Shuaiwen-Cui/ArduinoNode/README.md

# ArduinoNode
DIY an IoT wireless sensor node using Arduino Uno R4 wifi
