Shuaiwen-Cui/ArduinoNode/DOC/docs/HARDWARE/hardware.en.md

# HARDWARE

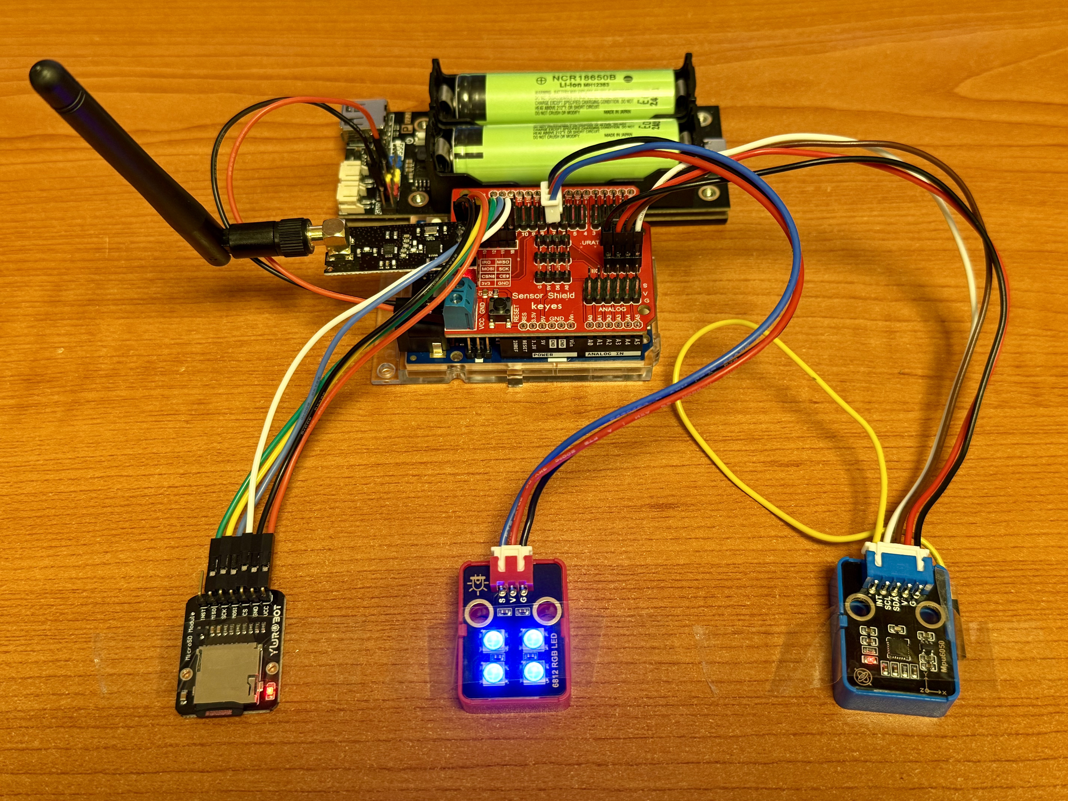
[picture p1: DOC/docs/HARDWARE/node.jpg]


!!! tip "Note"
    To fully implement the wireless sensor network functionality, you may need to purchase multiple sets of the following components to build a network of multiple nodes.

Item List:

| Component | Description | Purchase Link |
| --- | --- | --- |
| Arduino UNO R4 WiFi | Main controller for the node, providing processing power and connectivity. | [Link](https://detail.tmall.com/item.htm?id=738941670744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) |
| Sensor Shield | A shield that connects to the Arduino for easy sensor integration. | [Link](https://detail.tmall.com/item.htm?id=663358716903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) |
| MPU6050 | An acceleration sensor that measures motion and orientation. | [Link](https://detail.tmall.com/item.htm?id=668984438017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) |
| SD Module & Card | Used for data storage, allowing the node to log sensor data. | [Link](https://e.tb.cn/h.hLS57vJVErA9VzJ?tk=TVbk4TGT5v9) |
| RGB LED | Provides visual feedback, indicating the status of the node. | [Link](https://e.tb.cn/h.hLS1rt3BEDluwEL?tk=jOa94TGcqsR) |
| NRF24L01 Module & Antenna | Enables local wireless communication between nodes. |[Link](https://detail.tmall.com/item.htm?id=745189429142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) |
| BMS & Battery | Provides power to the entire node, making it portable. | [Link](https://e.tb.cn/h.7qz72UaRefNhfTZ?tk=zKuiU7YtwBU) / 18650 batteries and charger need to be purchased separately |
| Enclosure | Protects internal electronic components and provides a pretty appearance. | Needs to be designed and 3D printed by yourself |
| Dupont Wires | Used to connect various electronic components. | Please purchase them accordingly through online or offline channels. |

!!! note

    These components together form a fully functional IoT wireless sensor node capable of collecting data, storing information, and communicating wirelessly. Each component plays a crucial role in ensuring the efficient operation and reliability of the node.
!!! tip
    For the main controller Arduino UNO R4 WiFi, if the budget allows, you can choose to buy a kit that includes many expansion accessories to enrich the node's functionality. [Kit Link](https://item.taobao.com/item.htm?id=800925975219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)
