Shuaiwen-Cui/ArduinoNode/DOC/docs/HARDWARE/ENCLOSURE/enclosure.en.md

# ENCLOSURE

This project involves an enclosure that is designed to house various components. The enclosure is constructed from durable materials to ensure longevity and protection for the internal components.

## Enclosure Design

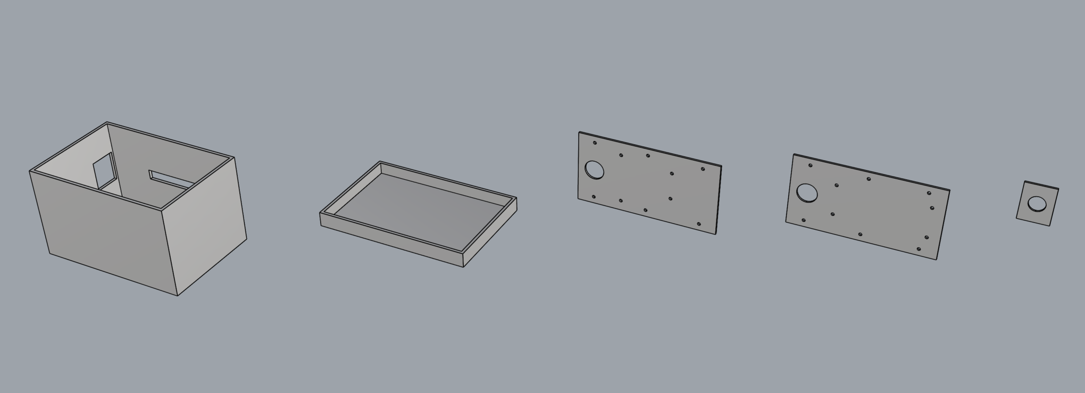
[picture p4: DOC/docs/HARDWARE/ENCLOSURE/enclosure.png]


## Enclosure Images

Top View

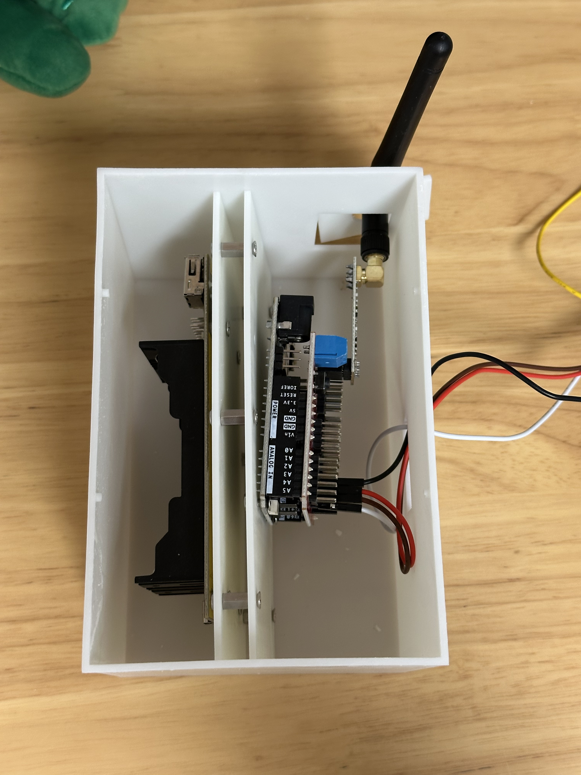
[picture p5: DOC/docs/HARDWARE/ENCLOSURE/topview.jpg]

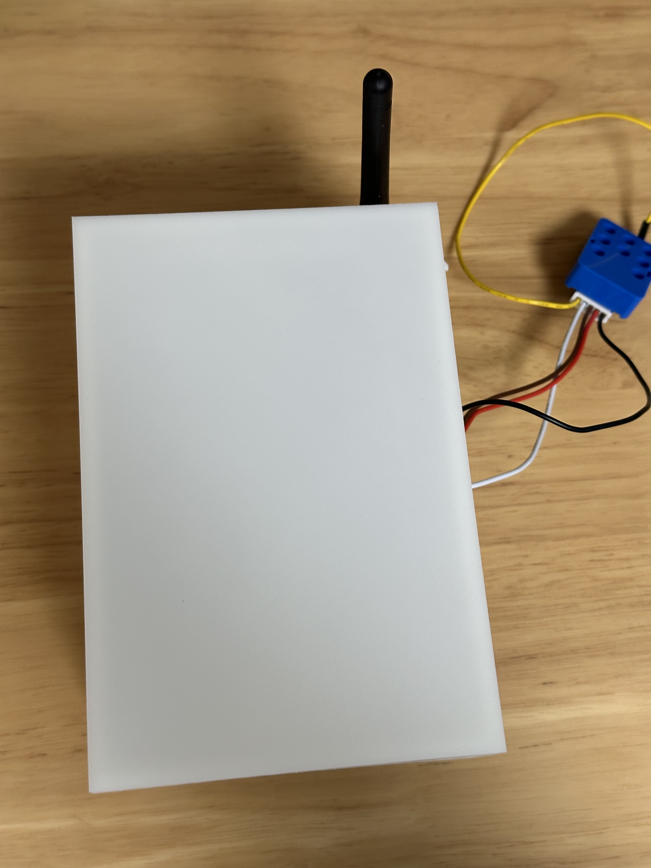
[picture p6: DOC/docs/HARDWARE/ENCLOSURE/ladview.jpg]


Front View
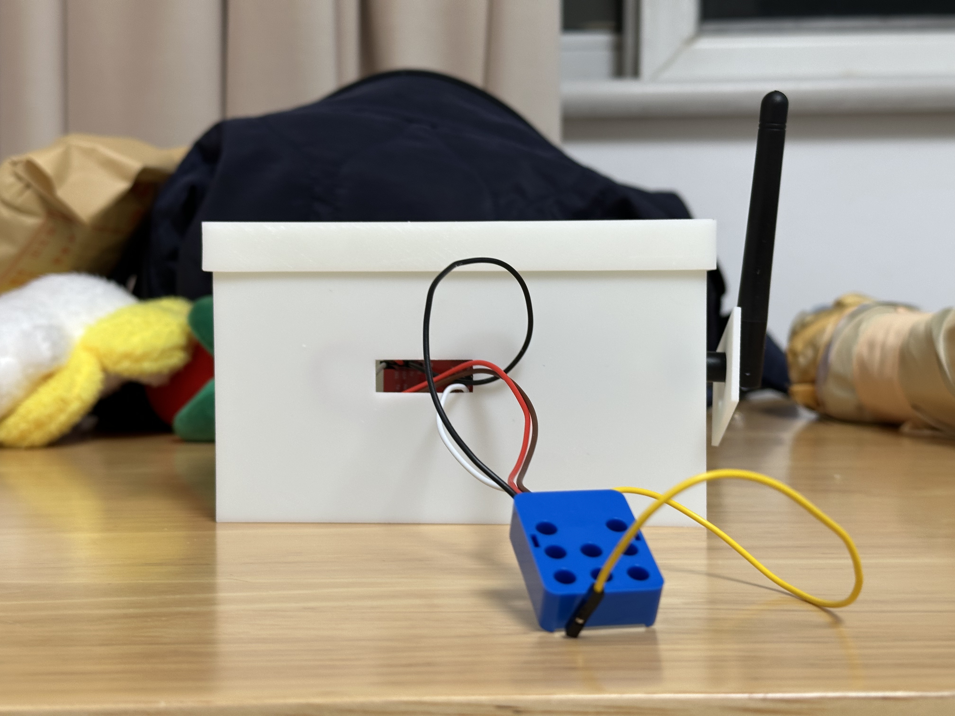
[picture p7: DOC/docs/HARDWARE/ENCLOSURE/frontviewnew.jpg]


Side View
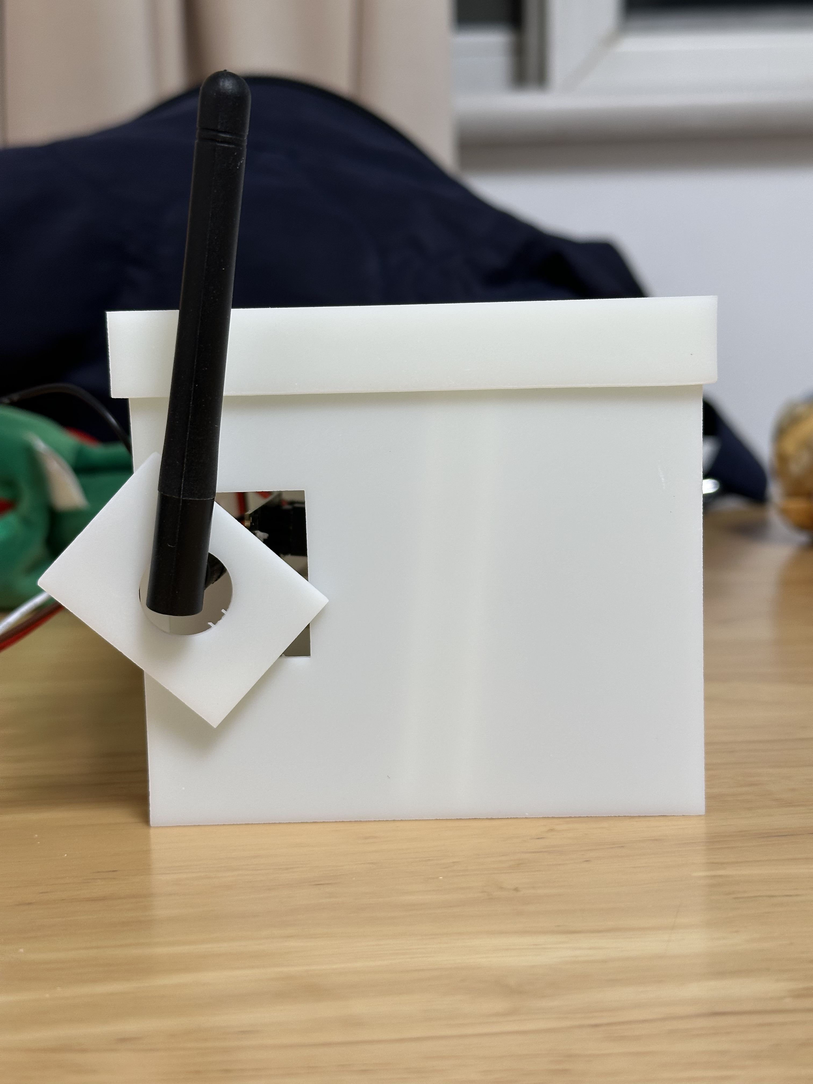
[picture p8: DOC/docs/HARDWARE/ENCLOSURE/sideview-new.jpg]
