Shuaiwen-Cui/ArduinoNode/DOC/docs/HARDWARE/ENCLOSURE/enclosure.zh.md

# 外壳

本项目中设计了一个外壳，用来保护内部的电子元件，并提供一个美观的外观。外壳的设计考虑了散热、易于组装和维护等因素。

## 外壳设计



## 外壳实物图

顶部视图




前视图



侧视图
