Shuaiwen-Cui/ArduinoNode/DOC/docs/HARDWARE/RADIOFREQUENCY/radiofrequency.zh.md

# 射频

RF

射频模块nRF24L01是一个低功耗、低成本的2.4GHz无线收发器，适用于短距离无线通信。它支持多种数据速率和多通道操作，具有较强的抗干扰能力和较长的传输距离。与Wifi相比，射频具有低延迟、低功耗等特点，更适合需要实时数据传输的应用场景。

## 参数

nRF24L01 技术参数

| 参数 | 说明 |
|---|---|
| 工作频率 | 2.4 GHz ISM频段 |
| 通信速率 | 250 kbps / 1 Mbps / 2 Mbps |
| 工作电压 | 1.9V – 3.6V（推荐 3.3V） |
| 通信距离 | 约 10～100 米（取决于天线和环境） |
| 接口协议 | SPI |
| 接收电流 | 约 12.3 mA |
| 发送电流 | 约 11.3 mA（0 dBm输出） |
| 数据包长度 | 1～32 字节 |
| 地址宽度 | 3～5 字节 |
| 特性支持 | 自动应答、自动重发、多通道接收 |

## 接线



| 引脚 | 名称 | 说明 |
|---|---|---|
| 1 | GND  | 地线 |
| 2 | VCC  | 电源（推荐 3.3V，严禁接 5V） |
| 3 | CE | 模式控制引脚（发送/接收切换） |
| 4 | CSN  | SPI片选引脚（低电平有效） |
| 5 | SCK  | SPI时钟输入 |
| 6 | MOSI | SPI主设备输出，从设备输入 |
| 7 | MISO | SPI主设备输入，从设备输出 |
| 8 | IRQ  | 中断引脚（可选） |
