Shuaiwen-Cui/ArduinoNode/DOC/docs/HARDWARE/MCU/mcu.en.md

# MAIN CONTROLLER BOARD

!!! info "Main Controller Board"
    In this project， the main controller board serves two purposes: central control and Wi-Fi communication.

## Main Controller Board Appearance

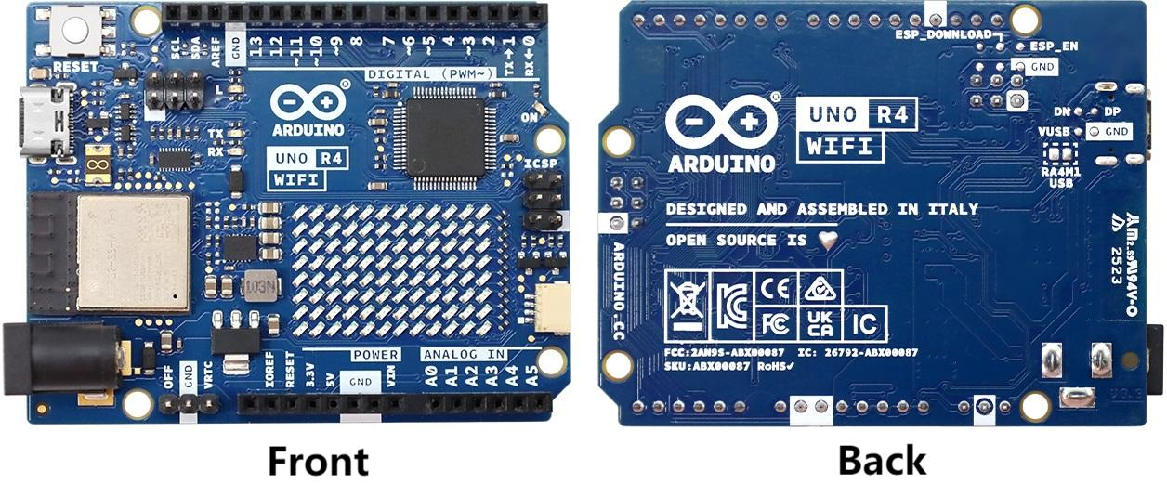
[picture p14: DOC/docs/HARDWARE/MCU/mcu.png]


## Main Controller Board Pin Layout

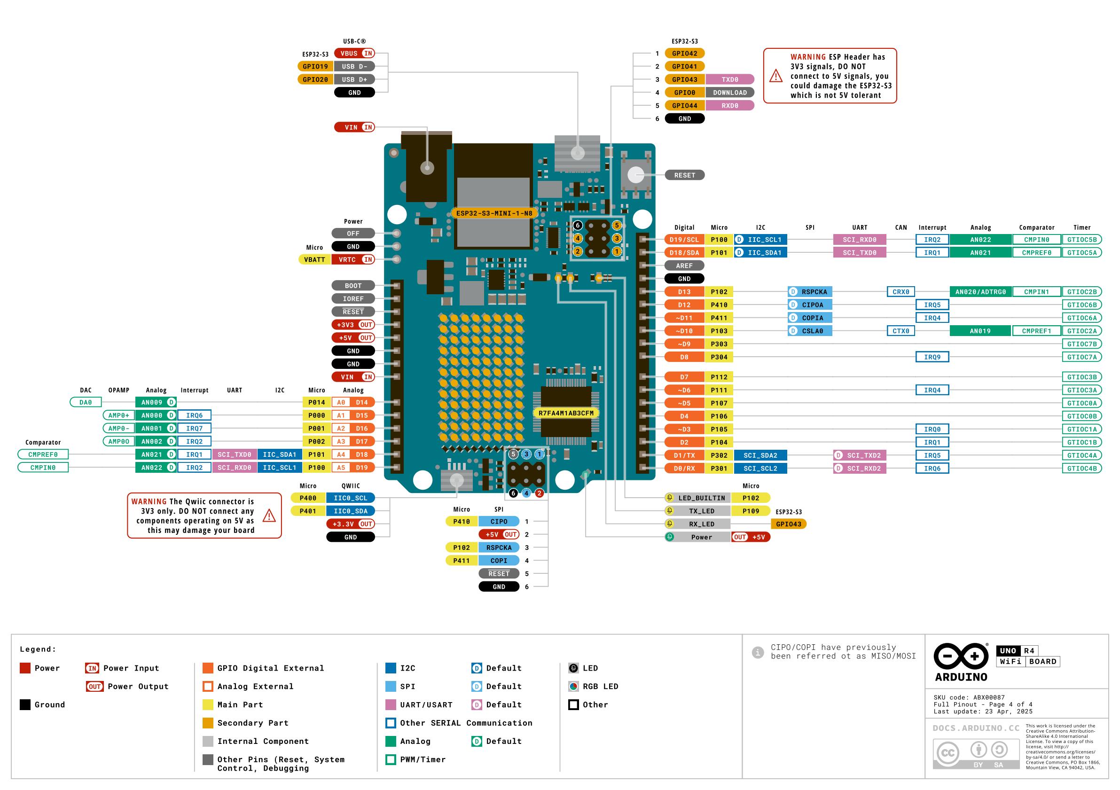
[picture p15: DOC/docs/HARDWARE/MCU/ABX00087-full-pinout.jpg]


## Reference Links

<div class="grid cards" markdown>

-   :simple-arduino:{ .lg .middle } __ARDUINO UNO R4 WIFI__

    ---

    [:octicons-arrow-right-24: <a href="https://docs.arduino.cc/hardware/uno-r4-wifi/#features" target="_blank"> LINK </a>](#)

</div>
