Shuaiwen-Cui/ArduinoNode/DOC/docs/HARDWARE/SHIELD/shield.en.md

# SENSOR SHIELD

!!! info "Sensor Shield"
    The Sensor Shield is an expansion board designed for connecting various sensors, providing a rich set of interfaces and functionalities to facilitate sensor data acquisition and processing.

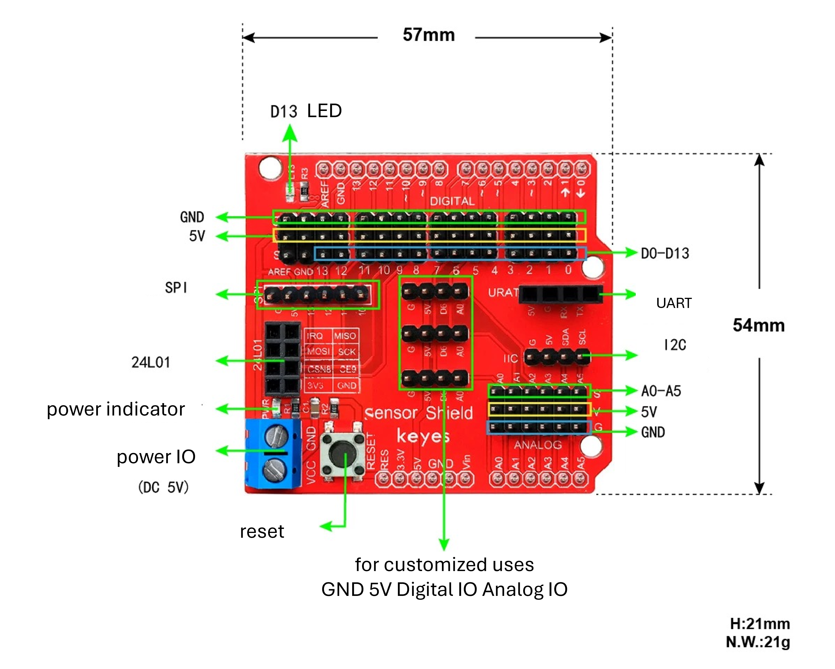
[picture p18: DOC/docs/MANUAL/ASSEMBLY/shield-en.png]
