Shuaiwen-Cui/ArduinoNode/DOC/docs/HARDWARE/TOUCH-SENSOR/touchsensor.en.md

# TOUCH SENSOR

!!! info "Touch Sensor"
    A touch sensor is a device that detects the presence of a touch or contact with an object. It is commonly used in various electronic devices to enable user interaction.

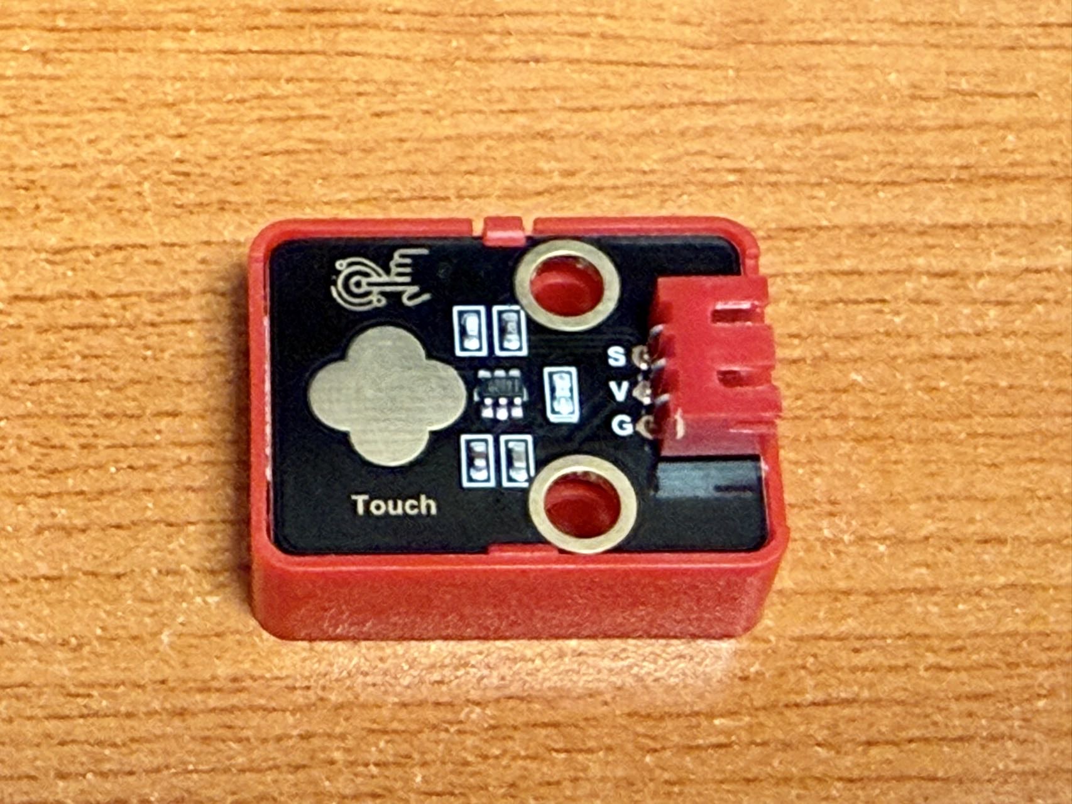
[picture p19: DOC/docs/HARDWARE/TOUCH-SENSOR/touchsensor.jpg]


## Wiring



| Arduino Pin | 6812 RGB LED Pin |
|---|---|
| V | V |
| G | G |
| S （D3） | S |
