Shuaiwen-Cui/ArduinoNode/DOC/docs/index.zh.md

# ArduinoNode

这个项目展示如何使用Arduino Uno R4 WiFi构建一个简单的物联网无线传感器节点/网络。

!!! tip "友情提示"
    本项目代码还远称不上完美，其重点是从原理上展示一些IoT无线传感器网络的关键概念和实现方式。代码中可能存在一些不够优雅的地方，欢迎大家提出改进意见。

封面
