Shuaiwen-Cui/ArduinoNode/DOC/docs/SOFTWARE/software.zh.md

# 软件

通过编程，我们可以基于硬件功能实现各种应用，在引入各硬件库的条件下，我们可以较为简单地将常用功能封装为函数，供主程序调用。这些功能可以被分为几个组：传感、通讯、存储、时间控制、交互等。

示例代码可以在[GitHub仓库](https://github.com/Shuaiwen-Cui/ArduinoNode.git)的`CODE`文件夹/压缩包中找到，可以下载该仓库或`git clone`到本地机器。

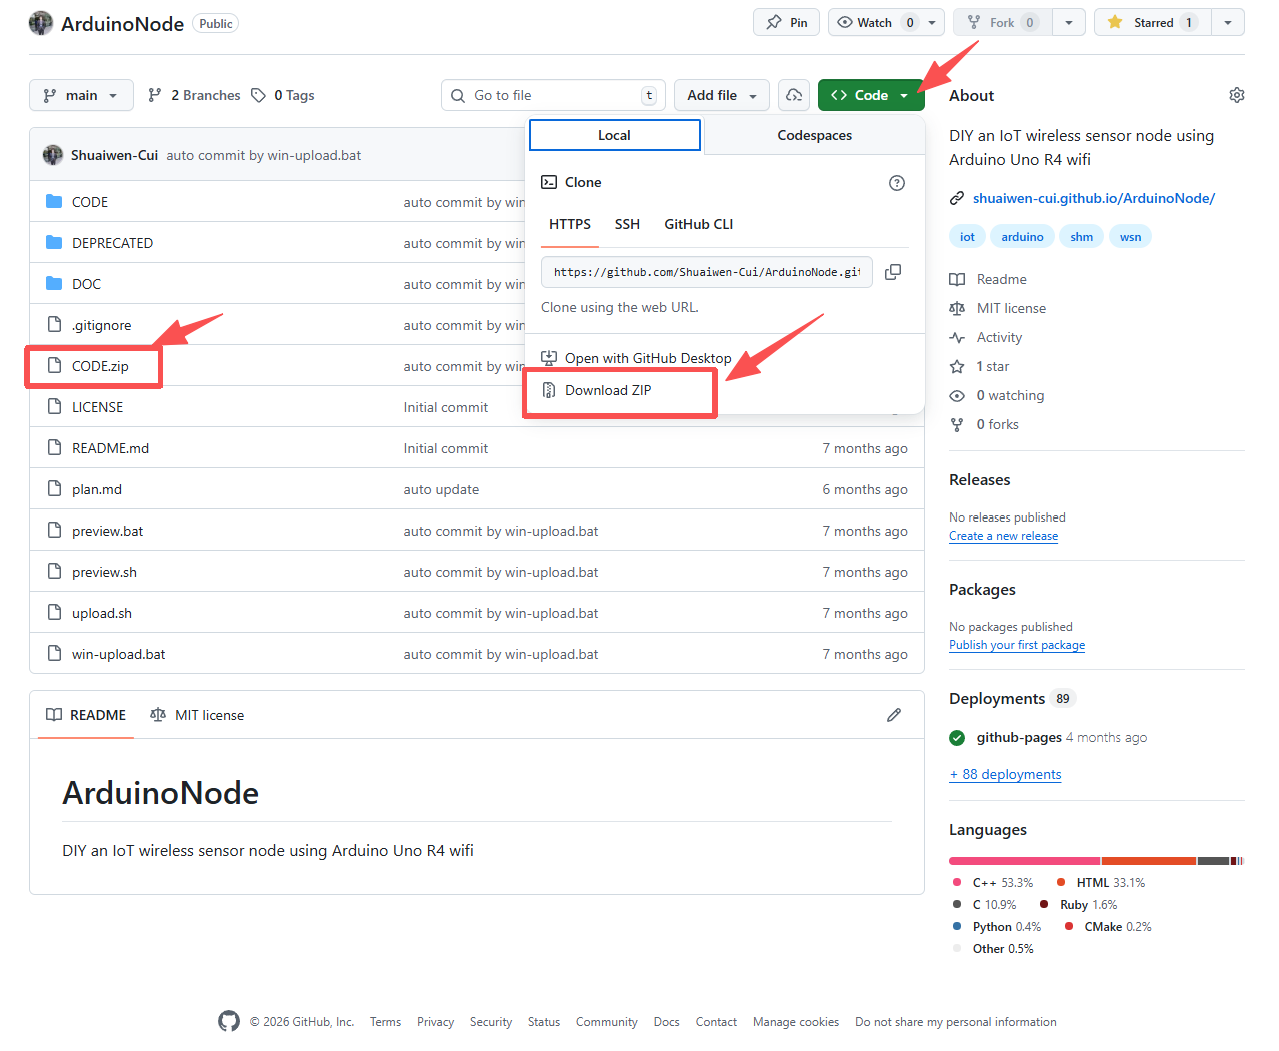
[picture p20: DOC/docs/SOFTWARE/code.png]
