Shuaiwen-Cui/ArduinoNode/DOC/docs/DEMO/demo.en.md

# DEMO

<iframe width="800" height="450" src="https://www.youtube-nocookie.com/embed/JNWx4KjE4FM" frameborder="0" allowfullscreen></iframe>
