Shuaiwen-Cui/ArduinoNode/DOC/docs/SOFTWARE/SENSING-STORAGE/sensing.en.md

# ACCELERATION SENSING

Sampling can be said to be one of the most important functions of this project. It allows us to collect and store data from sensors for subsequent analysis and processing. Since Arduino performance is very limited, this project uses a method of sampling and storing at the same time to achieve data collection. Since there is no real-time operating system, the storage process will have a certain impact on sampling, so a high sampling frequency cannot be achieved, but due to the demonstration and teaching nature of this project, the sampling frequency does not need to be very high. After testing, a sampling frequency of 200Hz can be fully achieved, and since it is sampling and storing at the same time, the data limit is basically equivalent to the capacity of the SD card.

**sensing.hpp**

```cpp
#pragma once

#include <stdint.h>

#define SENSING_PREPARING_DUR_MS 5000  // Duration for preparing sensing in milliseconds

typedef struct {
    uint16_t elapsed_ms;  // Elapsed time since sensing started (ms)
    int16_t ax;
    int16_t ay;
    int16_t az;
} SamplePoint;

bool sensing_prepare();                     // Called once at the beginning of PREPARING state
void sensing_sample_once();                 // Called repeatedly during SAMPLING state
void sensing_stop();                        // Called once at the end of SAMPLING state

void sensing_retrieve_file();               // Retrieve file from SD card

```

**sensing.cpp**

```cpp
#include <Arduino.h>
#include "config.hpp"
#include "nodestate.hpp"
#include "time.hpp"
#include "rgbled.hpp"
#include "mpu6050.hpp"
#include "sensing.hpp"
#include "mqtt.hpp"
#include "sdcard.hpp"
#include "logging.hpp"
#include "wifi.hpp"

static File data_file;
static uint32_t last_sample_time = 0;
static uint32_t t_start_ms = 0;
static uint32_t sample_count = 0;
static char filename[32];
static char printbuffer[64];

bool sensing_prepare()
{
    sample_count = 0;
    t_start_ms = sensing_scheduled_start_ms;
    last_sample_time = t_start_ms;

    load_log_number(); // Load current log number from persistent storage
    snprintf(filename, sizeof(filename), "N%03d_%03d.txt", NODE_ID, log_number + 1);

    Serial.print("[SD] Opening file for streaming: ");
    Serial.println(filename);

    data_file = SD.open(filename, FILE_WRITE);
    if (!data_file)
    {
        Serial.println("[SD] Failed to open file.");
        return false;
    }

    data_file.println("=============== Sampling Metadata ===============");
#ifdef NODE_ID
    data_file.print("Node ID: ");
    data_file.println(NODE_ID);
#endif

    // === Convert scheduled start time ===
    CalendarTime cal = calendar_from_unix_milliseconds(sensing_scheduled_start_ms);
    snprintf(printbuffer, sizeof(printbuffer), "%04d-%02d-%02d %02d:%02d:%02d.%03d",
             cal.year, cal.month, cal.day, cal.hour, cal.minute, cal.second, cal.ms);

    data_file.print("Start Time: ");
    data_file.println(printbuffer);

    data_file.print("Sampling Rate: ");
    data_file.print(sensing_rate_hz);
    data_file.println(" Hz");

    data_file.print("Duration: ");
    data_file.print(sensing_duration_s);
    data_file.println(" s");

    data_file.println("================= Sampling Data =================");
    data_file.println("time_ms  , ax      , ay      , az");

    Serial.println("[SENSING] Sensing started (streaming mode).");
    return true;
}

void sensing_sample_once()
{
    uint32_t now_ms = Time.get_time();
    if (now_ms - last_sample_time >= (1000 / sensing_rate_hz))
    {
        last_sample_time += (1000 / sensing_rate_hz);

        int16_t ax, ay, az;
        imu_get_acceleration(ax, ay, az);

        uint32_t elapsed = now_ms - t_start_ms;

        float ax_g = ax * cali_scale_x / 16384.0f;
        float ay_g = ay * cali_scale_y / 16384.0f;
        float az_g = az * cali_scale_z / 16384.0f;

        char line[64];

        snprintf(line, sizeof(line), "%8lu,%8.6f,%8.6f,%8.6f", elapsed, ax_g, ay_g, az_g);
        data_file.println(line);

        sample_count++;
    }
}

void sensing_stop()
{
    Serial.print("[SENSING] Sampling completed. ");
    Serial.print(sample_count);
    Serial.println(" samples collected.");

    if (data_file)
    {
        data_file.close();
        Serial.print("[SD] File saved: ");
        Serial.println(filename);

        log_number++;
        save_log_number();
    }

#ifdef DATA_PRINTOUT
    // Reopen and print file content
    File f = SD.open(filename, FILE_READ);
    if (f)
    {
        Serial.println("[SD] Dumping file content:");
        while (f.available())
        {
            Serial.write(f.read());
        }
        f.close();
    }
    else
    {
        Serial.println("[SD] Failed to reopen file for reading.");
    }
#endif

#ifdef GATEWAY // this part will make the led switch on the gateway node slightly slower than the leafnodes, don't worry about it
    // Check WiFi connection, reconnect if disconnected
    if (WiFi.status() != WL_CONNECTED)
    {
        Serial.println("[MQTT] WiFi disconnected. Reconnecting...");
        connect_to_wifi(); // Reconnect to WiFi
    }

    mqtt_loop(); // Keep MQTT connection alive
    // Publish the file name to MQTT broker
    String msg = "Sensing completed!";
    mqtt_client.publish(MQTT_TOPIC_PUB, msg.c_str());
#endif

    sample_count = 0;
}

void sensing_retrieve_file()
{
    File file = SD.open(retrieval_filename, FILE_READ);
    if (!file)
    {
        Serial.print("[Error] File not found: ");
        Serial.println(retrieval_filename);
        return;
    }

    Serial.print("[Retrieval] Reading file: ");
    Serial.println(retrieval_filename);

    size_t total_size = file.size();
    size_t bytes_sent = 0;
    size_t chunk_size = 850;
    size_t chunk_index = 1;
    size_t chunk_total = (total_size + chunk_size - 1) / chunk_size;

    char prefix[32];
    snprintf(prefix, sizeof(prefix), "%s", retrieval_filename + 1); // Remove leading '/'
    char topic[64];

    while (file.available())
    {
        char buffer[851]; // chunk_size + 1 for null terminator
        size_t len = file.readBytes(buffer, chunk_size);
        buffer[len] = '\0';

        snprintf(topic, sizeof(topic), "%s[%d/%d]:", prefix, chunk_index, chunk_total);
        String payload = String(topic) + String(buffer);

        bool ok = mqtt_client.publish(MQTT_TOPIC_PUB, payload.c_str());
        if (ok)
        {
            bytes_sent += len;
            Serial.print("[MQTT] Sent chunk ");
            Serial.print(chunk_index);
            Serial.print(" / ");
            Serial.print(chunk_total);
            Serial.print(" (");
            Serial.print(bytes_sent);
            Serial.print(" / ");
            Serial.print(total_size);
            Serial.println(" bytes)");
        }
        else
        {
            Serial.print("[Error] Failed to send chunk ");
            Serial.println(chunk_index);
        }

        chunk_index++;

        mqtt_loop(); // keep MQTT alive
        delay(50);   // throttle
    }

    file.close();

    String done_msg = String(prefix) + "[done]";
    mqtt_client.publish(MQTT_TOPIC_PUB, done_msg.c_str());
    Serial.println("[MQTT] File upload completed.");

    node_status.node_flags.data_retrieval_requested = false;
    node_status.node_flags.data_retrieval_sent = true;
}

```

As shown in the code above, the sampling process is divided into several stages:

1. Sampling start time and end time: This part is completed when the MQTT command callback is called.

2. calling `sensing_prepare()`: called at the preparation state, opens the SD card file and writes the sampling metadata. In this function, a `load_log_number()` function is called to load the current log number and use it in the file name. The file name format is `N001_001.txt`, where `N001` is the node ID and `001` is the log number. There is a file in the SD card that records the current log number, which will automatically increase after the sampling is completed.

3. calling `sensing_sample_once()`: called repeatedly in the sampling state, reads the sensor data and writes it to the SD card file. Each sampling will check whether the set sampling rate (`sensing_rate_hz`) is reached. If it is reached, the sensor data is read and written to the file. In the main program loop, when the current time minus the last sampling time is greater than or equal to `1000 / sensing_rate_hz`, a sampling is performed. The sampling data includes the timestamp and the three axial data of the accelerometer (ax, ay, az), and is written to the SD card file.

4. calling `sensing_stop()`: Called at the end of the sampling state, closes the SD card file and prints the sampling results. This function prints the total number of samples and reopens the file content for printing to the serial port.

!!! info
    In this project, since the serial port output speed is very slow, it will drag down the sampling and storage, so during the sampling process, we only do storage without serial port output. After the sampling is completed, the file can be reopened and the content can be printed to the serial port.
