Shuaiwen-Cui/ArduinoNode/DOC/docs/SOFTWARE/TIME-MANAGEMENT/timesync.en.md

# TIME SYNCHRONIZATION

Time synchronization is critical for wireless network devices. It ensures time consistency between devices so that timestamps, logging, and other time-related functions of data packets can work correctly. In this project, time synchronization is divided into two parts: the first part is time synchronization with the Internet, and the second part is time synchronization between devices.

The related codes are shown below:

**time.hpp**

```cpp
#pragma once
#include <Arduino.h>
#include "config.hpp"
#include "nodestate.hpp"

#define SYNC_ROUNDS 7
#define SYNC_INTERVAL_1 20000
#define SYNC_INTERVAL_N 2000
#define TIME_SYNC_RESERVED_TIME 60000 // means reserve at least 60 seconds for time sync when issuing a sensing command

/*
 * Time synchronization header
 * 
 * Provides:
 * - NTP synchronization function
 * - RF time synchronization function by drift ratio and offset
 */

bool sync_time_ntp();
bool rf_time_sync();
```

**time.cpp**

```cpp
#include <WiFiUdp.h>
#include <NTPClient.h>
#include "time.hpp"
#include "timesync.hpp"
#include "rf.hpp"

WiFiUDP ntpUDP;
NTPClient timeClient(ntpUDP, "asia.pool.ntp.org", 28800, 60000);

bool sync_time_ntp()
{
    timeClient.begin();
    const uint64_t MIN_VALID_EPOCH = 1735689600; // 2025-01-01 00:00:00 UTC
    bool success = false;

    for (int attempt = 1; attempt <= 5; ++attempt)
    {
        if (!timeClient.update())
        {
            Serial.print("[COMMUNICATION] <NTP> Attempt ");
            Serial.print(attempt);
            Serial.println(": Failed to get NTP time.");
            delay(1000);
            continue;
        }

        uint64_t epoch = timeClient.getEpochTime();
        if (epoch < MIN_VALID_EPOCH)
        {
            Serial.print("[COMMUNICATION] <NTP> Attempt ");
            Serial.print(attempt);
            Serial.print(": Invalid epoch = ");
            Serial.println(epoch);
            delay(1000);
            continue;
        }

        // === Valid time received ===
        uint64_t now_millis = millis();
        uint64_t epoch_ms = epoch * 1000ULL + now_millis % 1000ULL;

        Time.last_sync_running_time = now_millis;
        Time.time_offset = epoch_ms - now_millis;

        Serial.print("[COMMUNICATION] <NTP> Synchronized UNIX epoch: ");
        Serial.println(epoch);

        Serial.println("[COMMUNICATION] <NTP> Local time (Calendar): ");
        Time.show_time(); // Print calendar and unified time

        success = true;
        break;
    }

    if (!success)
    {
        Serial.println("[COMMUNICATION] <NTP> Final NTP sync failed after 5 attempts.");
    }

    return success;
}

bool rf_time_sync()
{
#ifdef GATEWAY
    Serial.println("[SYNC] Start time synchronization as GATEWAY");

    for (uint8_t round = 0; round < SYNC_ROUNDS; ++round)
    {   
        for (uint8_t node_id = 1; node_id <= NUM_NODES; ++node_id)
        {
            if (node_id == NODE_ID)
                continue;

            RFMessage msg;
            msg.from_id = NODE_ID;
            msg.to_id = node_id;

            uint64_t current_time = Time.get_time();

            uint32_t high = current_time >> 32;
            uint32_t low = current_time & 0xFFFFFFFF;
            snprintf(msg.payload, sizeof(msg.payload), "SYNC %lu %lu", high, low);
            msg.timestamp_ms = current_time;

            rf_stop_listening();
            rf_send(node_id, msg, false);
            rf_start_listening();

            Serial.print("[SYNC][GATEWAY] Round ");
            Serial.print(round + 1);
            Serial.print(" → Node ");
            Serial.print(node_id);
            Serial.print(" | Time = ");
            Serial.println(current_time);
        }

        if (round == 0)
            delay(SYNC_INTERVAL_1);
        else if (round < SYNC_ROUNDS - 1)
            delay(SYNC_INTERVAL_N);
    }

    Serial.println("[SYNC] GATEWAY time synchronization complete.");
    return true;
#endif

#ifdef LEAFNODE
    Serial.println("[SYNC] Start time synchronization as LEAFNODE");

    // === Step 1: Initialize arrays for each round ===
    uint64_t gateway_time[SYNC_ROUNDS] = {0};
    uint64_t local_time[SYNC_ROUNDS] = {0};
    int64_t time_diff[SYNC_ROUNDS] = {0};
    uint8_t received = 0;

    // === Step 2: Receive SYNC messages ===
    while (received < SYNC_ROUNDS)
    {
        RFMessage msg;
        if (rf_receive(msg, 100))
        {
            if (strncmp(msg.payload, "SYNC", 4) == 0 && msg.to_id == NODE_ID)
            {
                uint32_t high = 0, low = 0;
                sscanf(msg.payload, "SYNC %lu %lu", &high, &low);
                uint64_t gw_time = ((uint64_t)high << 32) | low;
                uint64_t local = millis();

                gateway_time[received] = gw_time;
                local_time[received] = local;
                time_diff[received] = static_cast<int64_t>(gw_time - local);

                // === Output the results for each round (except for the final round) ===
                if (received < SYNC_ROUNDS - 1)
                {
                    Serial.print("[SYNC][LEAF] Round ");
                    Serial.print(received + 1);
                    Serial.print(" → Gateway Time: ");
                    Serial.print(gw_time);
                    Serial.print(" ms, Local Time: ");
                    Serial.print(local);
                    Serial.print(" ms, Time Diff: ");
                    Serial.println(time_diff[received]);
                }

                received++;
            }
        }
    }

    // === Step 3: Calculate drift_ratio ===
    double drift_sum = 0.0;
    double drift_max = -1e9;
    double drift_min = 1e9;
    uint8_t drift_count = 0;

    for (uint8_t i = 1; i < SYNC_ROUNDS; ++i)
    {
        int64_t delta_t = static_cast<int64_t>(local_time[i] - local_time[0]);
        int64_t delta_T = static_cast<int64_t>(gateway_time[i] - gateway_time[0]);

        if (delta_t <= 0) continue;  // prevent division by zero or negative time

        // Calculate drift_ratio directly within the loop
        double drift_i = (static_cast<double>(delta_T - delta_t)) / delta_t;
        drift_sum += drift_i;
        drift_count++;

        if (drift_i > drift_max) drift_max = drift_i;
        if (drift_i < drift_min) drift_min = drift_i;

        // Debug prints for drift calculation
        Serial.print("[SYNC][LEAF] Drift ");
        Serial.print(i);
        Serial.print(" = ");
        Serial.println(drift_i, 8);  // Show drift value to 8 decimal places
    }

    double drift_cleaned_sum = drift_sum - drift_max - drift_min;
    double drift_avg = drift_cleaned_sum / (drift_count - 2);

    // === Step 4: Calculate offset using average of time_diff after removing max and min ===
    int64_t max_diff = time_diff[0];
    int64_t min_diff = time_diff[0];
    int64_t offset_sum = 0;

    for (uint8_t i = 0; i < SYNC_ROUNDS; ++i)
    {
        if (time_diff[i] > max_diff) max_diff = time_diff[i];
        if (time_diff[i] < min_diff) min_diff = time_diff[i];
        offset_sum += time_diff[i];
    }

    // Calculate offset average after removing max and min values
    int64_t offset_cleaned_sum = offset_sum - max_diff - min_diff;
    int64_t offset_avg = offset_cleaned_sum / (SYNC_ROUNDS - 2);

    // === Step 5: Update drift_ratio and time_offset ===
    Time.drift_ratio = 1.0 + drift_avg;
    Time.time_offset = offset_avg;  // Directly use offset_avg for time_offset

    // === Step 6: Record sync time and summary ===
    Time.record_sync_time();  // Record synchronization time after updating offset

    // === Output the final round result ===
    Serial.print("[SYNC][LEAF] Final Round ");
    Serial.print(SYNC_ROUNDS);
    Serial.print(" → Gateway Time: ");
    Serial.print(gateway_time[SYNC_ROUNDS - 1]);
    Serial.print(" ms, Local Time: ");
    Serial.print(local_time[SYNC_ROUNDS - 1]);
    Serial.print(" ms, Time Diff: ");
    Serial.println(time_diff[SYNC_ROUNDS - 1]);

    // Debug prints for final result
    Serial.println("=== Time Sync Result ===");
    Serial.print("Drift Ratio       : ");
    Serial.println(Time.drift_ratio, 8);  // Show drift ratio to 8 decimal places
    Serial.print("Time Offset       : ");
    Serial.println(Time.time_offset);

    Serial.print("Last Sync @       : ");
    Serial.println(Time.last_sync_running_time);
    Serial.println("========================");

    return true;
#endif

}

```
In this project, time synchronization is divided into two categories:  
1. Synchronization with the internet (via NTP)  
2. Synchronization between local devices (via RF communication and RTT)

## 1. Internet Time Synchronization – Network Time Protocol (NTP)

NTP (Network Time Protocol) is used to synchronize local device time with an accurate time source on the internet. The basic principle is:

- The local device sends a request and records the send time `t1`
- The NTP server receives the request and records the server time `t2`
- The server sends back the current time `t3`
- The local device receives the response and records receive time `t4`

Using these timestamps, the local device can estimate the network delay and adjust its own time based on the server's response.

The related function in this project is:

### `sync_time_ntp()`

This function uses the `NTPClient` library to retrieve the current Unix timestamp from the internet. Its core logic includes:

- Initialize and connect to the NTP server
- Retrieve the current UTC time (Unix timestamp)
- Update the global `Time` variable with the retrieved value
- Record the current runtime (e.g., from `millis()`) to enable millisecond-level tracking

This function is called at device startup or when re-synchronization is needed. While it is convenient, it depends on internet access and the precision is limited to seconds on platforms like Arduino.

---

## 2. Local Device Time Synchronization – FTSP (Flooding Time Synchronization Protocol)

This project implements a flooding-based time synchronization protocol (FTSP), where the gateway node periodically broadcasts its current time to all leaf nodes. Each leaf node receives the messages and calculates timing offset and clock drift to align its local time accordingly.

The core steps of FTSP are as follows:

1. **Gateway node broadcasts time information**:  
   In each synchronization round, the gateway sends a 64-bit timestamp representing its current time to all leaf nodes.

2. **Leaf node receives the time message**:  
   Upon reception, the leaf node continues the following steps.

3. **Record local receive time**:  
   The leaf node records the timestamp of message arrival using its local `millis()` clock.

4. **Compute time offset**:  
   The time difference between the gateway's timestamp and the local receive time is calculated as a candidate offset.

5. **Estimate clock drift**:  
   Across multiple synchronization rounds, the leaf node estimates the drift ratio between the gateway and its own clock. This drift ratio reflects the rate difference between the two clocks.

6. **Update local time model**:  
   Based on the calculated drift ratio and time offset, the node adjusts its internal time model to maintain synchronization.

7. **Record last sync time**:  
   The last synchronization timestamp is stored to support accurate continuous time estimation.

---

## Summary

To balance precision and practicality, the system is designed to first initialize the time using NTP and then maintain accurate synchronization between devices using RF-based FTSP.

!!! tip "Note"
    In practical deployments, NTP is typically used for initial time setup during device boot-up.  
    RF-based synchronization ensures continued time consistency between nodes even in offline or unstable network conditions, achieving higher accuracy and robustness.

## Serial Printout Example

Below is a typical startup process serial output example for the gateway node, showing key steps for time synchronization:

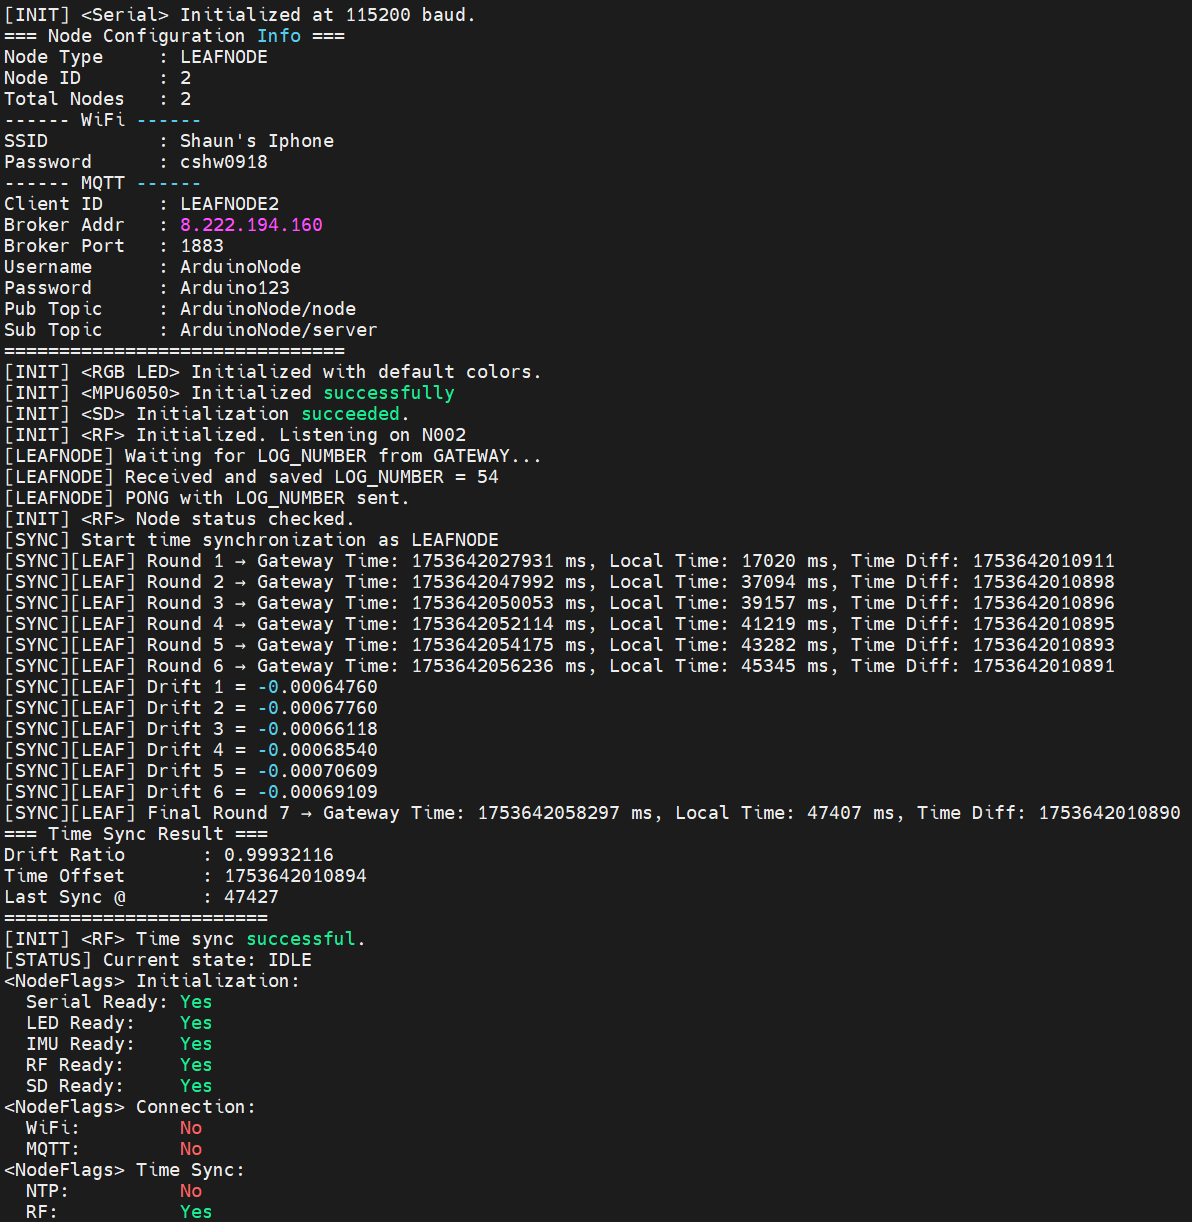
[picture p24: DOC/docs/SOFTWARE/TIME-MANAGEMENT/printout.png]
