Shuaiwen-Cui/ArduinoNode/DOC/docs/SOFTWARE/SENSING-STORAGE/storage.en.md

# STORAGE

This project uses an SD card for data storage, and due to the limitations of Arduino memory, sampling and storage are performed simultaneously. Details can be found in the explanation of the sensing section.
