Shuaiwen-Cui/ArduinoNode/DOC/docs/SOFTWARE/IDE/ide.en.md

# INTEGRATED DEVELOPMENT ENVIRONMENT (IDE)

!!! note "Arduino Development Environment"
    Arduino development can be done in various ways, with the most common being the Arduino IDE. The Arduino IDE is an open-source integrated development environment specifically designed for Arduino hardware. It provides a simple and user-friendly interface that allows users to write, compile, and upload code to Arduino boards. In recent years, PlatformIO has also become a popular choice; it is a cross-platform IDE that supports multiple development boards and frameworks. PlatformIO offers more powerful features such as library management, debugging support, and various compiler options. PlatformIO is actually a plugin for VSCode, which is a powerful code editor that supports multiple programming languages and extensions. The VSCode plugin ecosystem is very rich, allowing users to enhance its functionality by installing different plugins. Given this, this project uses VSCode + PlatformIO as the primary development environment.

## VSCode Installation

<div class="grid cards" markdown>

-   :material-microsoft-visual-studio-code:{ .lg .middle } __VSCode__

    ---

    [:octicons-arrow-right-24: <a href="https://code.visualstudio.com/download" target="_blank"> Download Link </a>](#)

</div>

## PlatformIO Installation

<div class="grid cards" markdown>

-   :simple-platformio:{ .lg .middle } __PlatformIO Installation__

    ---

    [:octicons-arrow-right-24: <a href="https://platformio.org/install/ide?install=vscode" target="_blank"> Installation Guidance </a>](#)

</div>

## Developing Arduino Projects with VSCode + PlatformIO

<div class="grid cards" markdown>

-   :material-book:{ .lg .middle } __Creating Arduino Projects with PlatformIO__

    ---

    [:octicons-arrow-right-24: <a href="https://www.digikey.tw/zh/maker/tutorials/2022/get-started-with-platformio-for-your-next-arduino-project" target="_blank"> Documentation Tutorial </a>](#)

    [:octicons-arrow-right-24: <a href="https://www.youtube.com/watch?v=nlE2203Q3XI" target="_blank"> Video Tutorial </a>](#)

</div>
