Shuaiwen-Cui/ArduinoNode/DOC/docs/SOFTWARE/IDE/ide.zh.md

# 集成开发环境

!!! note "Arduino 开发环境"
    Arduino的开发有多种方式，最常见的方式是使用Arduino IDE。Arduino IDE是一个开源的集成开发环境，专为Arduino硬件设计。它提供了一个简单易用的界面，允许用户编写、编译和上传代码到Arduino板上。近年来PlatformIO也成为了一个流行的选择，它是一个跨平台的IDE，支持多种开发板和框架。PlatformIO提供了更强大的功能，如库管理、调试支持和多种编译器选项。PlatfromIO实际上是VSCode中的一个插件，VSCode是一个功能强大的代码编辑器，支持多种编程语言和扩展。VSCode的插件生态系统非常丰富，可以通过安装不同的插件来增强其功能。鉴于此，本项目采用VSCode+PlatformIO作为主要的开发环境。

## VSCode安装

<div class="grid cards" markdown>

-   :material-microsoft-visual-studio-code:{ .lg .middle } __VSCode__

    ---

    [:octicons-arrow-right-24: <a href="https://code.visualstudio.com/download" target="_blank"> 下载链接 </a>](#)

</div>

## PlatformIO安装

<div class="grid cards" markdown>

-   :simple-platformio:{ .lg .middle } __PlatformIO 安装说明__

    ---

    [:octicons-arrow-right-24: <a href="https://platformio.org/install/ide?install=vscode" target="_blank"> 下载链接 </a>](#)

</div>

## 使用VSCode+PlatformIO开发Arduino项目

<div class="grid cards" markdown>

-   :material-book:{ .lg .middle } __PlatformIO 创建 Arduino 项目__

    ---

    [:octicons-arrow-right-24: <a href="https://www.digikey.tw/zh/maker/tutorials/2022/get-started-with-platformio-for-your-next-arduino-project" target="_blank"> 文档教程 </a>](#)

    [:octicons-arrow-right-24: <a href="https://www.youtube.com/watch?v=nlE2203Q3XI" target="_blank"> 视频教程 </a>](#)

</div>
