Shuaiwen-Cui/ArduinoNode/DEMO/PLOTS.pptx

WSN

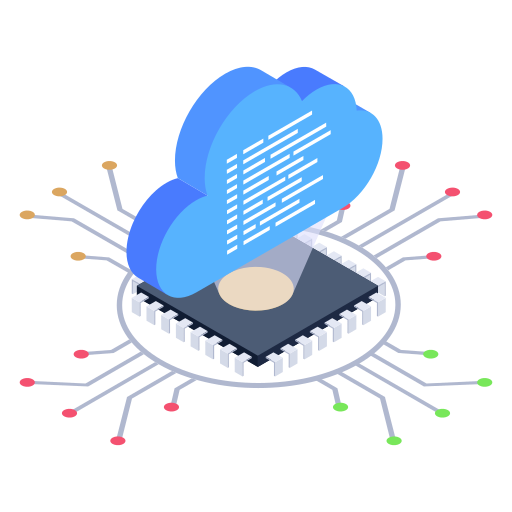
[picture p26: figure]

IoT Server

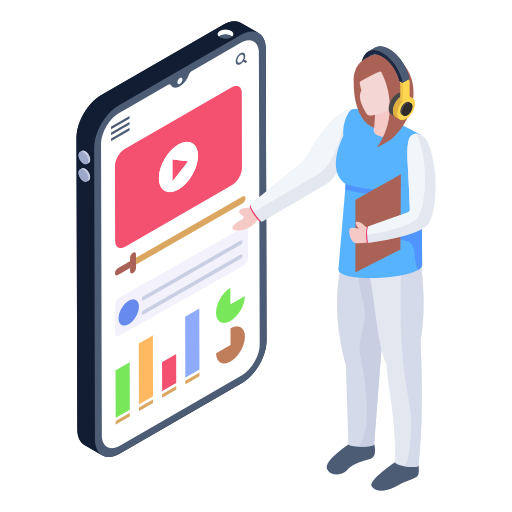
[picture p27: figure]

User Clients

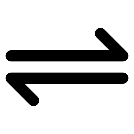
[picture p28: figure]
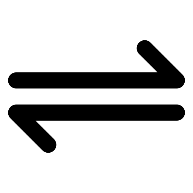
[picture p29: figure]

## Slide 2

Radio Frequency

Local

WIFI

3D Printed Case

Main Control

Arduino Uno
R4 Wifi

MQTT

RGBLED

Communication

Internet

Input

Output

Interfacing

Perception

Power System

Acceleration

MPU6050

Storage

TF Card

Battery Management System

Notes: HARDWARE ABSTRACTION [D]

## Slide 3

Arduino

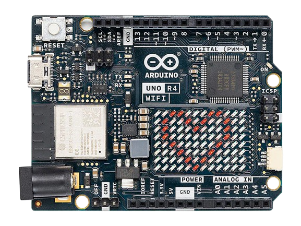
[picture p30: figure]

Single ArduinoNode

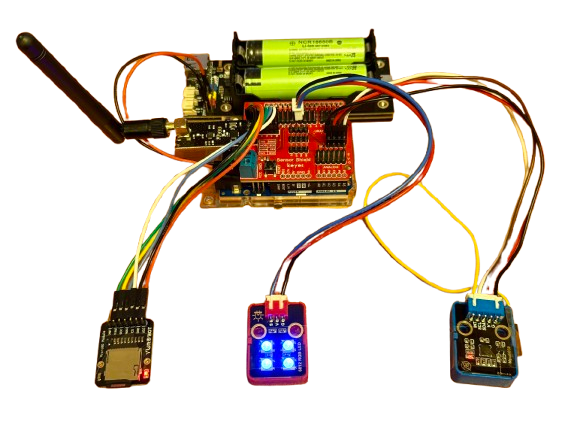
[picture p31: figure]

Sensor Board

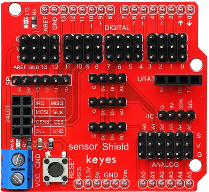
[picture p32: figure]
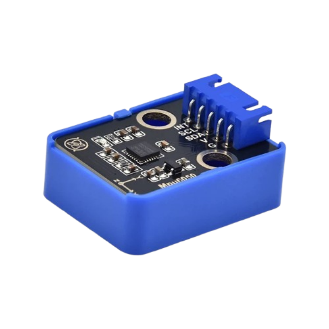
[picture p33: figure]

MPU6050

ArduinoNode WSN

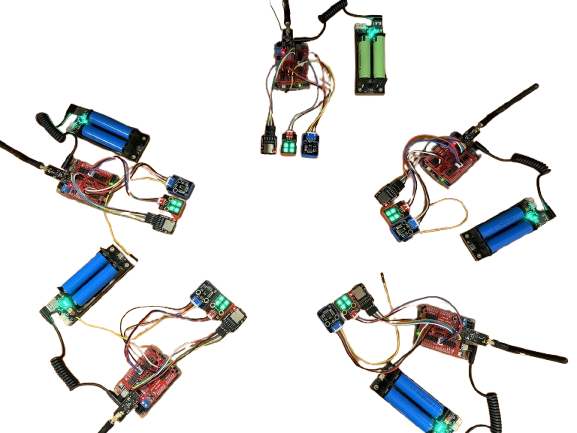
[picture p34: figure]

TF Card

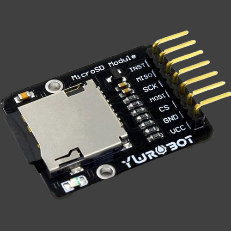
[picture p35: figure]

nRF24L01

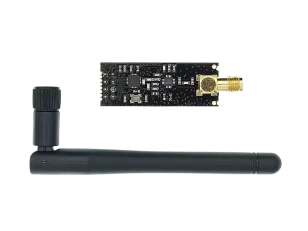
[picture p36: figure]

RGB-LED

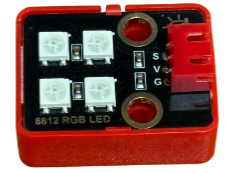
[picture p37: figure]

Battery & BMS

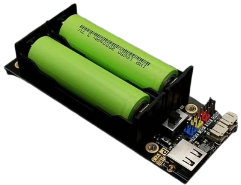
[picture p38: figure]

Enclosure

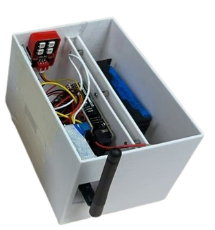
[picture p39: figure]

Notes: HARDWARE

## Slide 4

Initialization

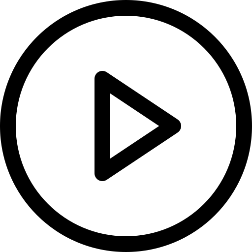
[picture p40: figure]

Infinite Loop

State
Machine

Foreground

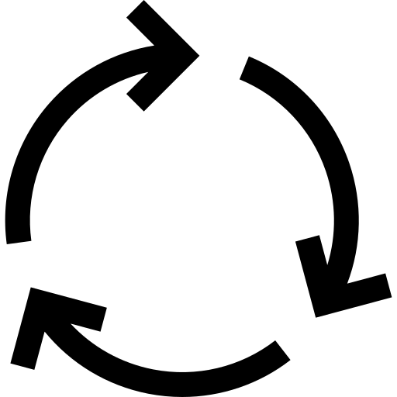
[picture p41: figure]

User Input

Background

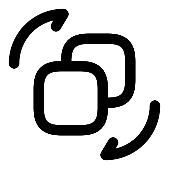
[picture p42: figure]

Indicators

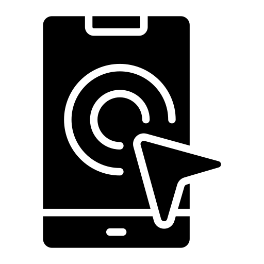
[picture p43: figure]

Notes: HARDWARE

## Slide 5

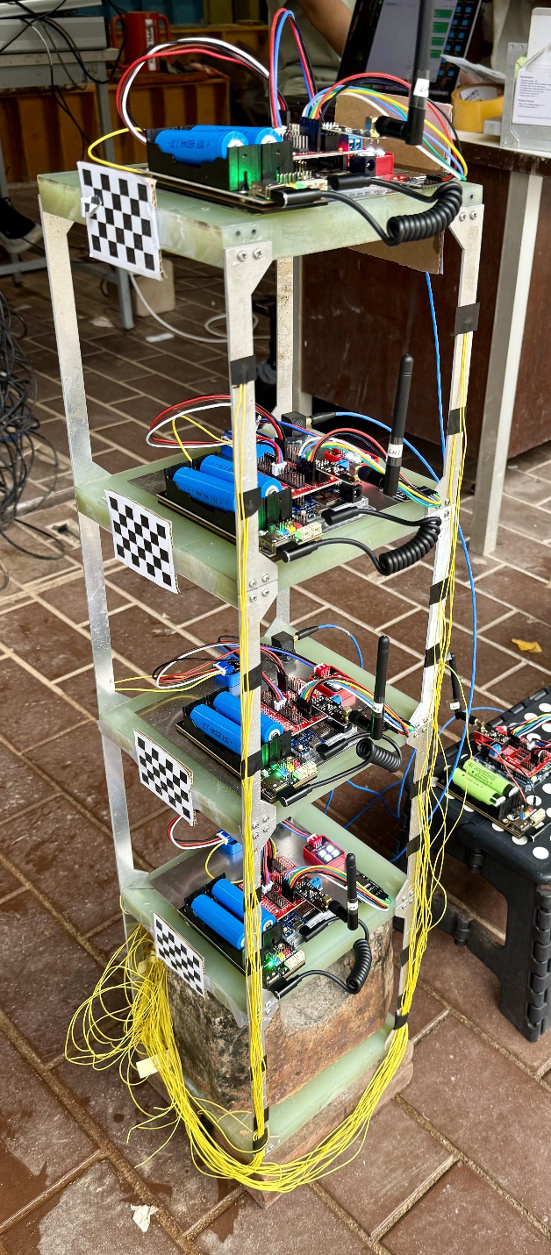
[picture p44: figure]
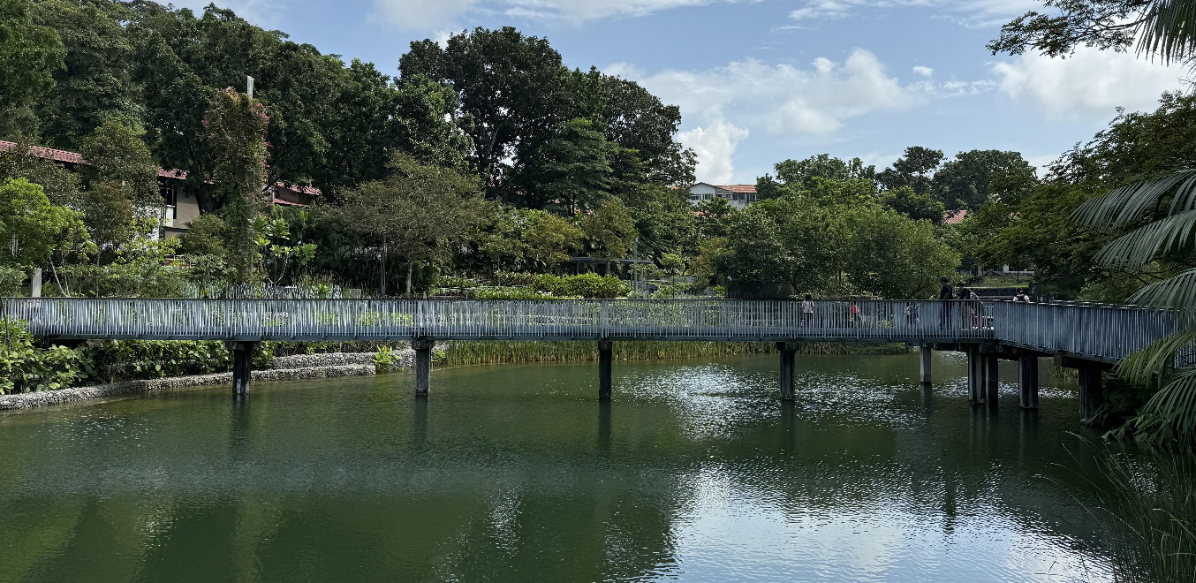
[picture p45: figure]

(b)

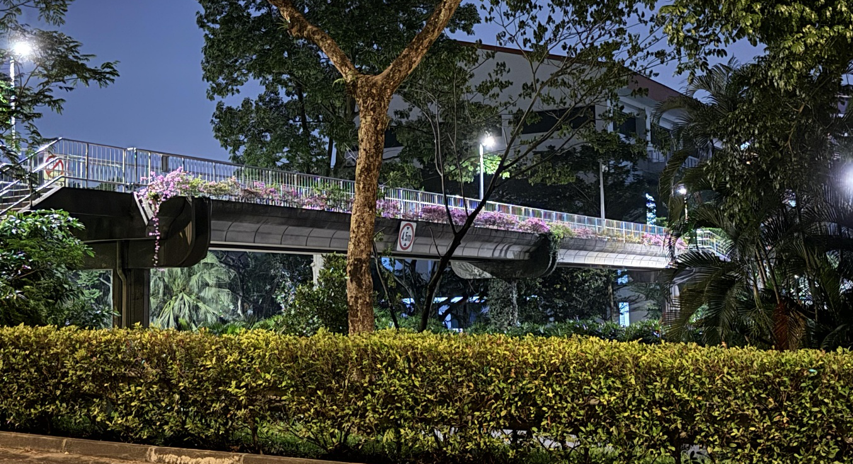
[picture p46: figure]

(a)

(c)

Notes: HARDWARE

## Slide 6

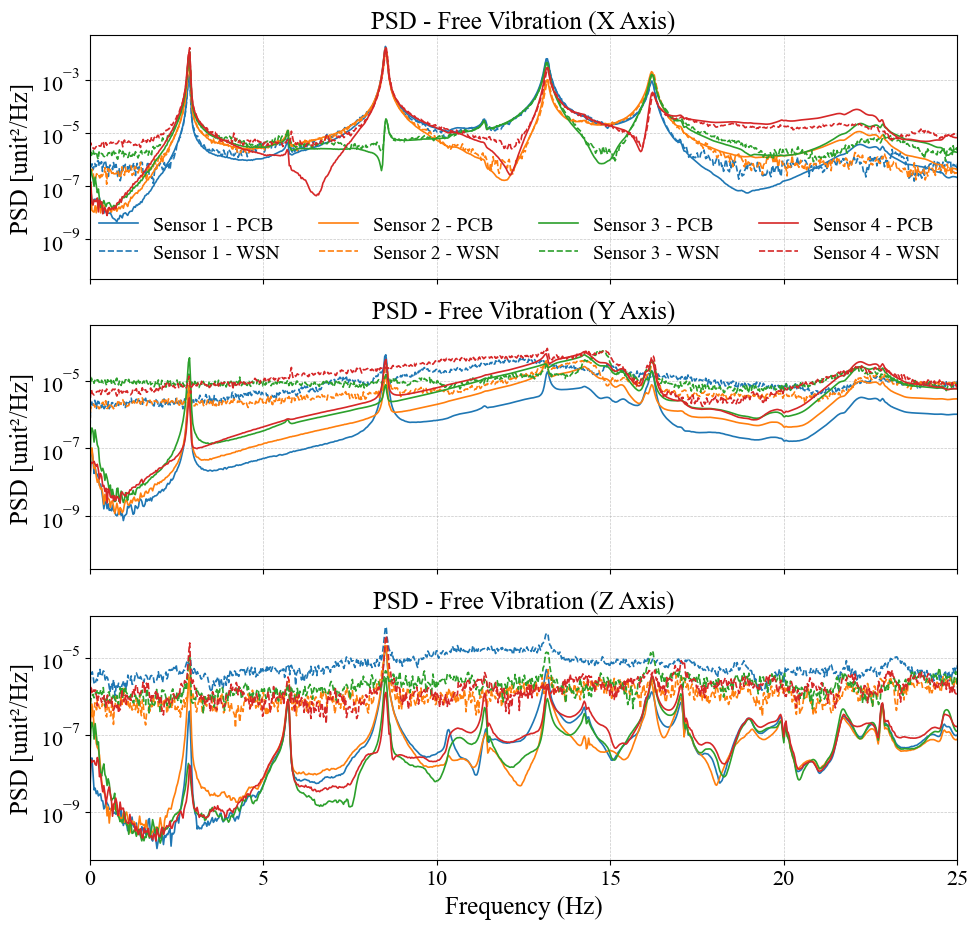
[picture p47: figure]

Notes: HARDWARE

## Slide 7

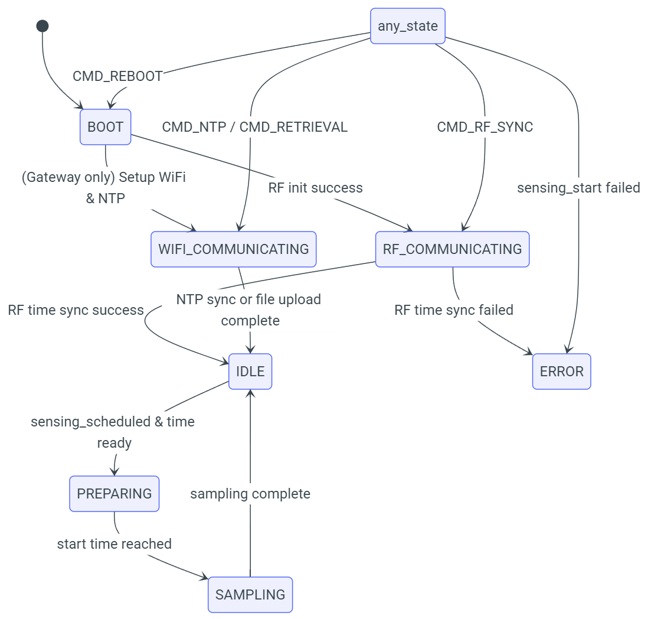
[picture p48: figure]

Notes: HARDWARE

## Slide 8

(a)

Stage I - Class

(b)

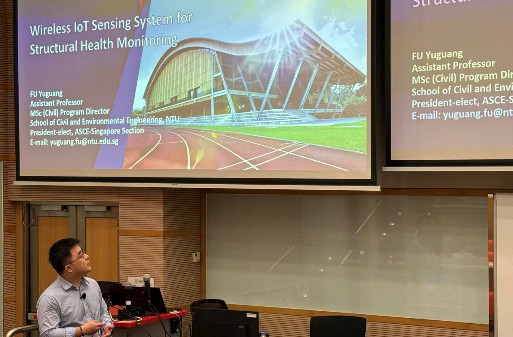
[picture p49: figure]
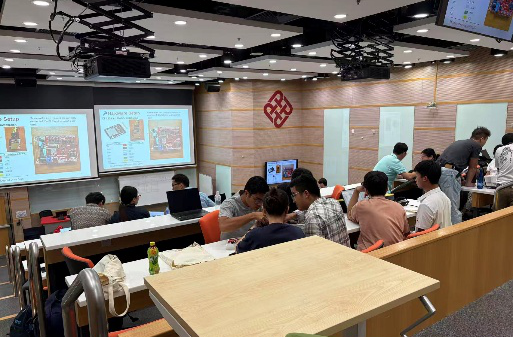
[picture p50: figure]

Stage II - Lab

(c)

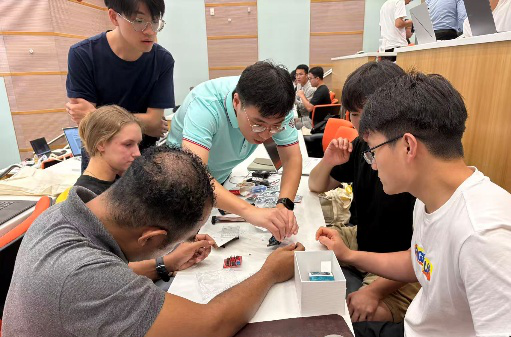
[picture p51: figure]

(d)

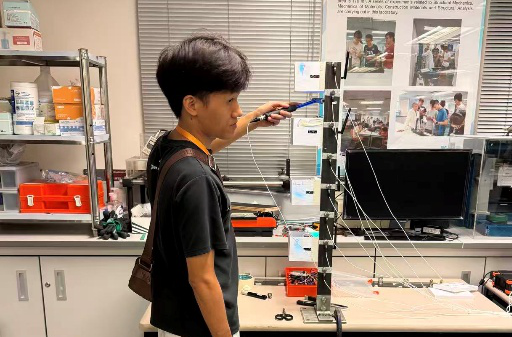
[picture p52: figure]

(e)

Stage III - Field

(f)

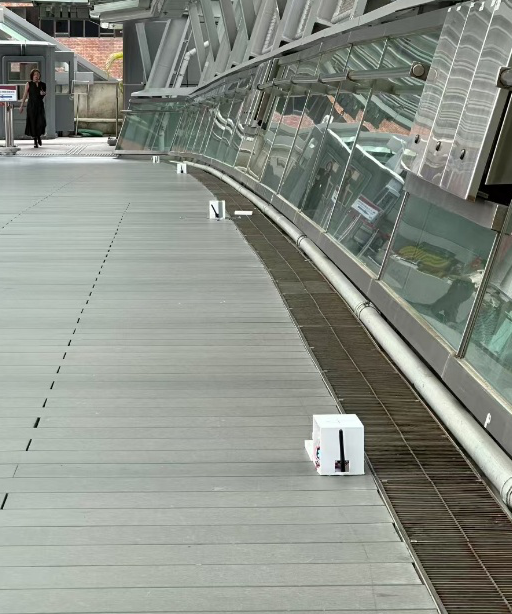
[picture p53: figure]
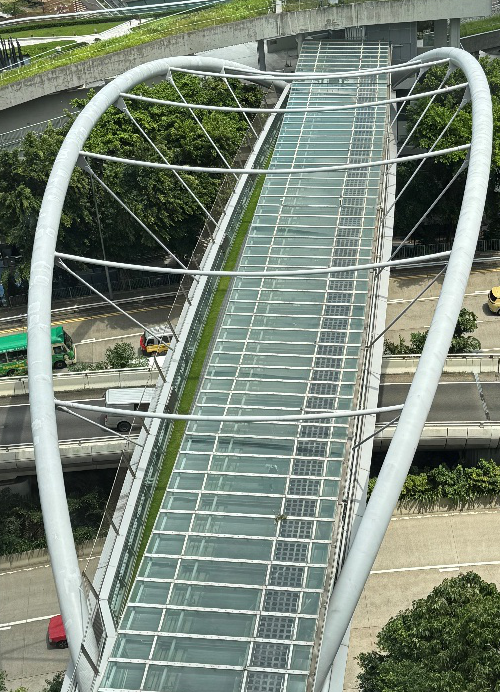
[picture p54: figure]

Notes: HARDWARE

## Slide 9

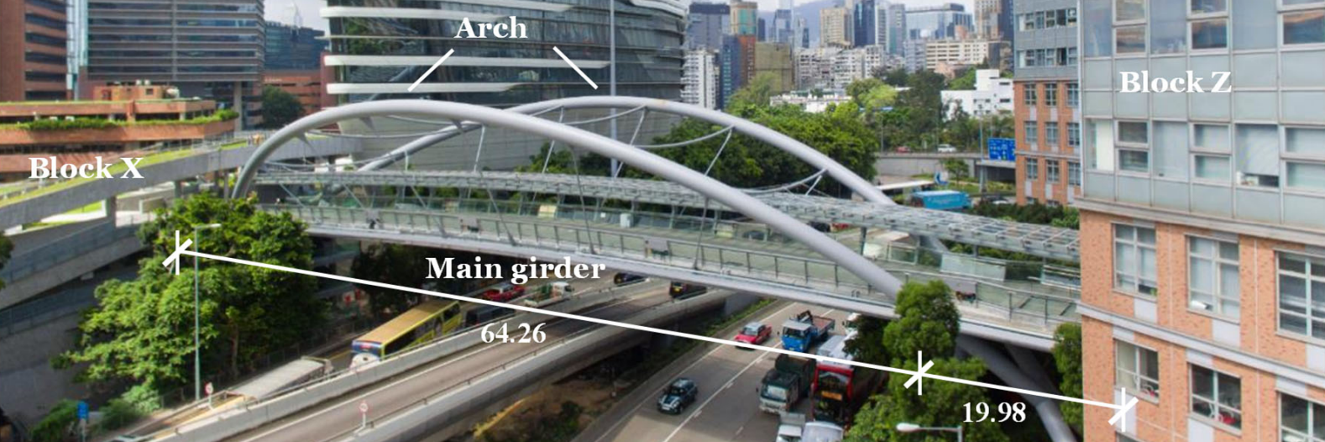
[picture p55: figure]
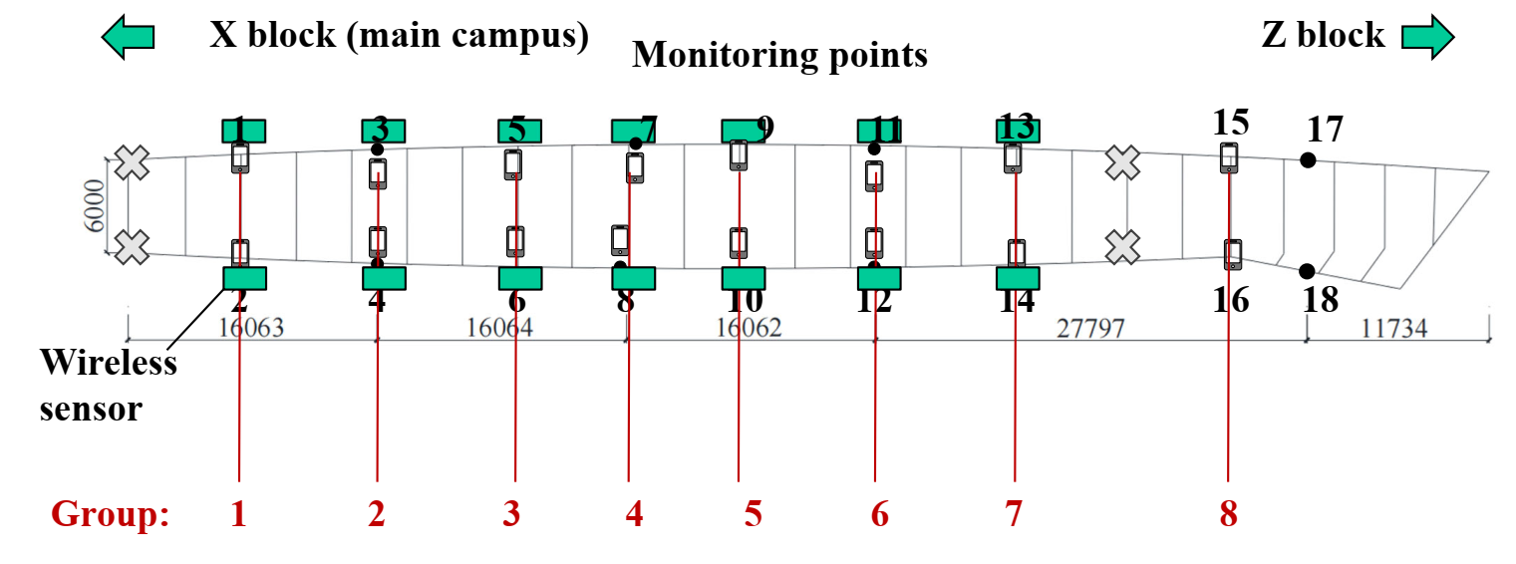
[picture p56: figure]

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
Notes: HARDWARE

## Slide 10

(a)

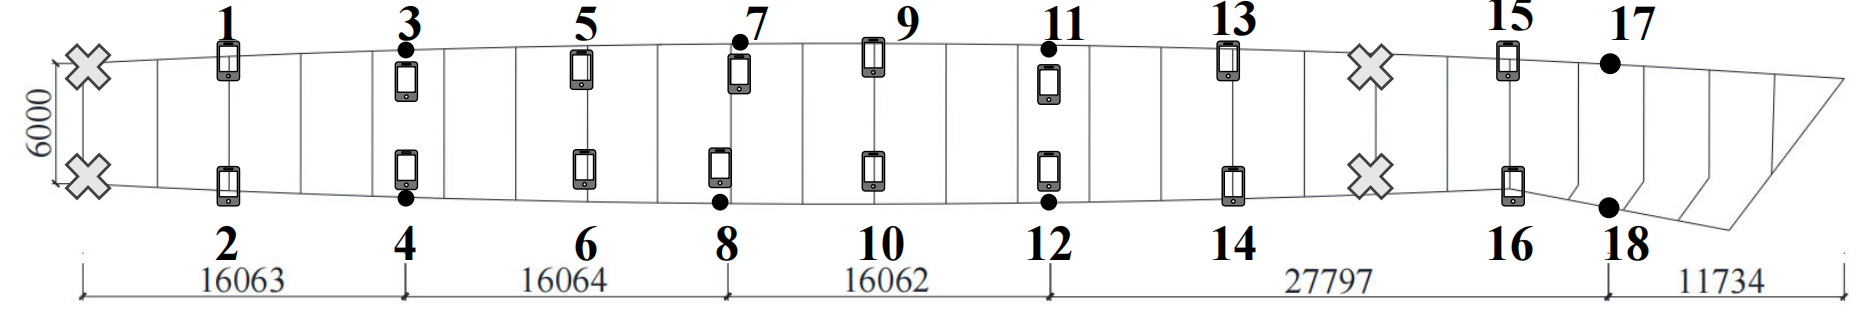
[picture p57: figure]

(b)

Builtin Sensor

Cell Phone

WSN

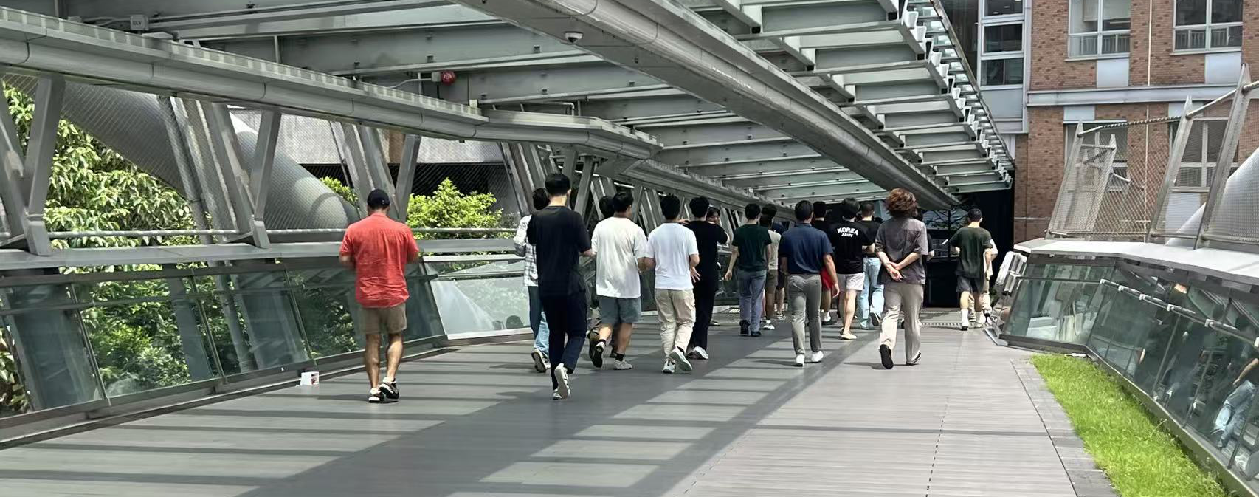
[picture p58: figure]

(c)

(d)

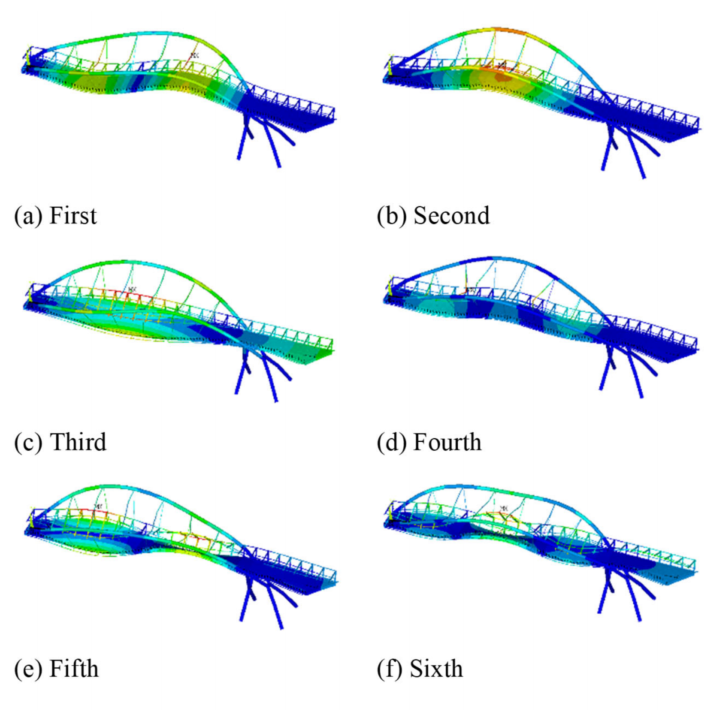
[picture p59: figure]

First 1.80 Hz

Second 2.55 Hz

Third 2.80 Hz

Forth 3.56 Hz

Fifth 3.67 Hz

Sixth 5.9 Hz

Notes: HARDWARE

## Slide 11

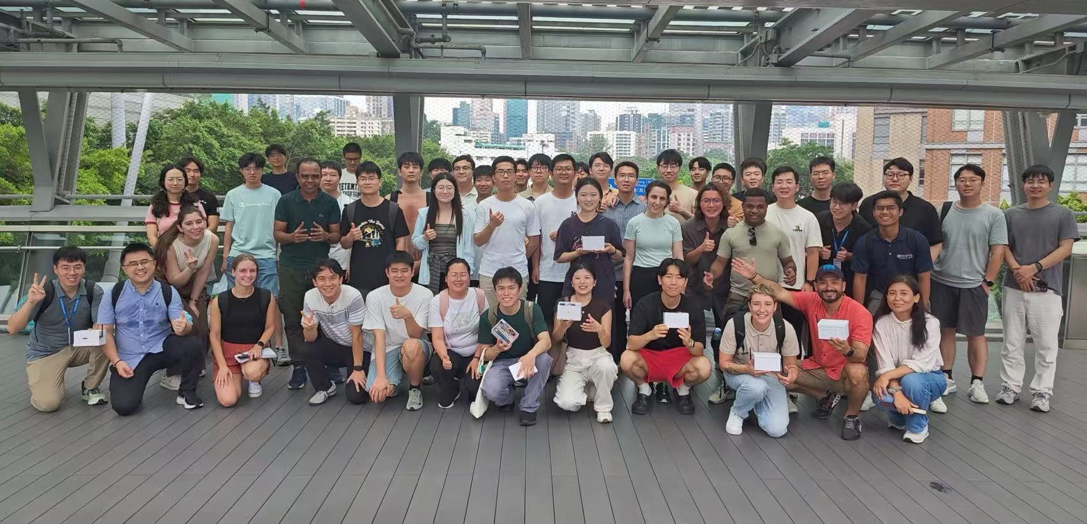
[picture p60: figure]

Notes: HARDWARE

## Slide 12

Notes: HARDWARE

## Slide 13

MAIN CONTROL

INTERACTION

POWER SYSTEM

COMMUNICATION

PERCEPTION

Notes: HARDWARE ABSTRACTION

## Slide 14

Communication

Local
Network

BT

Zigbee

Internet
Connection

WIFI

Cellular

Power System

Battery / Power Outlet

Power Management System

Main Control

Timer/ RTC

Interaction

Command Input

Micro Controller
Unit

RAM/ROM

SPI/I2C/UART/ADC/DAC/…

Large Volume Storage

Status Monitoring

Perception

Vibration

Strain

Temperature &Humidity

Camera

…

Notes: HARDWARE ABSTRACTION

## Slide 15

MAIN CONTROL

INTERACTION

POWER SYSTEM

COMMUNICATION

PERCEPTION

Notes: HARDWARE ABSTRACTION

## Slide 16

Communication

Power System

Battery / Power Outlet

Power Management System

Perception

Local
Network

BT

Zigbee

Internet
Connection

WIFI

Cellular

Main Control

Timer/ RTC

Interaction

Micro Controller
Unit

RAM/ROM

Command Input

SPI/I2C/UART/ADC/DAC/…

Large Volume Storage

Status Monitoring

Vibration

Strain

Temperature &Humidity

Camera

…

Notes: HARDWARE ABSTRACTION

## Slide 17

Application Specific Code

APPLICATION LAYER

File System

TCP/IP & MQTT

Digital Signal Processing

Edge AI Framework

Real-time Operating System

SYSTEM SERVICE LAYER

Edge Intelligence Library for SHM Applications - TinySHM

TS Damage Detection

TS Notification

…

TS Measurement

TS System Identification

TS Config

TS Math

TS Sense

TS DSP

TS File

TS AI

TS Network

Startup Code

Hardware Abstraction Drivers (Register-Level)

Board Support Packages
(Board-Level)

PLATFORM ABSTRACTION LAYER

Main
Control

Peripheral Components
Sensing / Communication / Interaction / Power Supply

HARDWARE LAYER

Notes: SOFTWARE ARCHITECTURE

## Slide 18

Notes: CODE ARCHITECTURE

## Slide 19

Control

Perception

Communication

Interfacing

Power

Notes: HARDWARE ABSTRACTION [DEPRECATED]

## Slide 20

Control

Perception

Communication

Interfacing

Notes: HARDWARE ABSTRACTION [DEPRECATED]

## Slide 21

Application Specific Code

Edge Intelligence Library for SHM Applications - TinySHM

TS Damage Detection

TS Notification

…

TS Measurement

TS System Identification

TS Config

TS Math

TS Sense

TS DSP

TS File

TS AI

TS Network

File System

TCP/IP & MQTT

Digital Signal Processing

Edge AI Framework

Real-time Operating System

Startup Code

Hardware Abstraction Drivers (Register-Level)

Board Support Packages
(Board-Level)

Main
Control

Peripheral Components
Sensing / Communication / Interaction / Power Supply

- APPLICATIONS

- SYSTEM
SERVICES

- PLATFORM
ABSTRACTION

- HARDWARE
