Shuaiwen-Cui/ArduinoNode/DOC/docs/HARDWARE/SHIELD/shield.zh.md

# 传感器扩展板

!!! info "传感器扩展板"
    传感器扩展板是一个用于连接各种传感器的扩展板，提供了丰富的接口和功能，方便用户进行传感器数据采集和处理。

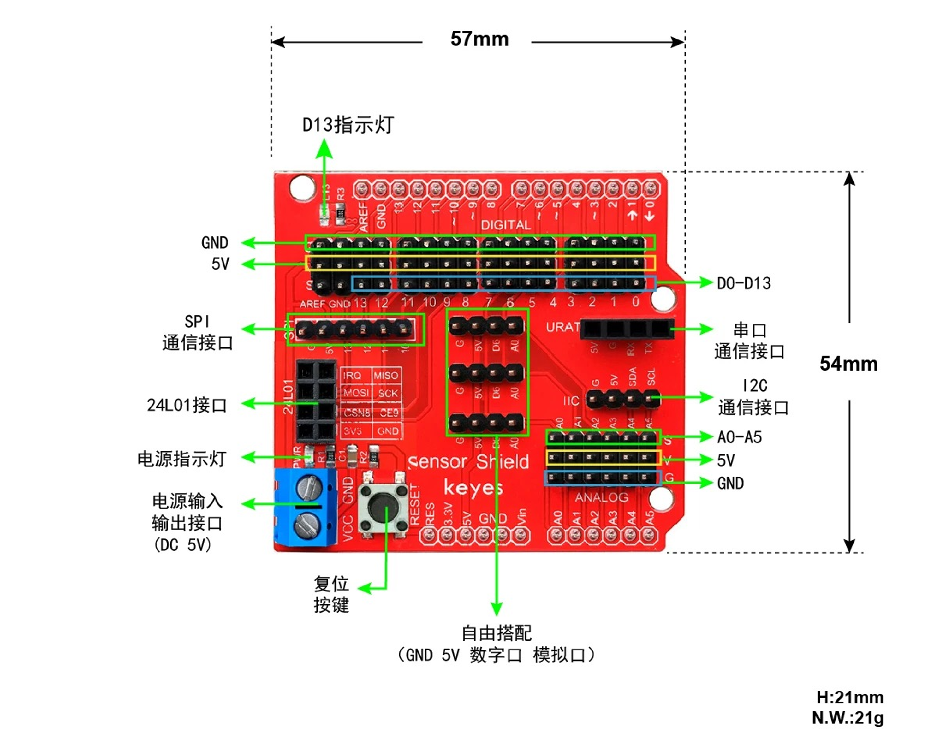
[picture p61: DOC/docs/MANUAL/ASSEMBLY/shield-zh.png]
