Shuaiwen-Cui/ArduinoNode/plan.md

目前主要剩余任务就是：
1. 时钟同步 （可以远程）
2. 加速度calibration （最好在新加坡）
3. 模态识别对比 （最好在新加坡）
4. 试验方案设计 （可以远程）
所以，辛苦了，比较好的计划，是你留3个在这里，然后让张棋和于潇帮你在实验室调试，然后你自己拿两个过去，等深圳的到了之后，自己再组装一个，然后自己在那里接着测。时钟同步你写好code，让于潇帮你测

进度更新：

1. 始终同步 - 接近完成，最终测试中
2. 加速度校准 - 争取今下午做完，与pcb对比 -- 时钟功能性能评估，加速度校准参数计算，实验室结构模态识别
3. field test 数据

主节点： t1==========================t4
直接点：           t2======t3 

delay + offset median

t1   t2

100 - 1
100 - 2
100 - 3
100 - 4
100 - 5
100 - 6
100 - 7
100 - 8

100 - 1
100 - 2
100 - 3
100 - 4
100 - 5
100 - 6
100 - 7
100 - 8

5 rounds

latency = [(t4-t1) - (t3-t2)]/2
drift = [(t4-t1) - 2*latency]/(t3-t1)

ftsp
