Shuaiwen-Cui/ArduinoNode/DOC/docs/DEMO/timesynctest.zh.md

# 时间同步性能分析



本次测试为测试无线传感器网络的同步性能，实验中，传感器被放置在同一桌面，围成一圈，距离中心点等距离放置。采用间隔敲击的方式对传感器中心空缺位置进行有规律敲击。通过分析峰值延迟来计算传感器之间的同步性能。具体采用的方式是互相关分析，计算不同传感器与主节点的互相关函数，计算峰值延迟。

## 时程曲线



## 延迟分析
