Shuaiwen-Cui/ArduinoNode/DOC/docs/SOFTWARE/SENSING-STORAGE/storage.zh.md

# 存储

本项目中的存储功能是通过SD卡来实现的，由于Arduino内存的限制，采样和存储是同步进行。具体可以参考传感部分的解释。
