Shuaiwen-Cui/ArduinoNode/DOC/site/HARDWARE/ENCLOSURE/backview.jpg

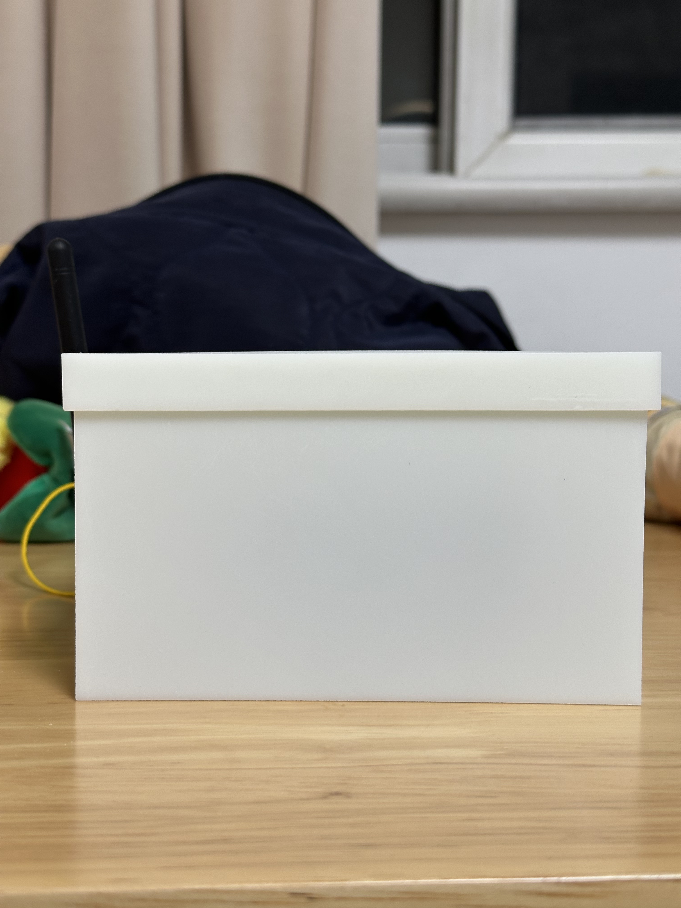
DOC/site/HARDWARE/ENCLOSURE/backview.jpg
