Shuaiwen-Cui/ArduinoNode/DOC/site/HARDWARE/ENCLOSURE/frontview.jpg

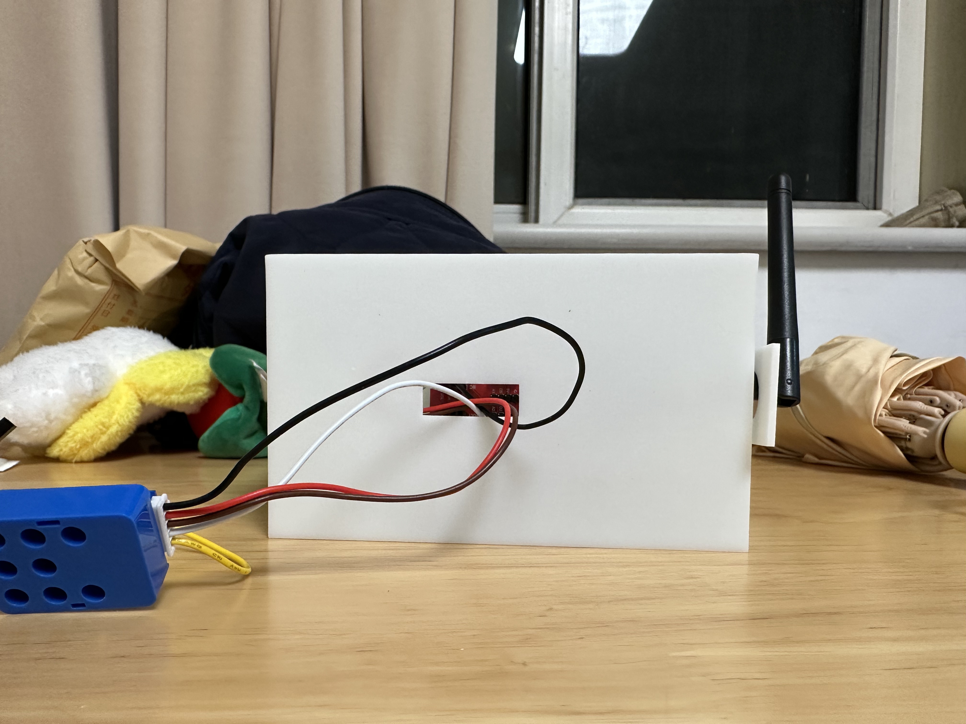
DOC/site/HARDWARE/ENCLOSURE/frontview.jpg
