Shuaiwen-Cui/ArduinoNode/DOC/site/HARDWARE/ENCLOSURE/side-view.jpg

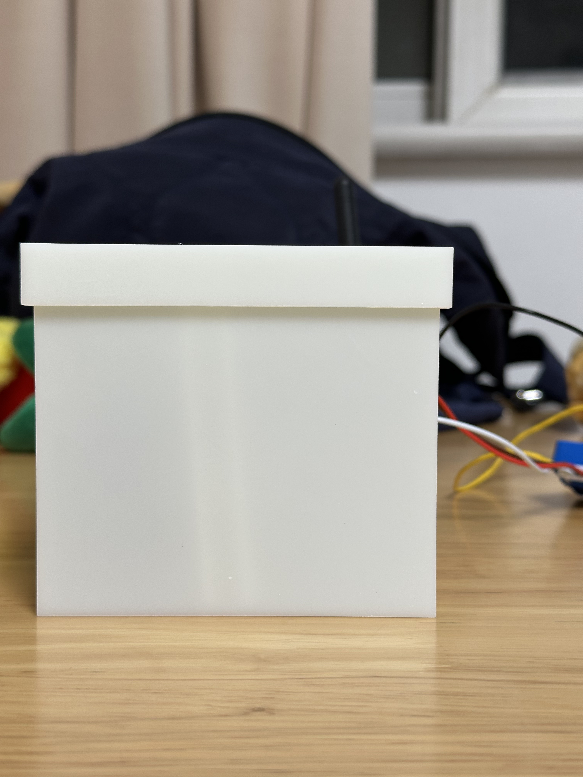
DOC/site/HARDWARE/ENCLOSURE/side-view.jpg
