Shuaiwen-Cui/ArduinoNode/DOC/site/HARDWARE/ENCLOSURE/sideview.jpg

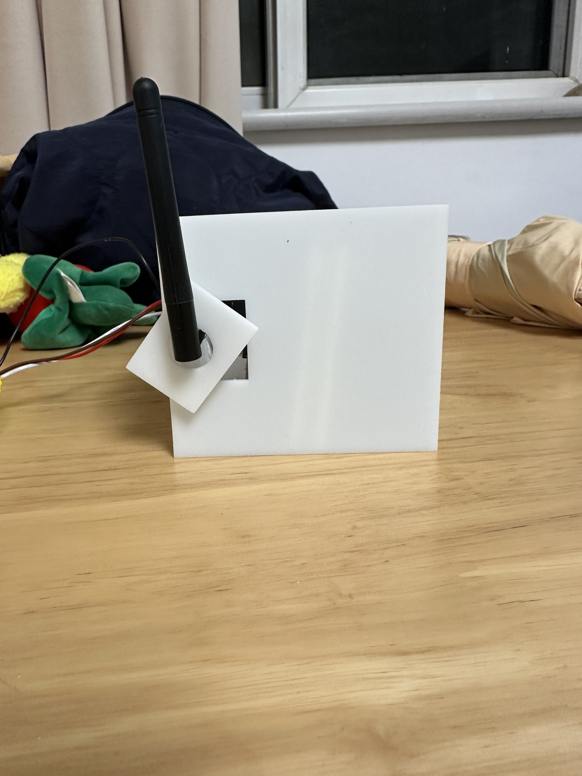
DOC/site/HARDWARE/ENCLOSURE/sideview.jpg
