Shuaiwen-Cui/ArduinoNode/DOC/site/HARDWARE/MCU/mcu.jpg

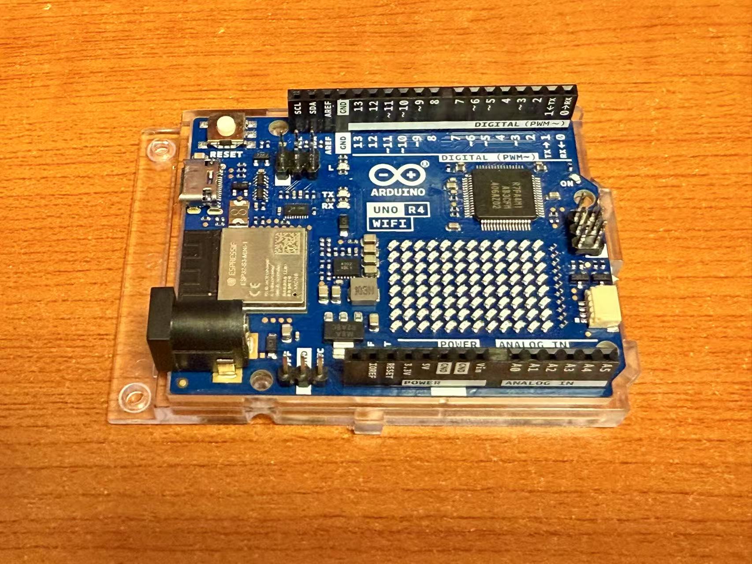
DOC/site/HARDWARE/MCU/mcu.jpg
