Shuaiwen-Cui/ArduinoNode/BMS/3.7V 2S锂电池V2.2-18650/3.7V 2S锂电池V2.2-18650.step

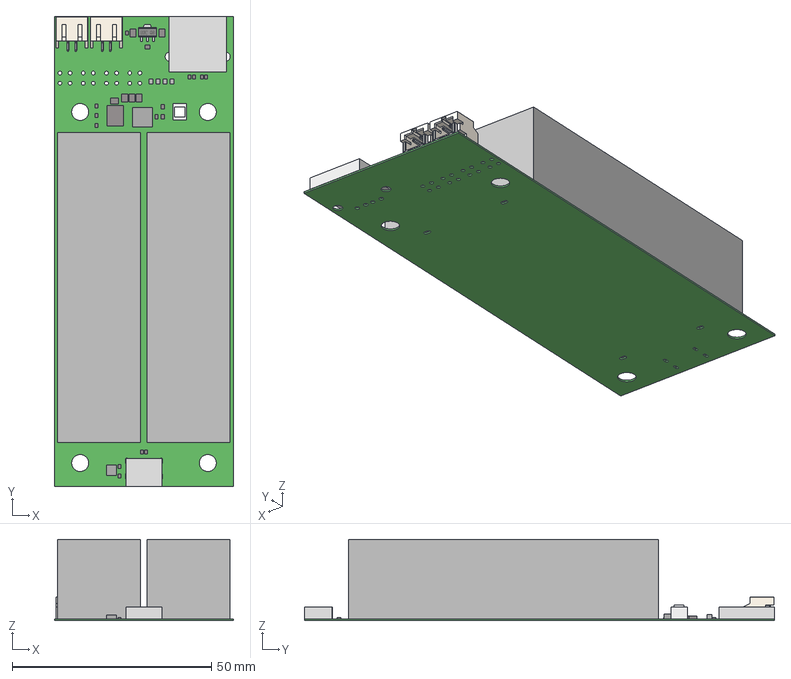
[picture p71: CAD file, 2025-06-25]
BMS/3.7V 2S锂电池V2.2-18650/3.7V 2S锂电池V2.2-18650.step
44.9 x 117.9 x 20.4 mm
Extruded x 35
PH2_0_SMD-W_00 x 4
1_A x 2
SOT-89-3
