Shuaiwen-Cui/ArduinoNode/Enclosure/export/ArduinoNode_shell_cover.stl

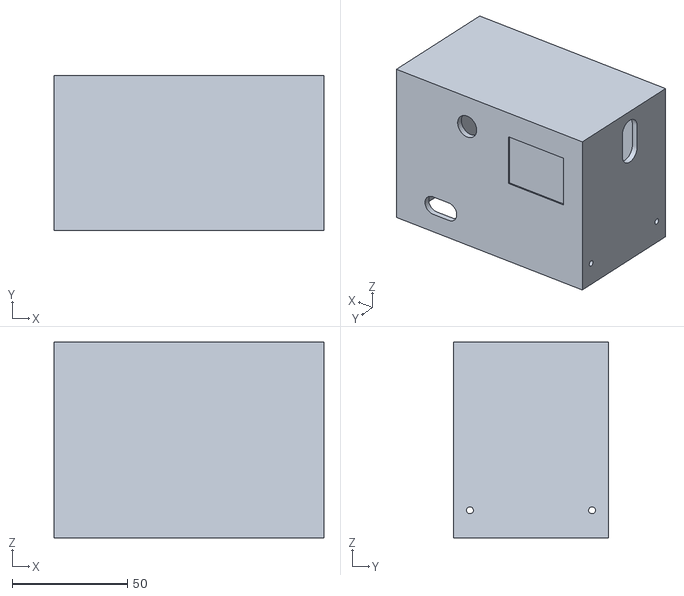
[picture p72: CAD file, 2026-09-29]
Enclosure/export/ArduinoNode_shell_cover.stl
117.2 x 67.2 x 85.0
