Shuaiwen-Cui/ArduinoNode/Enclosure/REF/ABX00087-cad-files/Additional files/PCB(ABX00087).step

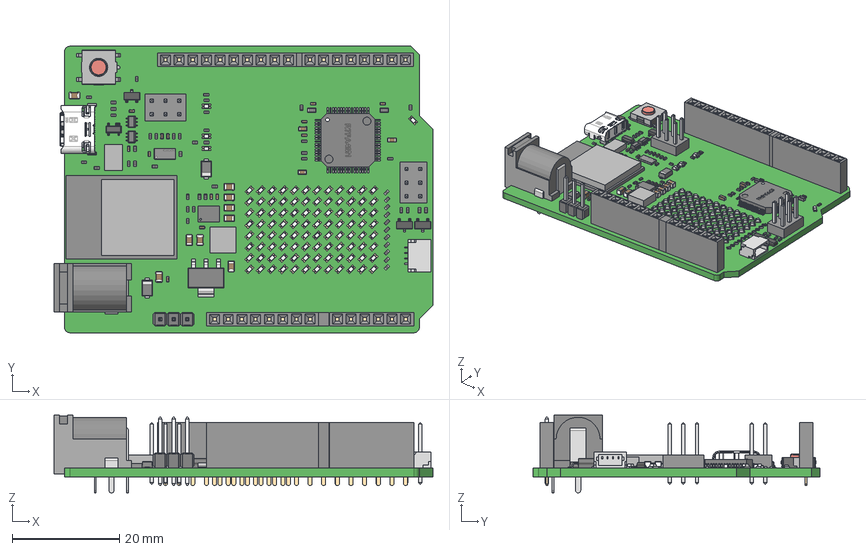
[picture p73: CAD file, 2026-09-16]
Enclosure/REF/ABX00087-cad-files/Additional files/PCB(ABX00087).step
70.5 x 53.3 x 14.5 mm
RES-0402 x 50
Lead x 3
Tab
CAP-0805 x 9
HSMx-190 x 100
Leader x 76
CAP-0402 x 13
Extruded x 8
SOT-23 x 3
SM04B-SRSS-TB_RGB12040119
lead x 4
pin4 x 3
CAP-0603 x 3
2x3 Header x 2
Part16_MIR x 2
Part16_MIR1 x 8
Part16 - Copy
Thermal_Shape
FER-0603 x 2
pj-102ah
PRTR5V0U2X
TETactileSwitch1571636
CX90B-16P_3D
Header_Fem_1X10_digikey
Header _Fem_1X8 x 2
Header_Fem_1X6_digikey
