Shuaiwen-Cui/ArduinoNode/Enclosure/export/ArduinoNode_base_plate.stl

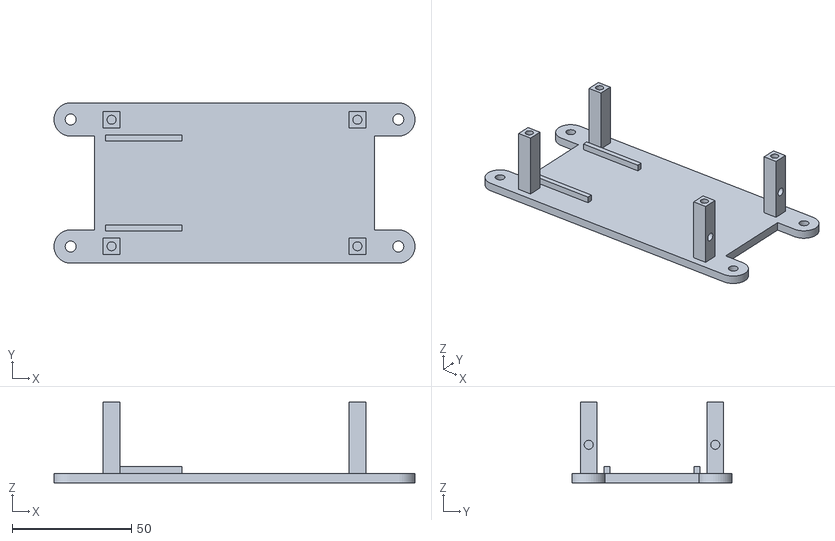
[picture p74: CAD file, 2026-09-16]
Enclosure/export/ArduinoNode_base_plate.stl
151.2 x 67.2 x 33.9
