Shuaiwen-Cui/ArduinoNode/Enclosure/export/ArduinoNode_mounting_plate.stl

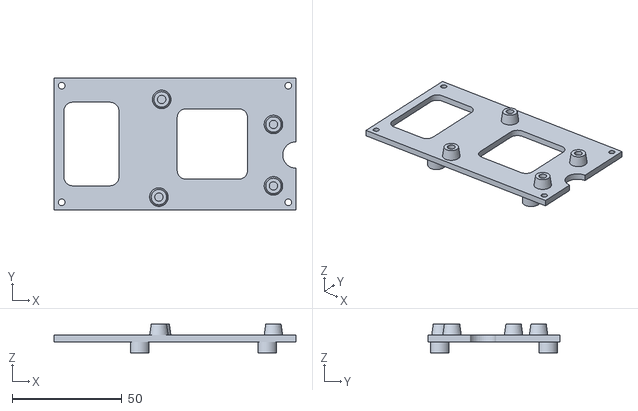
[picture p75: CAD file, 2026-09-16]
Enclosure/export/ArduinoNode_mounting_plate.stl
110.0 x 60.0 x 13.0
