Shuaiwen-Cui/ArduinoNode/DOC/docs/MANUAL/manual.en.md

# MANUAL

Please follow the order below to read:

(1) Hardware Assembly
(2) Programming
(3) Deployment and Testing
