Shuaiwen-Cui/ArduinoNode/DOC/docs/MANUAL/manual.zh.md

# 使用手册

请遵循以下顺序阅读：

（1）硬件组装
（2）编程
（3）部署与测试
