Shuaiwen-Cui/ArduinoNode/DEMO/.ppt-build/render-dark/slide-1.png

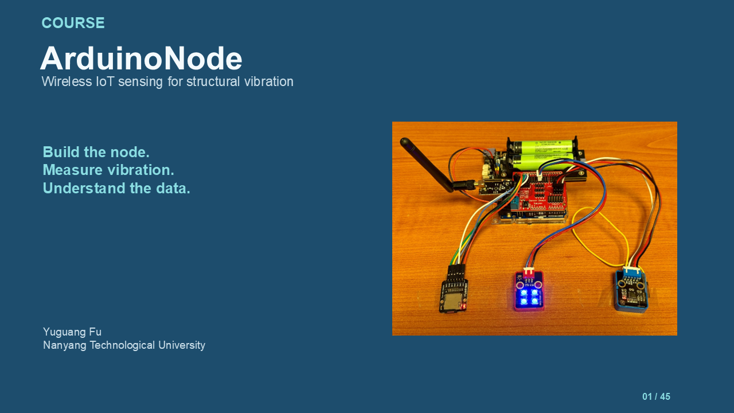
DEMO/.ppt-build/render-dark/slide-1.png
