Shuaiwen-Cui/ArduinoNode/DEMO/.ppt-build/render-dark/slide-2.png

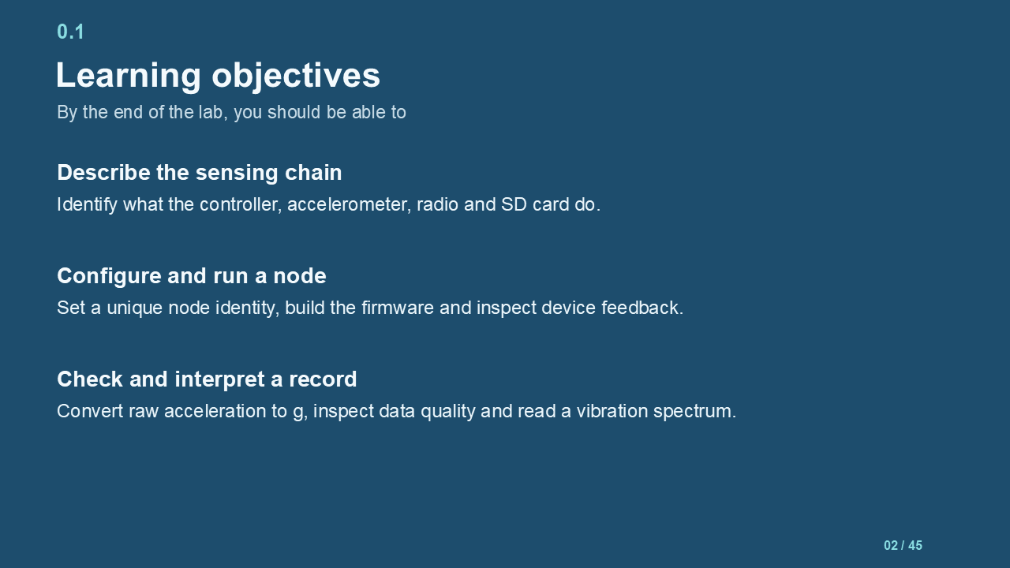
DEMO/.ppt-build/render-dark/slide-2.png
