Shuaiwen-Cui/ArduinoNode/DEMO/.ppt-build/render-dark/slide-3.png

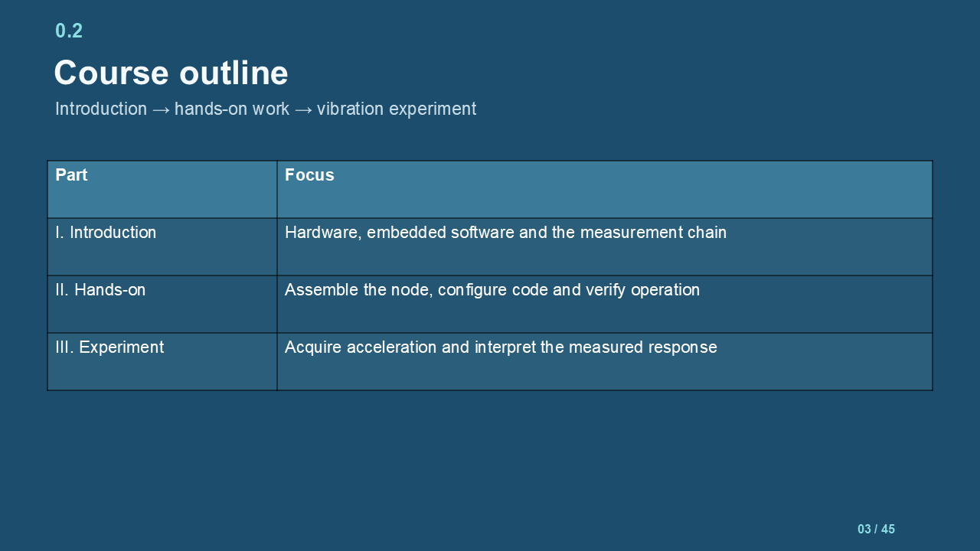
DEMO/.ppt-build/render-dark/slide-3.png
