Shuaiwen-Cui/ArduinoNode/DEMO/.ppt-build/render-dark/slide-5.png

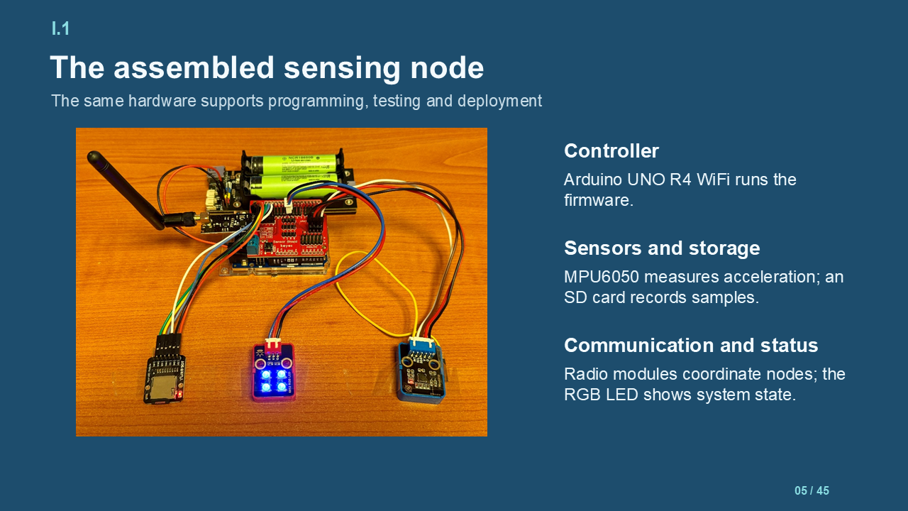
DEMO/.ppt-build/render-dark/slide-5.png
