Shuaiwen-Cui/ArduinoNode/DEMO/.ppt-build/render-dark/slide-11.png

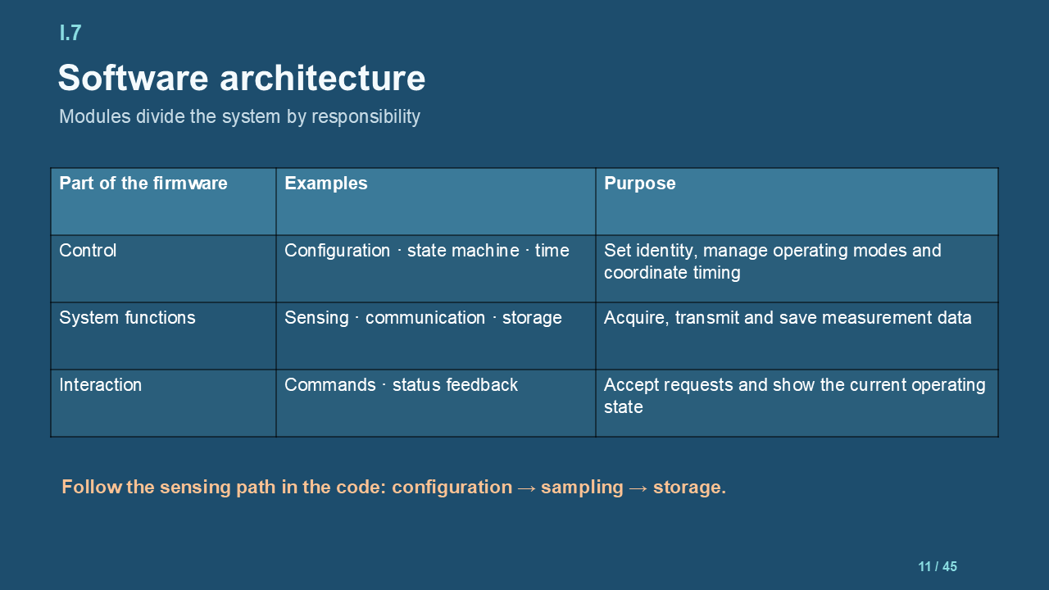
DEMO/.ppt-build/render-dark/slide-11.png
