Shuaiwen-Cui/ArduinoNode/DEMO/.ppt-build/render-dark/slide-13.png

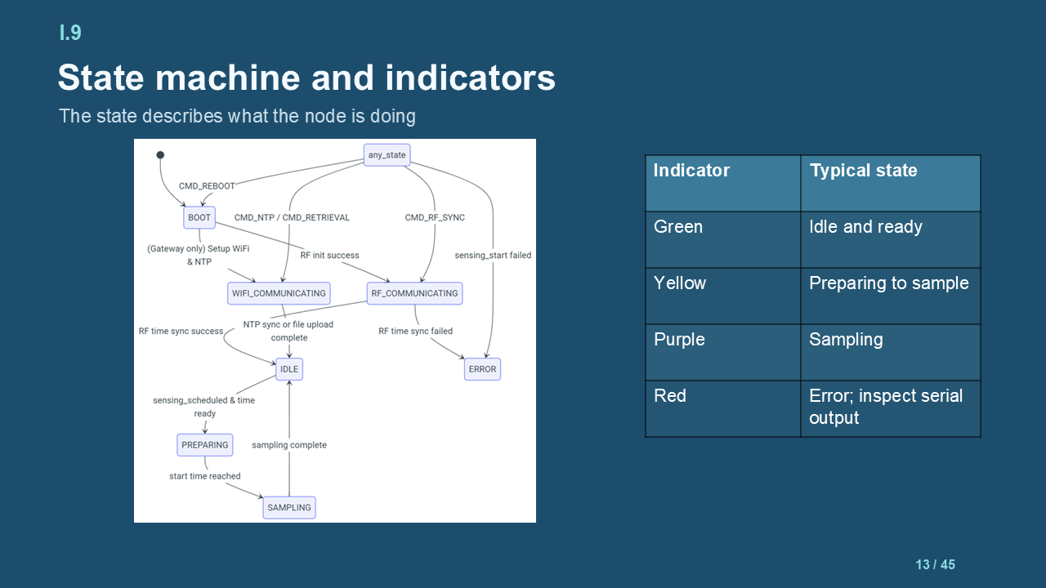
DEMO/.ppt-build/render-dark/slide-13.png
