Shuaiwen-Cui/ArduinoNode/DEMO/.ppt-build/render-dark/slide-18.png

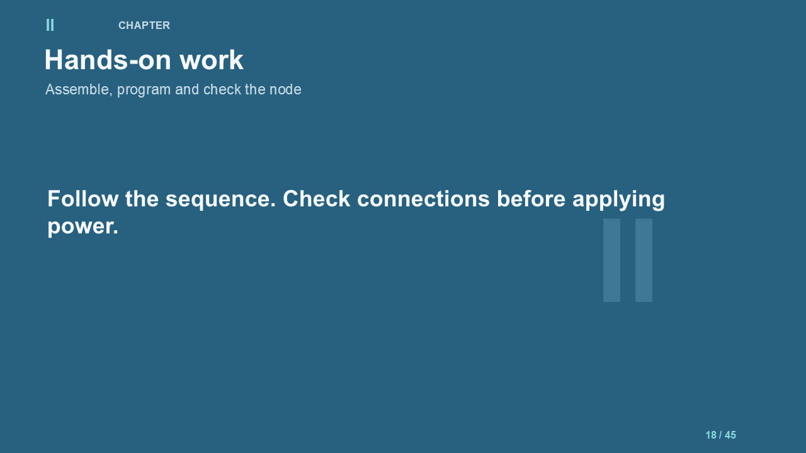
DEMO/.ppt-build/render-dark/slide-18.png
