Shuaiwen-Cui/ArduinoNode/DEMO/.ppt-build/render-dark/slide-19.png

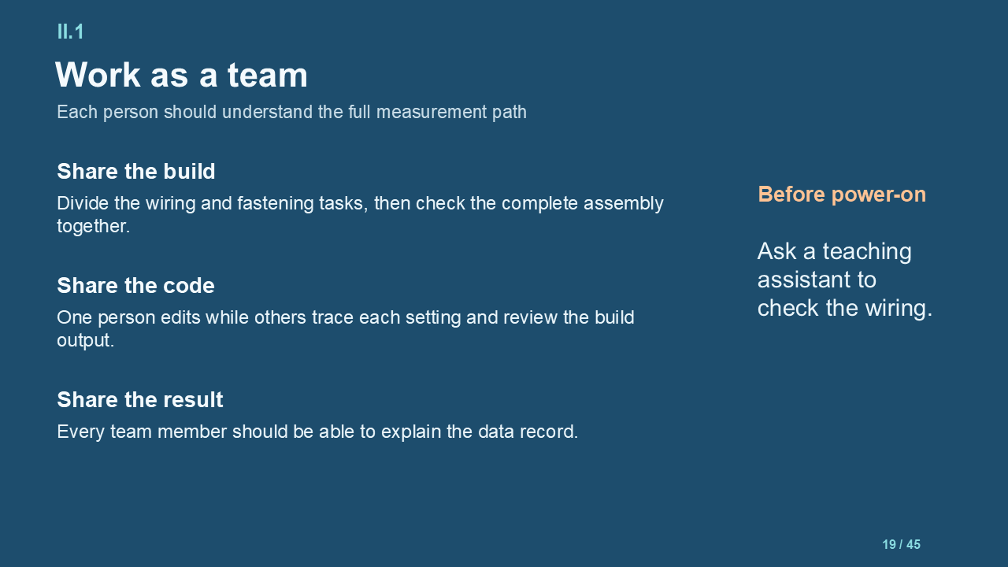
DEMO/.ppt-build/render-dark/slide-19.png
