Shuaiwen-Cui/ArduinoNode/DEMO/.ppt-build/render-dark/slide-23.png

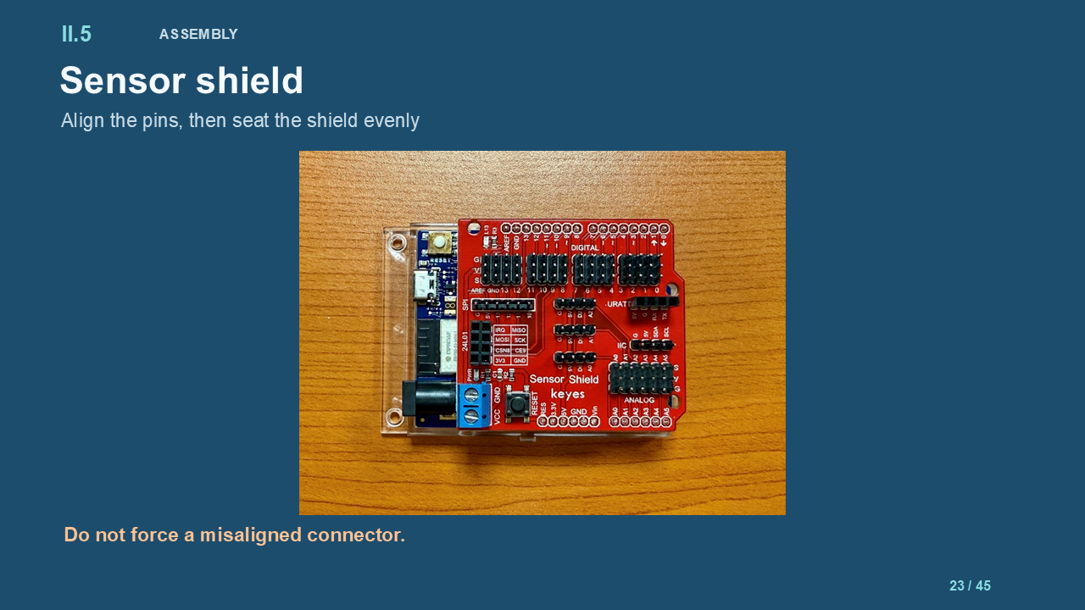
DEMO/.ppt-build/render-dark/slide-23.png
