Shuaiwen-Cui/ArduinoNode/DEMO/.ppt-build/render-dark/slide-25.png

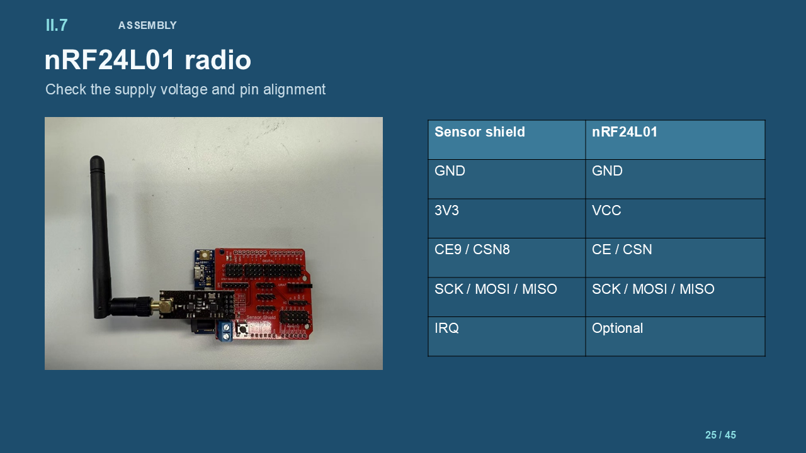
DEMO/.ppt-build/render-dark/slide-25.png
