Shuaiwen-Cui/ArduinoNode/DEMO/.ppt-build/render-dark/slide-27.png

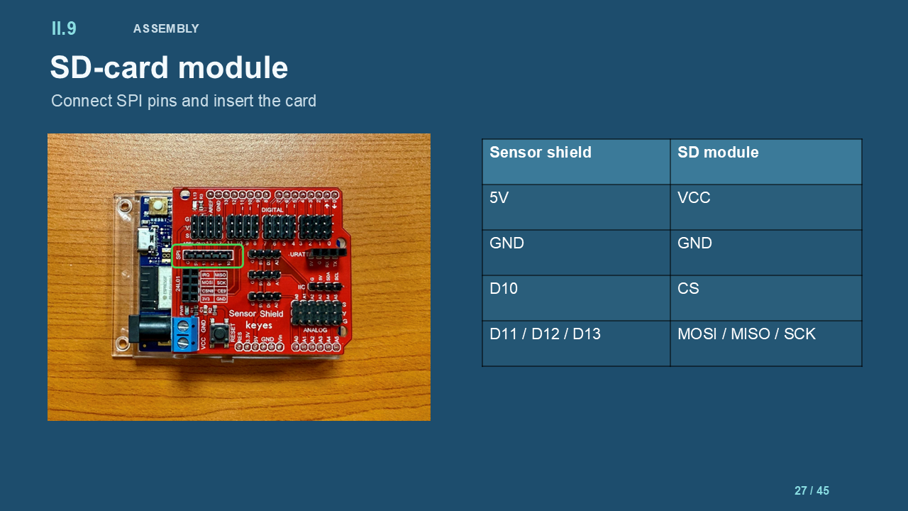
DEMO/.ppt-build/render-dark/slide-27.png
