Shuaiwen-Cui/ArduinoNode/DEMO/.ppt-build/render-dark/slide-29.png

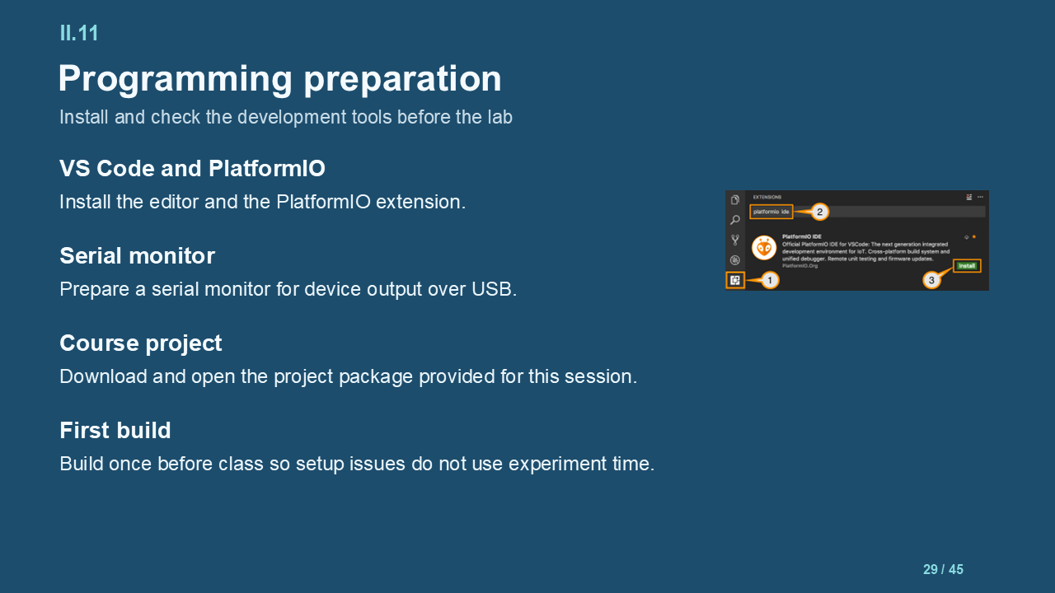
DEMO/.ppt-build/render-dark/slide-29.png
