Shuaiwen-Cui/ArduinoNode/DEMO/.ppt-build/render-dark/slide-30.png

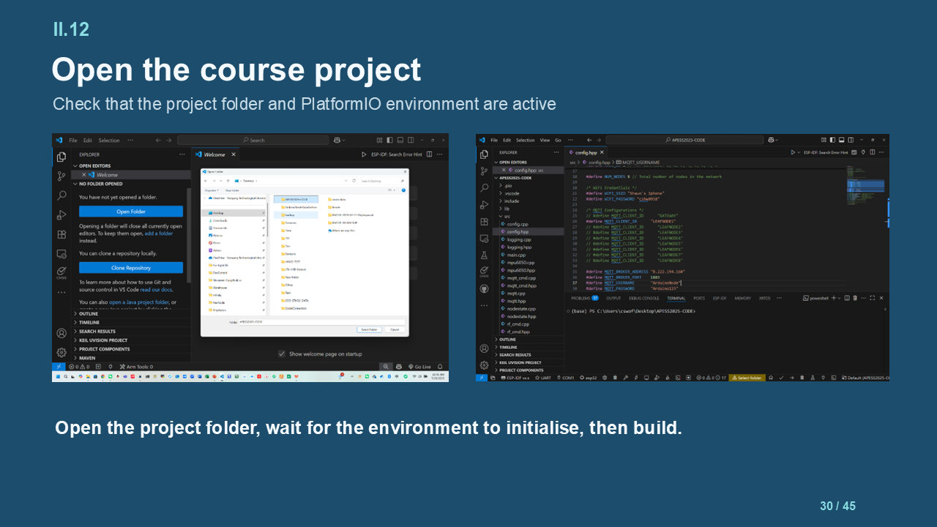
DEMO/.ppt-build/render-dark/slide-30.png
