Shuaiwen-Cui/ArduinoNode/DEMO/.ppt-build/render-dark/slide-32.png

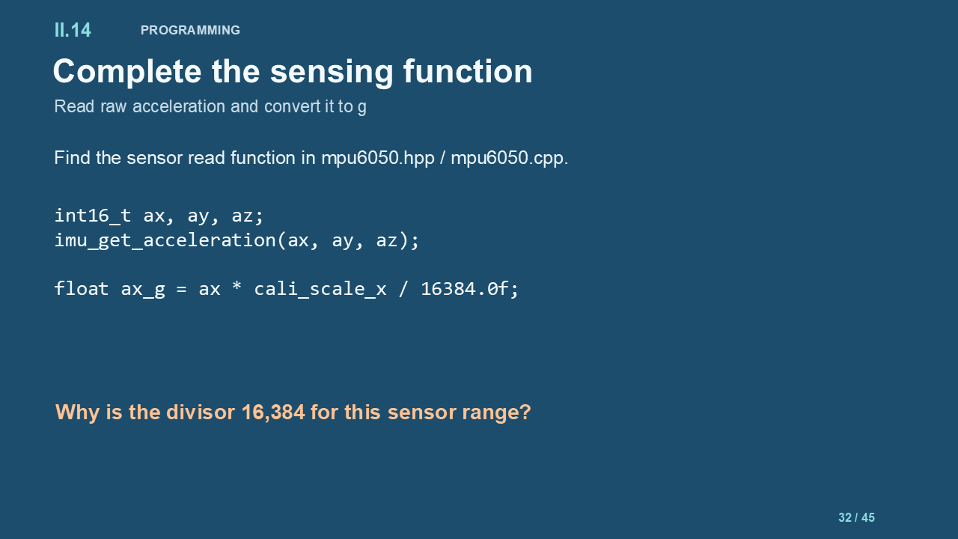
DEMO/.ppt-build/render-dark/slide-32.png
