Shuaiwen-Cui/ArduinoNode/DEMO/.ppt-build/render-dark/slide-33.png

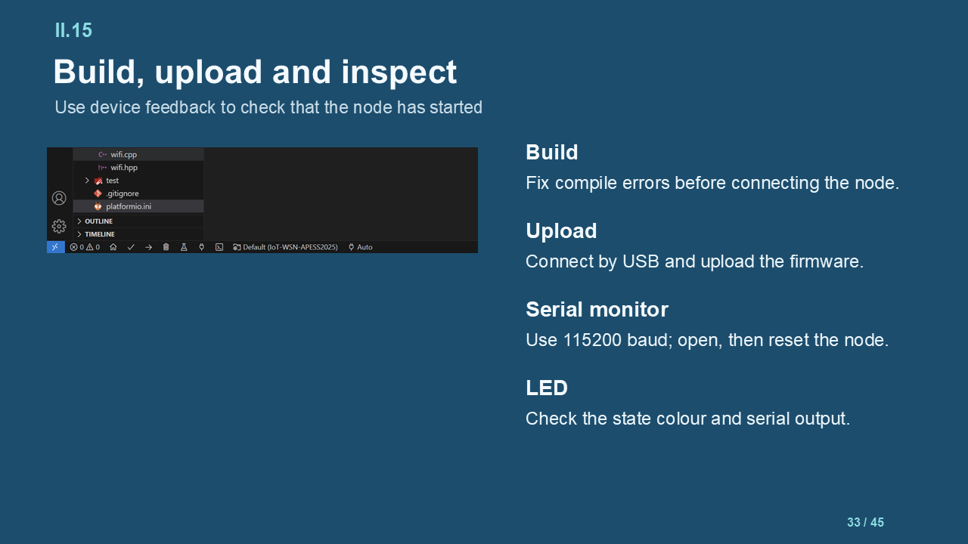
DEMO/.ppt-build/render-dark/slide-33.png
