Shuaiwen-Cui/ArduinoNode/DEMO/.ppt-build/render-dark/slide-34.png

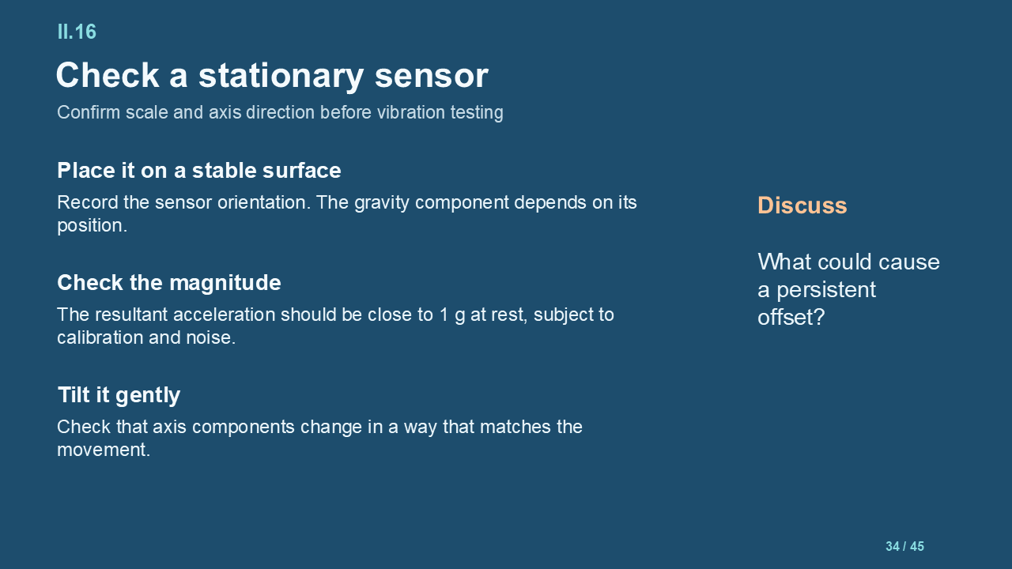
DEMO/.ppt-build/render-dark/slide-34.png
