Shuaiwen-Cui/ArduinoNode/DEMO/.ppt-build/render-dark/slide-41.png

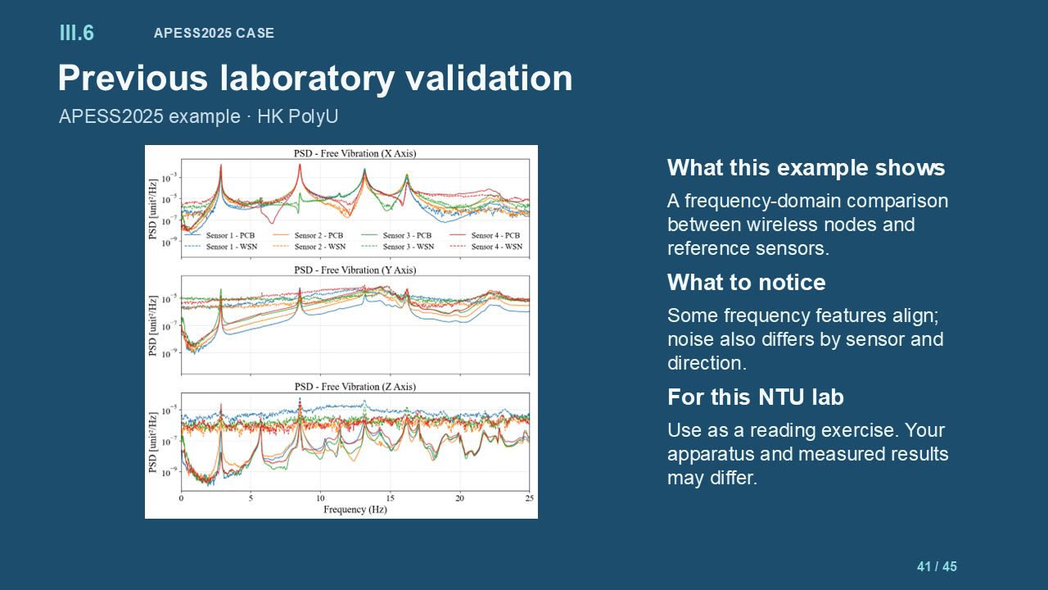
DEMO/.ppt-build/render-dark/slide-41.png
