Shuaiwen-Cui/ArduinoNode/DEMO/.ppt-build/render-dark/slide-42.png

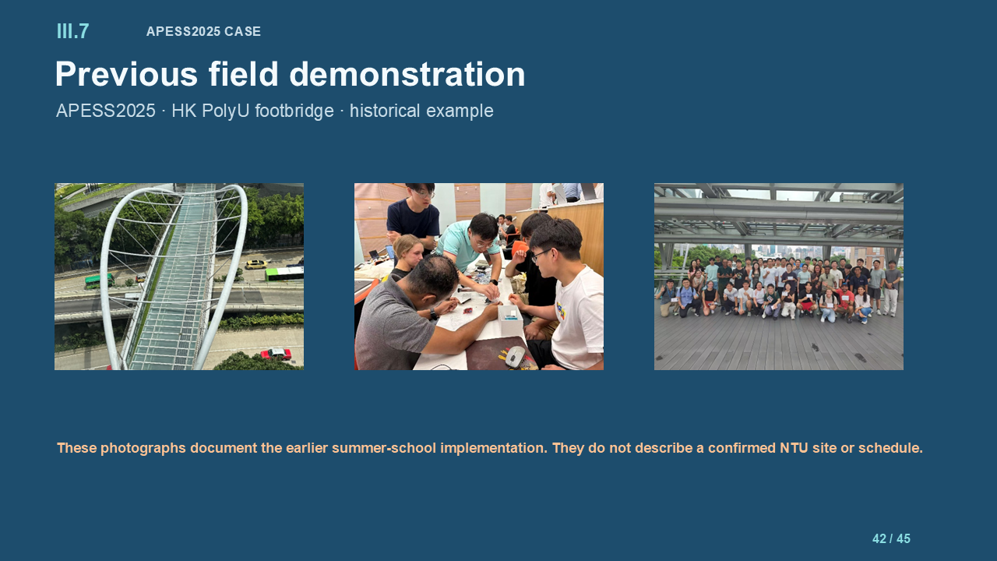
DEMO/.ppt-build/render-dark/slide-42.png
