Shuaiwen-Cui/ArduinoNode/DEMO/.ppt-build/render-dark/slide-43.png

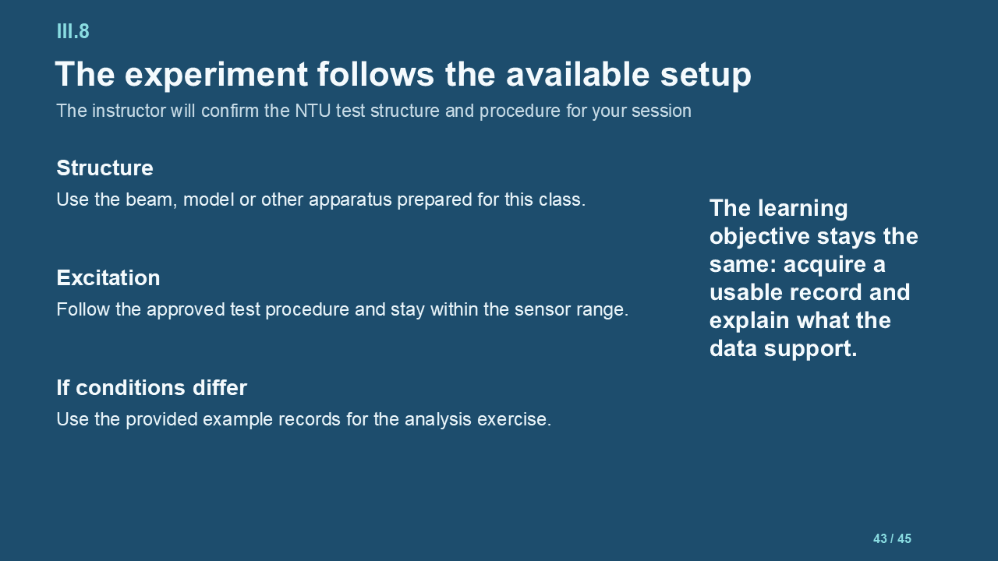
DEMO/.ppt-build/render-dark/slide-43.png
