Shuaiwen-Cui/ArduinoNode/DEMO/.ppt-build/render-faithful/contact-1-16.png

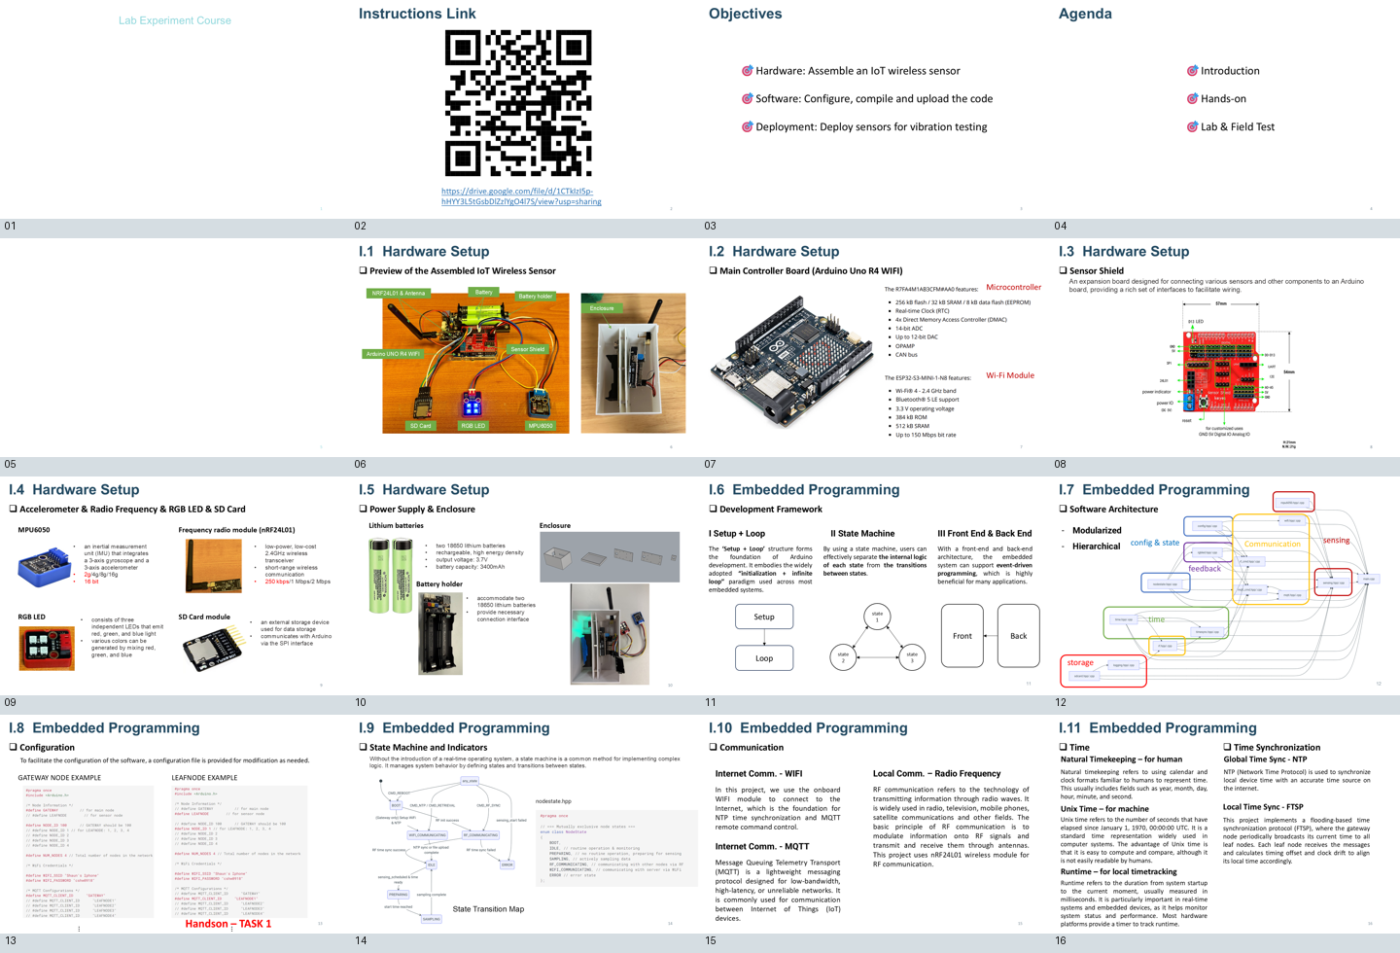
DEMO/.ppt-build/render-faithful/contact-1-16.png
