Shuaiwen-Cui/ArduinoNode/DEMO/.ppt-build/render-faithful/contact-17-32.png

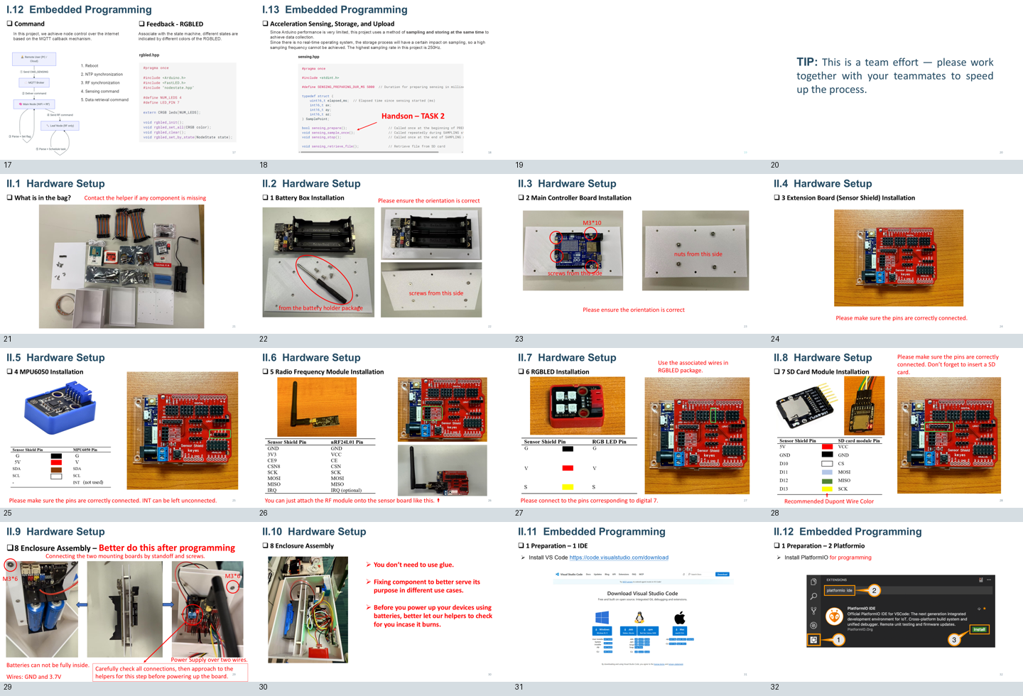
DEMO/.ppt-build/render-faithful/contact-17-32.png
