Shuaiwen-Cui/ArduinoNode/DEMO/.ppt-build/render-faithful/slide-2.png

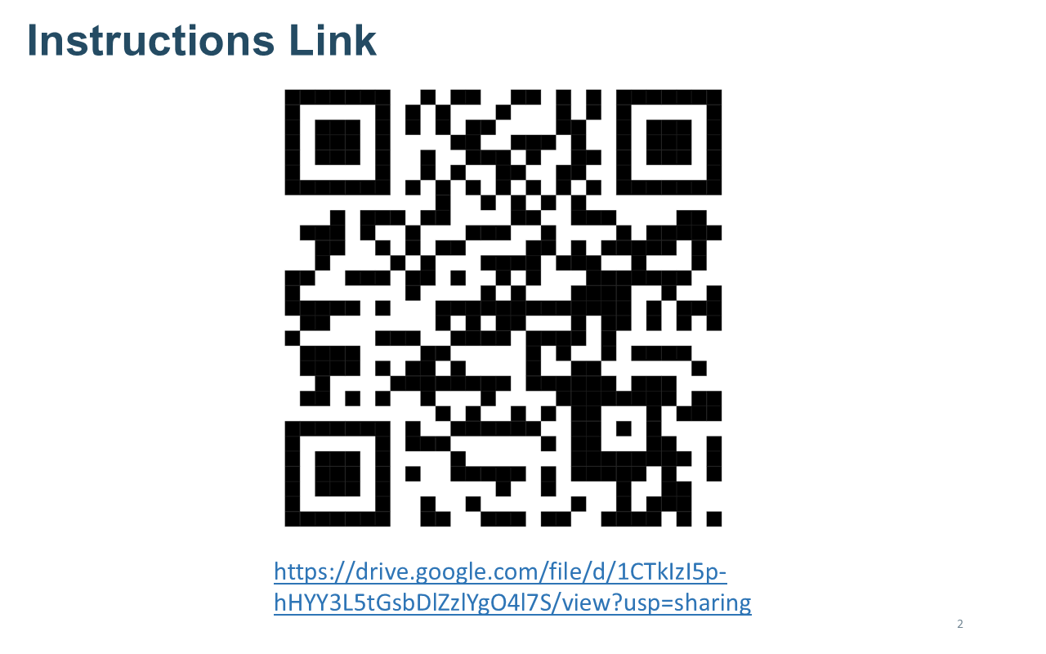
DEMO/.ppt-build/render-faithful/slide-2.png
