Shuaiwen-Cui/ArduinoNode/DEMO/.ppt-build/render-faithful/slide-3.png

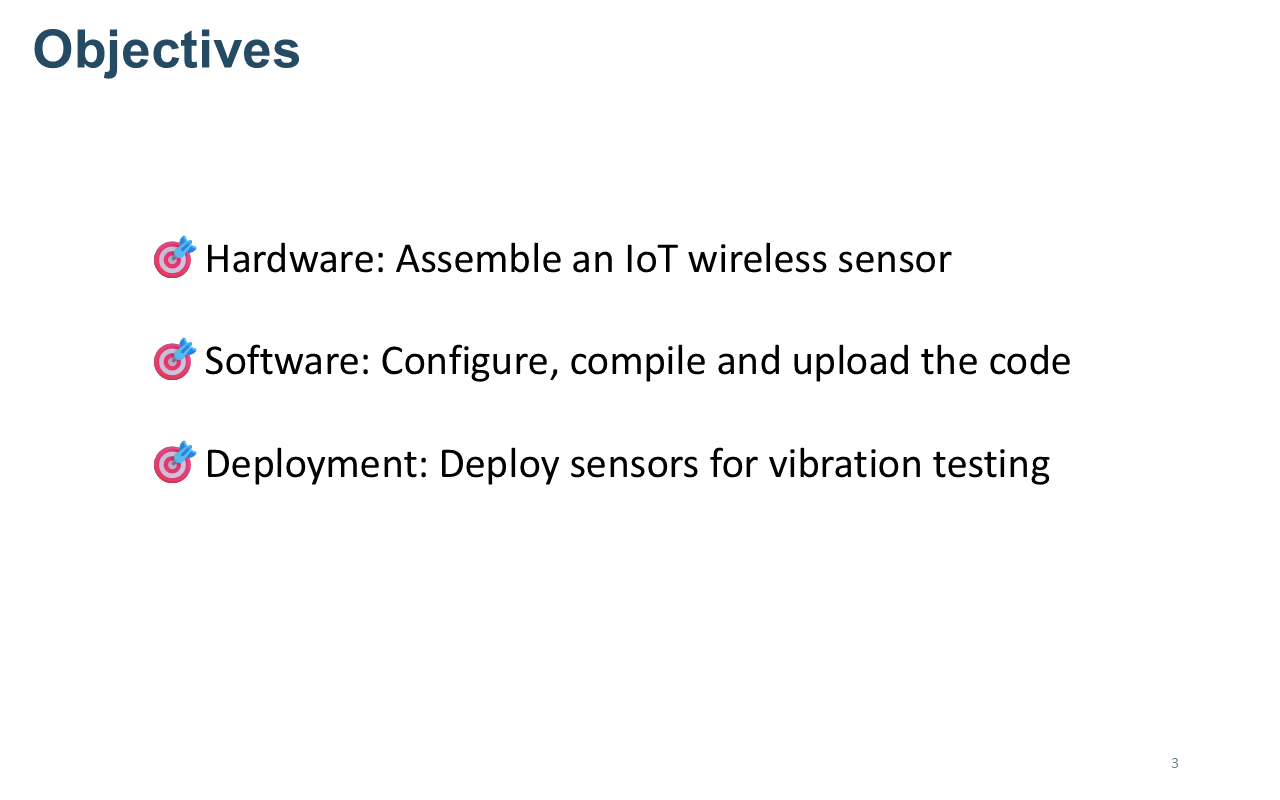
DEMO/.ppt-build/render-faithful/slide-3.png
