Shuaiwen-Cui/ArduinoNode/DEMO/.ppt-build/render-faithful/slide-5.png

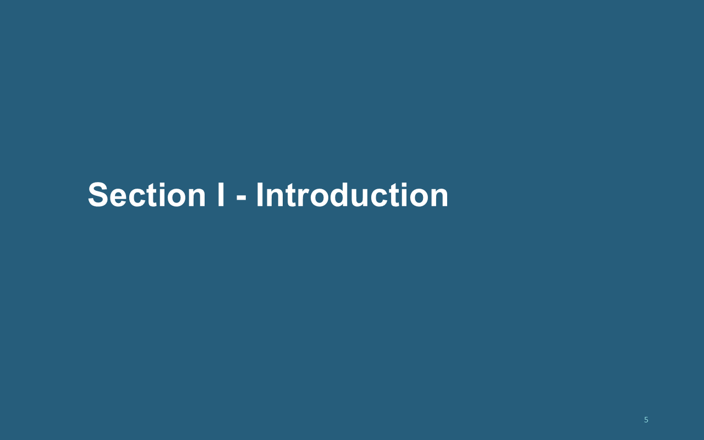
DEMO/.ppt-build/render-faithful/slide-5.png
