Shuaiwen-Cui/ArduinoNode/DEMO/.ppt-build/render-faithful/slide-6.png

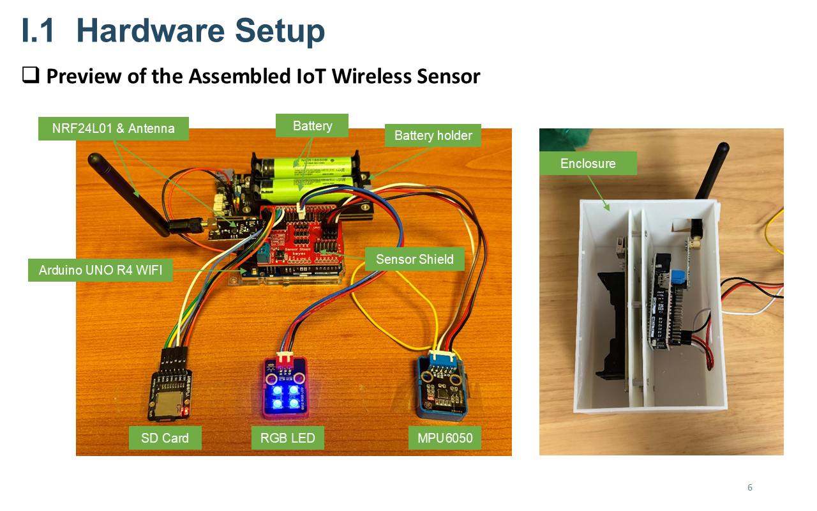
DEMO/.ppt-build/render-faithful/slide-6.png
