Shuaiwen-Cui/ArduinoNode/DEMO/.ppt-build/render-faithful/slide-8.png

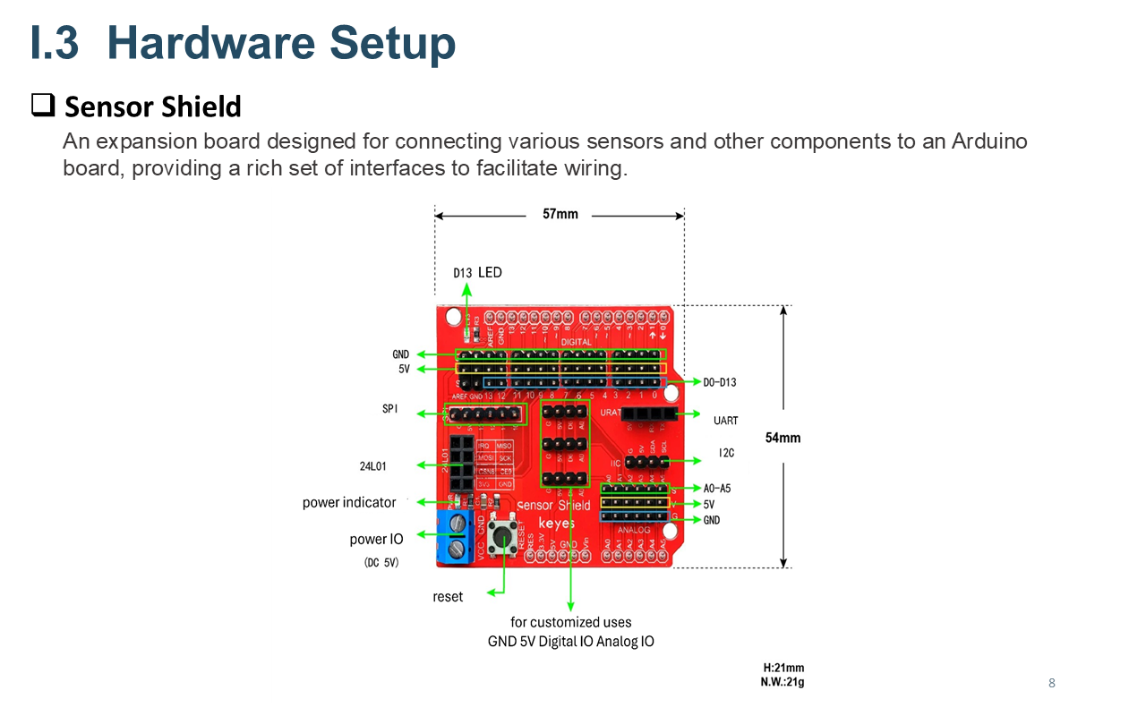
DEMO/.ppt-build/render-faithful/slide-8.png
