Shuaiwen-Cui/ArduinoNode/DEMO/.ppt-build/render-faithful/slide-10.png

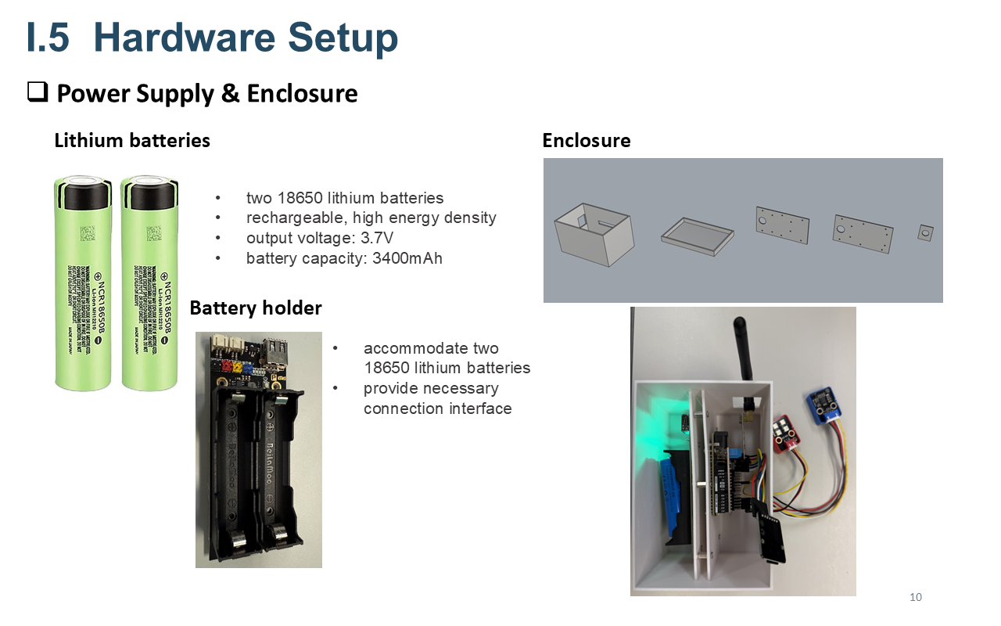
DEMO/.ppt-build/render-faithful/slide-10.png
