Shuaiwen-Cui/ArduinoNode/DEMO/.ppt-build/render-faithful/slide-12.png

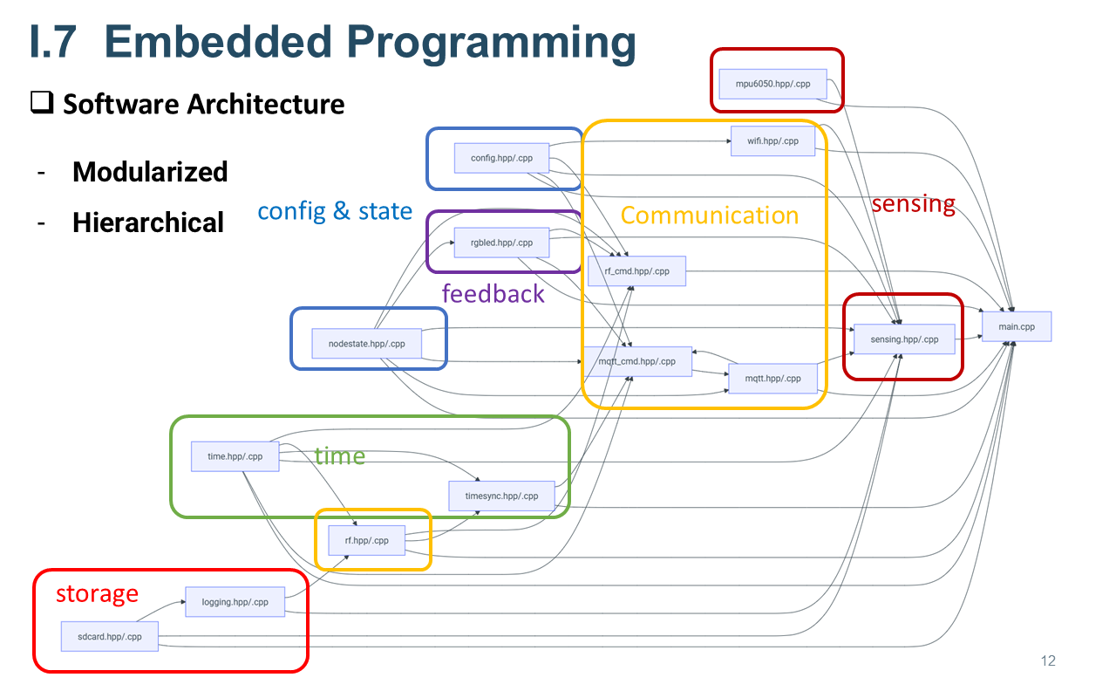
DEMO/.ppt-build/render-faithful/slide-12.png
