Shuaiwen-Cui/ArduinoNode/DEMO/.ppt-build/render-faithful/slide-14.png

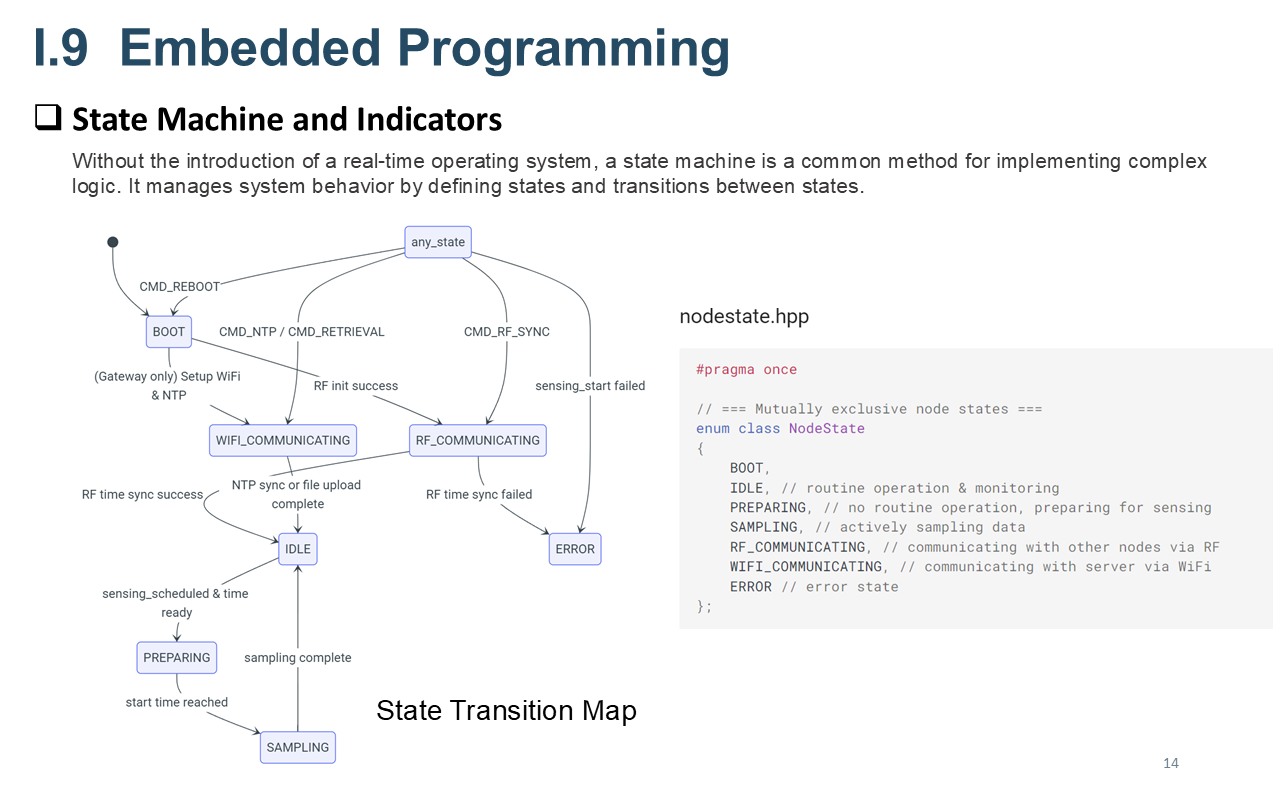
DEMO/.ppt-build/render-faithful/slide-14.png
