Shuaiwen-Cui/ArduinoNode/DEMO/.ppt-build/render-faithful/slide-15.png

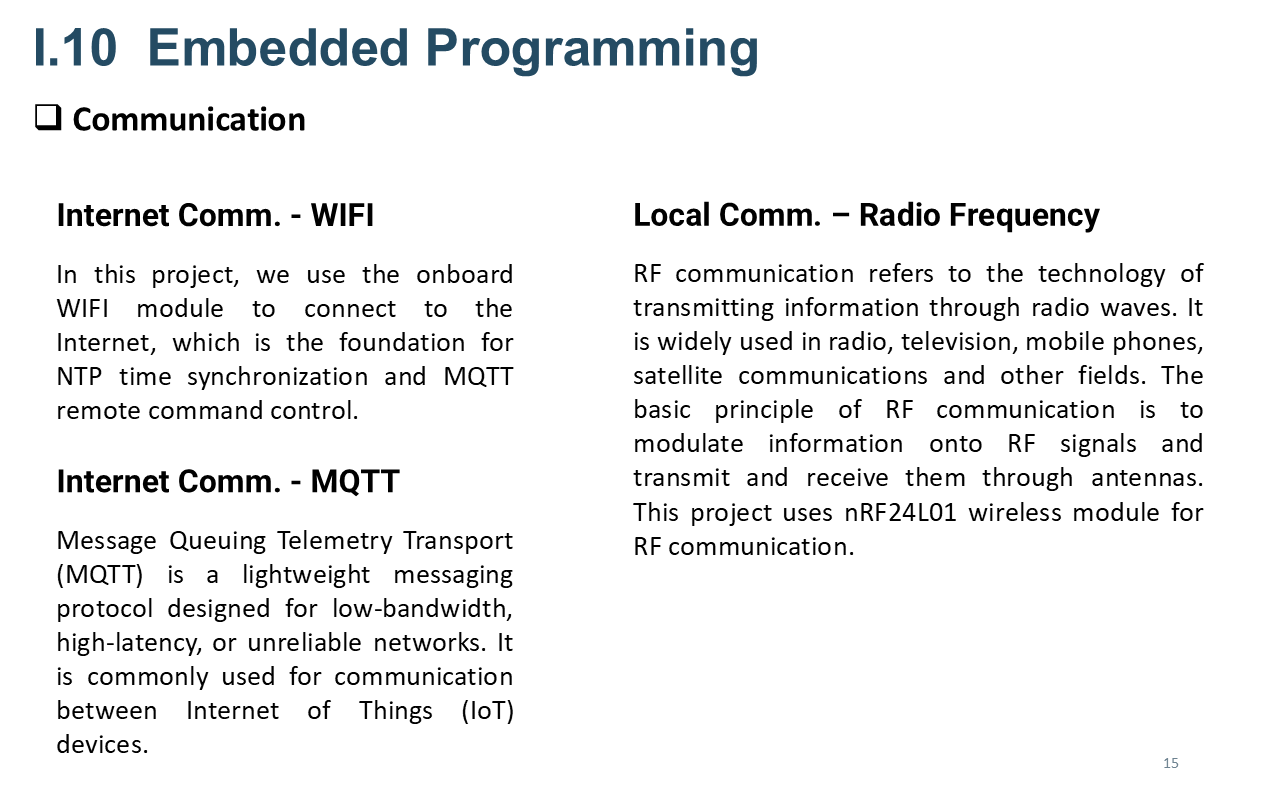
DEMO/.ppt-build/render-faithful/slide-15.png
