Shuaiwen-Cui/ArduinoNode/DEMO/.ppt-build/render-faithful/slide-16.png

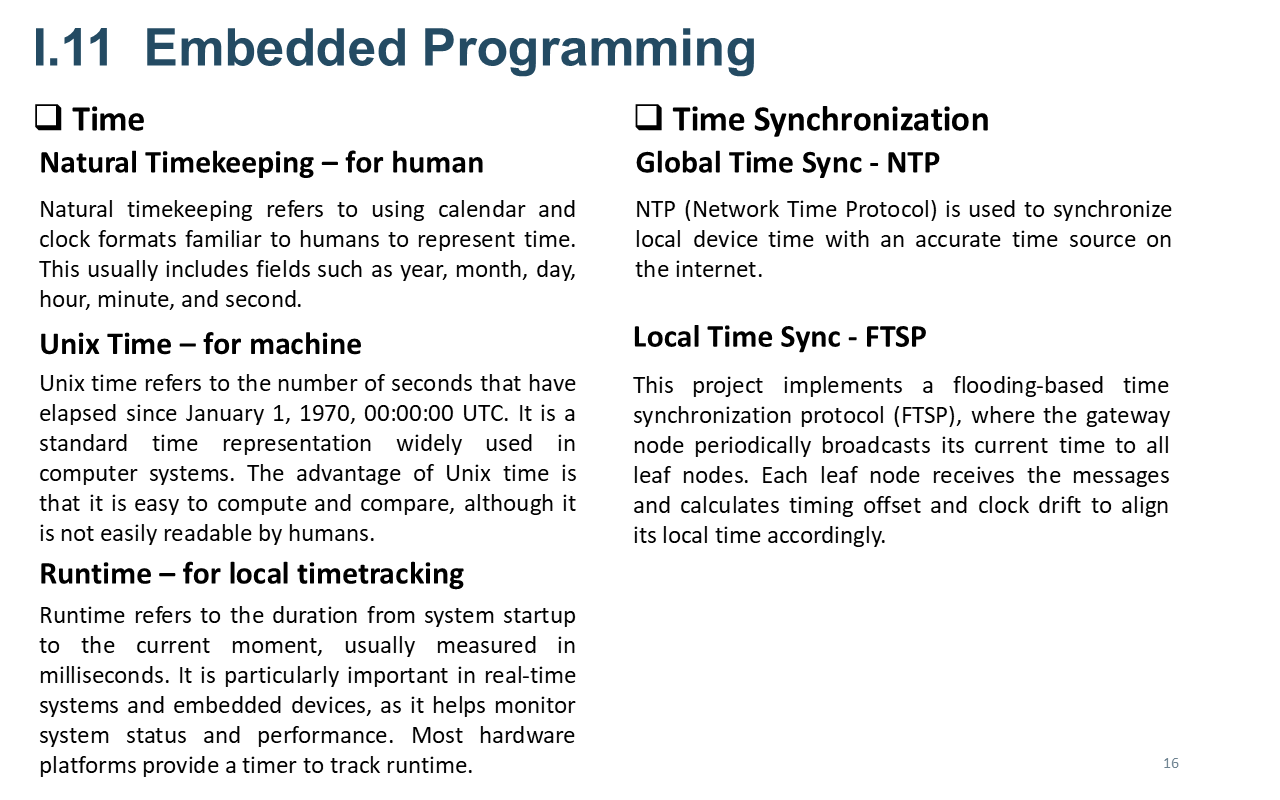
DEMO/.ppt-build/render-faithful/slide-16.png
