Shuaiwen-Cui/ArduinoNode/DEMO/.ppt-build/render-faithful/slide-18.png

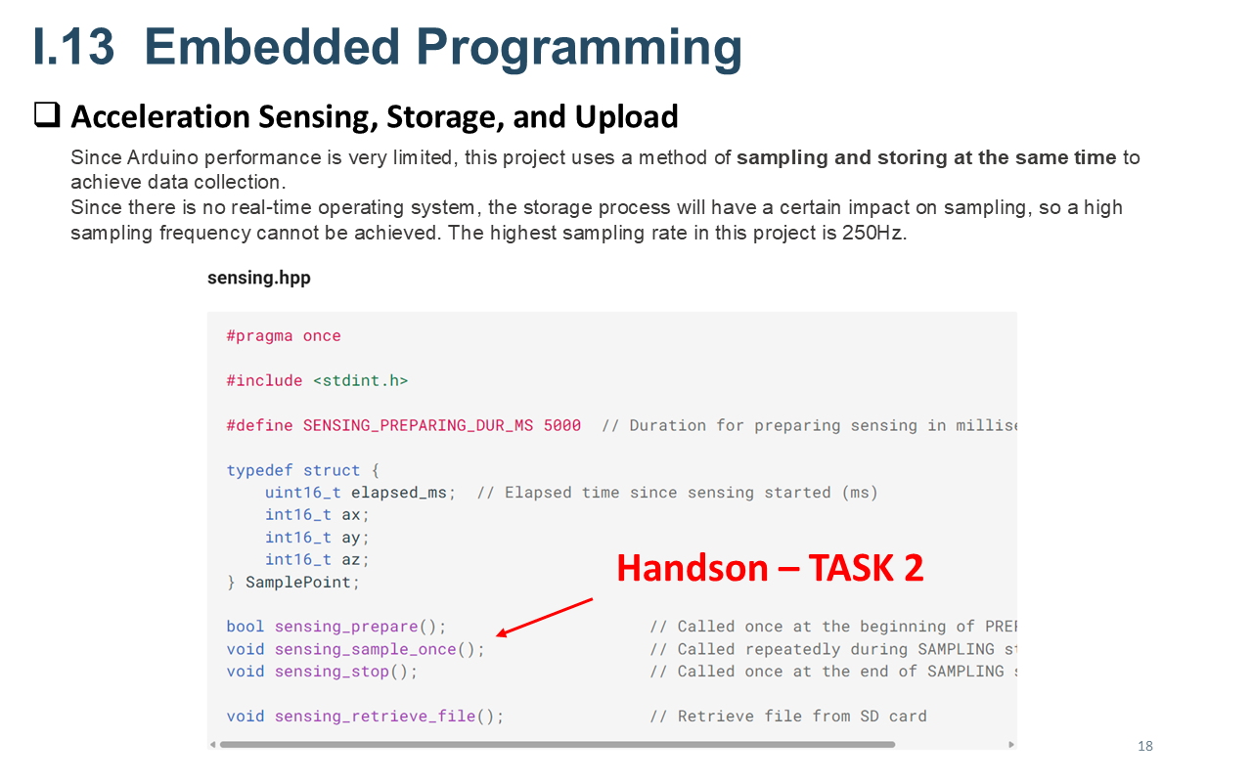
DEMO/.ppt-build/render-faithful/slide-18.png
