Shuaiwen-Cui/ArduinoNode/DEMO/.ppt-build/render-faithful/slide-21.png

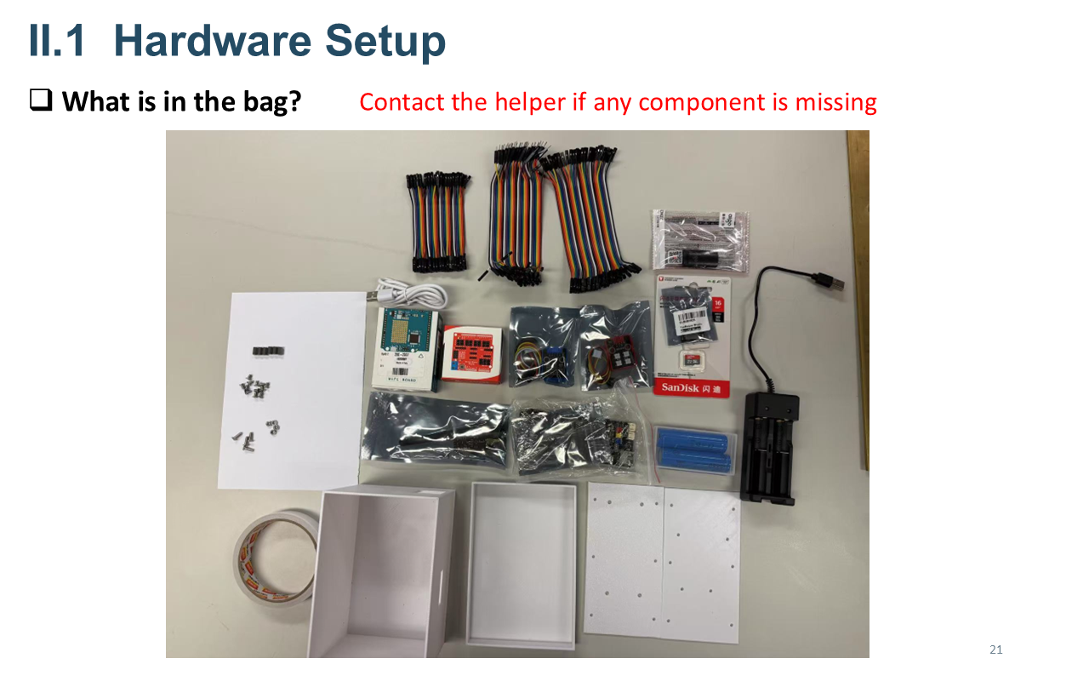
DEMO/.ppt-build/render-faithful/slide-21.png
