Shuaiwen-Cui/ArduinoNode/DEMO/.ppt-build/render-faithful/slide-23.png

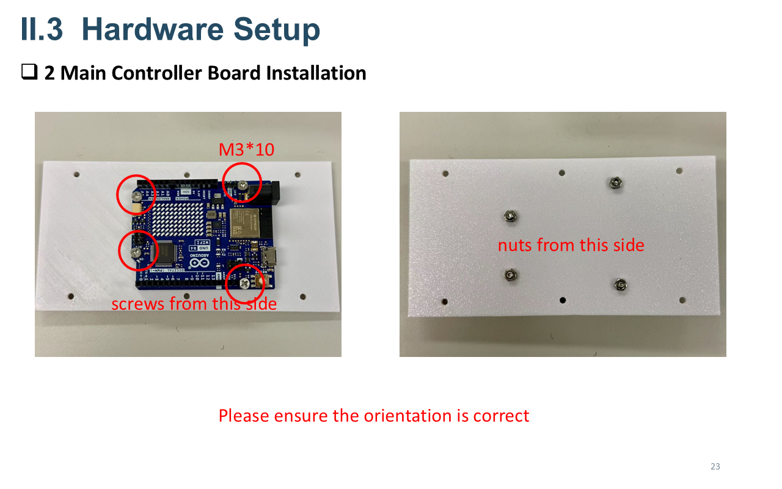
DEMO/.ppt-build/render-faithful/slide-23.png
