Shuaiwen-Cui/ArduinoNode/DEMO/.ppt-build/render-faithful/slide-24.png

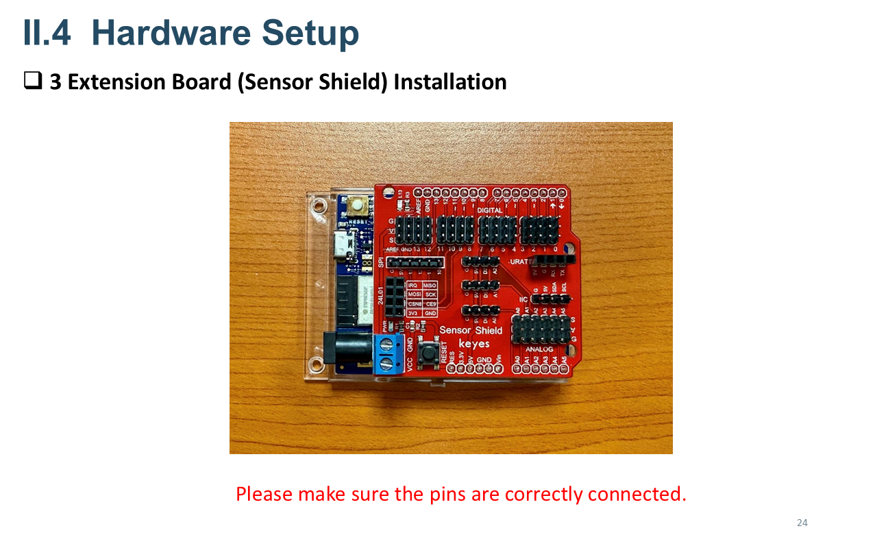
DEMO/.ppt-build/render-faithful/slide-24.png
