Shuaiwen-Cui/ArduinoNode/DEMO/.ppt-build/render-faithful/slide-25.png

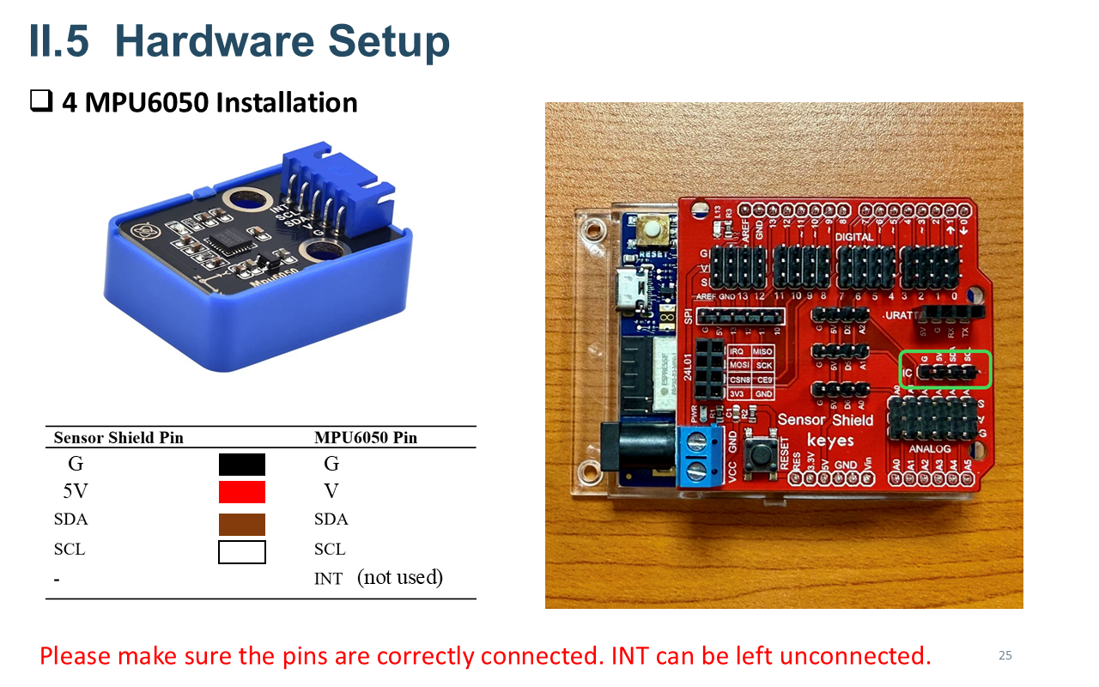
DEMO/.ppt-build/render-faithful/slide-25.png
