Shuaiwen-Cui/ArduinoNode/DEMO/.ppt-build/render-faithful/slide-26.png

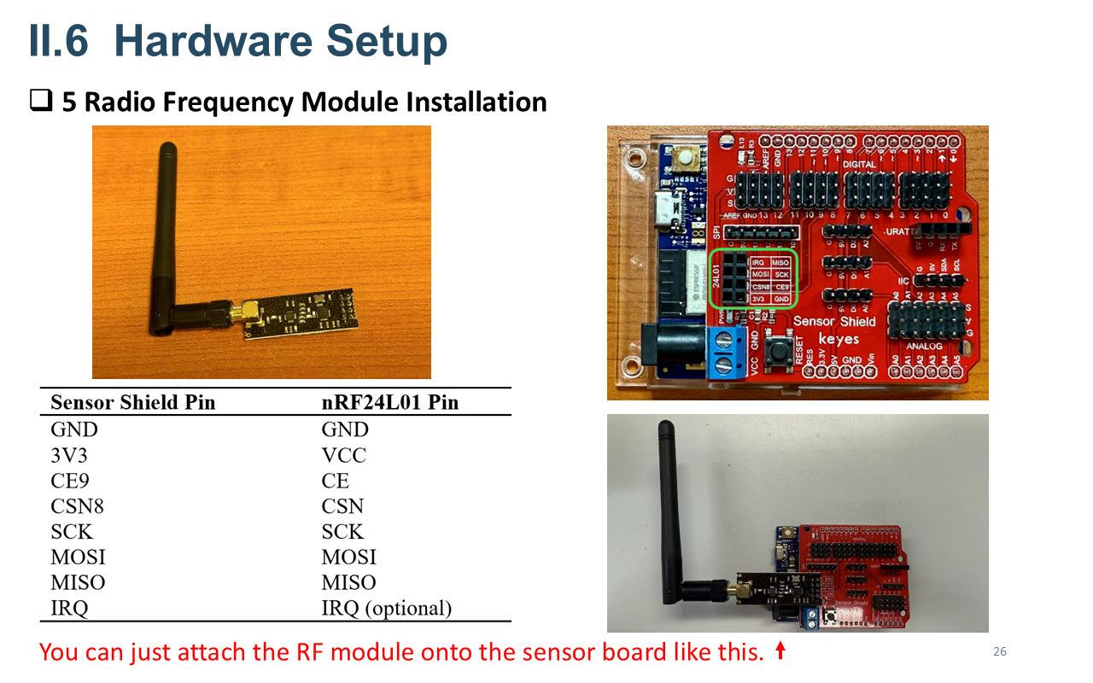
DEMO/.ppt-build/render-faithful/slide-26.png
