Shuaiwen-Cui/ArduinoNode/DEMO/.ppt-build/render-faithful/slide-29.png

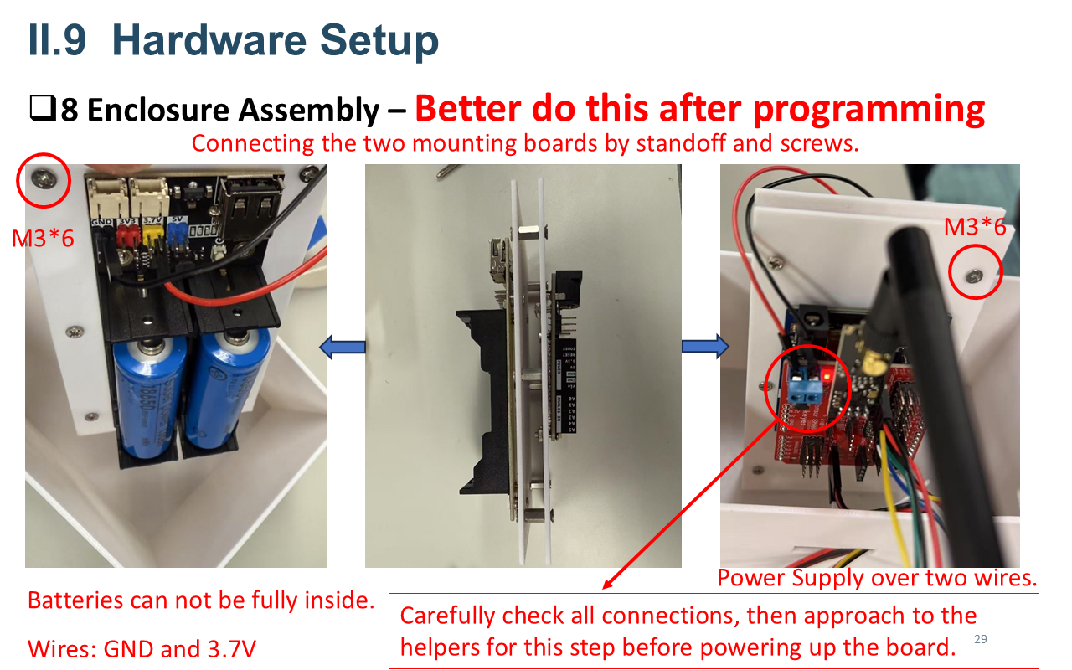
DEMO/.ppt-build/render-faithful/slide-29.png
