Shuaiwen-Cui/ArduinoNode/DEMO/.ppt-build/render-faithful/slide-31.png

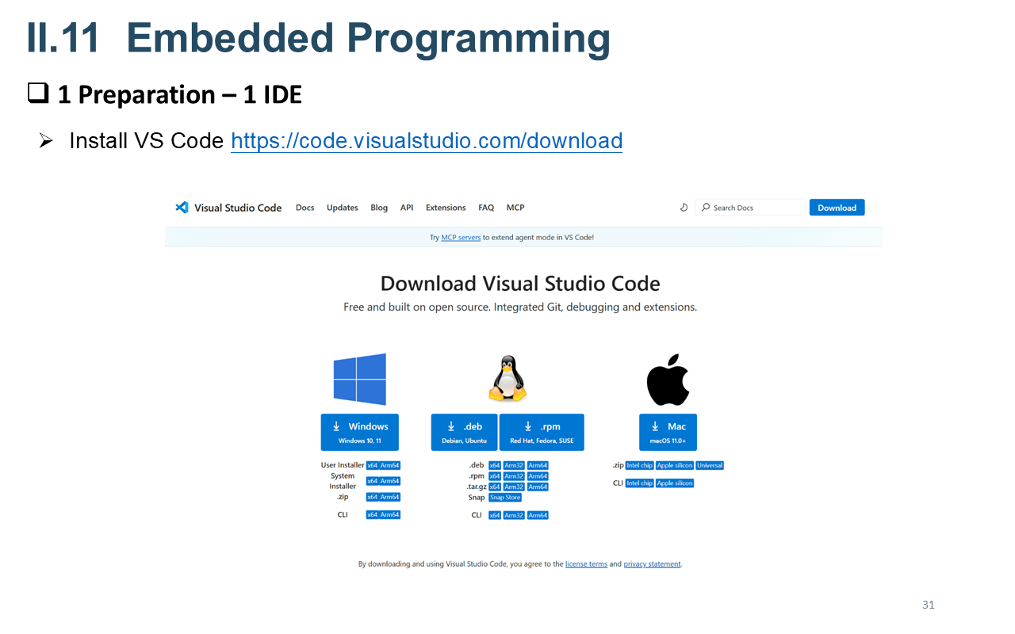
DEMO/.ppt-build/render-faithful/slide-31.png
