Shuaiwen-Cui/ArduinoNode/DEMO/.ppt-build/render-faithful/slide-32.png

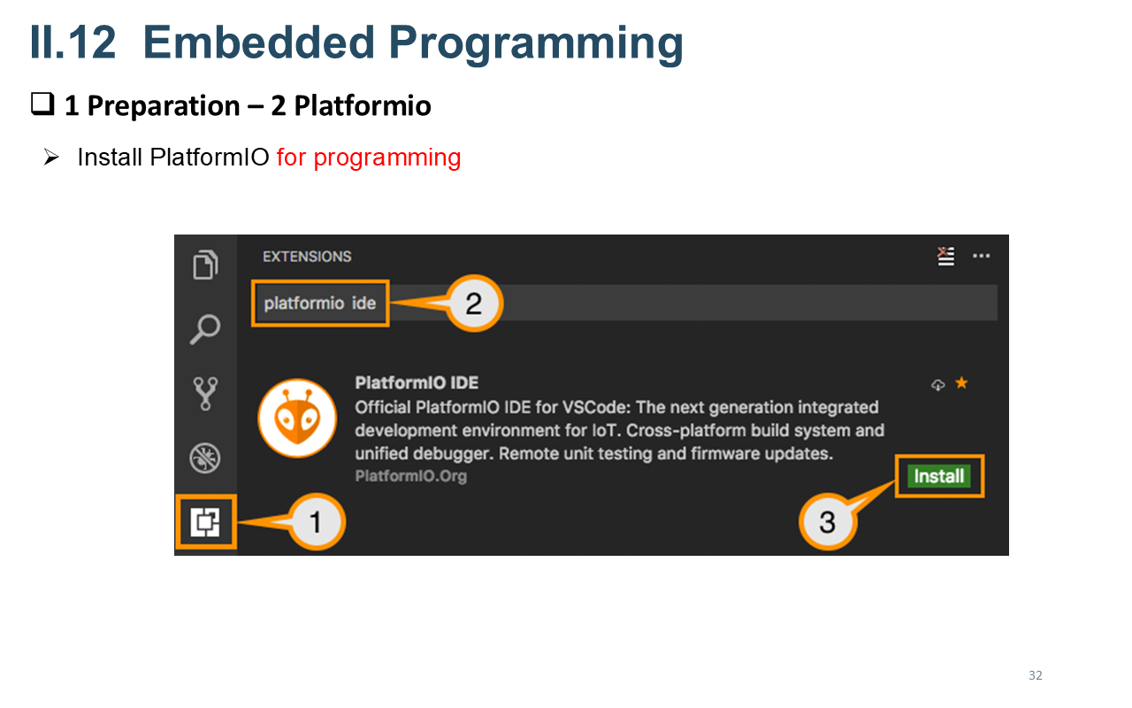
DEMO/.ppt-build/render-faithful/slide-32.png
