Shuaiwen-Cui/ArduinoNode/DEMO/.ppt-build/render-faithful/slide-36.png

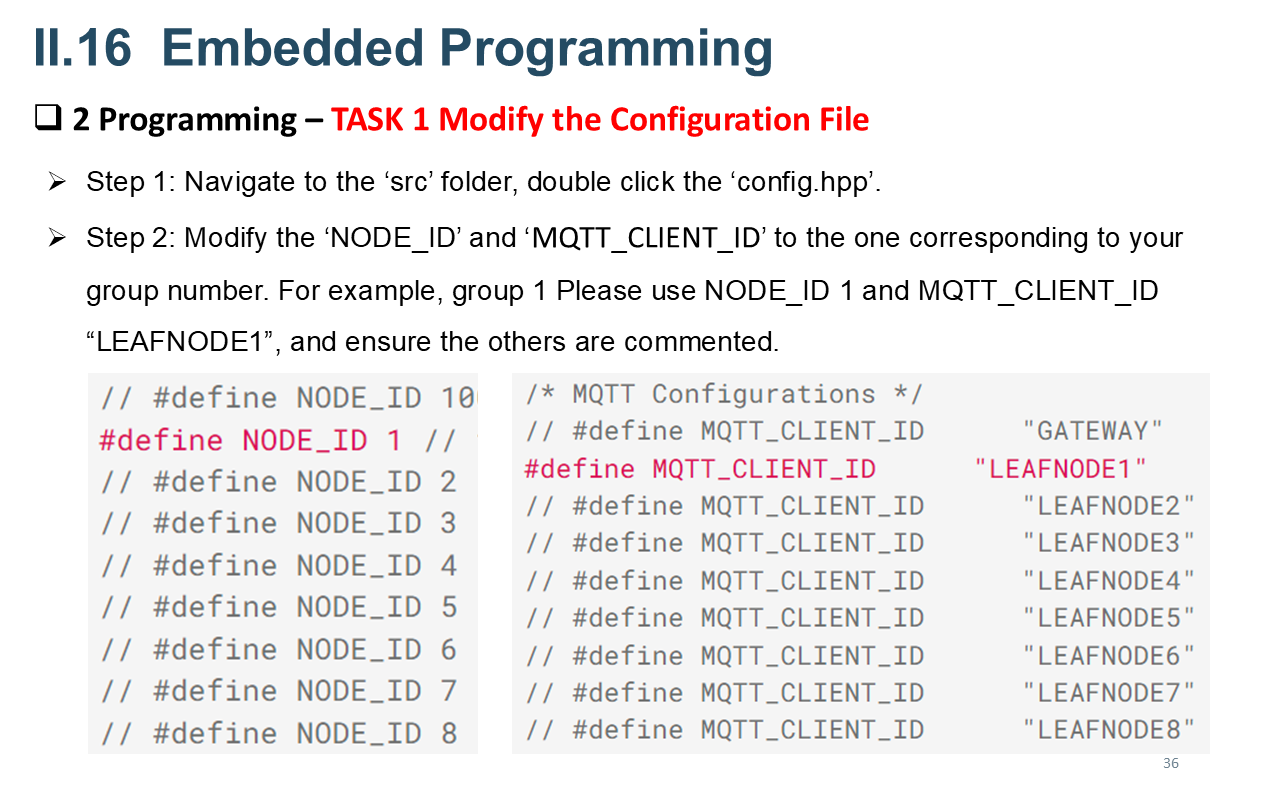
DEMO/.ppt-build/render-faithful/slide-36.png
