Shuaiwen-Cui/ArduinoNode/DEMO/.ppt-build/render-faithful/slide-37.png

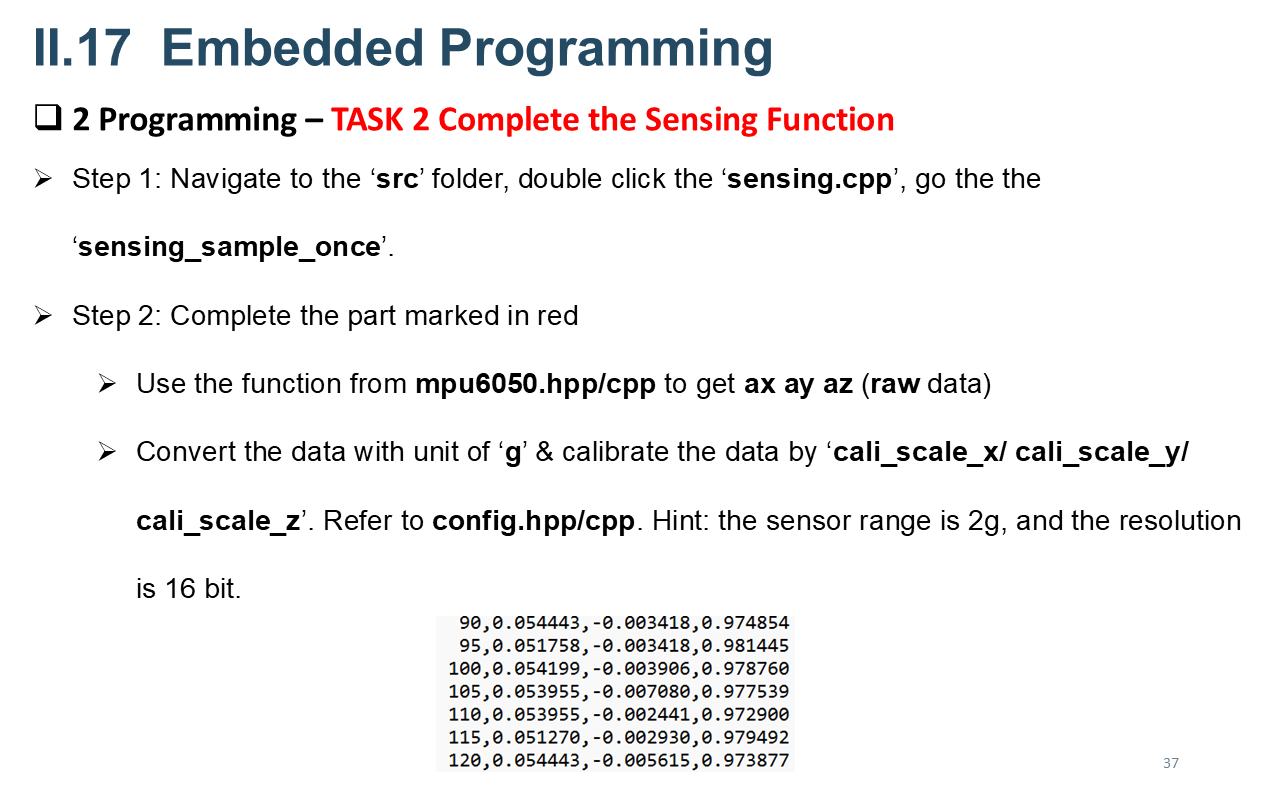
DEMO/.ppt-build/render-faithful/slide-37.png
