Shuaiwen-Cui/ArduinoNode/DEMO/.ppt-build/render-faithful/slide-39.png

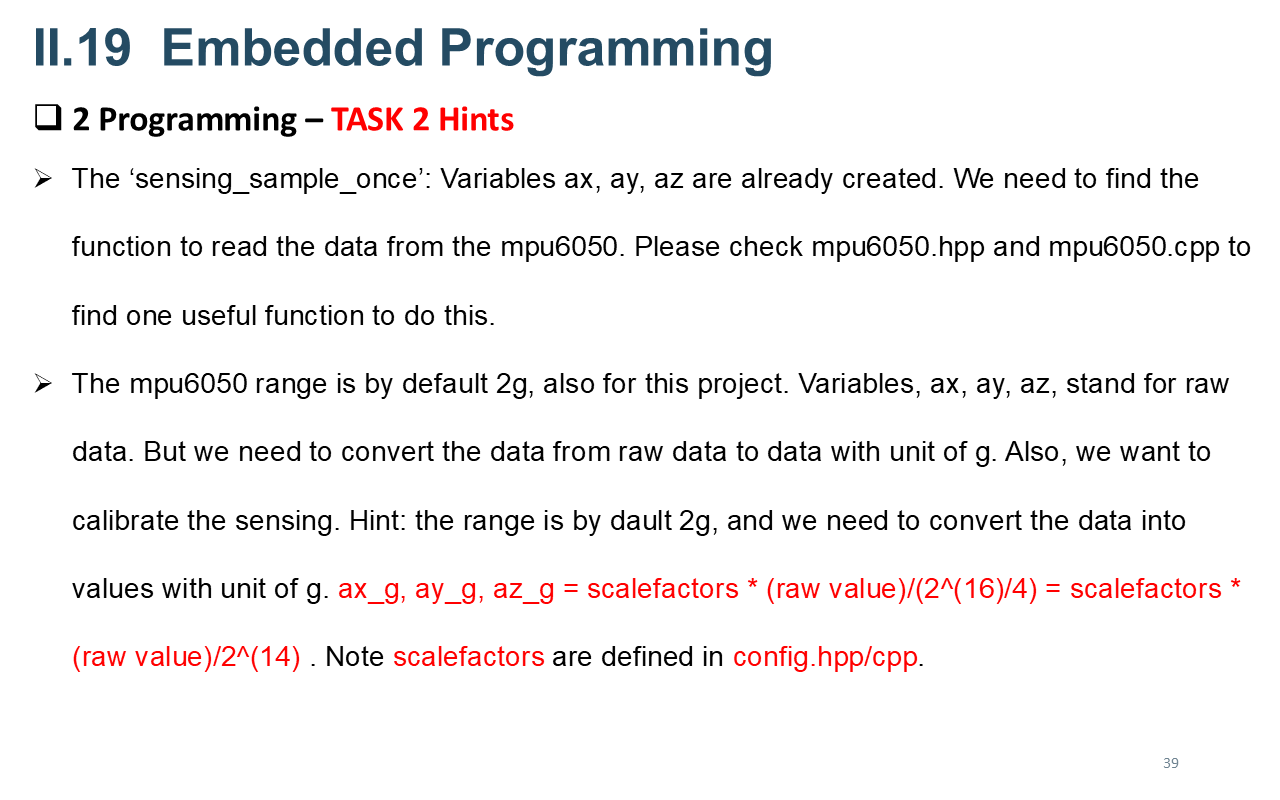
DEMO/.ppt-build/render-faithful/slide-39.png
