Shuaiwen-Cui/ArduinoNode/DEMO/.ppt-build/render-faithful/slide-40.png

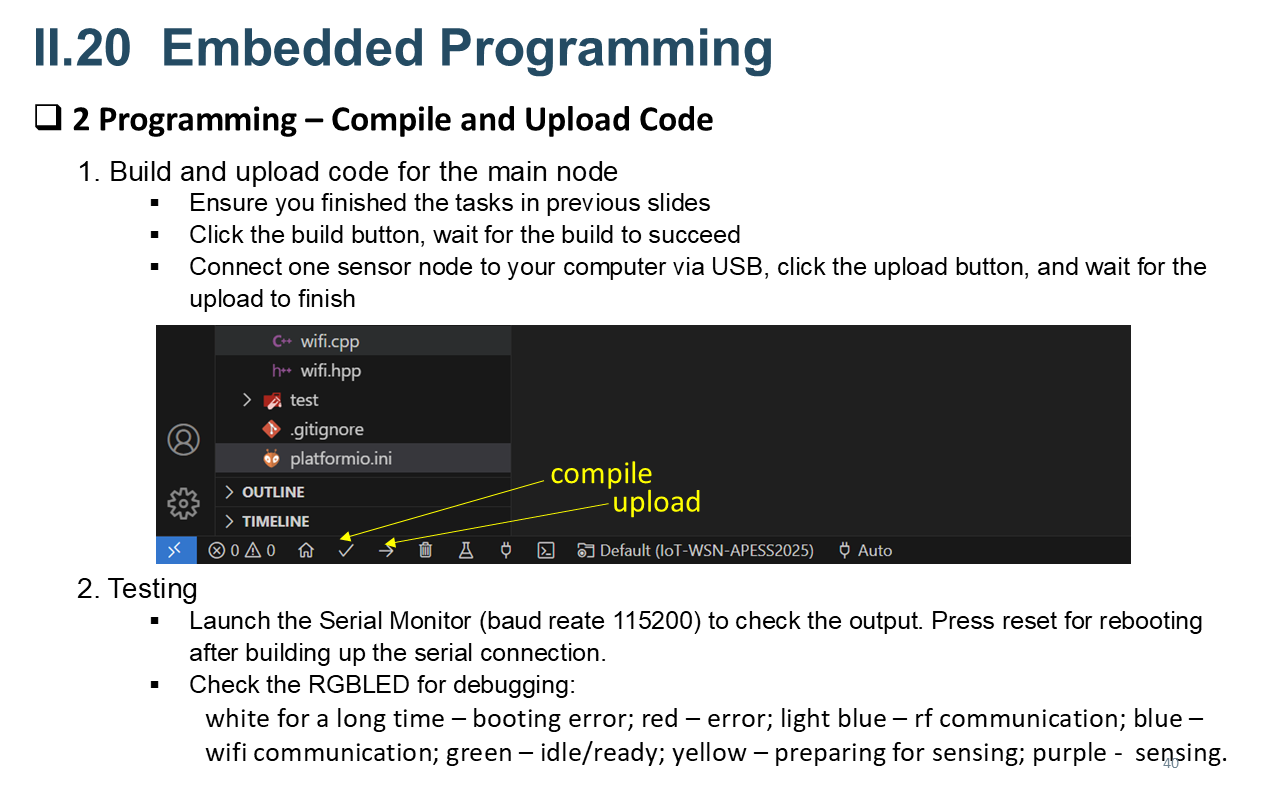
DEMO/.ppt-build/render-faithful/slide-40.png
