Shuaiwen-Cui/ArduinoNode/DEMO/.ppt-build/render-faithful/slide-42.png

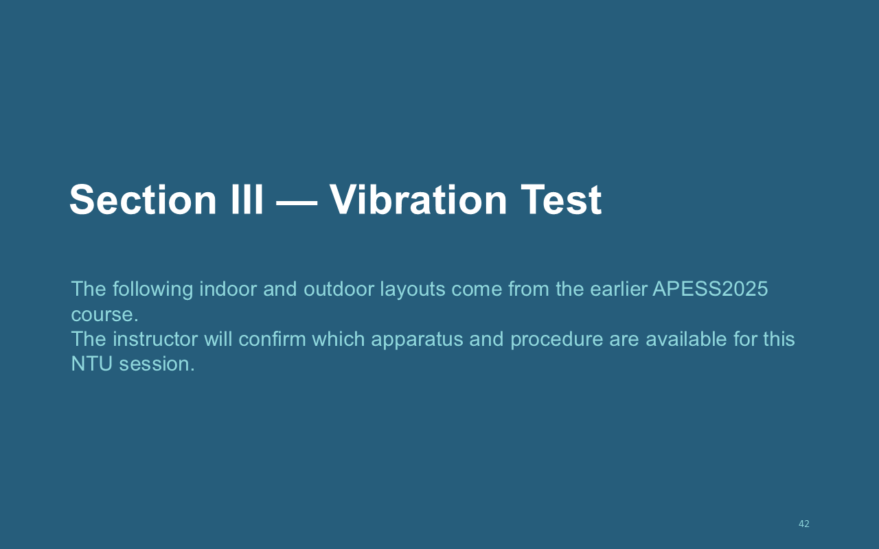
DEMO/.ppt-build/render-faithful/slide-42.png
