Shuaiwen-Cui/ArduinoNode/DEMO/.ppt-build/render-faithful/slide-43.png

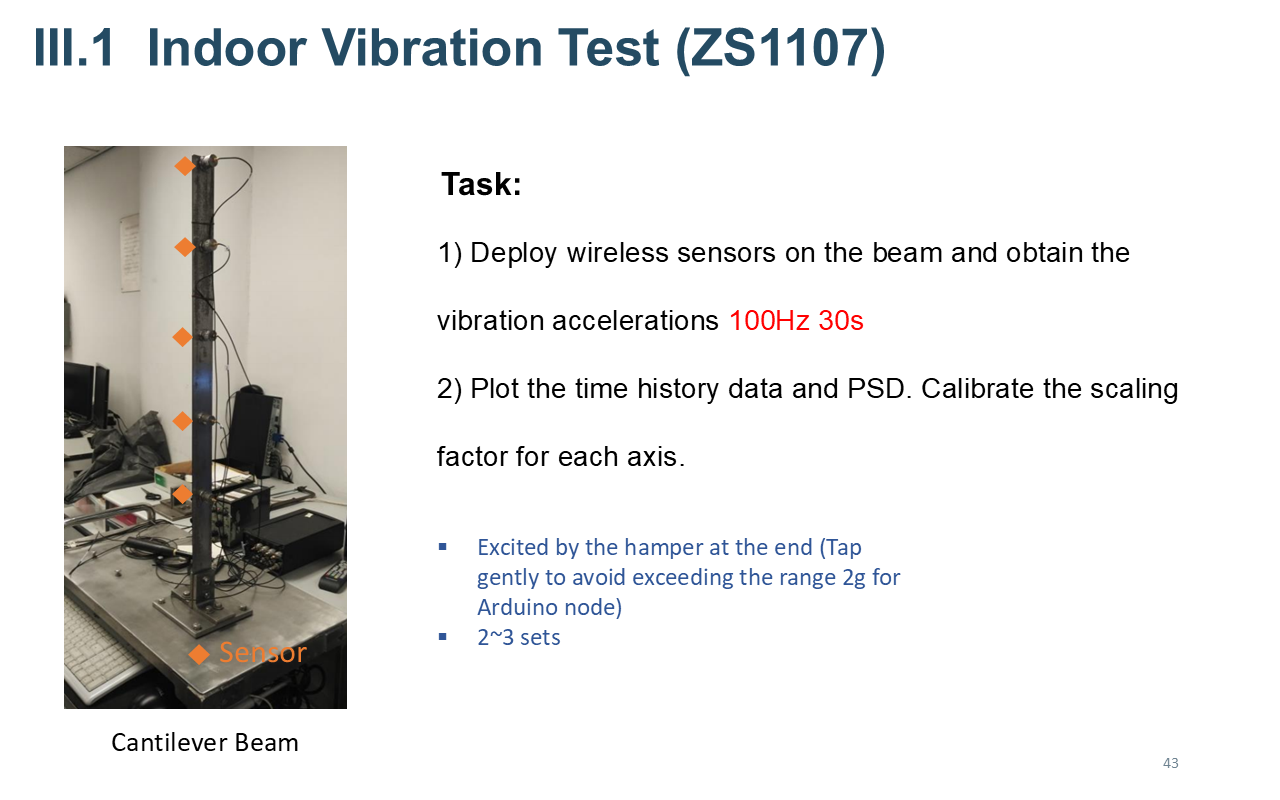
DEMO/.ppt-build/render-faithful/slide-43.png
