Shuaiwen-Cui/ArduinoNode/DEMO/.ppt-build/render-faithful/slide-44.png

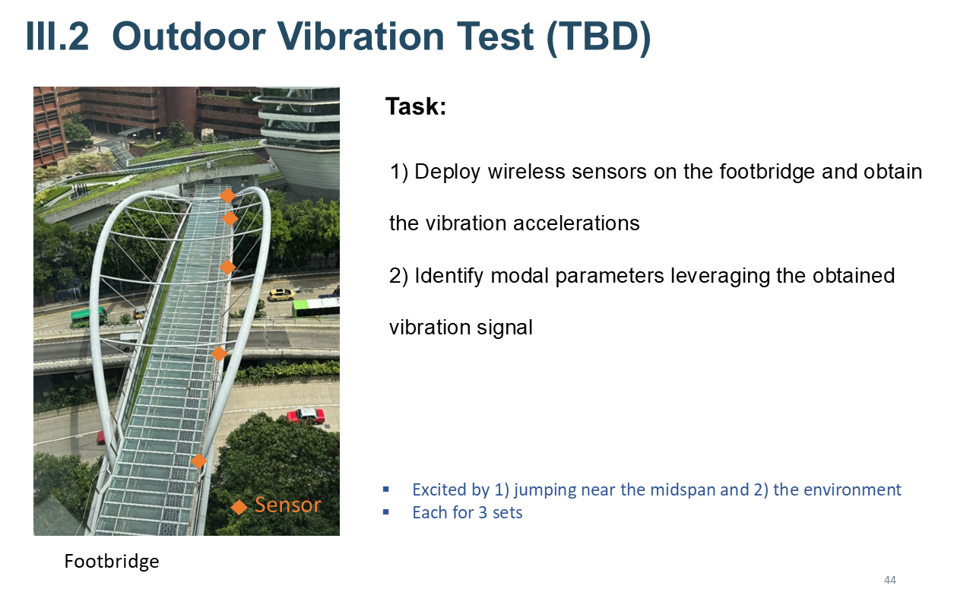
DEMO/.ppt-build/render-faithful/slide-44.png
