Shuaiwen-Cui/ArduinoNode/DEMO/.ppt-build/render-faithful/slide-45.png

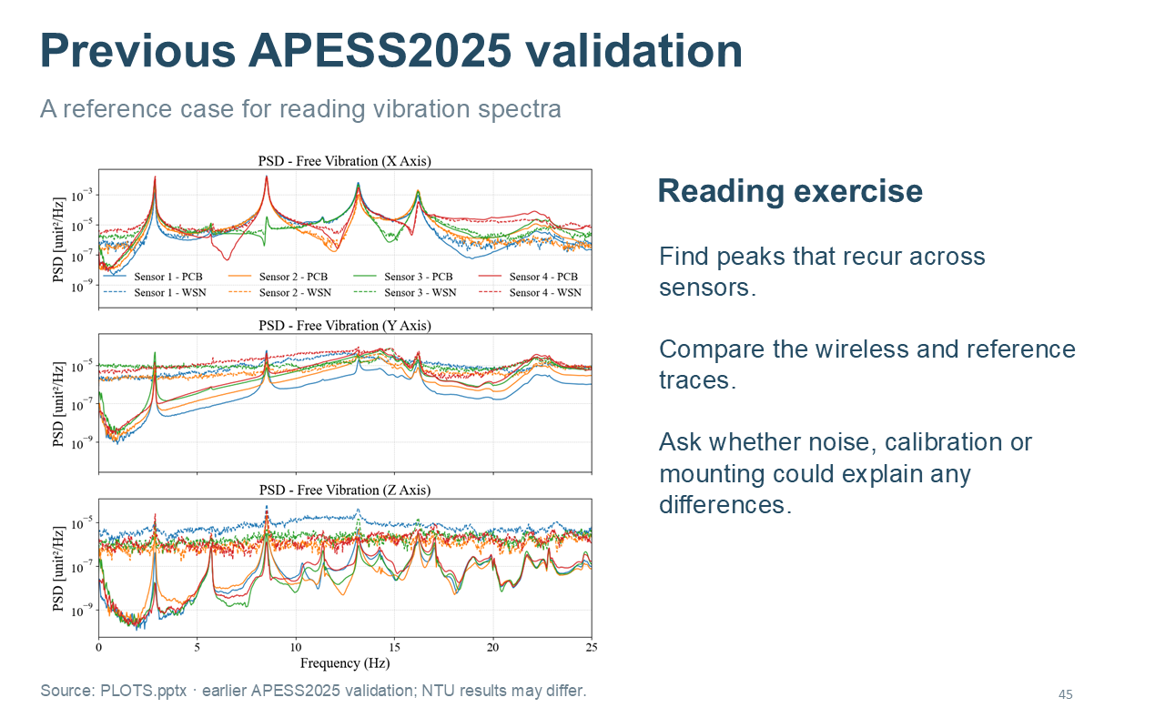
DEMO/.ppt-build/render-faithful/slide-45.png
