Shuaiwen-Cui/ArduinoNode/DEMO/.ppt-build/render-faithful/slide-46.png

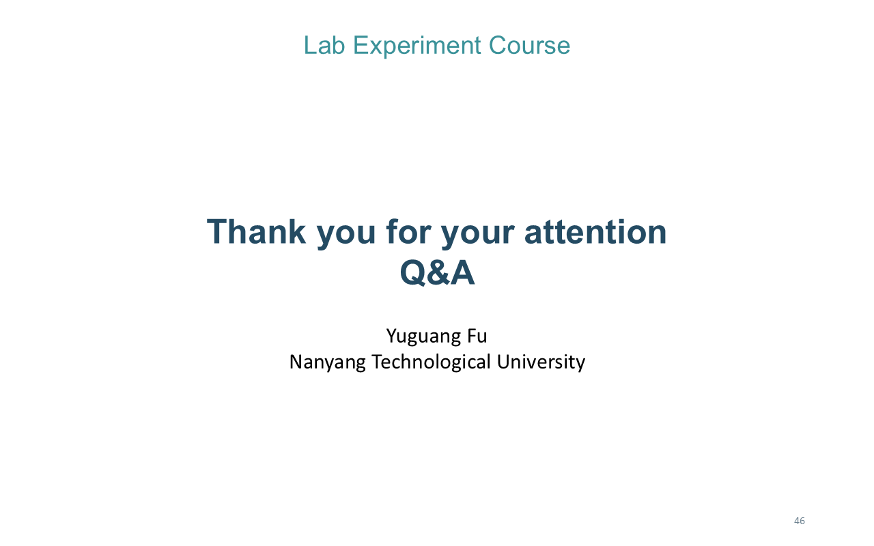
DEMO/.ppt-build/render-faithful/slide-46.png
