Shuaiwen-Cui/ArduinoNode/DEMO/.ppt-build/render-minimal/contact-16-30.png

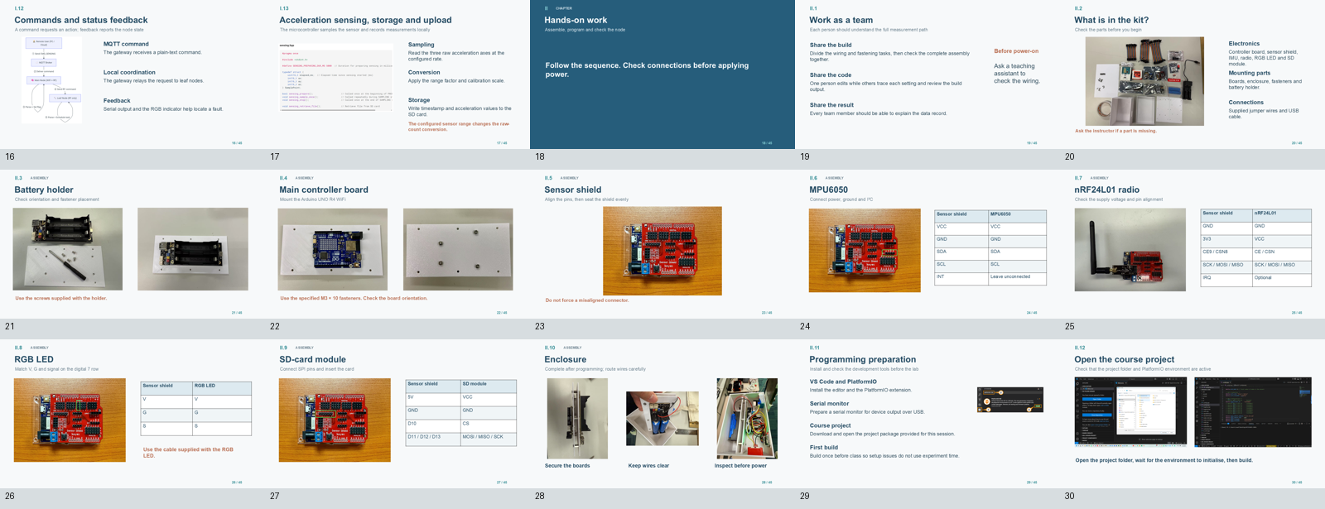
DEMO/.ppt-build/render-minimal/contact-16-30.png
