Shuaiwen-Cui/ArduinoNode/DEMO/.ppt-build/render-minimal/contact-31-45.png

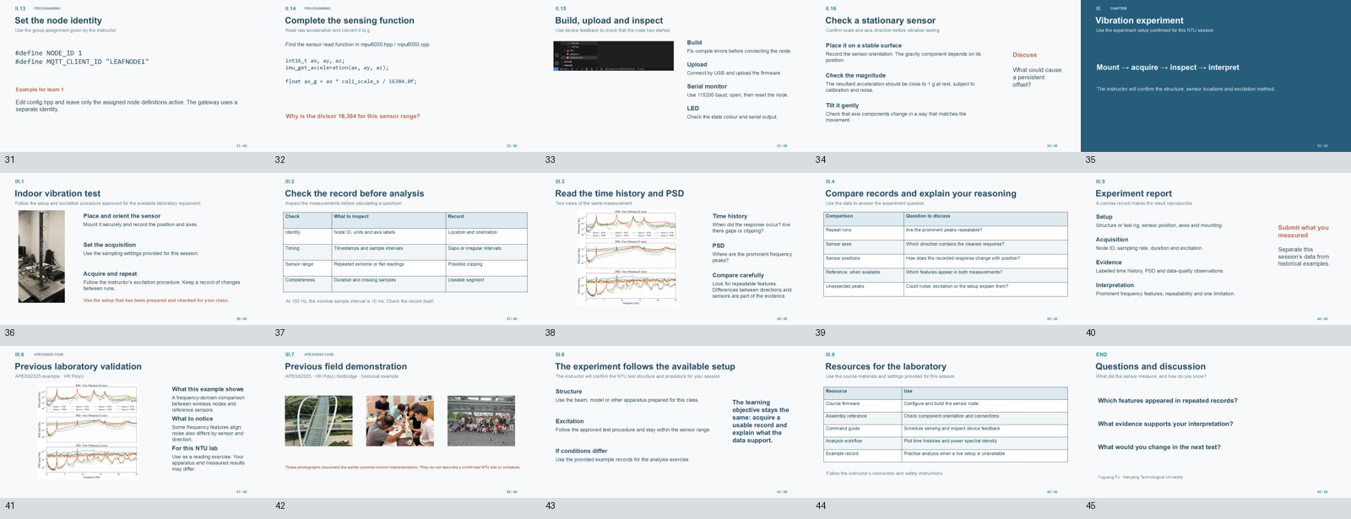
DEMO/.ppt-build/render-minimal/contact-31-45.png
