Shuaiwen-Cui/ArduinoNode/DEMO/.ppt-build/render-minimal/slide-2.png

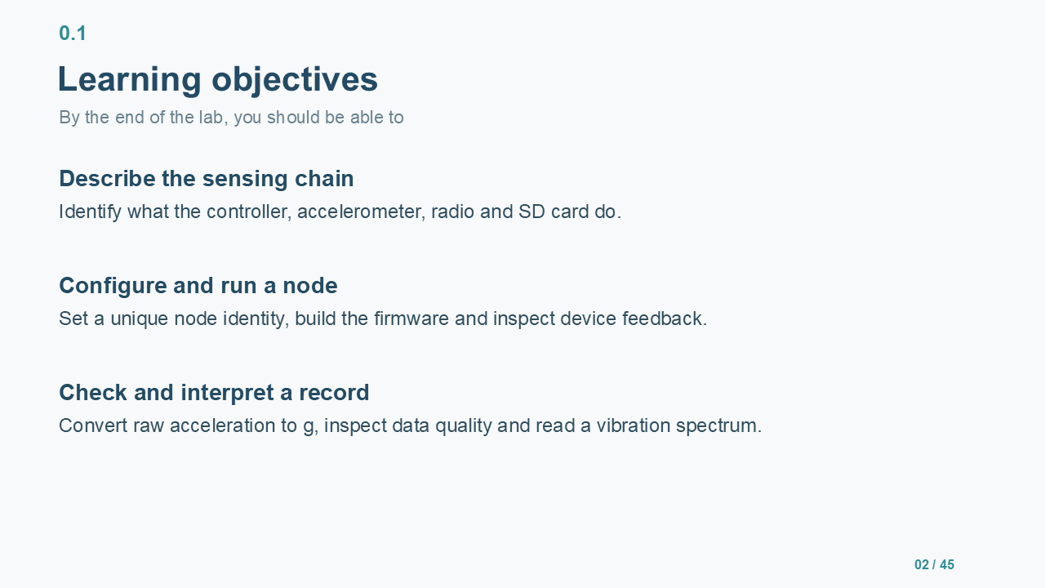
DEMO/.ppt-build/render-minimal/slide-2.png
