Shuaiwen-Cui/ArduinoNode/DEMO/.ppt-build/render-minimal/slide-4.png

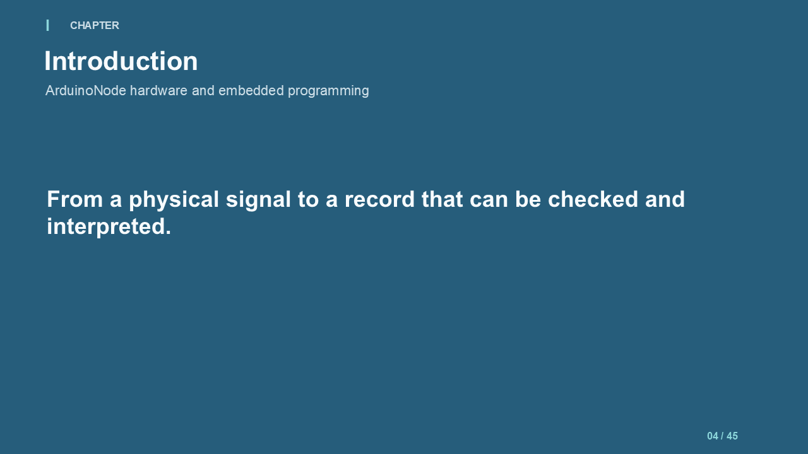
DEMO/.ppt-build/render-minimal/slide-4.png
