Shuaiwen-Cui/ArduinoNode/DEMO/.ppt-build/render-minimal/slide-5.png

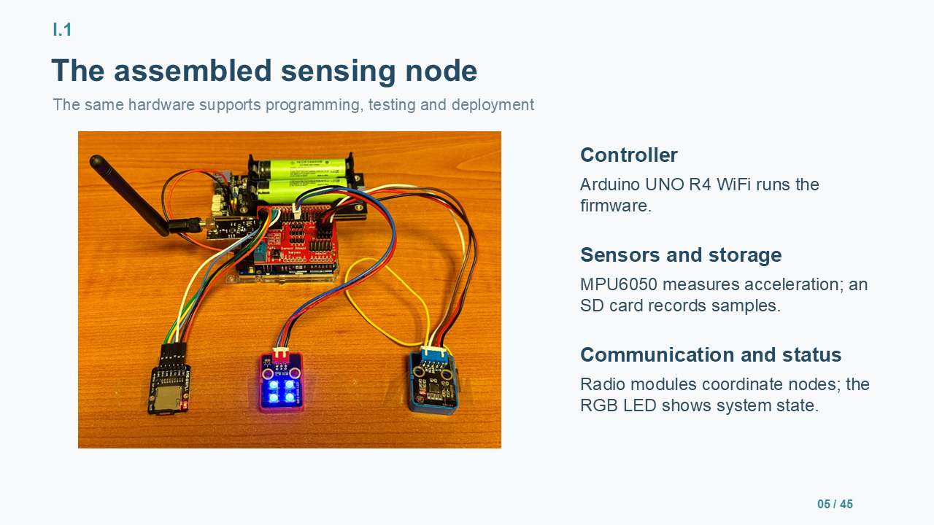
DEMO/.ppt-build/render-minimal/slide-5.png
