Shuaiwen-Cui/ArduinoNode/DEMO/.ppt-build/render-minimal/slide-7.png

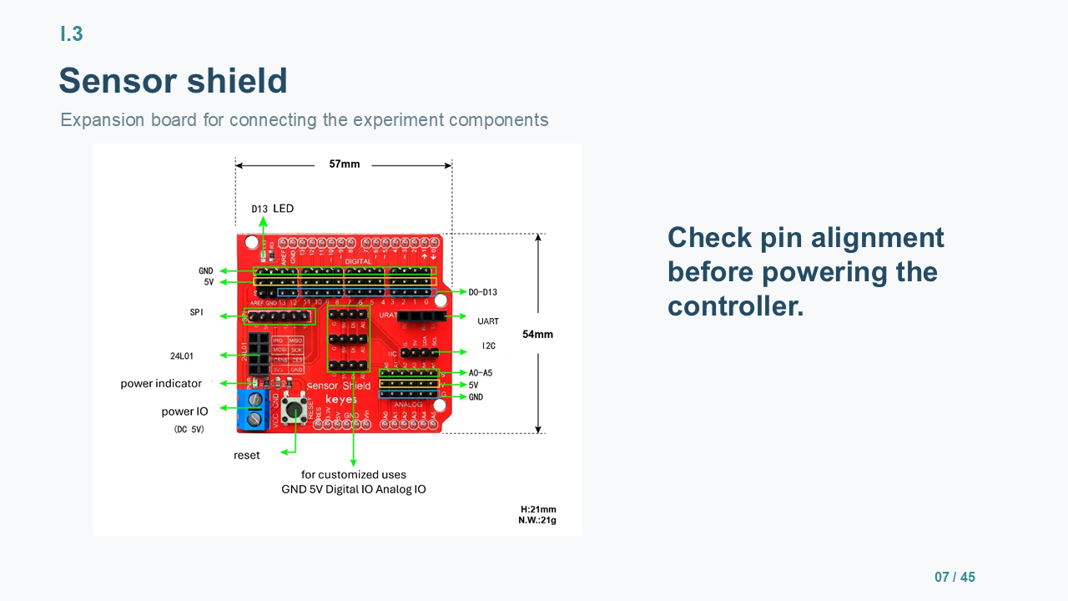
DEMO/.ppt-build/render-minimal/slide-7.png
