Shuaiwen-Cui/ArduinoNode/DEMO/.ppt-build/render-minimal/slide-8.png

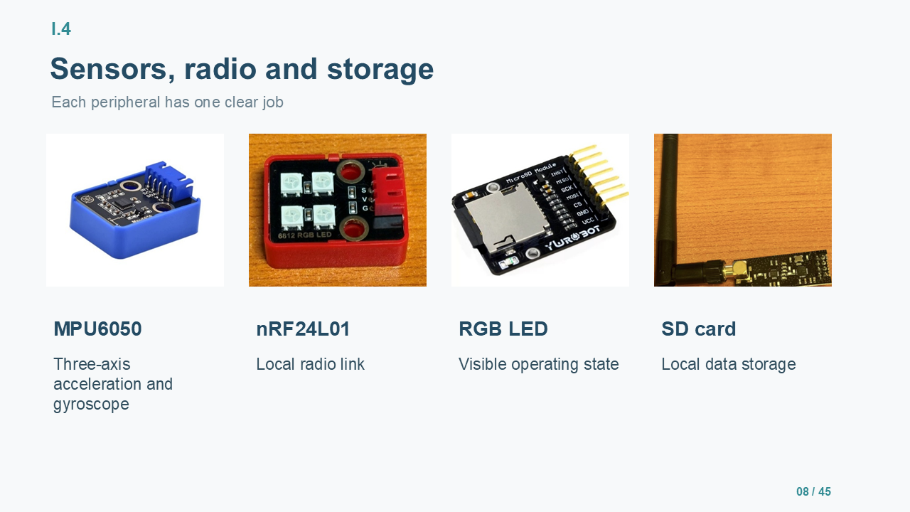
DEMO/.ppt-build/render-minimal/slide-8.png
