Shuaiwen-Cui/ArduinoNode/DEMO/.ppt-build/render-minimal/slide-9.png

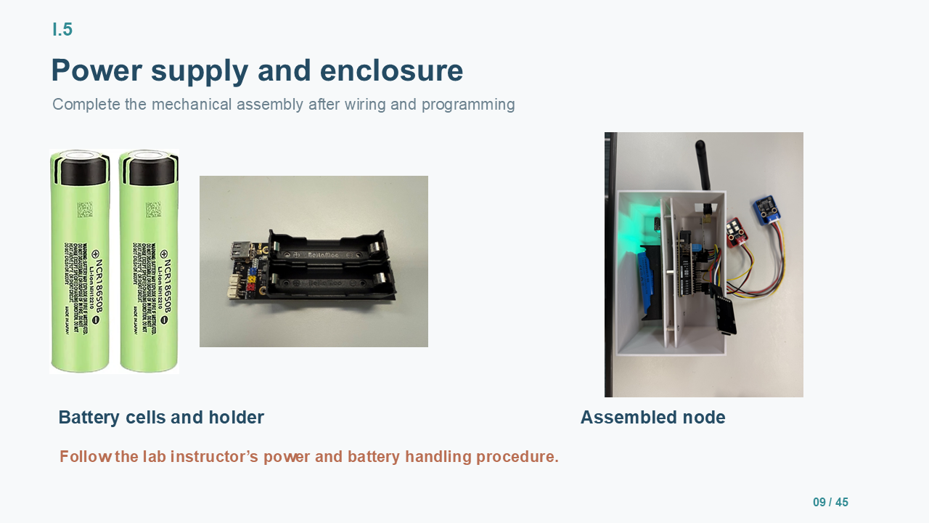
DEMO/.ppt-build/render-minimal/slide-9.png
