Shuaiwen-Cui/ArduinoNode/DEMO/.ppt-build/render-minimal/slide-10.png

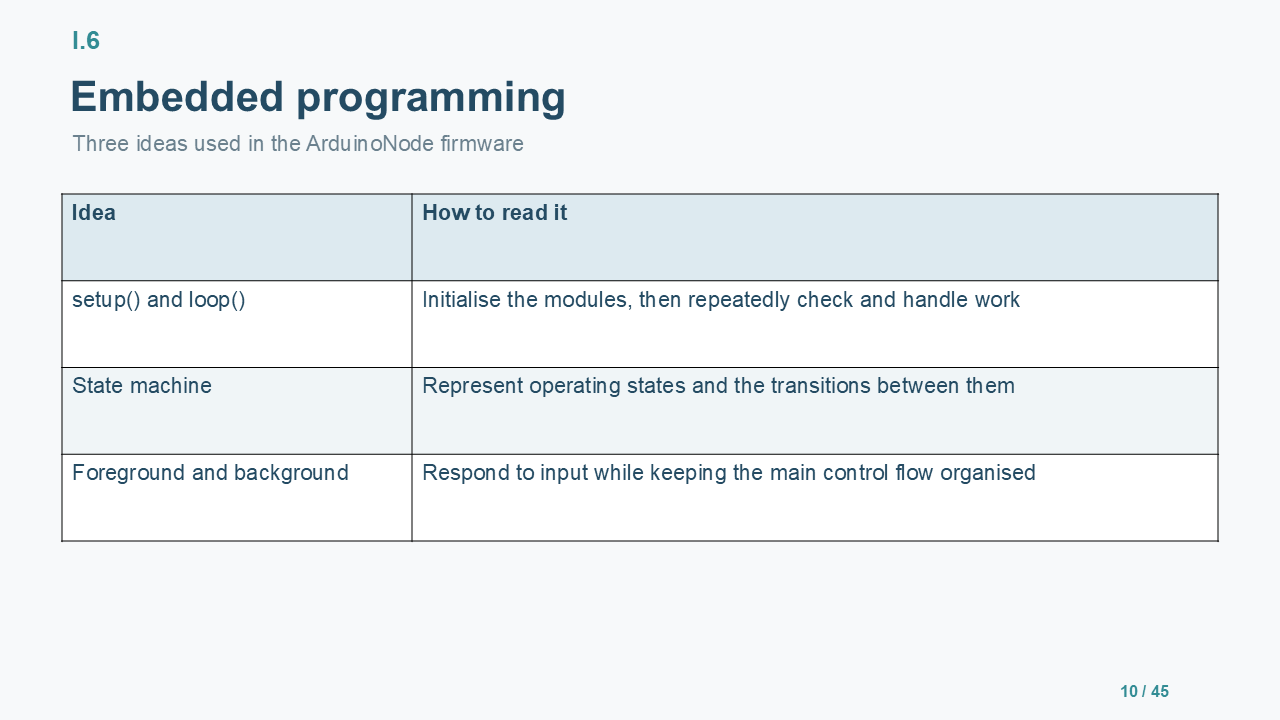
DEMO/.ppt-build/render-minimal/slide-10.png
