Shuaiwen-Cui/ArduinoNode/DEMO/.ppt-build/render-minimal/slide-12.png

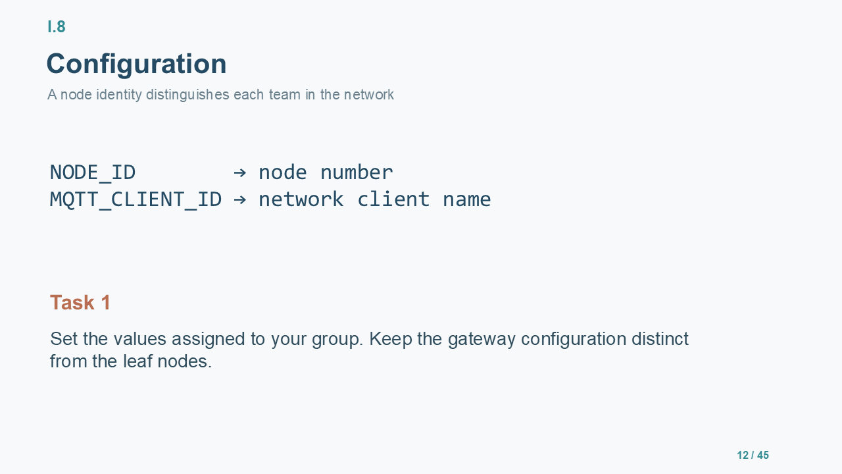
DEMO/.ppt-build/render-minimal/slide-12.png
