Shuaiwen-Cui/ArduinoNode/DEMO/.ppt-build/render-minimal/slide-15.png

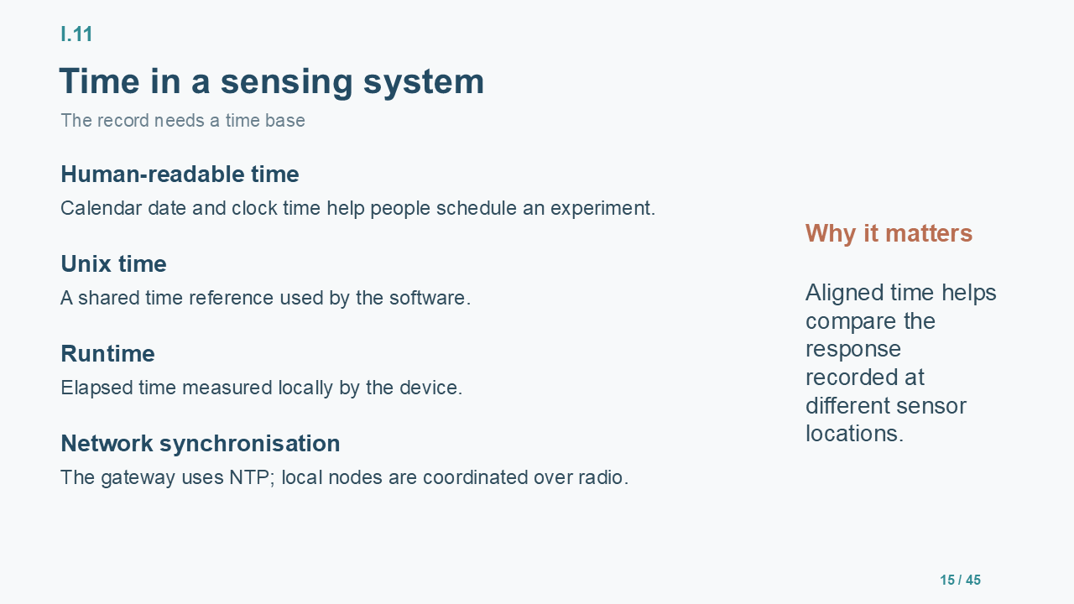
DEMO/.ppt-build/render-minimal/slide-15.png
