Shuaiwen-Cui/ArduinoNode/DEMO/.ppt-build/render-minimal/slide-16.png

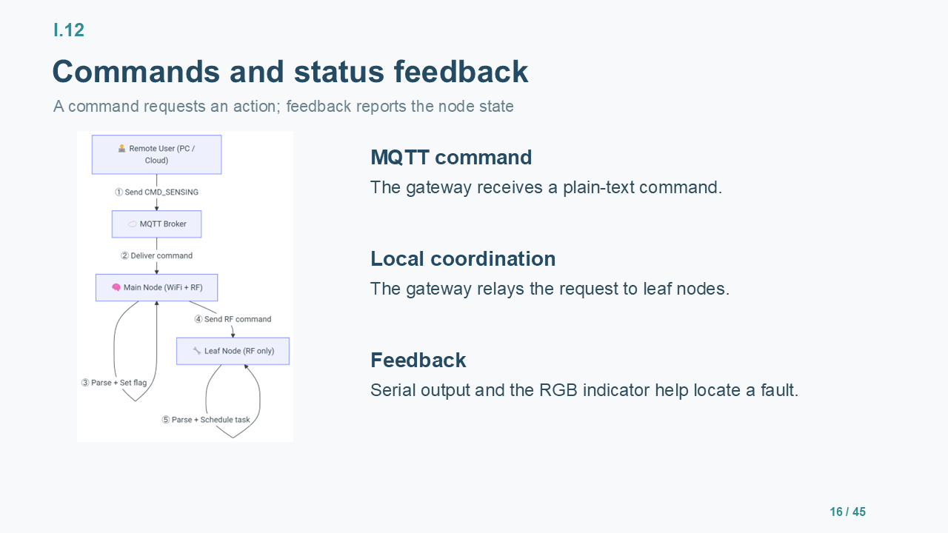
DEMO/.ppt-build/render-minimal/slide-16.png
