Shuaiwen-Cui/ArduinoNode/DEMO/.ppt-build/render-minimal/slide-17.png

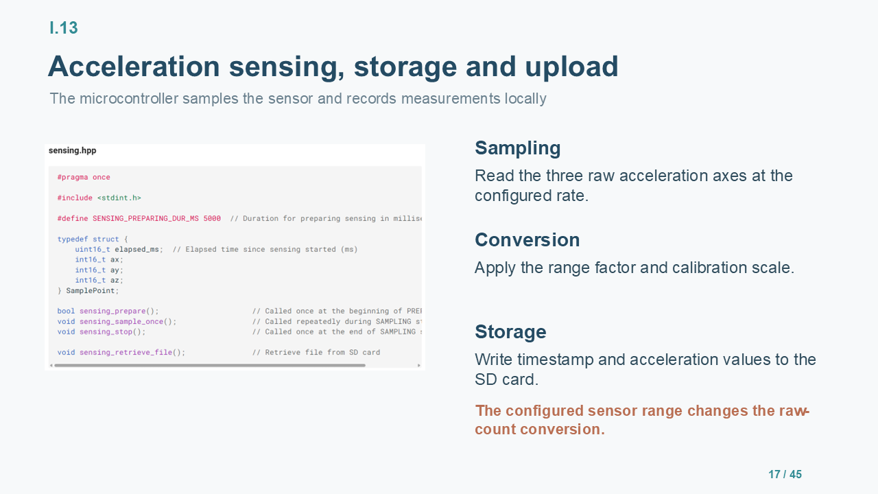
DEMO/.ppt-build/render-minimal/slide-17.png
