Shuaiwen-Cui/ArduinoNode/DEMO/.ppt-build/render-minimal/slide-20.png

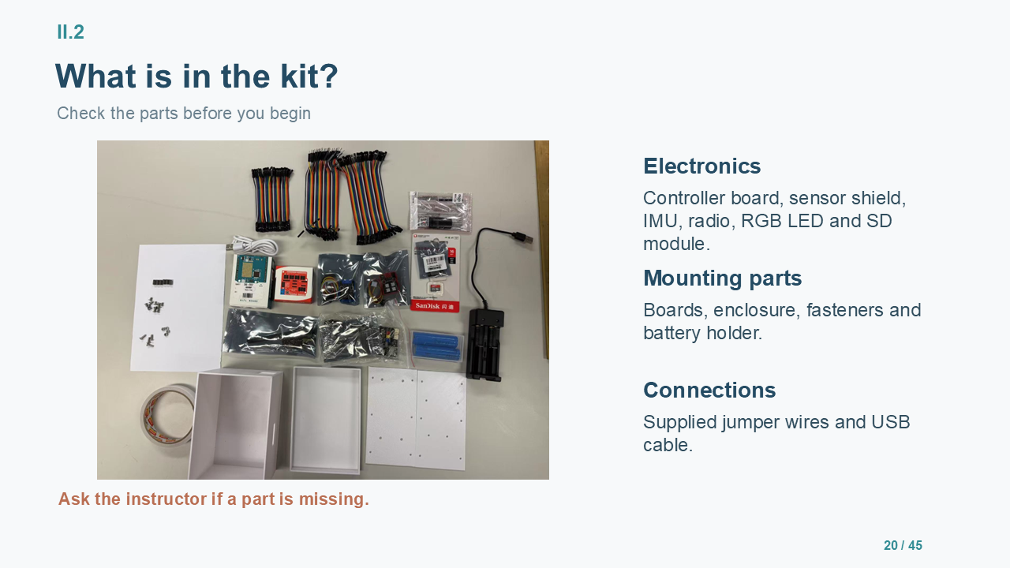
DEMO/.ppt-build/render-minimal/slide-20.png
