Shuaiwen-Cui/ArduinoNode/DEMO/.ppt-build/render-minimal/slide-21.png

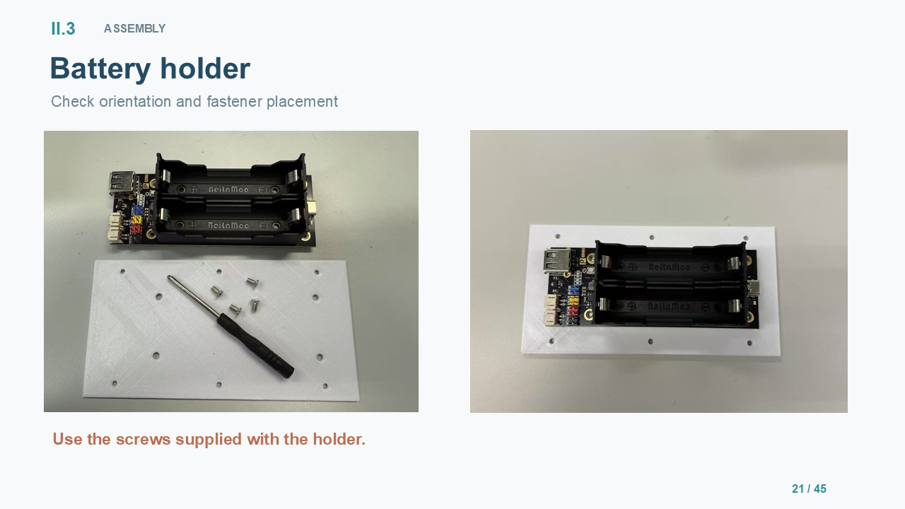
DEMO/.ppt-build/render-minimal/slide-21.png
