Shuaiwen-Cui/ArduinoNode/DEMO/.ppt-build/render-minimal/slide-28.png

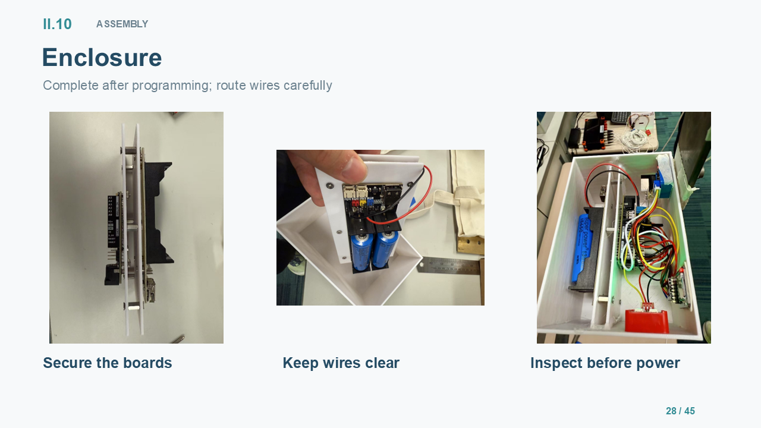
DEMO/.ppt-build/render-minimal/slide-28.png
