Shuaiwen-Cui/ArduinoNode/DEMO/.ppt-build/render-minimal/slide-29.png

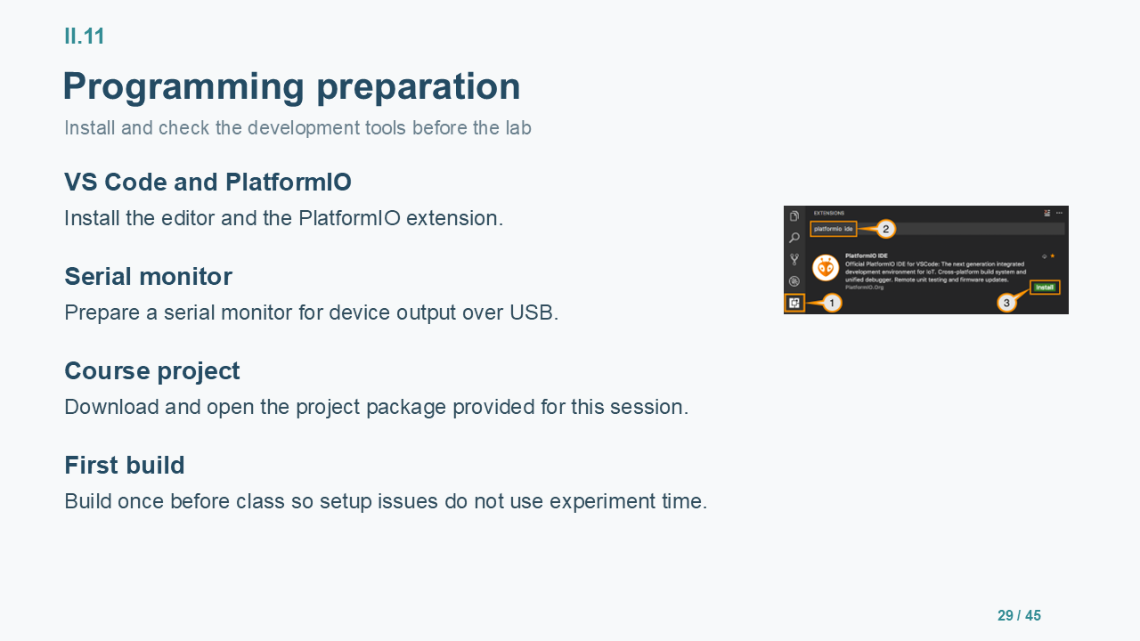
DEMO/.ppt-build/render-minimal/slide-29.png
