Shuaiwen-Cui/ArduinoNode/DEMO/.ppt-build/render-minimal/slide-31.png

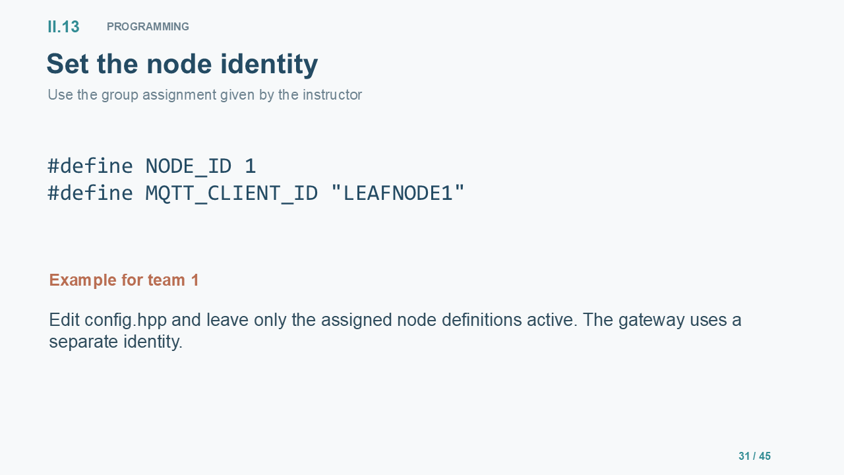
DEMO/.ppt-build/render-minimal/slide-31.png
