Shuaiwen-Cui/ArduinoNode/DEMO/.ppt-build/render-minimal/slide-32.png

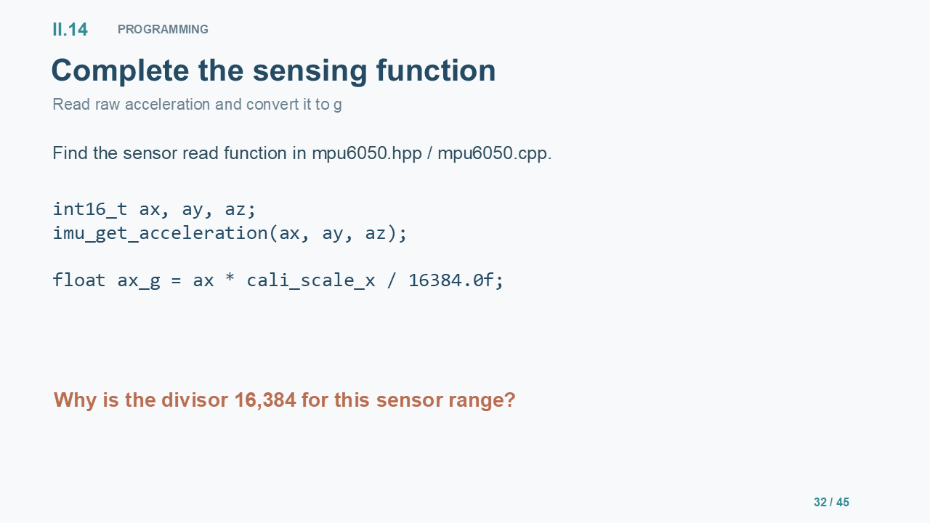
DEMO/.ppt-build/render-minimal/slide-32.png
