Shuaiwen-Cui/ArduinoNode/DEMO/.ppt-build/render-minimal/slide-35.png

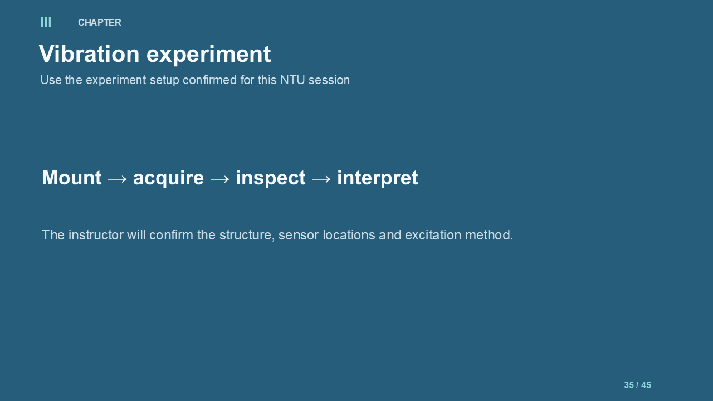
DEMO/.ppt-build/render-minimal/slide-35.png
