Shuaiwen-Cui/ArduinoNode/DEMO/.ppt-build/render-minimal/slide-37.png

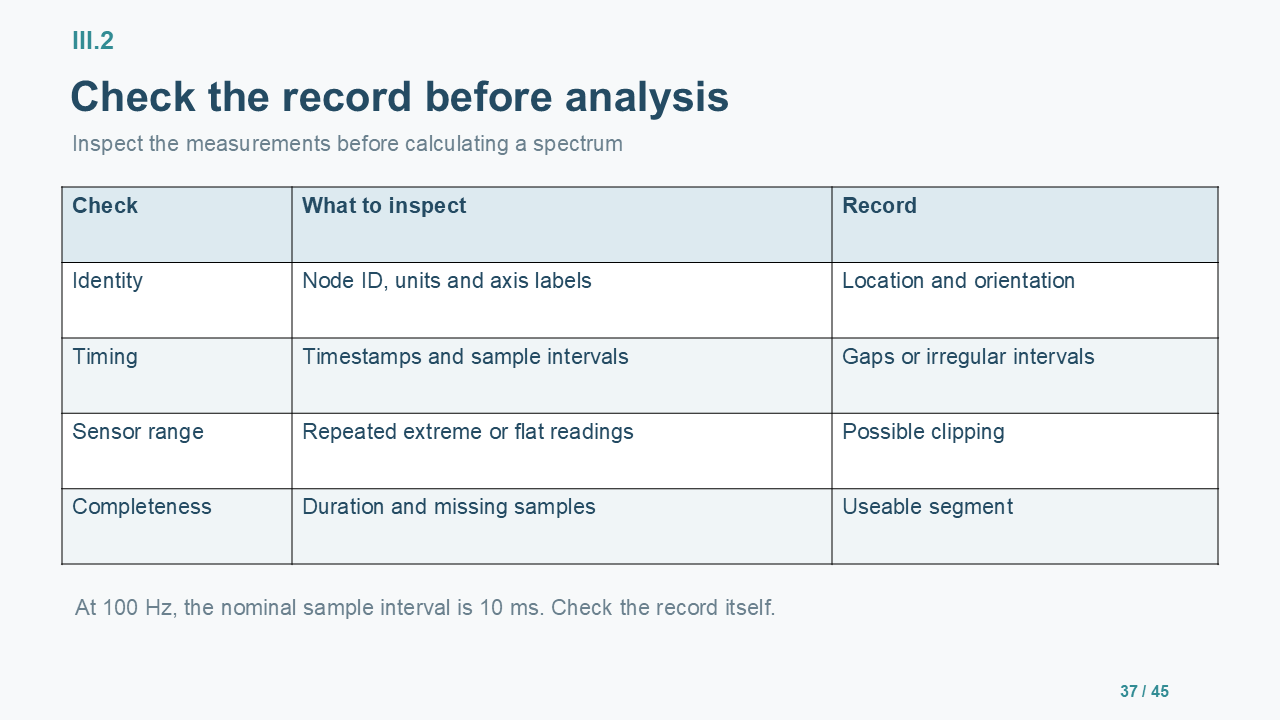
DEMO/.ppt-build/render-minimal/slide-37.png
