Shuaiwen-Cui/ArduinoNode/DEMO/.ppt-build/render-minimal/slide-40.png

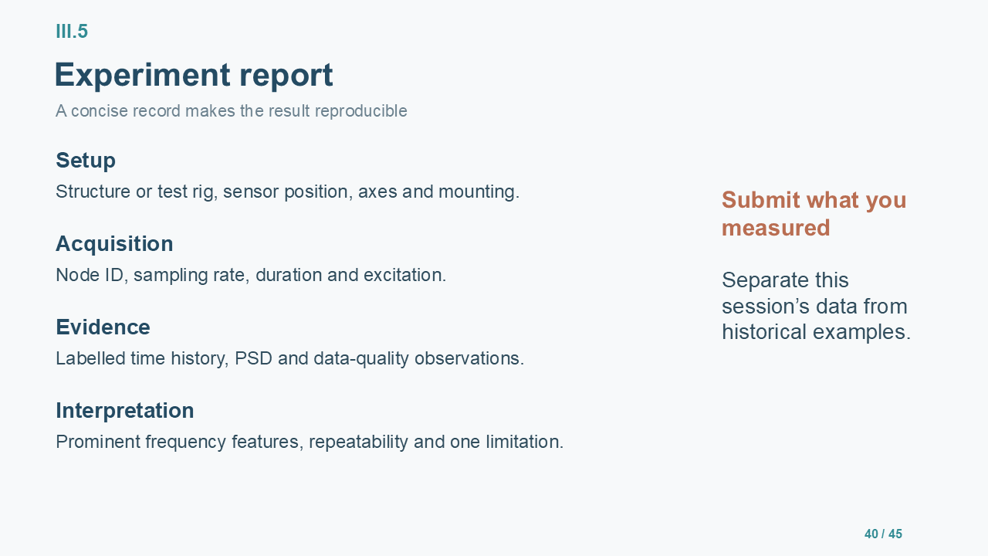
DEMO/.ppt-build/render-minimal/slide-40.png
