Shuaiwen-Cui/ArduinoNode/DEMO/.ppt-build/render-minimal/slide-41.png

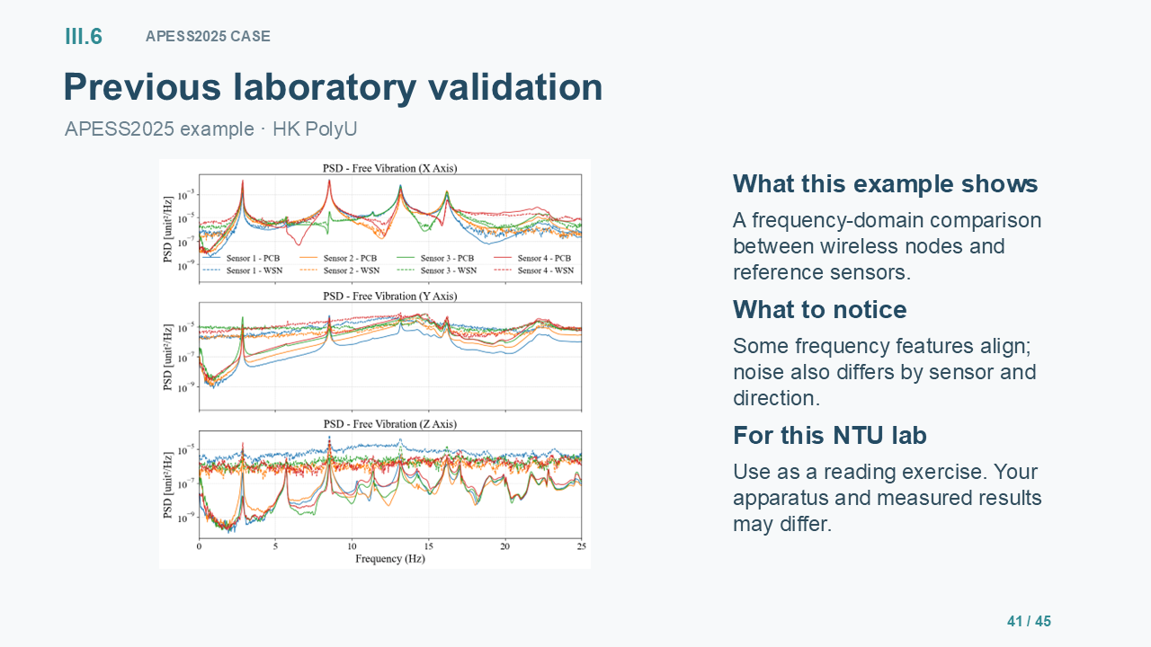
DEMO/.ppt-build/render-minimal/slide-41.png
