Shuaiwen-Cui/ArduinoNode/DEMO/.ppt-build/render-minimal/slide-43.png

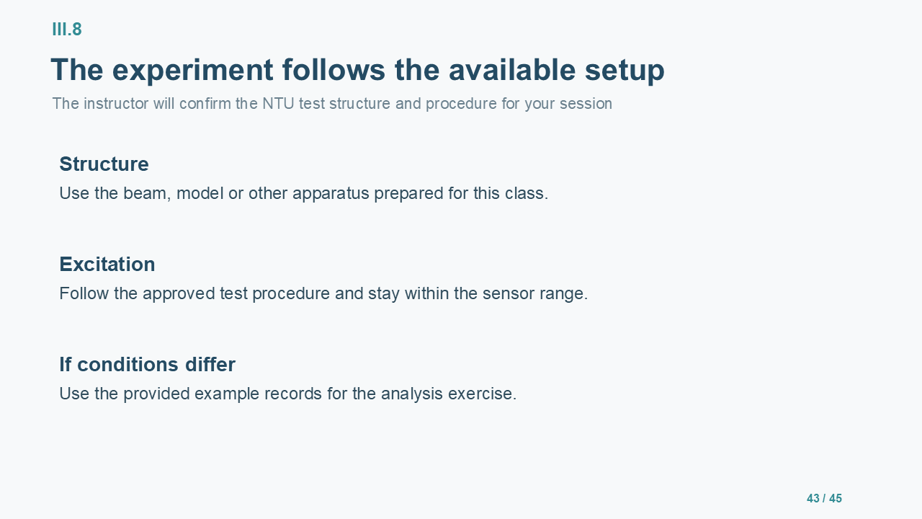
DEMO/.ppt-build/render-minimal/slide-43.png
