Shuaiwen-Cui/ArduinoNode/DEMO/.ppt-build/render-minimal/slide-44.png

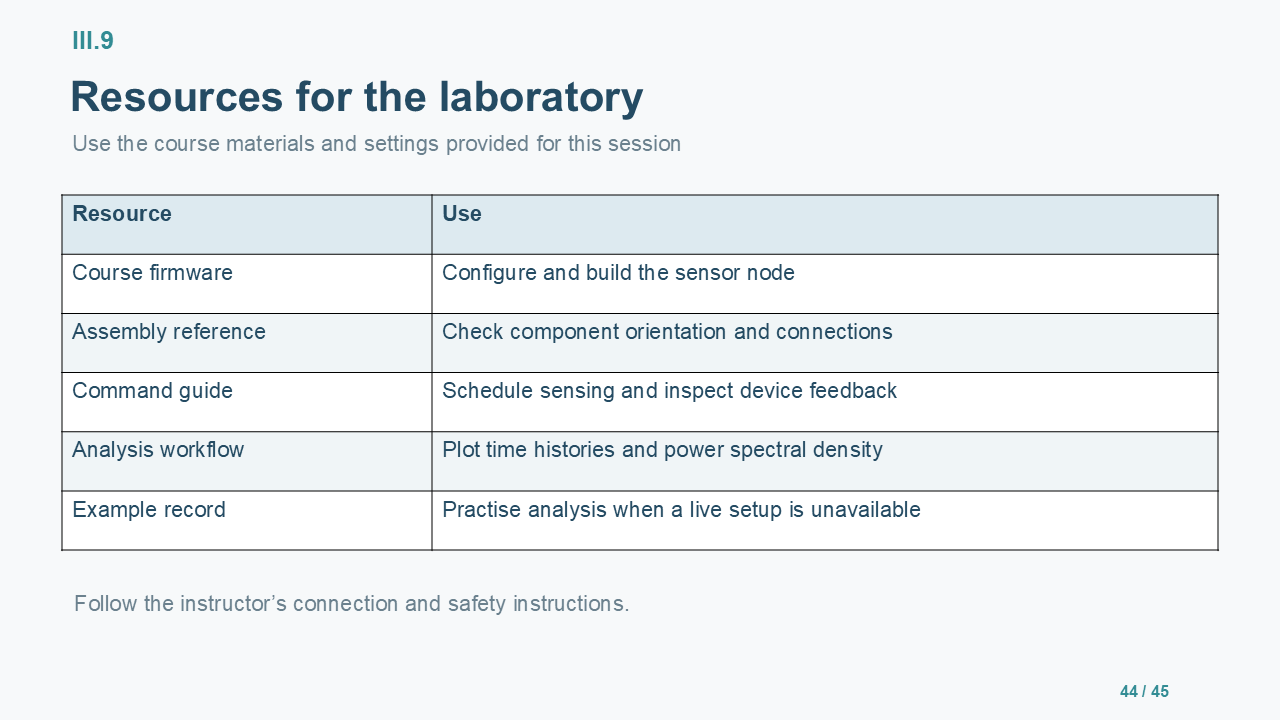
DEMO/.ppt-build/render-minimal/slide-44.png
