Shuaiwen-Cui/ArduinoNode/DEMO/.ppt-build/render-minimal/slide-45.png

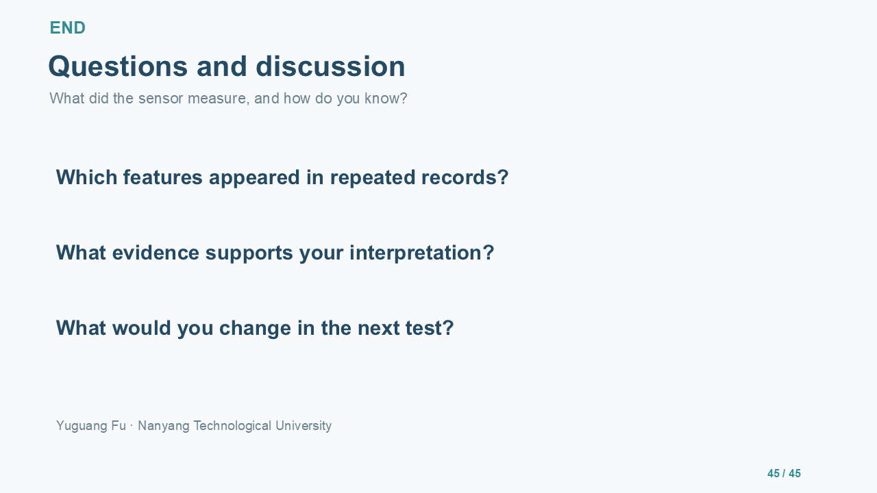
DEMO/.ppt-build/render-minimal/slide-45.png
