Shuaiwen-Cui/ArduinoNode/DEMO/.ppt-build/render-plots/contact-1-12.png

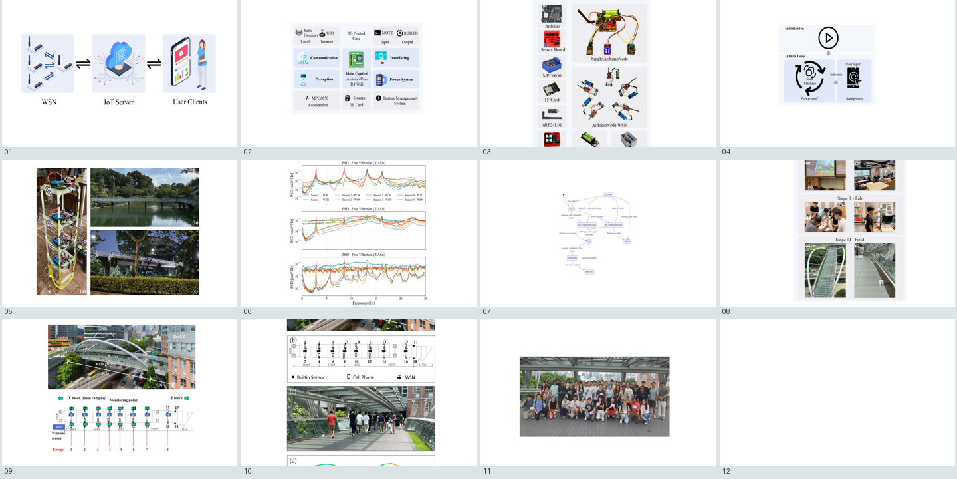
DEMO/.ppt-build/render-plots/contact-1-12.png
