Shuaiwen-Cui/ArduinoNode/DEMO/.ppt-build/render-plots/contact-13-21.png

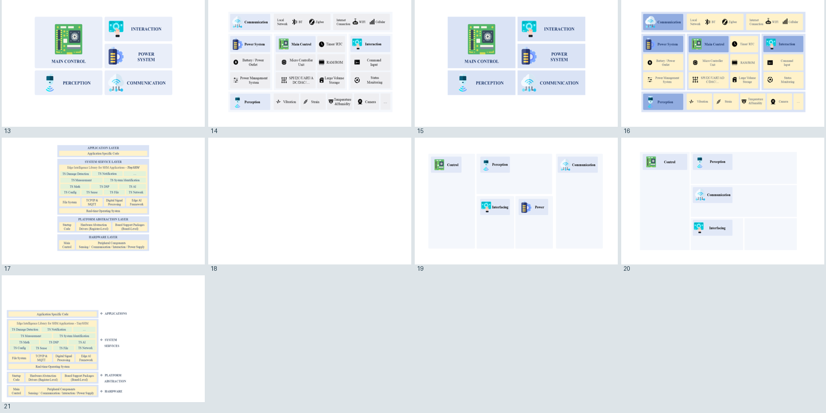
DEMO/.ppt-build/render-plots/contact-13-21.png
