Shuaiwen-Cui/ArduinoNode/DEMO/.ppt-build/render-plots/slide-2.png

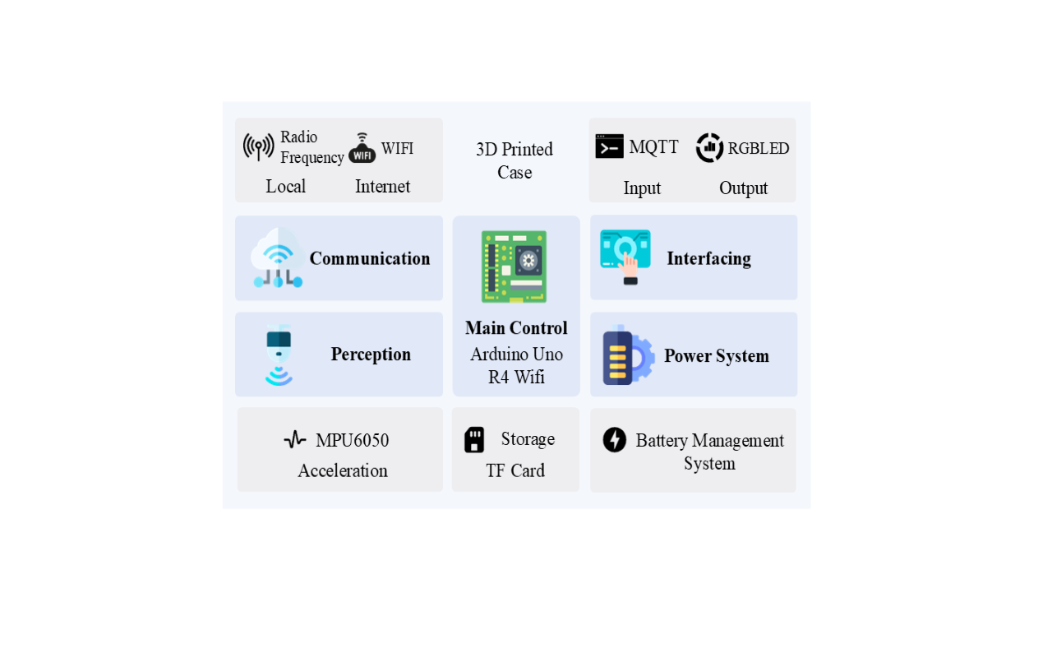
DEMO/.ppt-build/render-plots/slide-2.png
