Shuaiwen-Cui/ArduinoNode/DEMO/.ppt-build/render-plots/slide-3.png

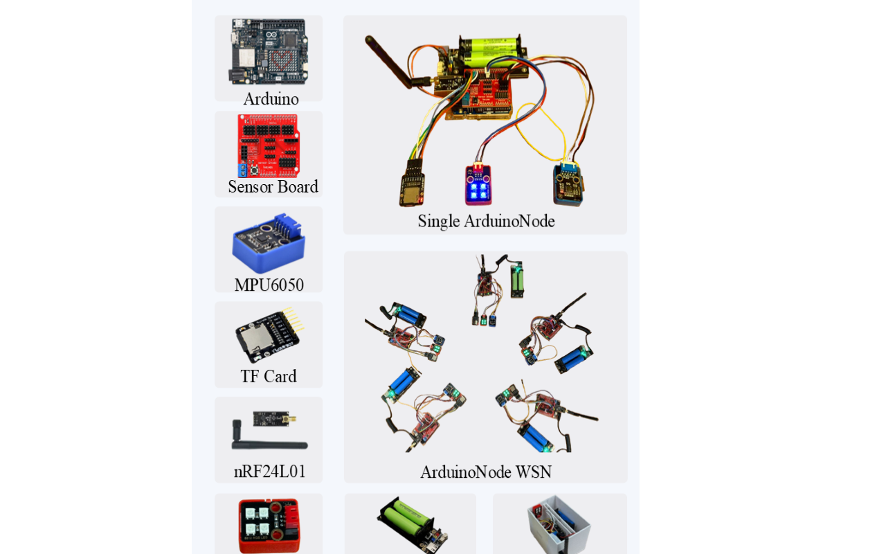
DEMO/.ppt-build/render-plots/slide-3.png
