Shuaiwen-Cui/ArduinoNode/DEMO/.ppt-build/render-plots/slide-4.png

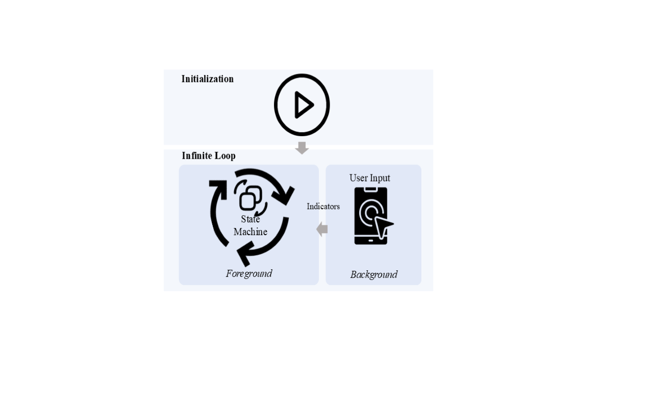
DEMO/.ppt-build/render-plots/slide-4.png
