Shuaiwen-Cui/ArduinoNode/DEMO/.ppt-build/render-plots/slide-8.png

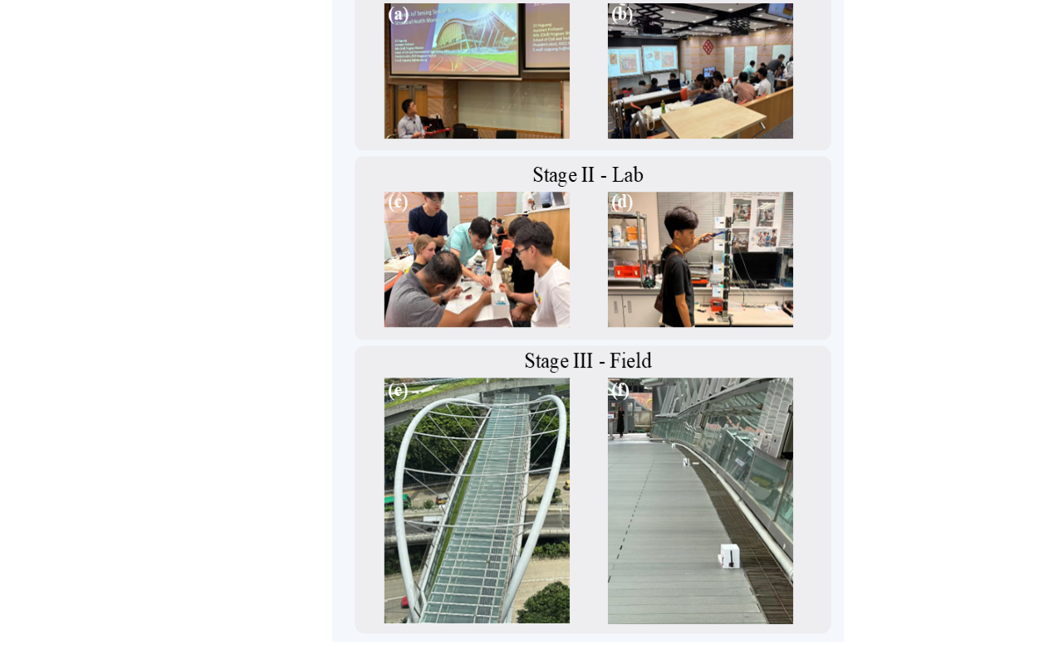
DEMO/.ppt-build/render-plots/slide-8.png
