Shuaiwen-Cui/ArduinoNode/DEMO/.ppt-build/render-plots/slide-11.png

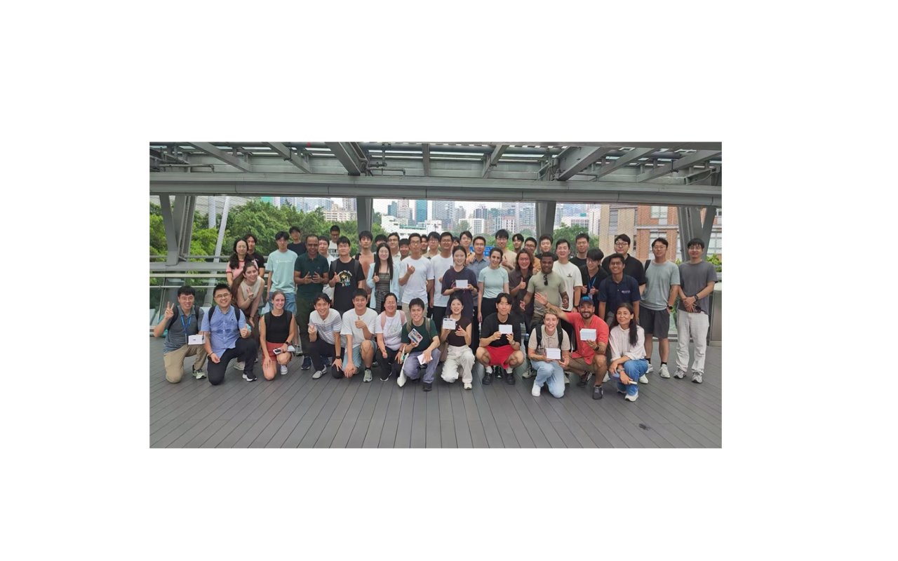
DEMO/.ppt-build/render-plots/slide-11.png
