Shuaiwen-Cui/ArduinoNode/DEMO/.ppt-build/render-plots/slide-15.png

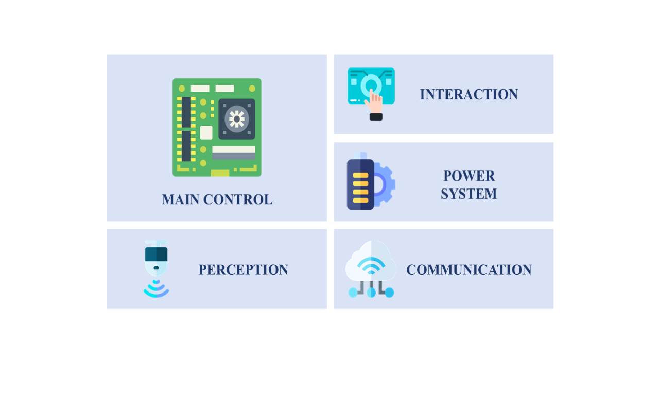
DEMO/.ppt-build/render-plots/slide-15.png
