Shuaiwen-Cui/ArduinoNode/DEMO/.ppt-build/render-plots/slide-17.png

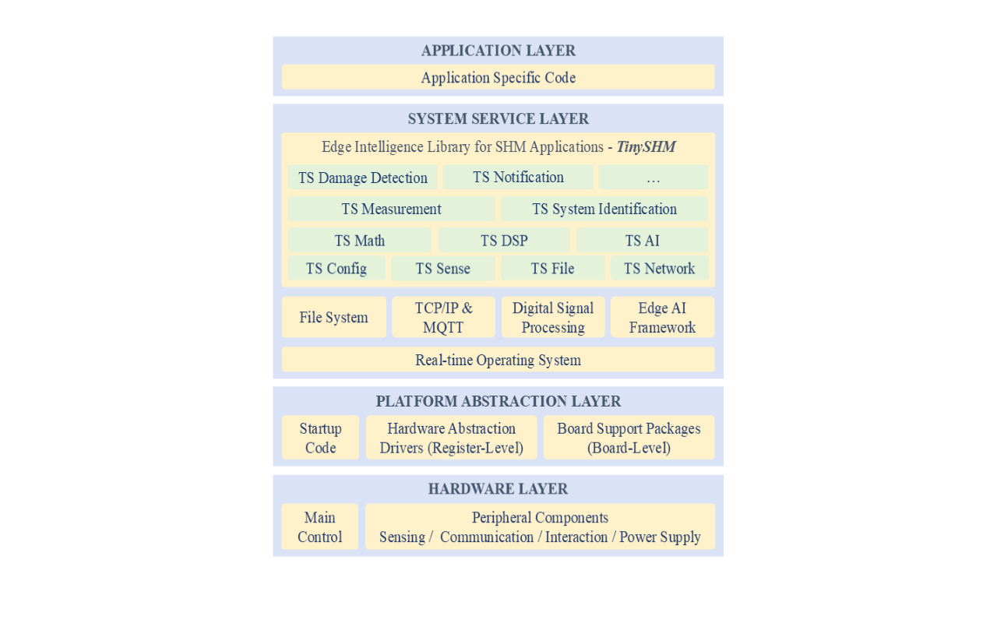
DEMO/.ppt-build/render-plots/slide-17.png
