Shuaiwen-Cui/ArduinoNode/DEMO/.ppt-build/render-plots/slide-19.png

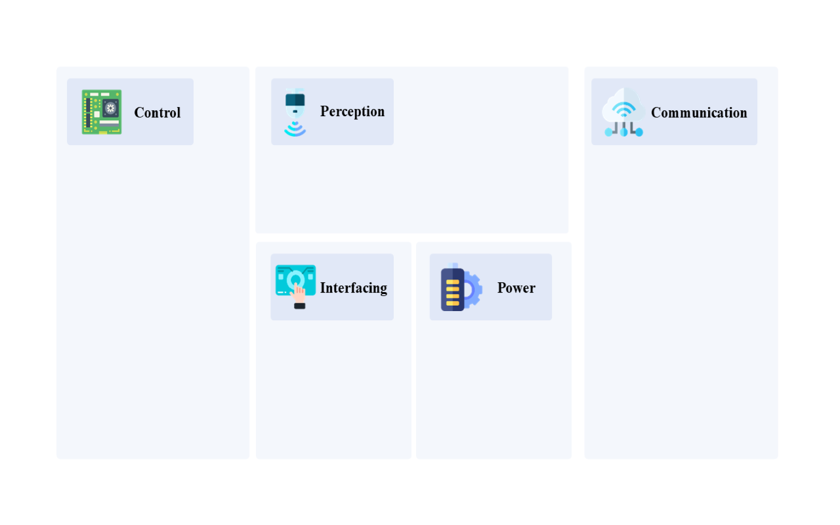
DEMO/.ppt-build/render-plots/slide-19.png
