Shuaiwen-Cui/ArduinoNode/DEMO/.ppt-build/render-plots/slide-21.png

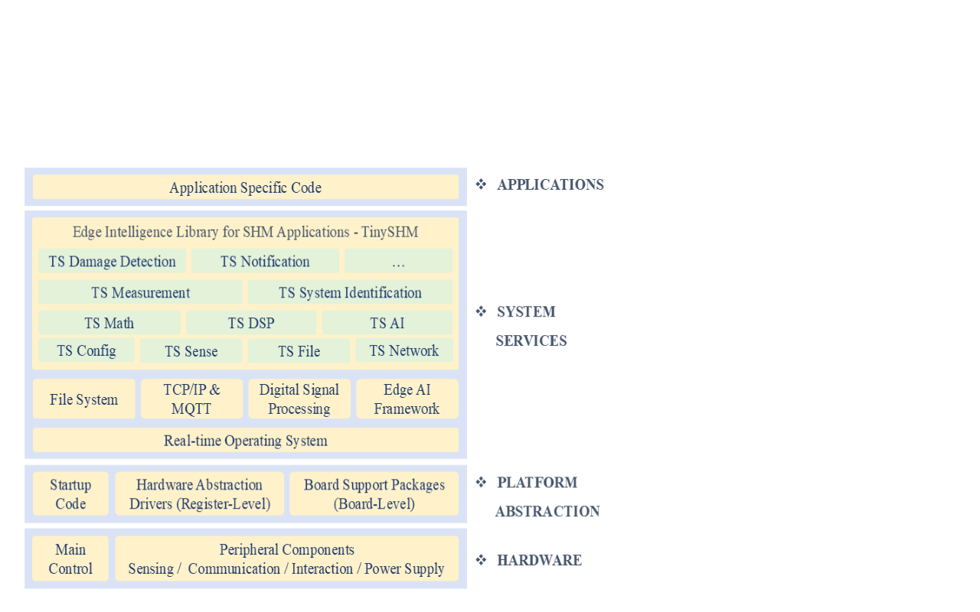
DEMO/.ppt-build/render-plots/slide-21.png
