Shuaiwen-Cui/ArduinoNode/DEMO/.ppt-build/render-polished/contact-1-16.png

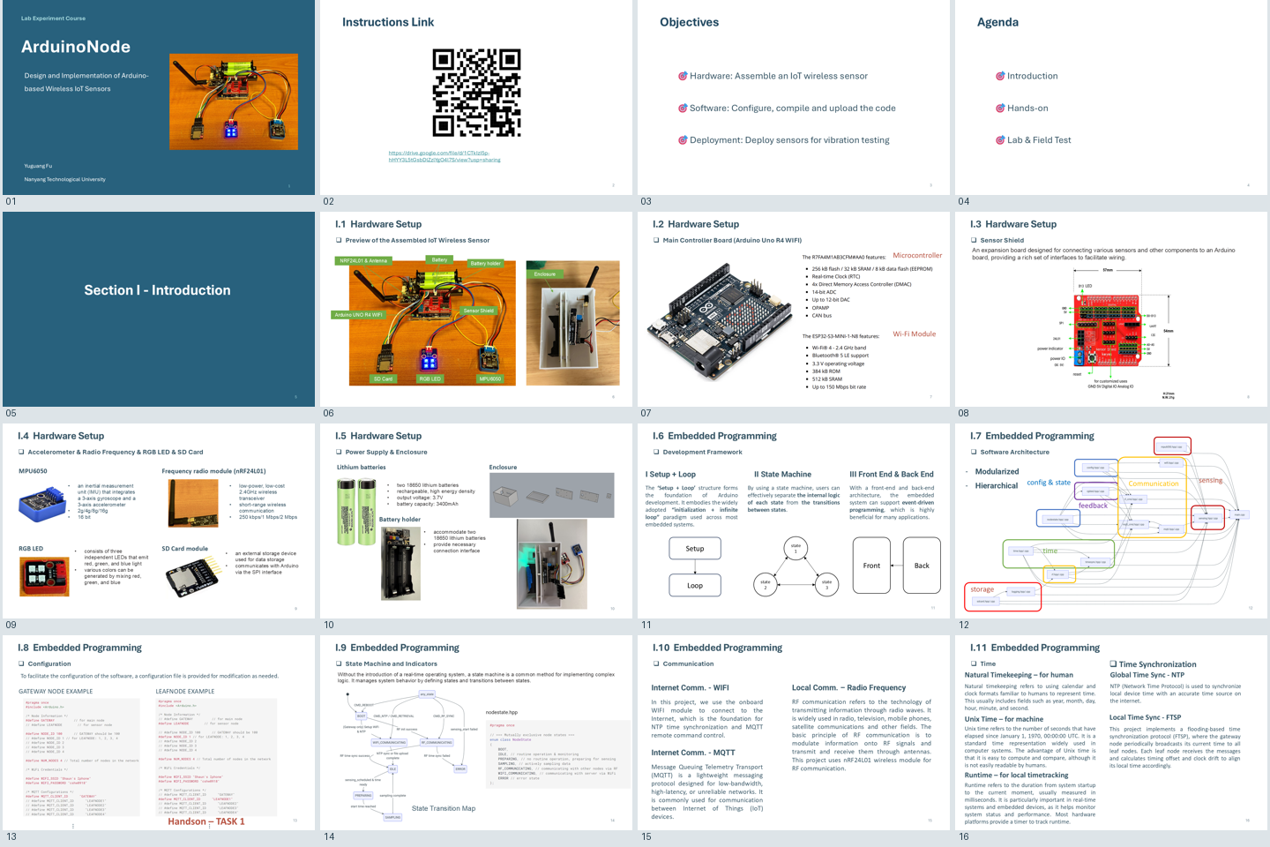
DEMO/.ppt-build/render-polished/contact-1-16.png
