Shuaiwen-Cui/ArduinoNode/DEMO/.ppt-build/render-polished/contact-33-46.png

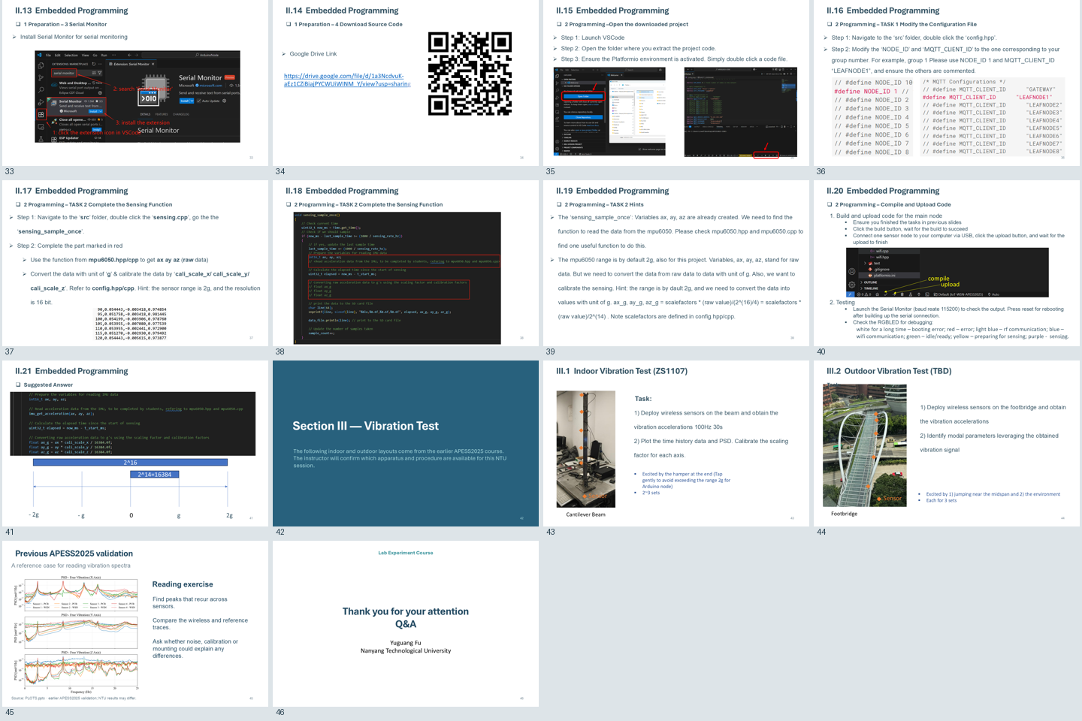
DEMO/.ppt-build/render-polished/contact-33-46.png
