Shuaiwen-Cui/ArduinoNode/DEMO/.ppt-build/render-polished/slide-2.png

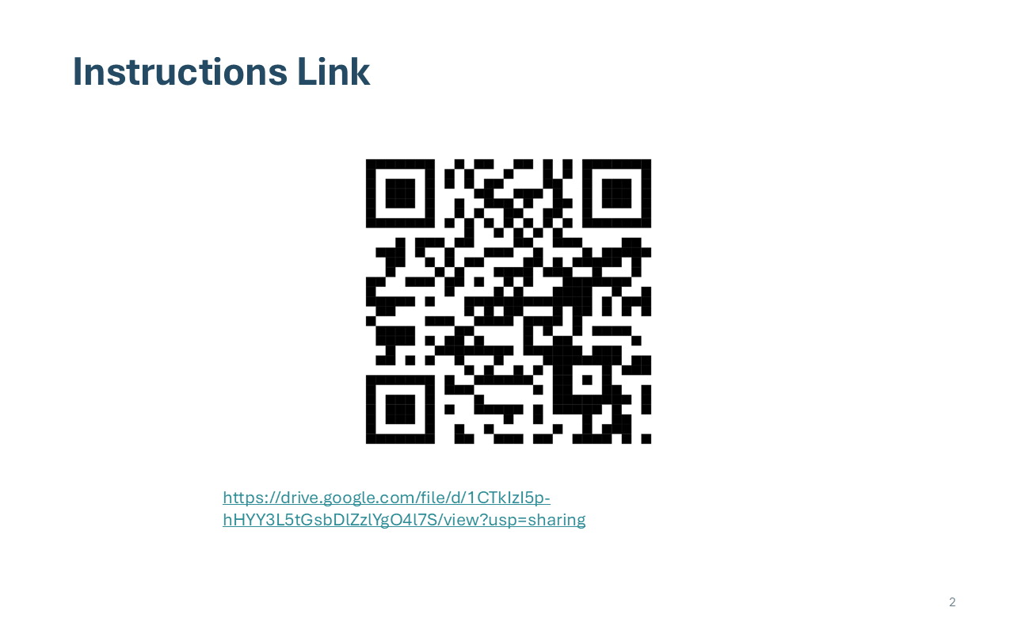
DEMO/.ppt-build/render-polished/slide-2.png
