Shuaiwen-Cui/ArduinoNode/DEMO/.ppt-build/render-polished/slide-4.png

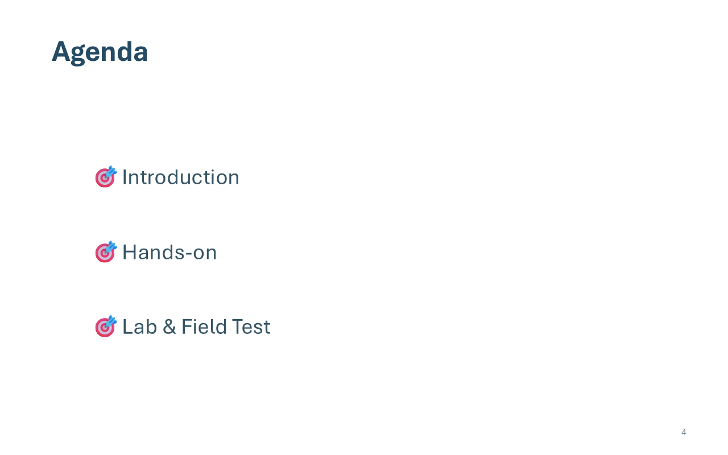
DEMO/.ppt-build/render-polished/slide-4.png
