Shuaiwen-Cui/ArduinoNode/DEMO/.ppt-build/render-polished/slide-5.png

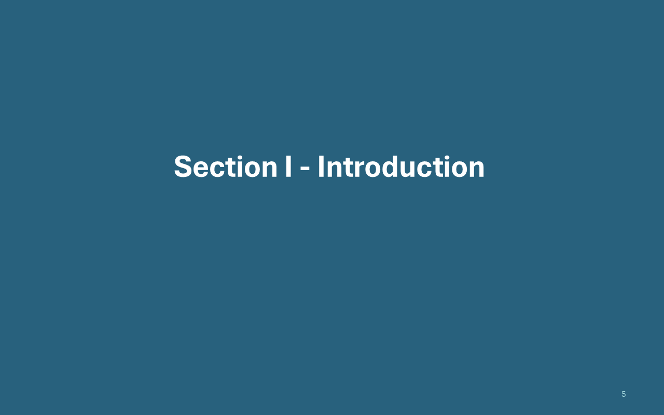
DEMO/.ppt-build/render-polished/slide-5.png
