Shuaiwen-Cui/ArduinoNode/DEMO/.ppt-build/render-polished/slide-9.png

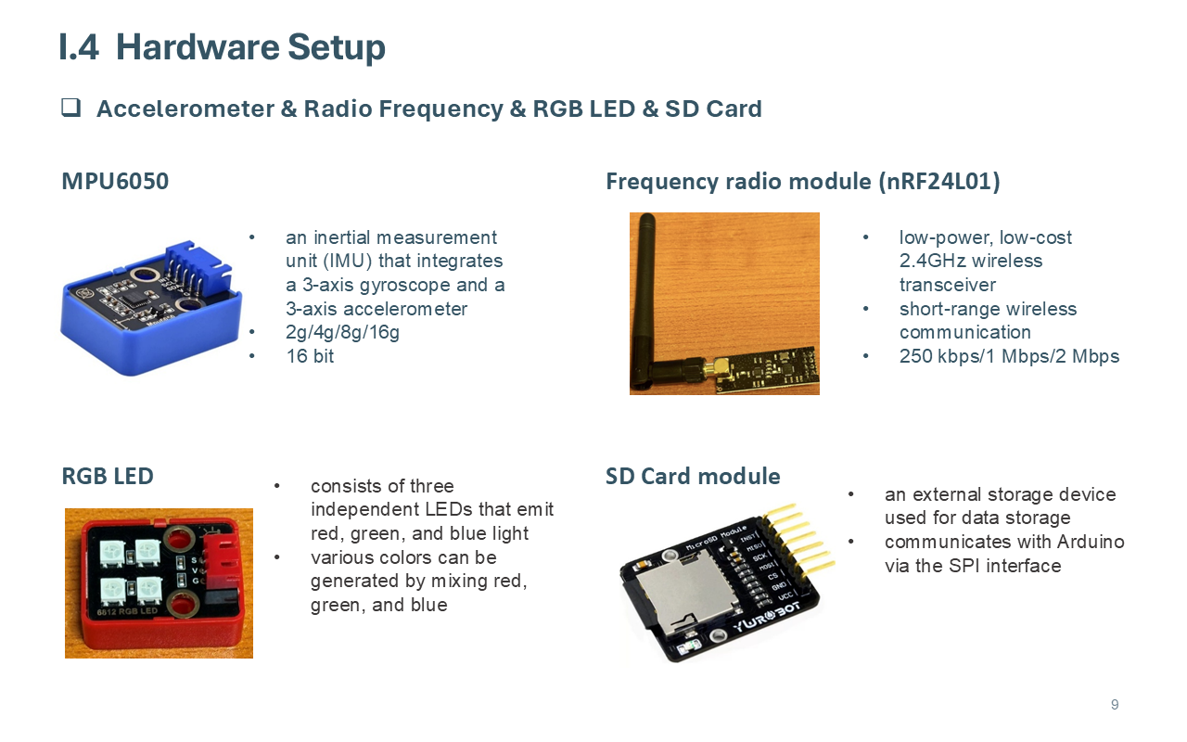
DEMO/.ppt-build/render-polished/slide-9.png
