Shuaiwen-Cui/ArduinoNode/DEMO/.ppt-build/render-polished/slide-14.png

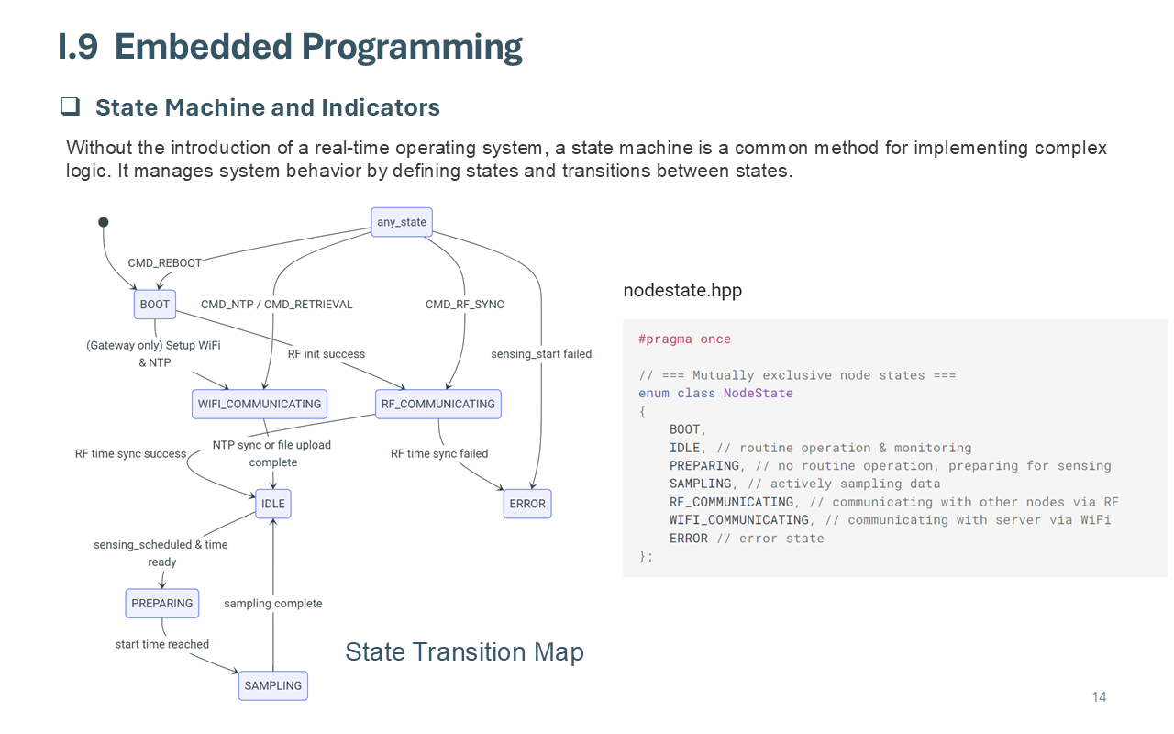
DEMO/.ppt-build/render-polished/slide-14.png
