Shuaiwen-Cui/ArduinoNode/DEMO/.ppt-build/render-polished/slide-15.png

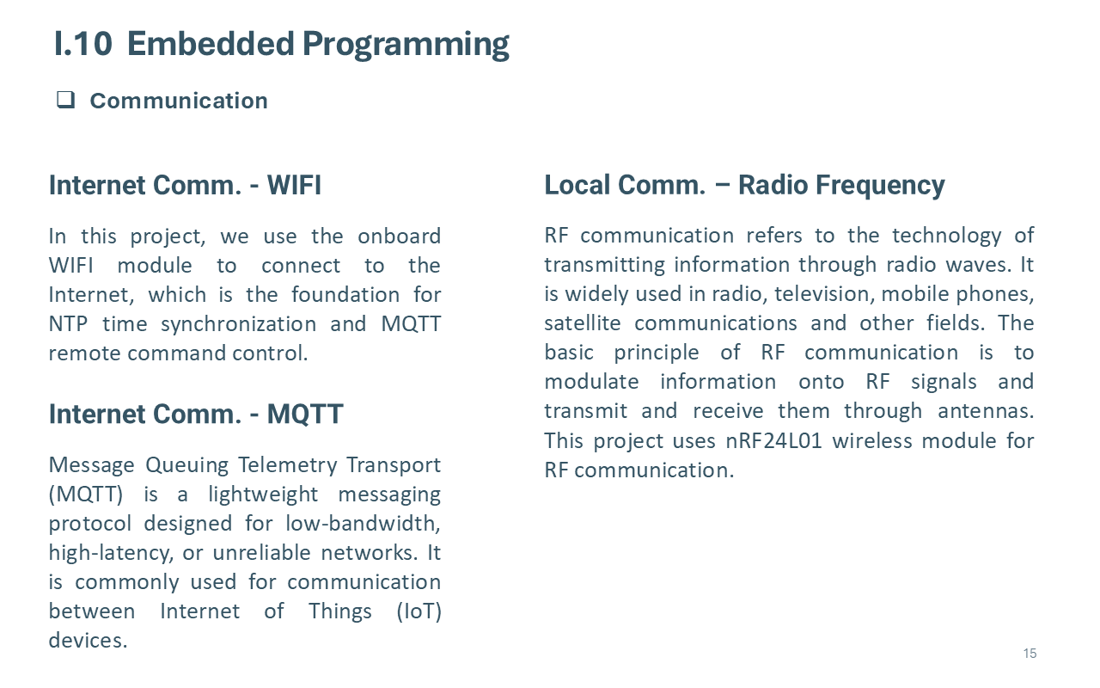
DEMO/.ppt-build/render-polished/slide-15.png
