Shuaiwen-Cui/ArduinoNode/DEMO/.ppt-build/render-polished/slide-16.png

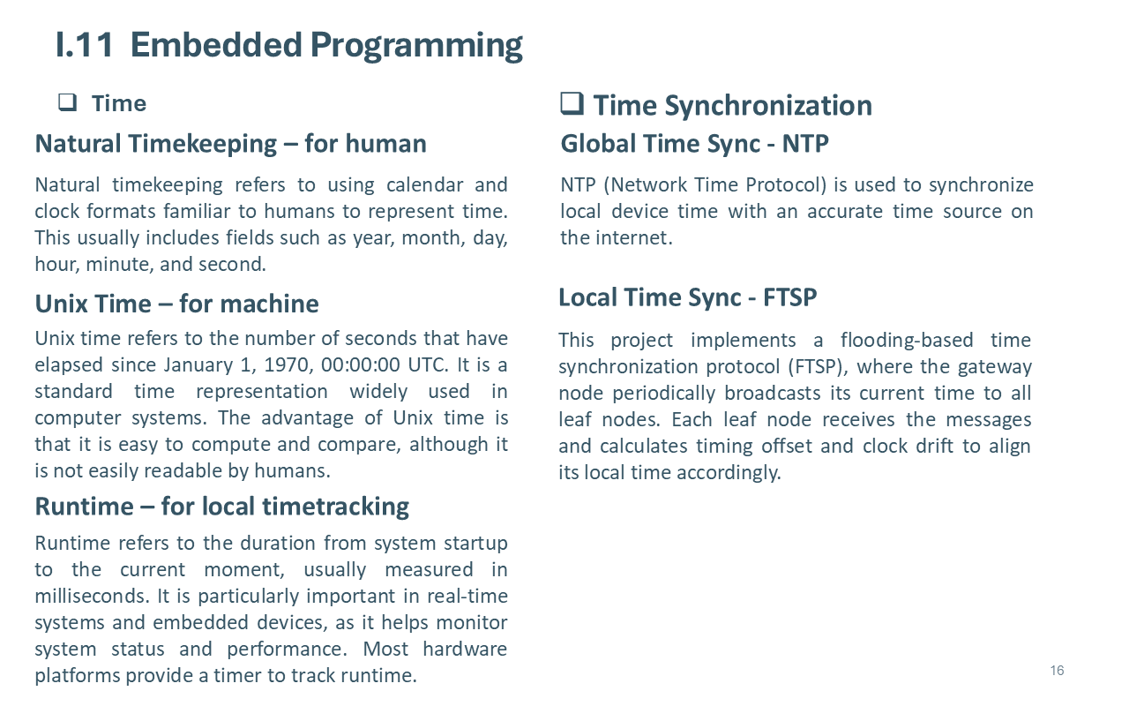
DEMO/.ppt-build/render-polished/slide-16.png
