Shuaiwen-Cui/ArduinoNode/DEMO/.ppt-build/render-polished/slide-17.png

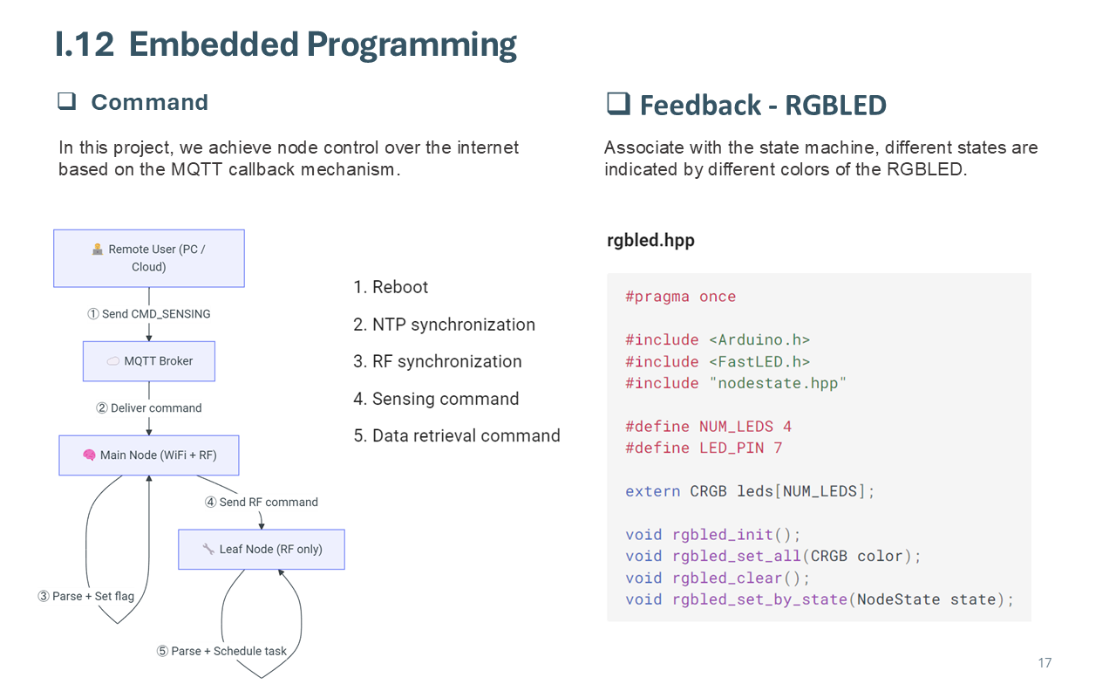
DEMO/.ppt-build/render-polished/slide-17.png
