Shuaiwen-Cui/ArduinoNode/DEMO/.ppt-build/render-polished/slide-20.png

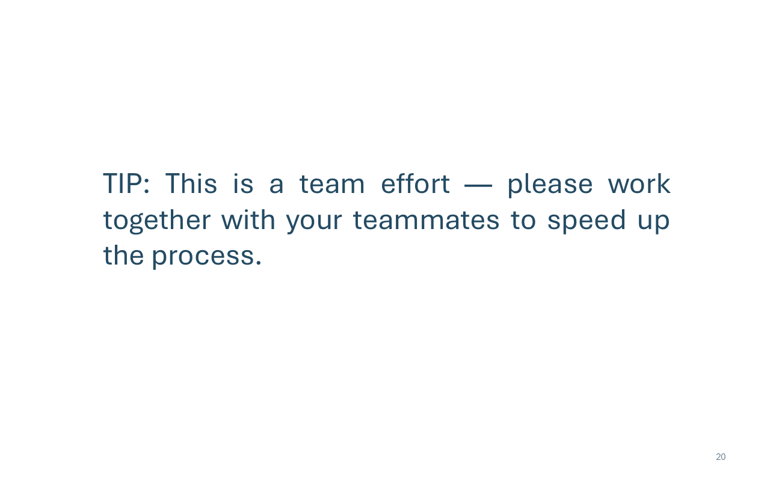
DEMO/.ppt-build/render-polished/slide-20.png
