Shuaiwen-Cui/ArduinoNode/DEMO/.ppt-build/render-polished/slide-22.png

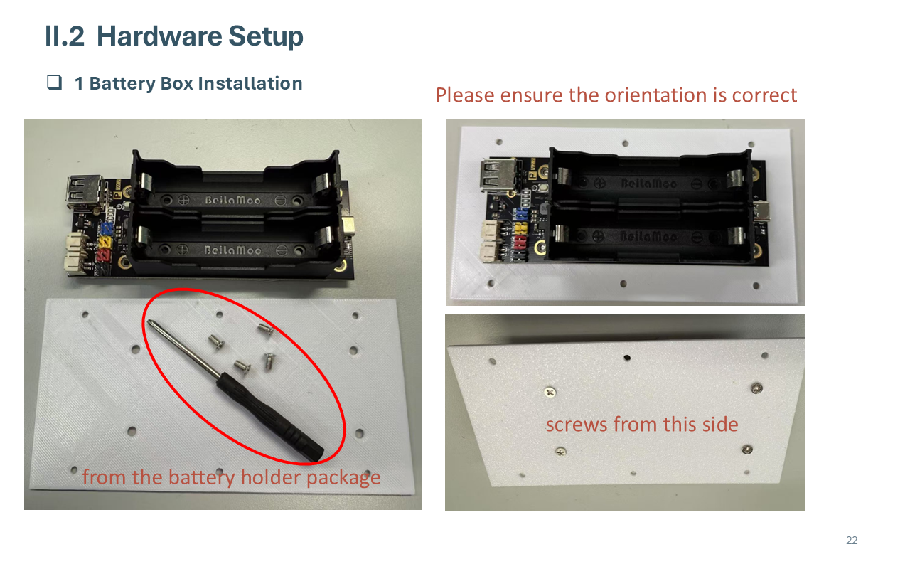
DEMO/.ppt-build/render-polished/slide-22.png
