Shuaiwen-Cui/ArduinoNode/DEMO/.ppt-build/render-polished/slide-28.png

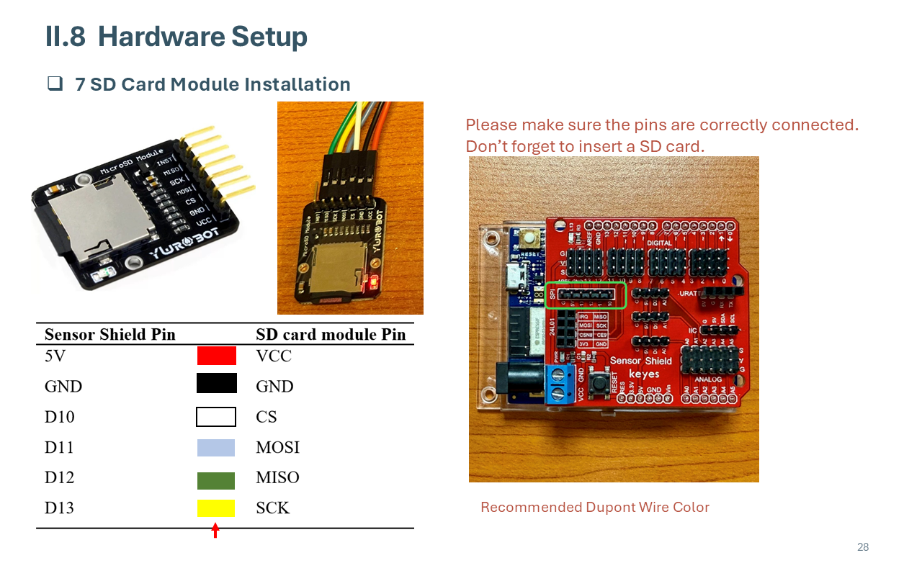
DEMO/.ppt-build/render-polished/slide-28.png
