Shuaiwen-Cui/ArduinoNode/DEMO/.ppt-build/render-polished/slide-33.png

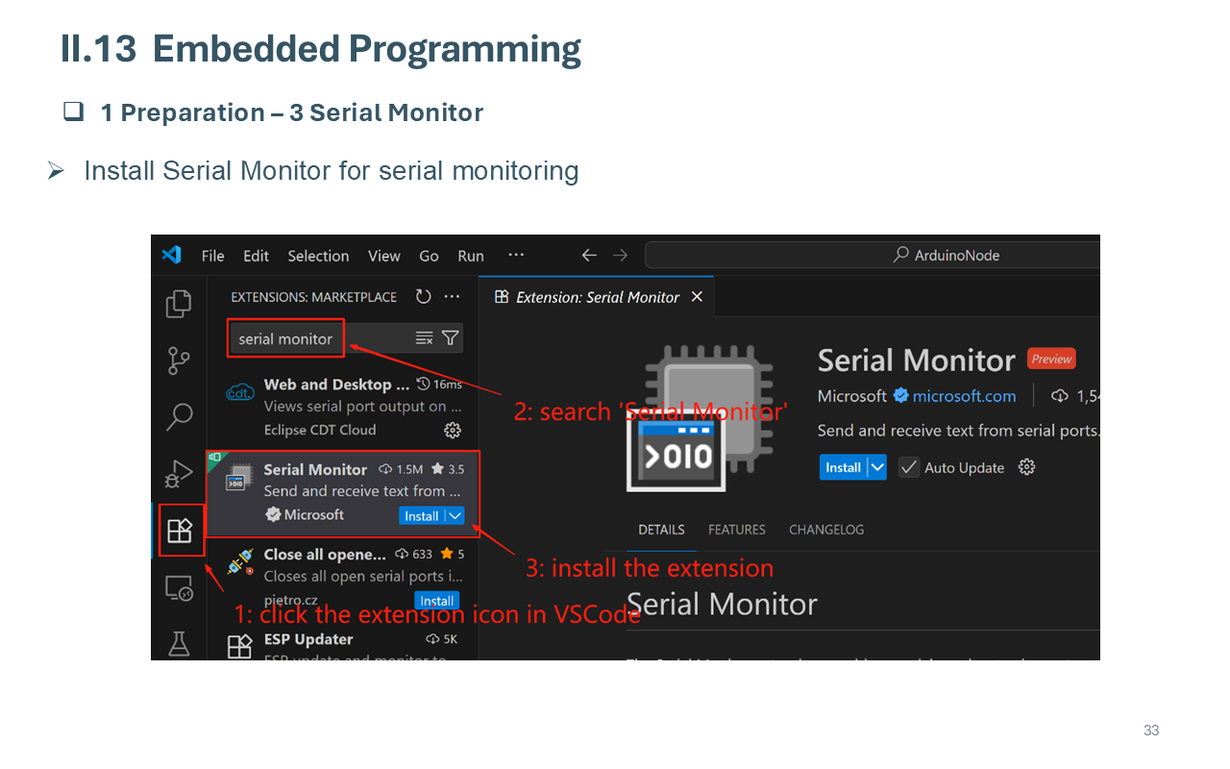
DEMO/.ppt-build/render-polished/slide-33.png
