Shuaiwen-Cui/ArduinoNode/DEMO/.ppt-build/render-polished/slide-35.png

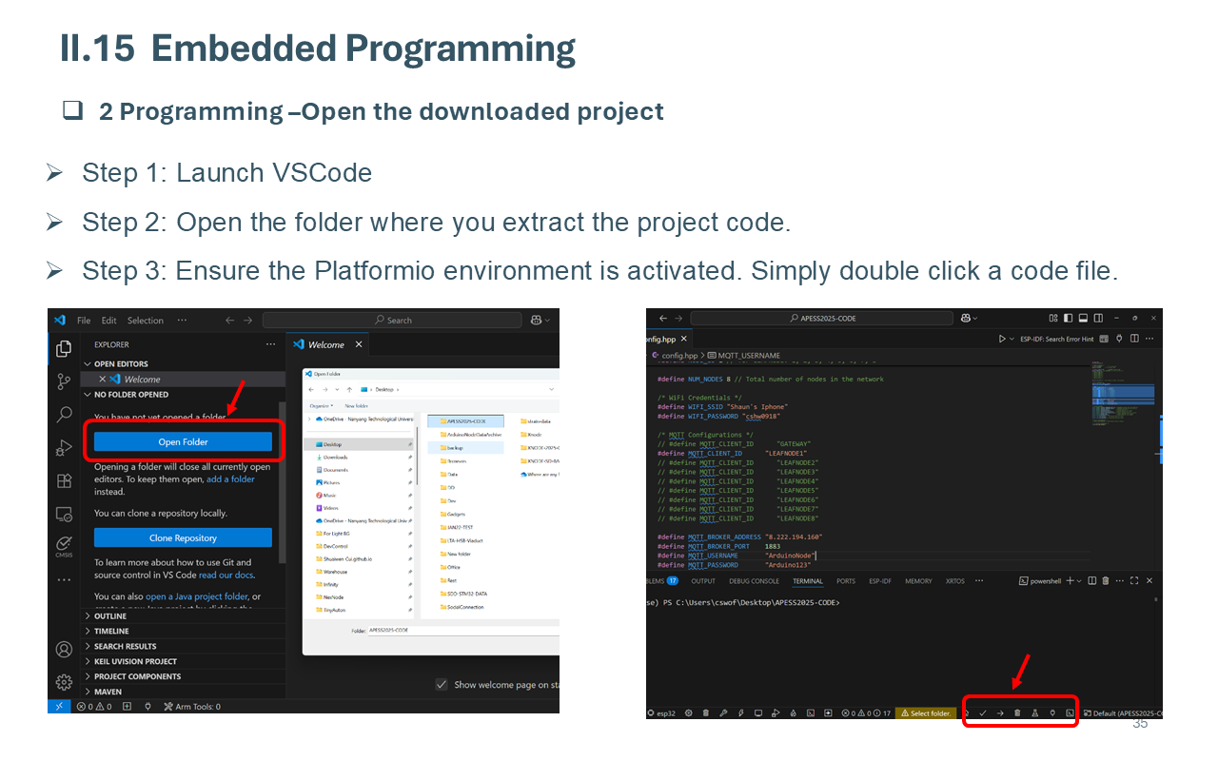
DEMO/.ppt-build/render-polished/slide-35.png
