Shuaiwen-Cui/ArduinoNode/DEMO/.ppt-build/render-polished/slide-37.png

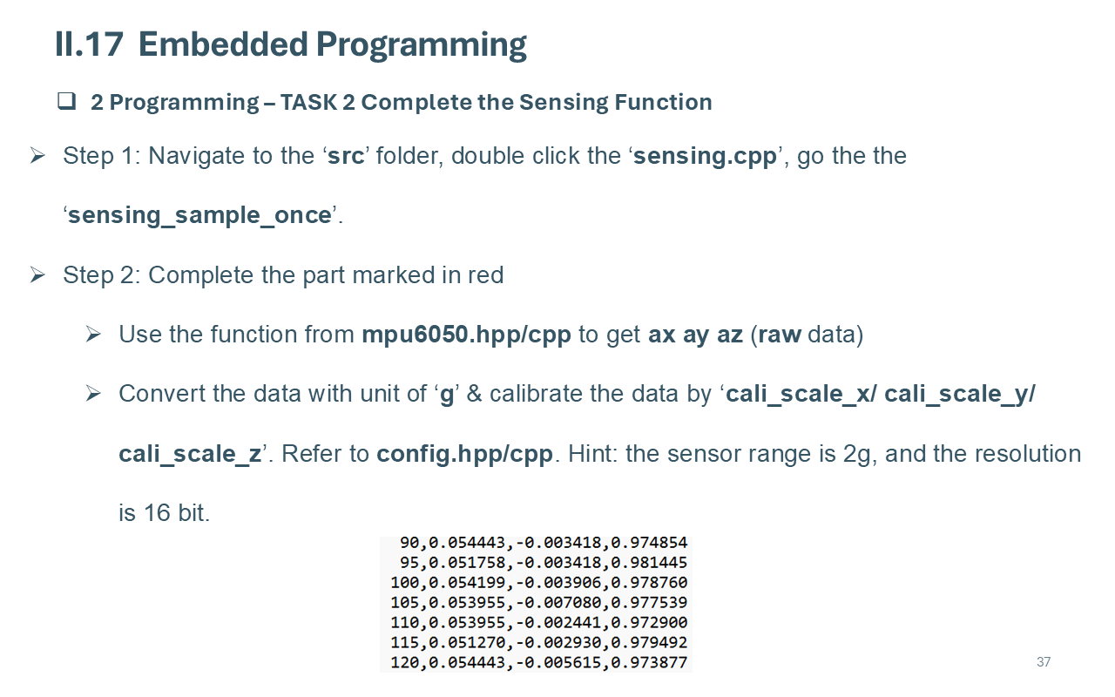
DEMO/.ppt-build/render-polished/slide-37.png
