Shuaiwen-Cui/ArduinoNode/DEMO/.ppt-build/render-polished/slide-38.png

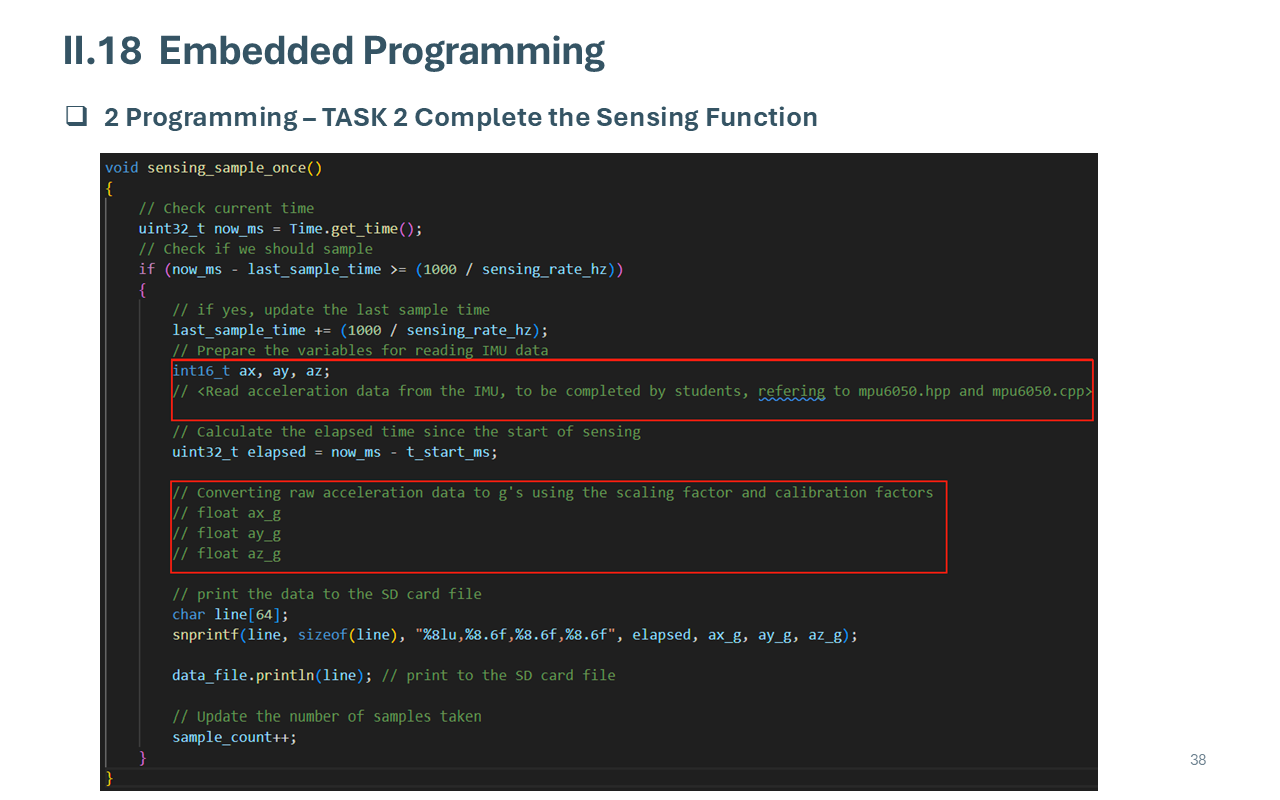
DEMO/.ppt-build/render-polished/slide-38.png
