Shuaiwen-Cui/ArduinoNode/DEMO/.ppt-build/render-polished/slide-39.png

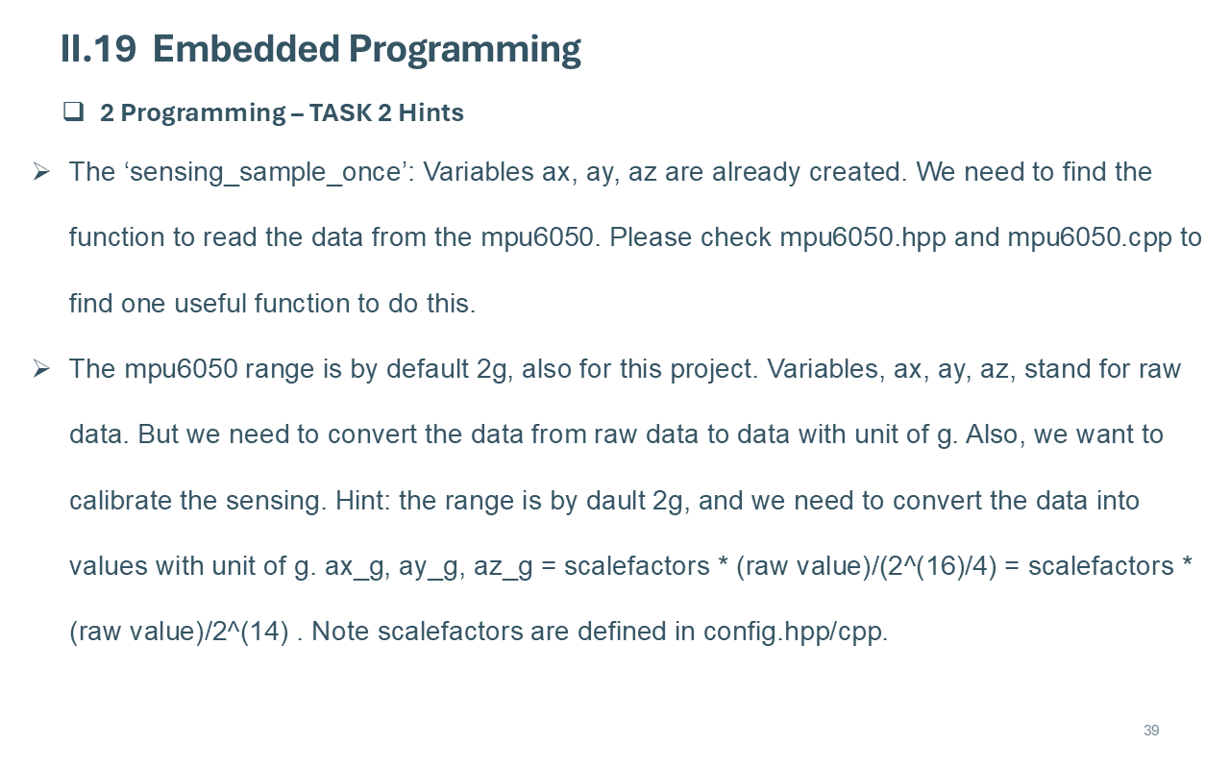
DEMO/.ppt-build/render-polished/slide-39.png
