Shuaiwen-Cui/ArduinoNode/DEMO/.ppt-build/render-polished/slide-43.png

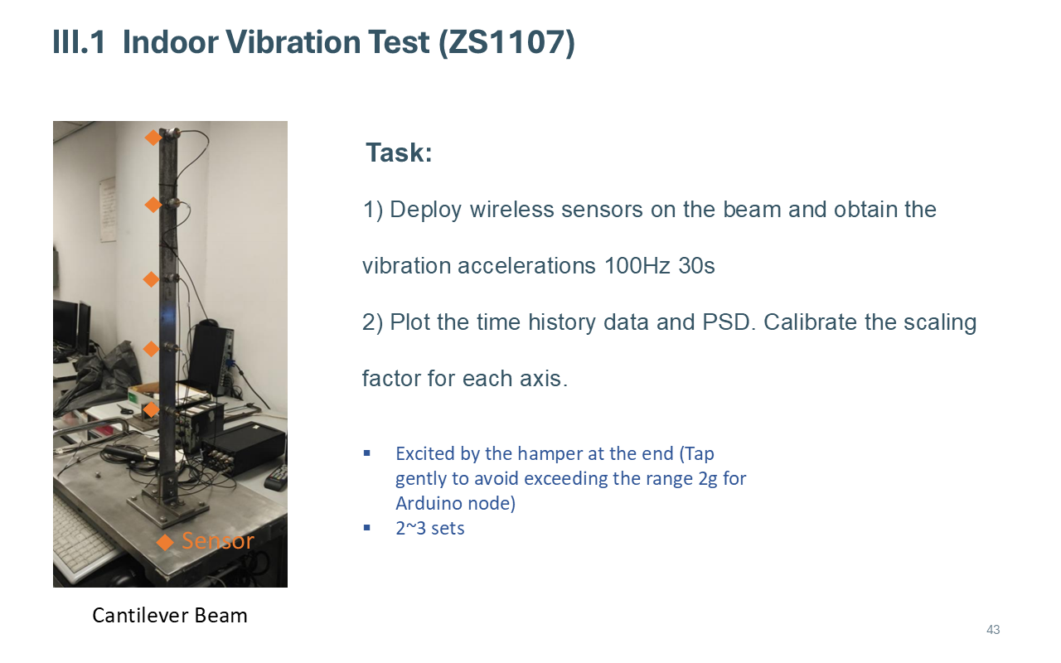
DEMO/.ppt-build/render-polished/slide-43.png
