Shuaiwen-Cui/ArduinoNode/DEMO/.ppt-build/render-polished/slide-44.png

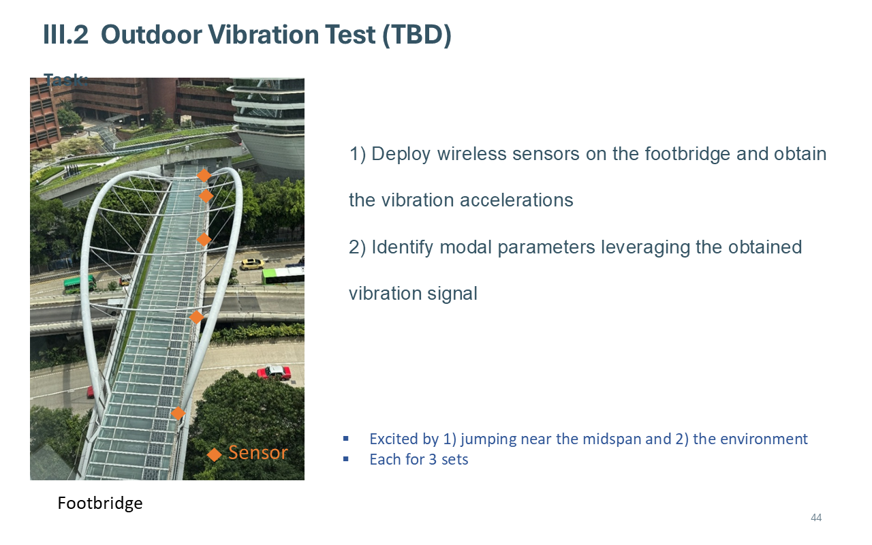
DEMO/.ppt-build/render-polished/slide-44.png
