Shuaiwen-Cui/ArduinoNode/DEMO/.ppt-build/render-source/slide-5.png

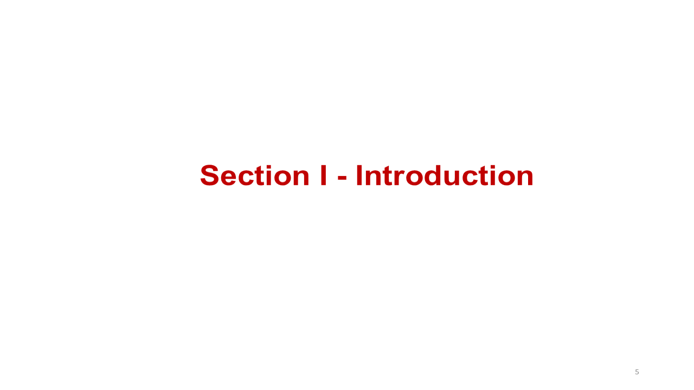
DEMO/.ppt-build/render-source/slide-5.png
