Shuaiwen-Cui/ArduinoNode/DEMO/.ppt-build/render-source/slide-7.png

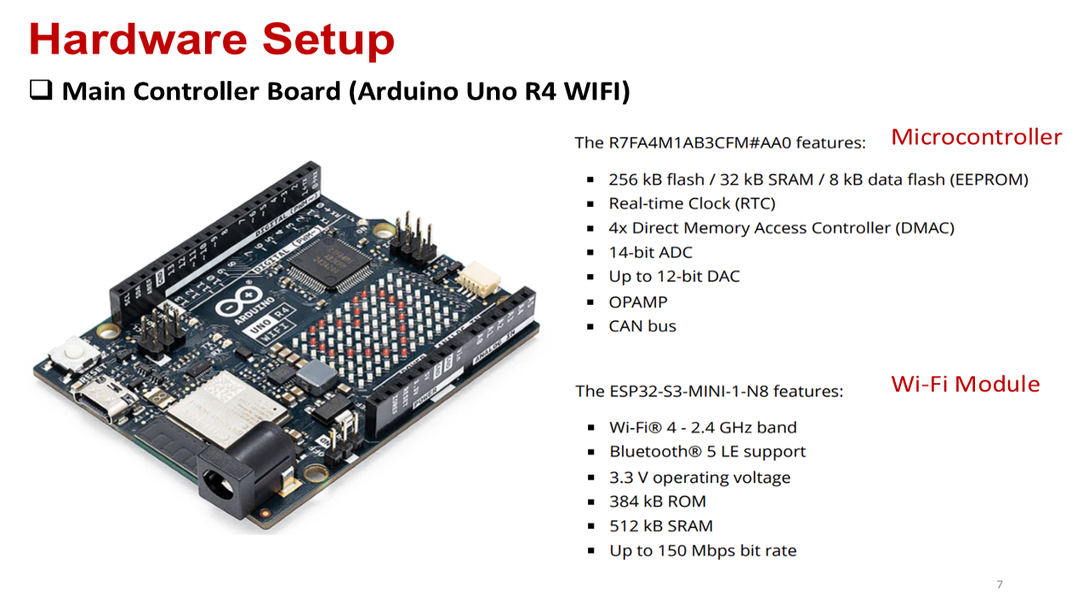
DEMO/.ppt-build/render-source/slide-7.png
