Shuaiwen-Cui/ArduinoNode/DEMO/.ppt-build/render-source/slide-12.png

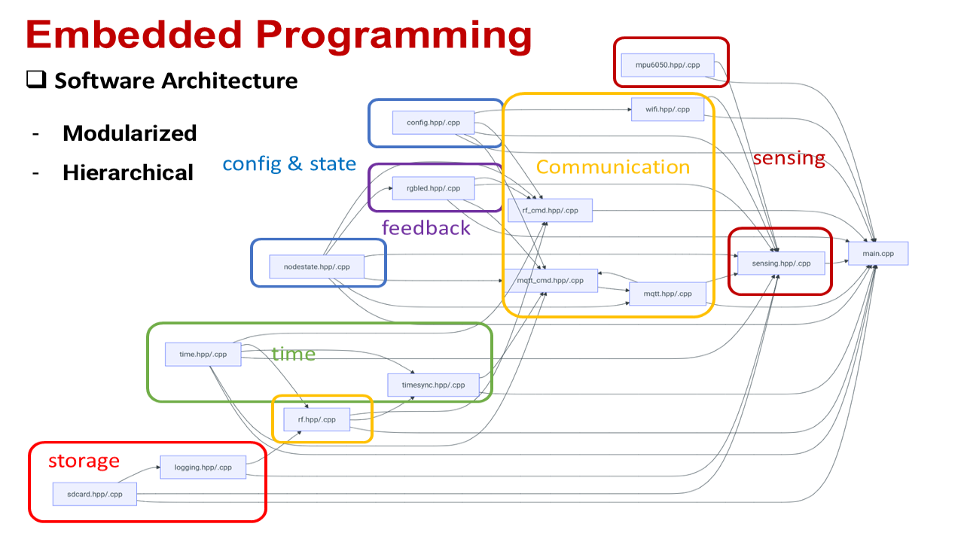
DEMO/.ppt-build/render-source/slide-12.png
