Shuaiwen-Cui/ArduinoNode/DEMO/.ppt-build/render-source/slide-20.png

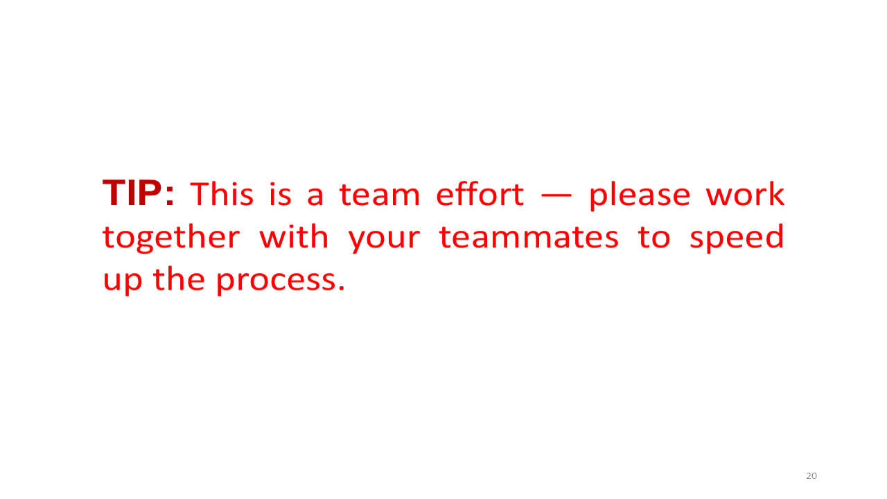
DEMO/.ppt-build/render-source/slide-20.png
