Shuaiwen-Cui/ArduinoNode/DEMO/.ppt-build/render-source/slide-22.png

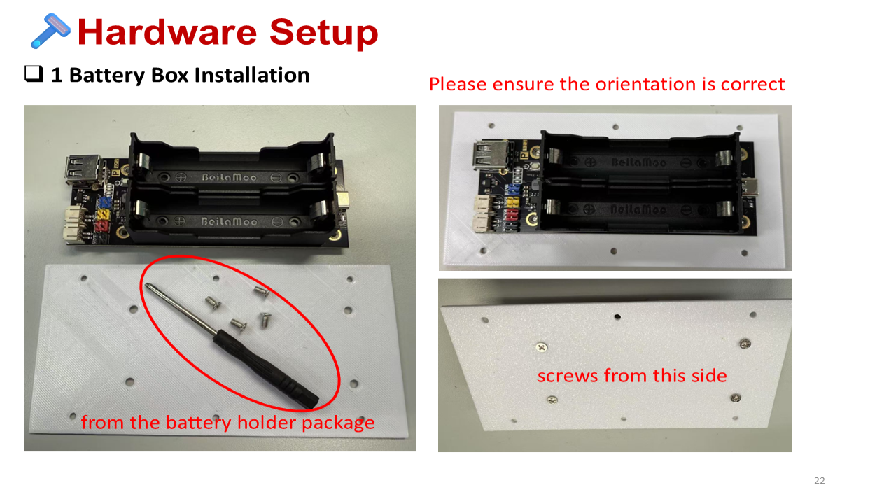
DEMO/.ppt-build/render-source/slide-22.png
