Shuaiwen-Cui/ArduinoNode/DEMO/.ppt-build/render-source/slide-27.png

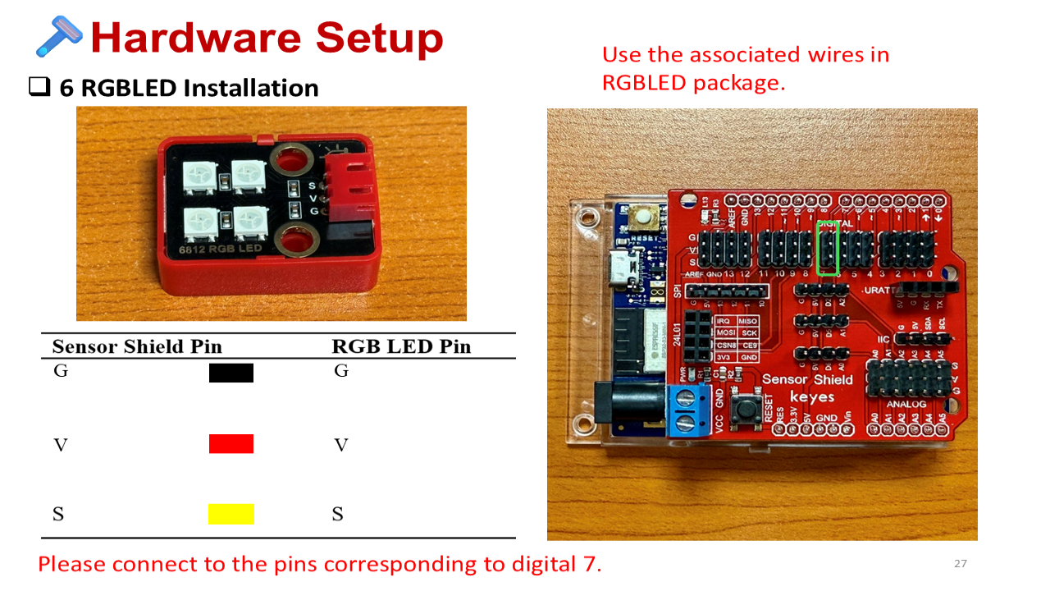
DEMO/.ppt-build/render-source/slide-27.png
