Shuaiwen-Cui/ArduinoNode/DEMO/.ppt-build/render-source/slide-30.png

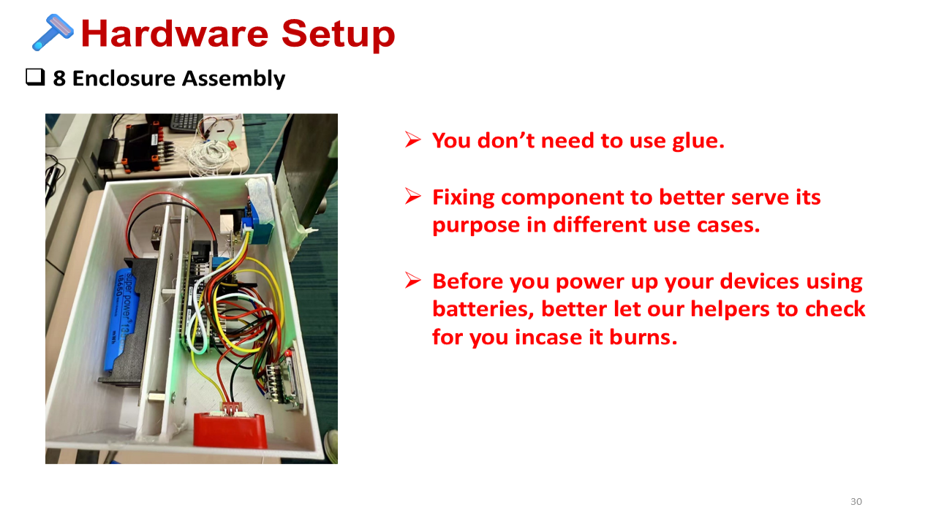
DEMO/.ppt-build/render-source/slide-30.png
