Shuaiwen-Cui/ArduinoNode/DEMO/.ppt-build/render-source/slide-33.png

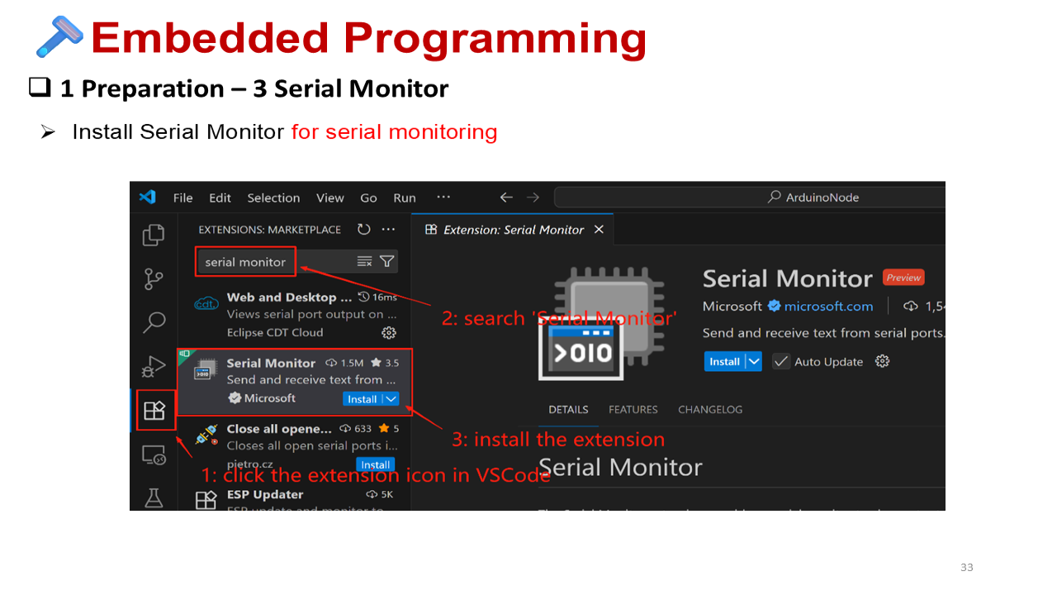
DEMO/.ppt-build/render-source/slide-33.png
