Shuaiwen-Cui/ArduinoNode/DEMO/.ppt-build/render-source/slide-38.png

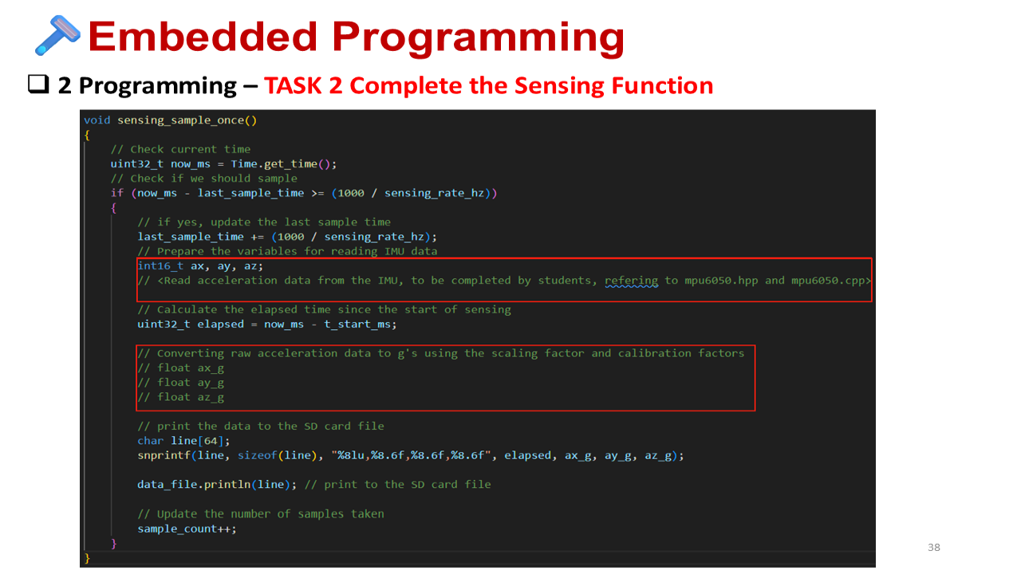
DEMO/.ppt-build/render-source/slide-38.png
