Shuaiwen-Cui/ArduinoNode/DEMO/.ppt-build/render-source/slide-39.png

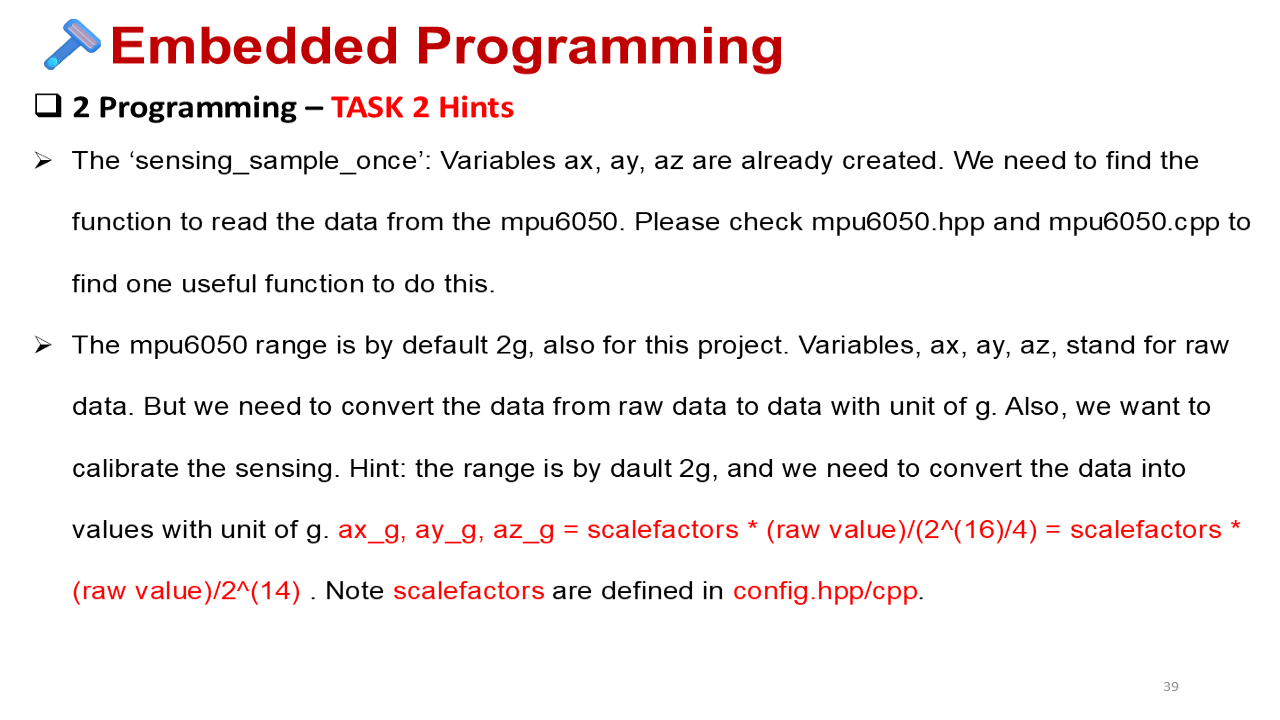
DEMO/.ppt-build/render-source/slide-39.png
