Shuaiwen-Cui/ArduinoNode/DEMO/.ppt-build/render-source/slide-41.png

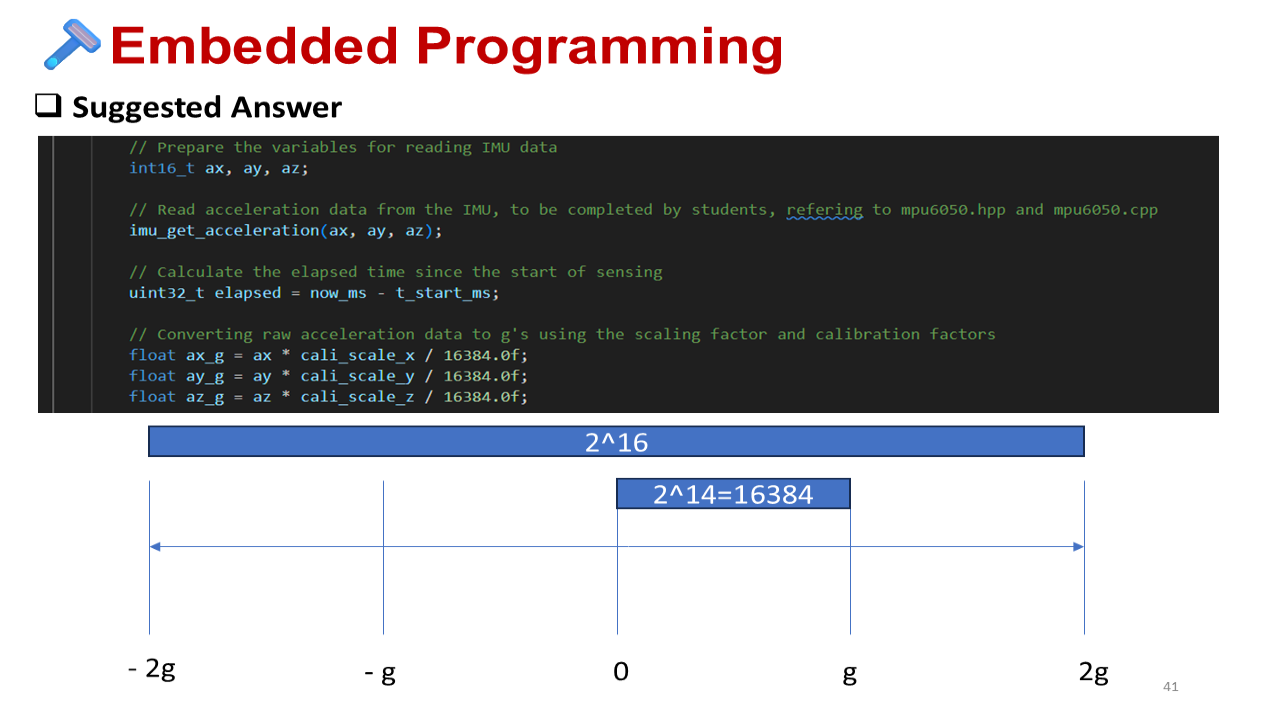
DEMO/.ppt-build/render-source/slide-41.png
