Shuaiwen-Cui/ArduinoNode/DEMO/.ppt-build/render-student/contact-1.jpg

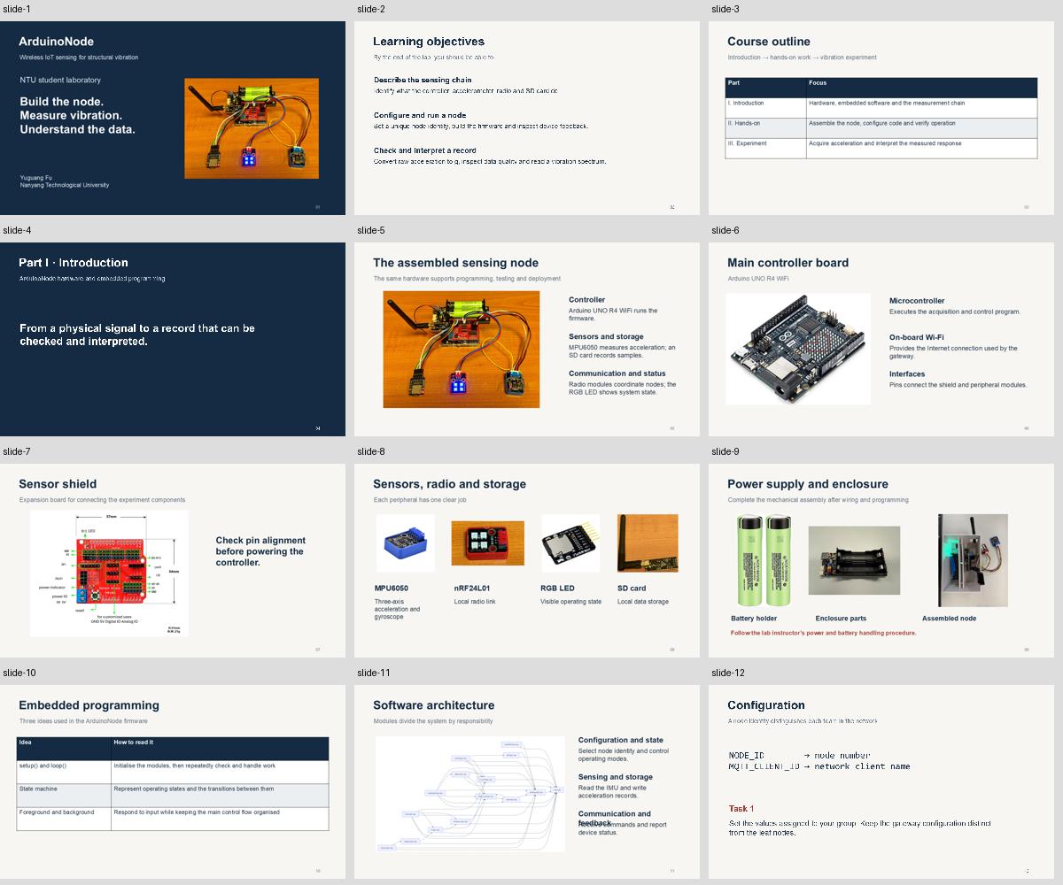
DEMO/.ppt-build/render-student/contact-1.jpg
