Shuaiwen-Cui/ArduinoNode/DEMO/.ppt-build/render-student/contact-2.jpg

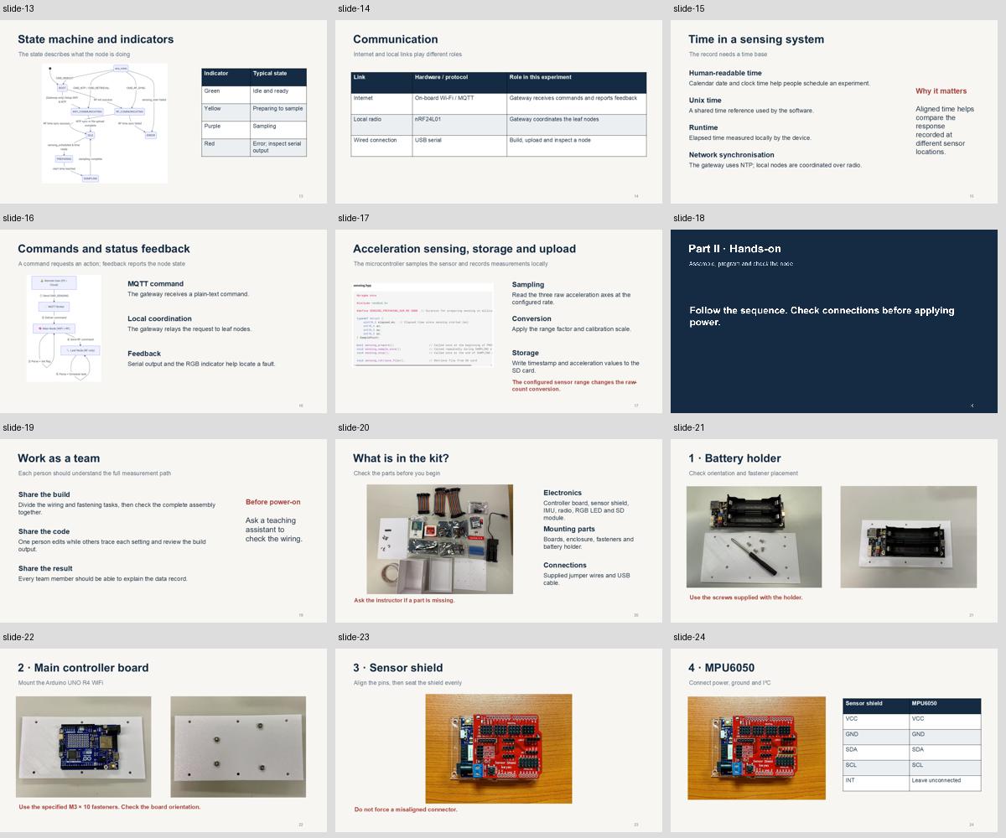
DEMO/.ppt-build/render-student/contact-2.jpg
