Shuaiwen-Cui/ArduinoNode/DEMO/.ppt-build/render-student/slide-2.png

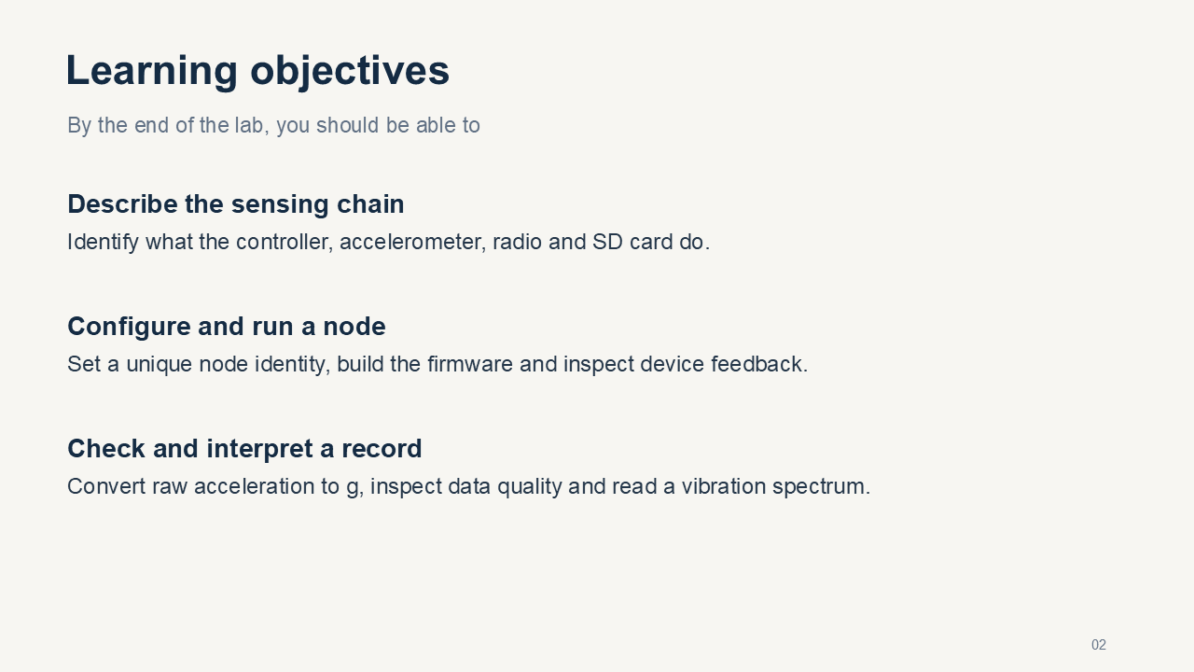
DEMO/.ppt-build/render-student/slide-2.png
