Shuaiwen-Cui/ArduinoNode/DEMO/.ppt-build/render-student/slide-3.png

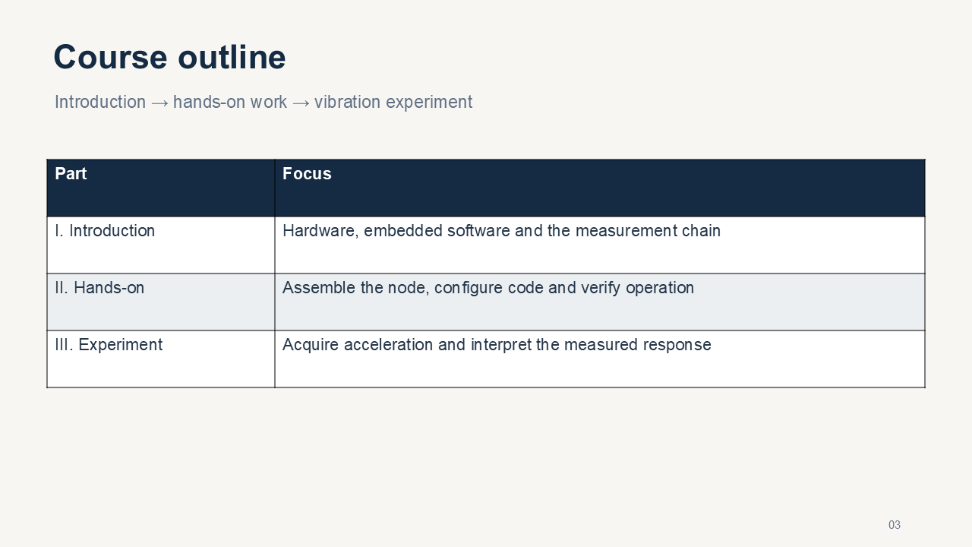
DEMO/.ppt-build/render-student/slide-3.png
