Shuaiwen-Cui/ArduinoNode/DEMO/.ppt-build/render-student/slide-5.png

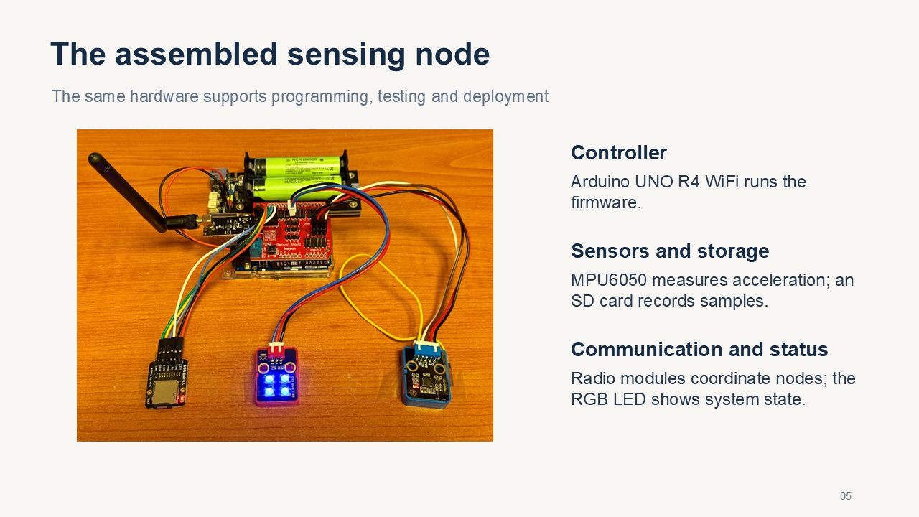
DEMO/.ppt-build/render-student/slide-5.png
