Shuaiwen-Cui/ArduinoNode/DEMO/.ppt-build/render-student/slide-6.png

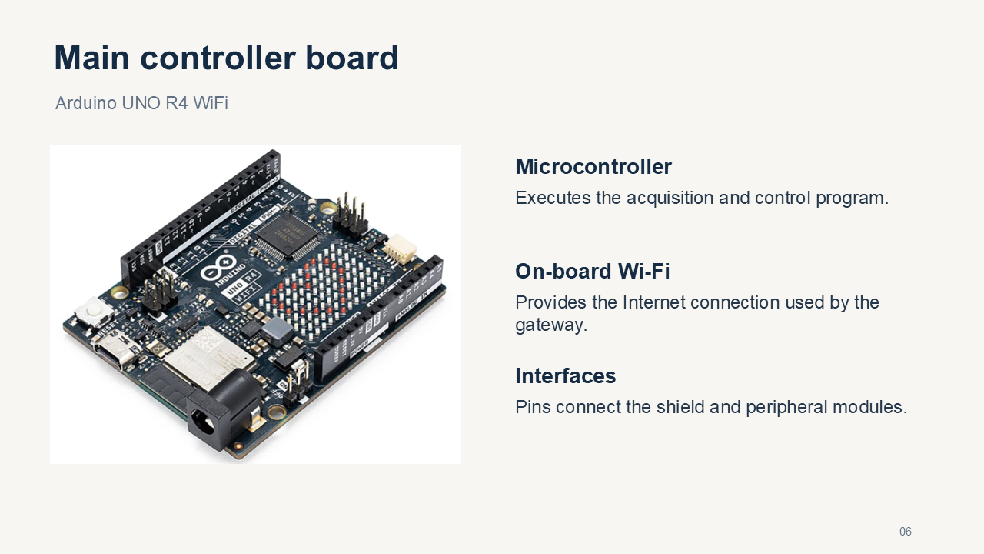
DEMO/.ppt-build/render-student/slide-6.png
