Shuaiwen-Cui/ArduinoNode/DEMO/.ppt-build/render-student/slide-8.png

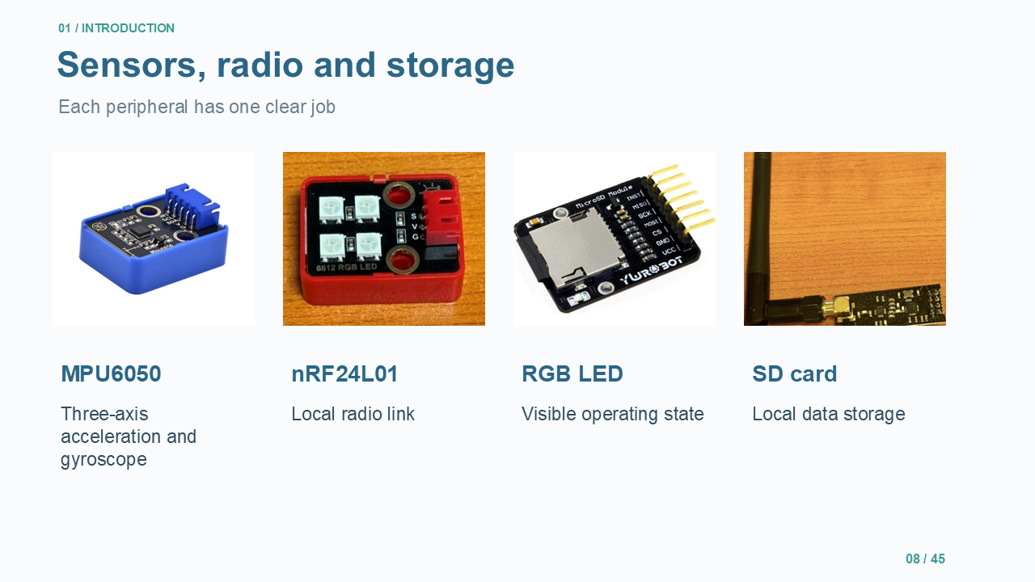
DEMO/.ppt-build/render-student/slide-8.png
