Shuaiwen-Cui/ArduinoNode/DEMO/.ppt-build/render-student/slide-11.png

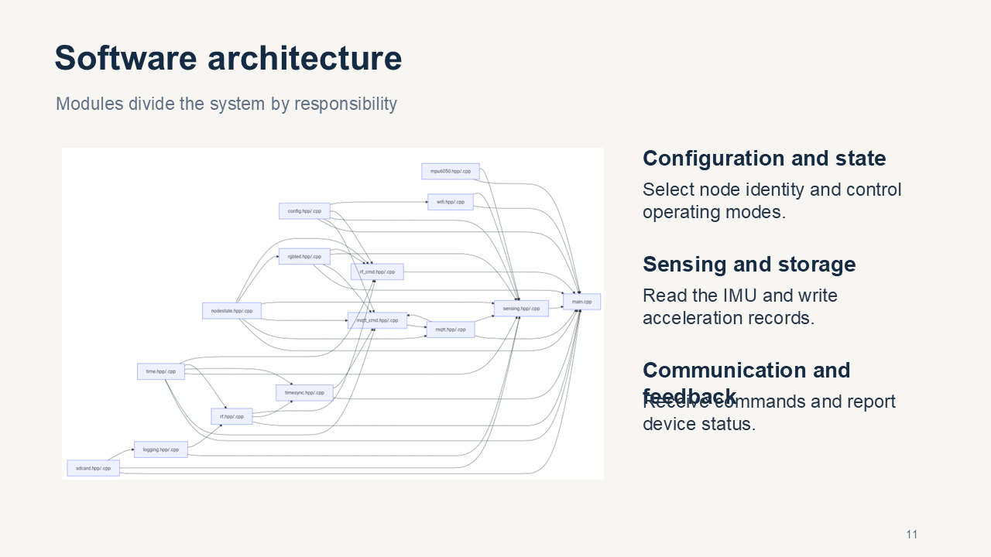
DEMO/.ppt-build/render-student/slide-11.png
