Shuaiwen-Cui/ArduinoNode/DEMO/.ppt-build/render-student/slide-13.png

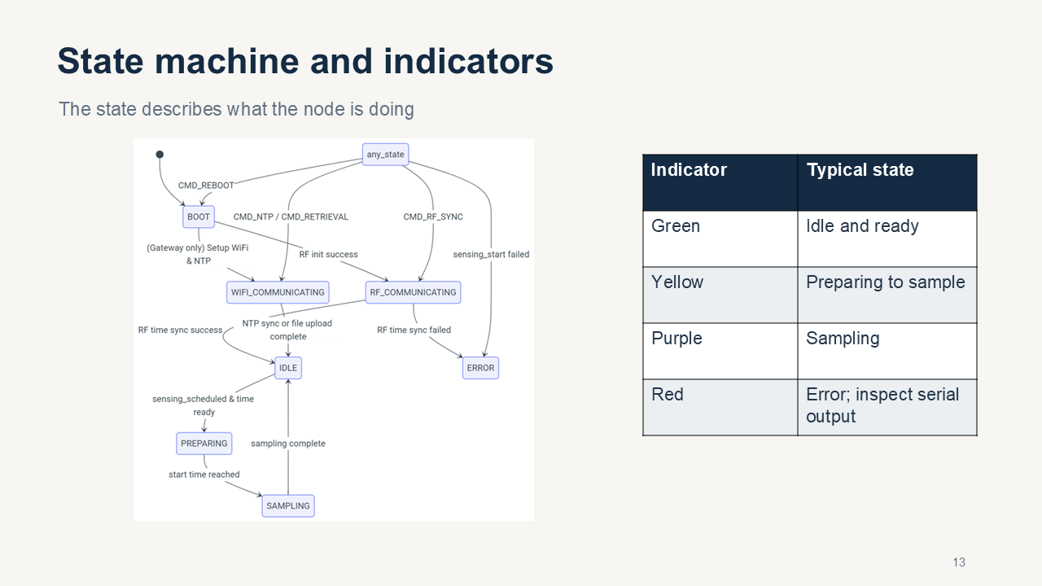
DEMO/.ppt-build/render-student/slide-13.png
