Shuaiwen-Cui/ArduinoNode/DEMO/.ppt-build/render-student/slide-14.png

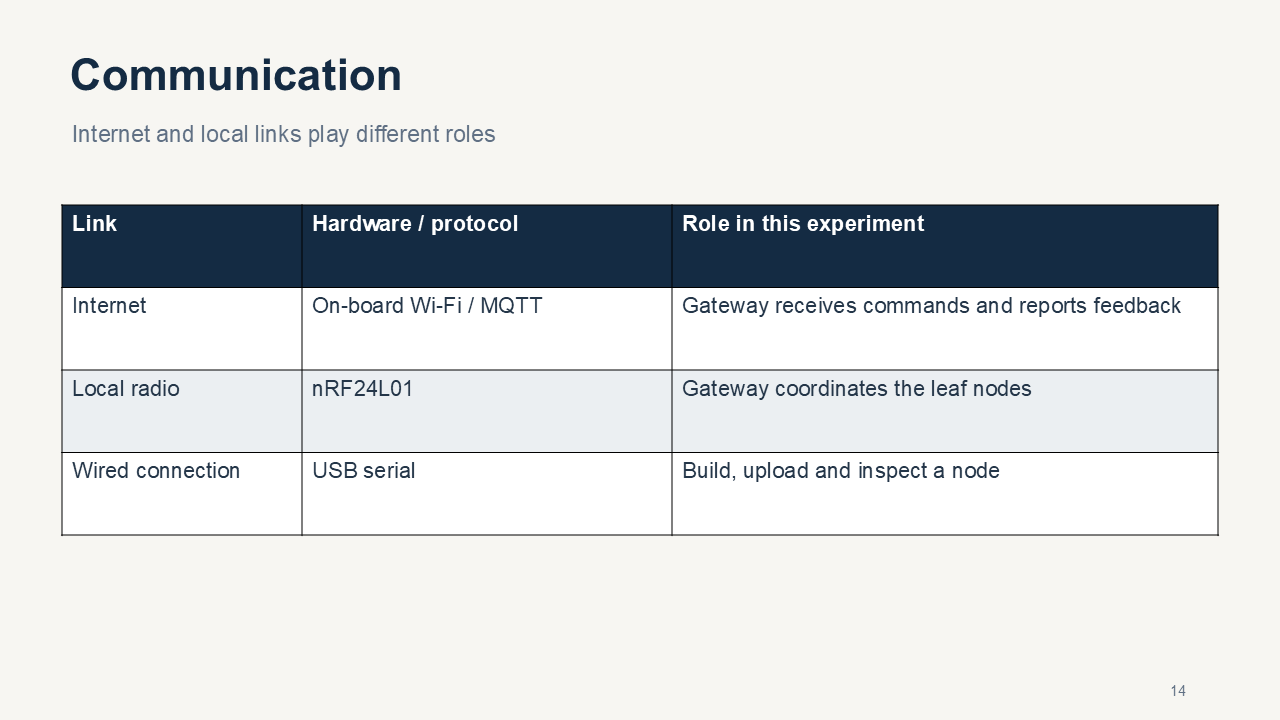
DEMO/.ppt-build/render-student/slide-14.png
