Shuaiwen-Cui/ArduinoNode/DEMO/.ppt-build/render-student/slide-15.png

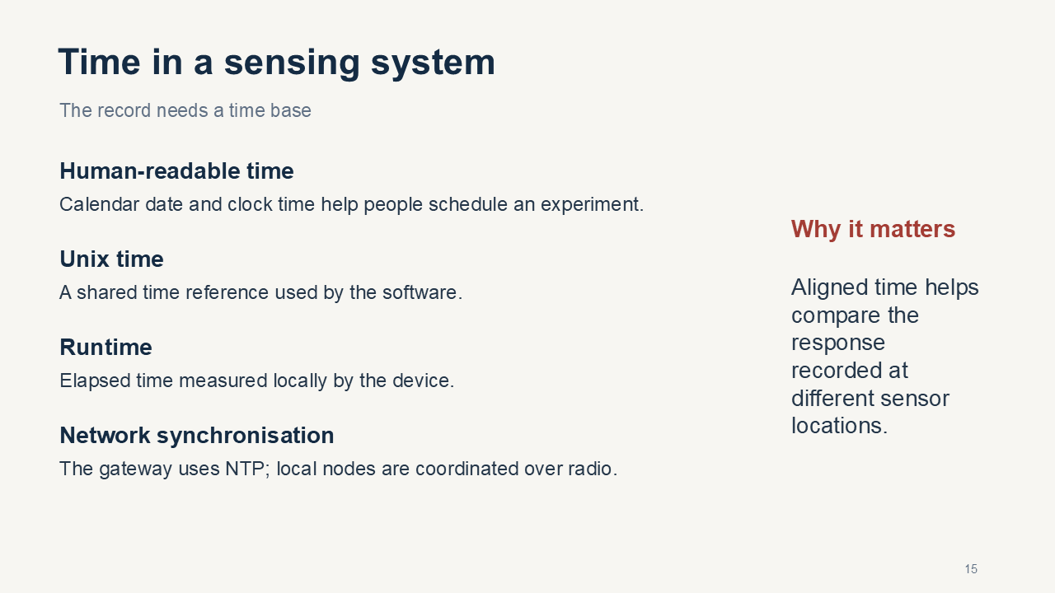
DEMO/.ppt-build/render-student/slide-15.png
