Shuaiwen-Cui/ArduinoNode/DEMO/.ppt-build/render-student/slide-17.png

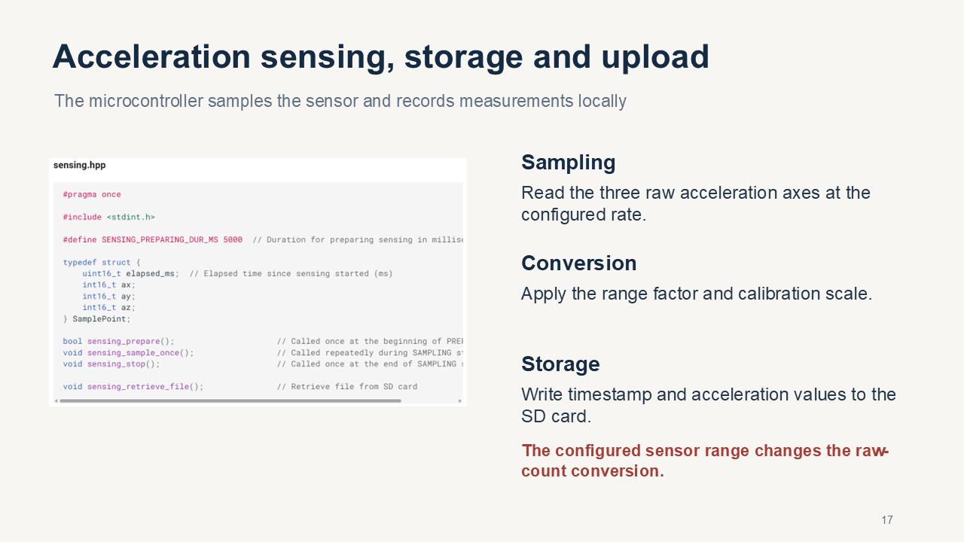
DEMO/.ppt-build/render-student/slide-17.png
