Shuaiwen-Cui/ArduinoNode/DEMO/.ppt-build/render-student/slide-18.png

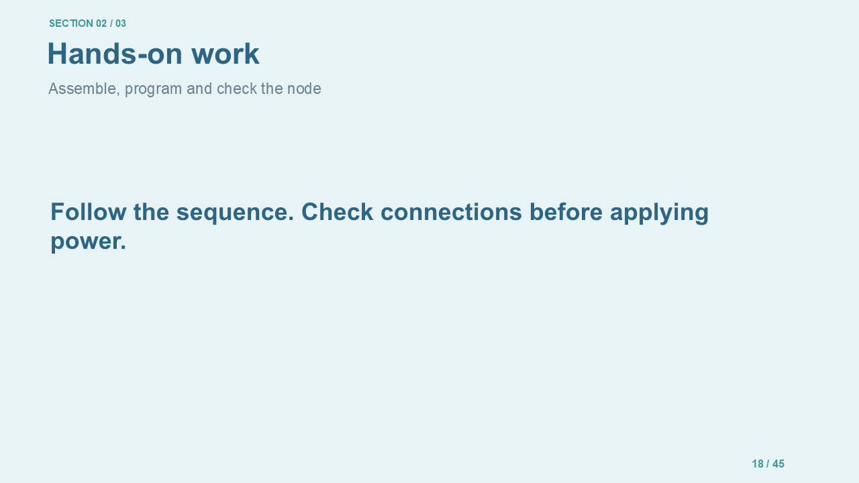
DEMO/.ppt-build/render-student/slide-18.png
