Shuaiwen-Cui/ArduinoNode/DEMO/.ppt-build/render-student/slide-23.png

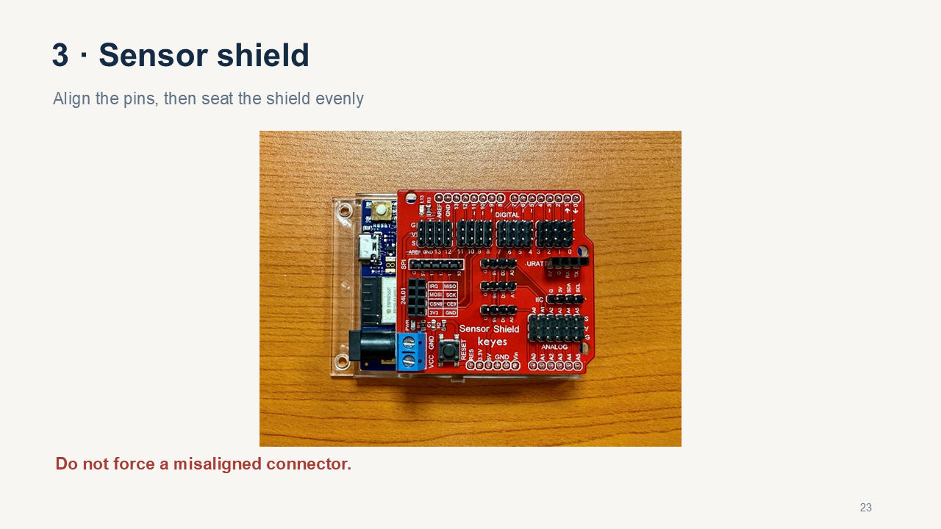
DEMO/.ppt-build/render-student/slide-23.png
