Shuaiwen-Cui/ArduinoNode/DEMO/.ppt-build/render-student/slide-25.png

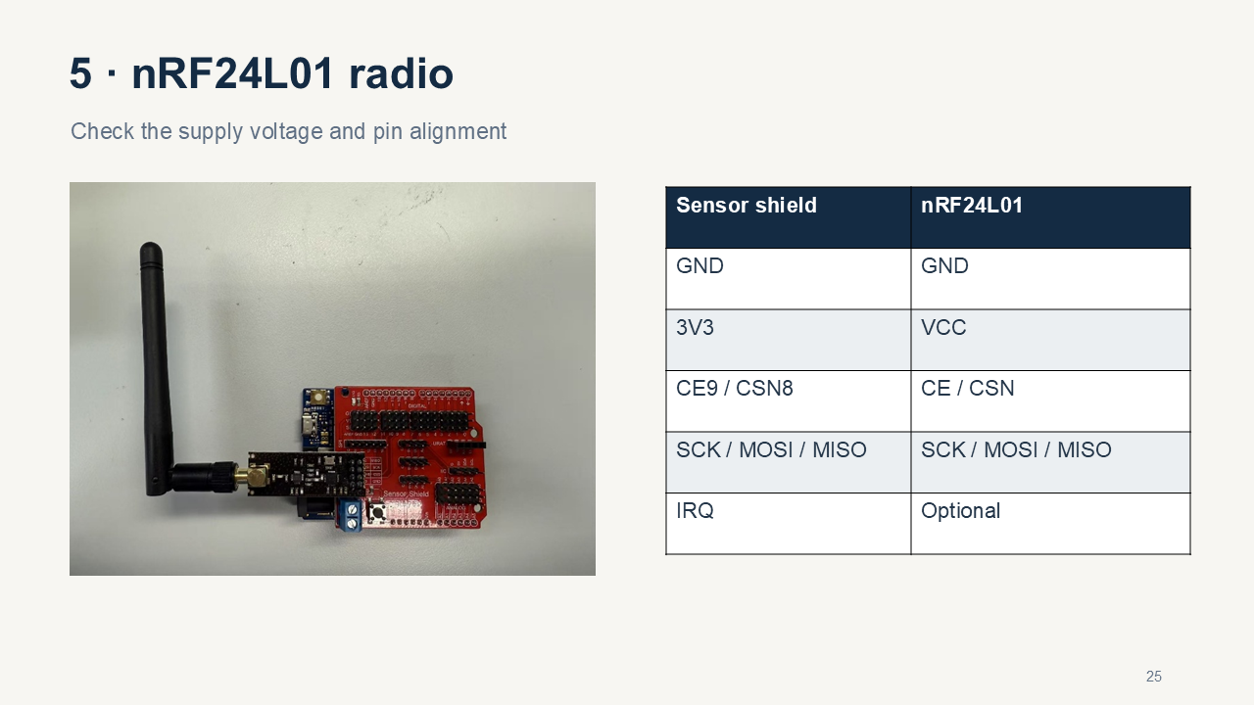
DEMO/.ppt-build/render-student/slide-25.png
