Shuaiwen-Cui/ArduinoNode/DEMO/.ppt-build/render-student/slide-27.png

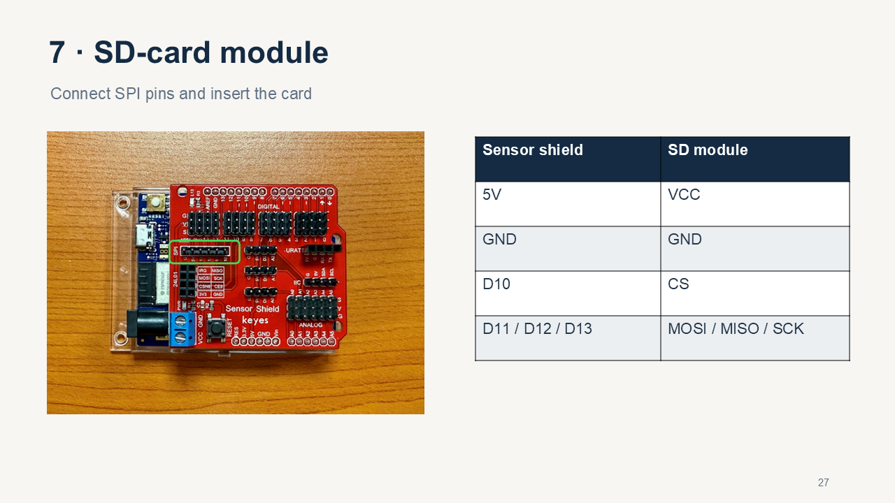
DEMO/.ppt-build/render-student/slide-27.png
