Shuaiwen-Cui/ArduinoNode/DEMO/.ppt-build/render-student/slide-29.png

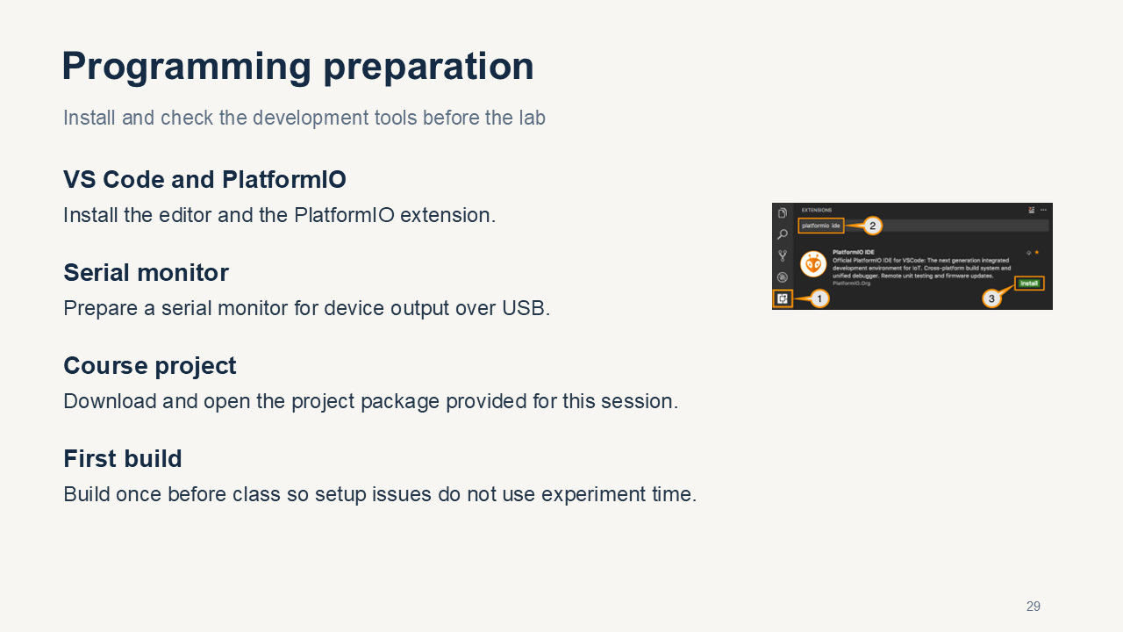
DEMO/.ppt-build/render-student/slide-29.png
