Shuaiwen-Cui/ArduinoNode/DEMO/.ppt-build/render-student/slide-32.png

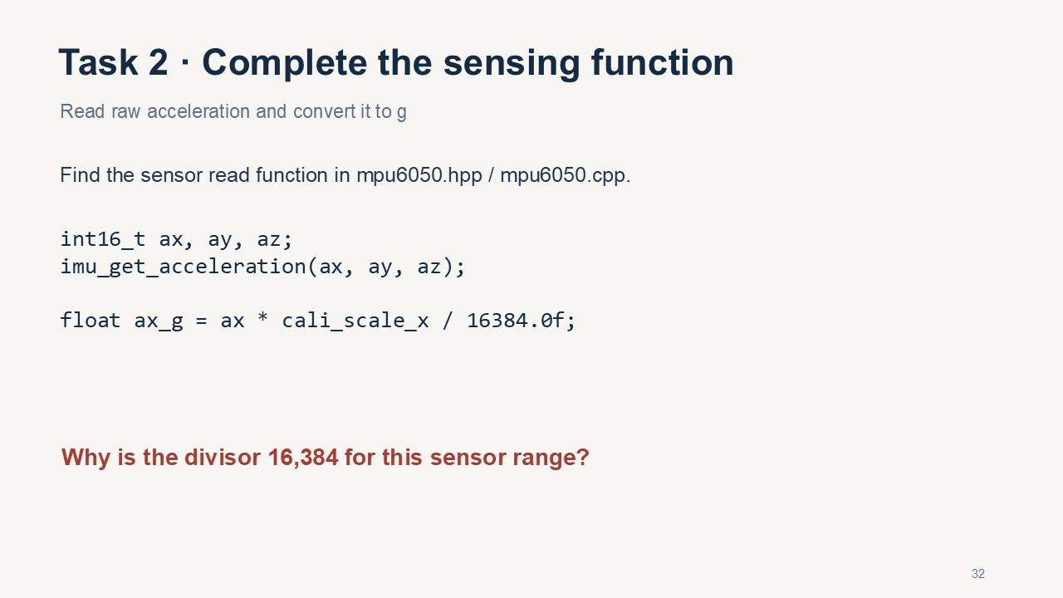
DEMO/.ppt-build/render-student/slide-32.png
