Shuaiwen-Cui/ArduinoNode/DEMO/.ppt-build/render-student/slide-33.png

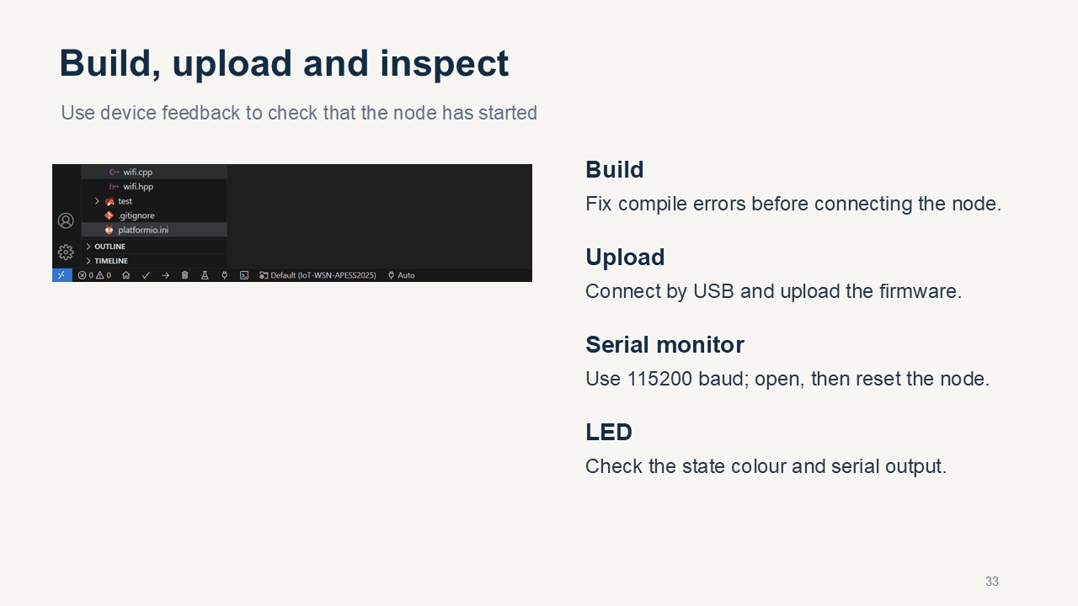
DEMO/.ppt-build/render-student/slide-33.png
