Shuaiwen-Cui/ArduinoNode/DEMO/.ppt-build/render-student/slide-36.png

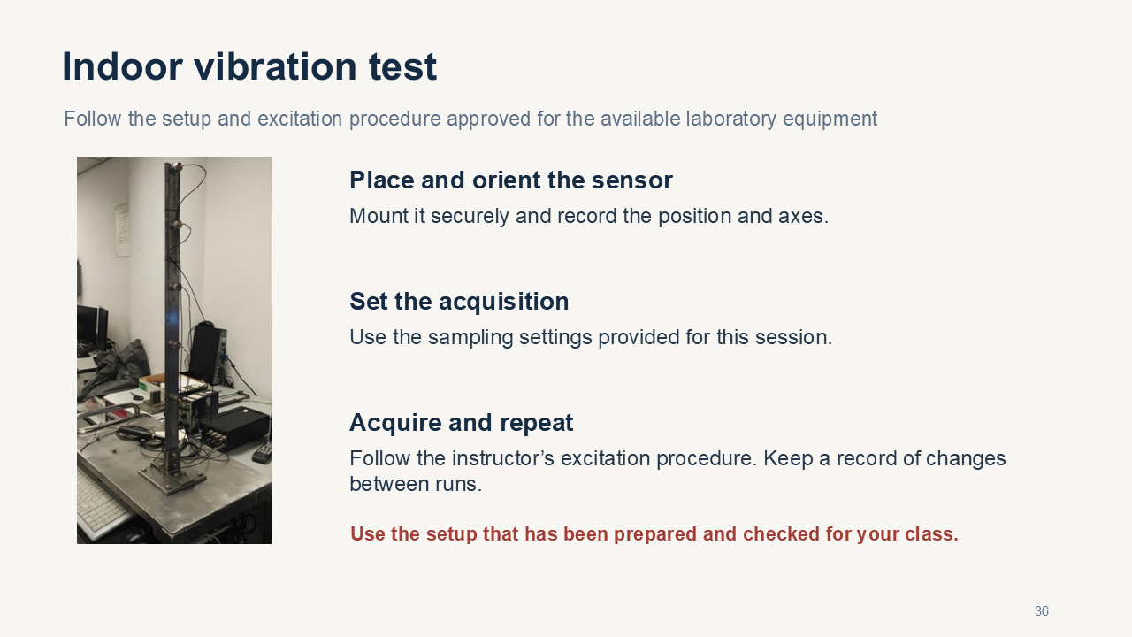
DEMO/.ppt-build/render-student/slide-36.png
