Shuaiwen-Cui/ArduinoNode/DEMO/.ppt-build/render-student/slide-37.png

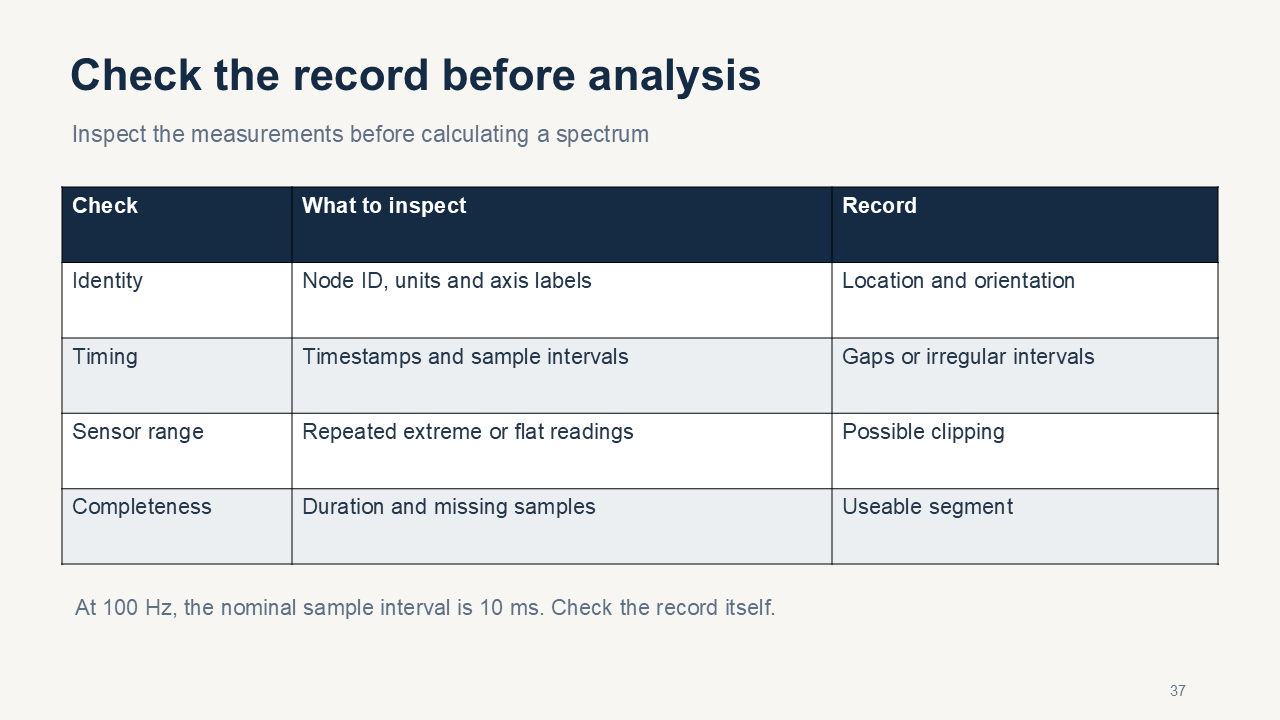
DEMO/.ppt-build/render-student/slide-37.png
