Shuaiwen-Cui/ArduinoNode/DEMO/.ppt-build/render-student/slide-38.png

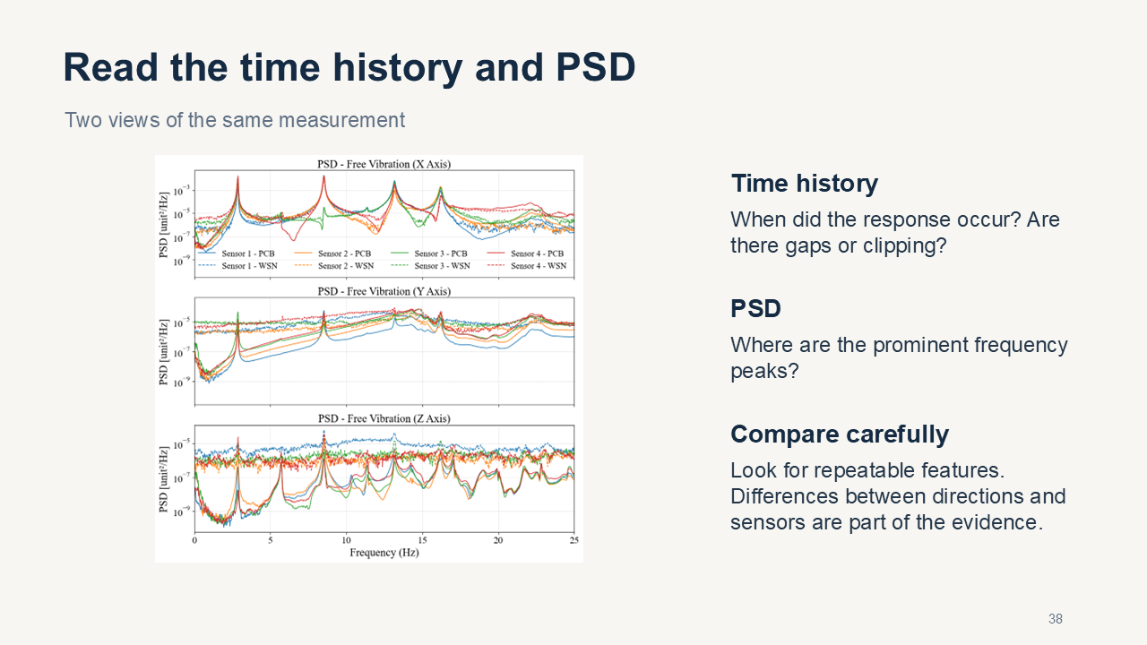
DEMO/.ppt-build/render-student/slide-38.png
