Shuaiwen-Cui/ArduinoNode/DEMO/.ppt-build/render-student/slide-39.png

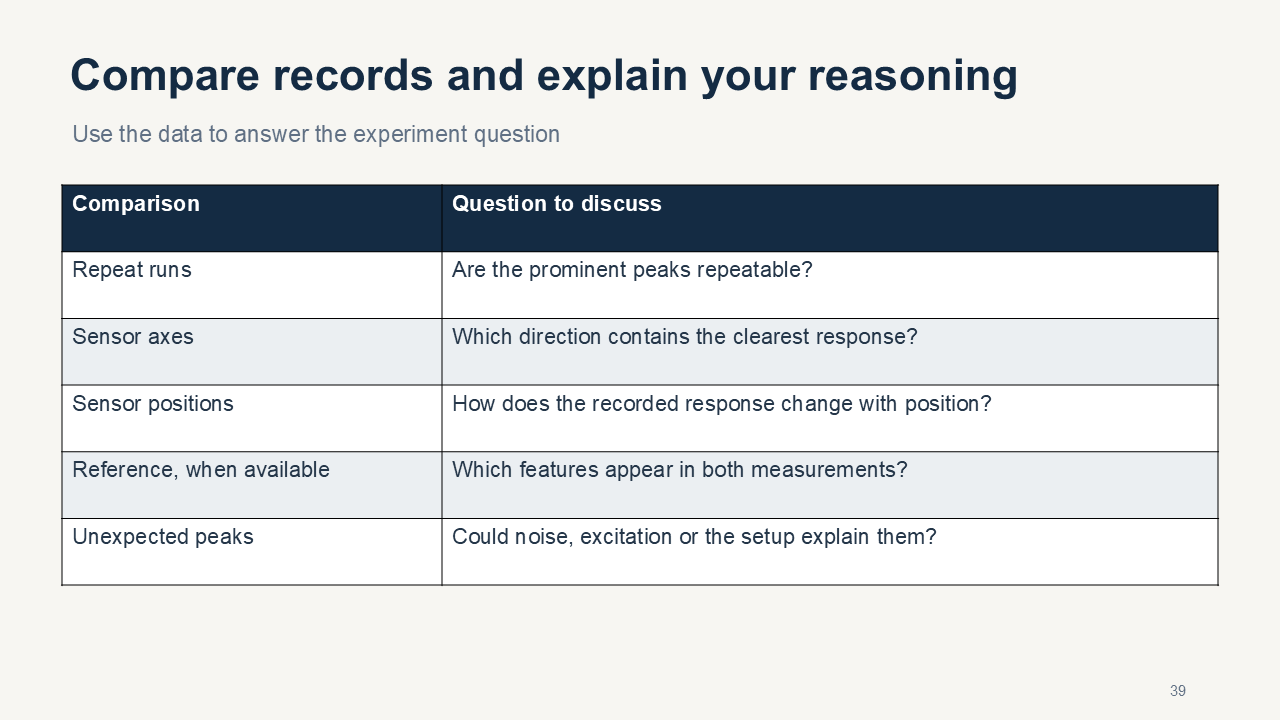
DEMO/.ppt-build/render-student/slide-39.png
