Shuaiwen-Cui/ArduinoNode/DEMO/.ppt-build/render-student/slide-41.png

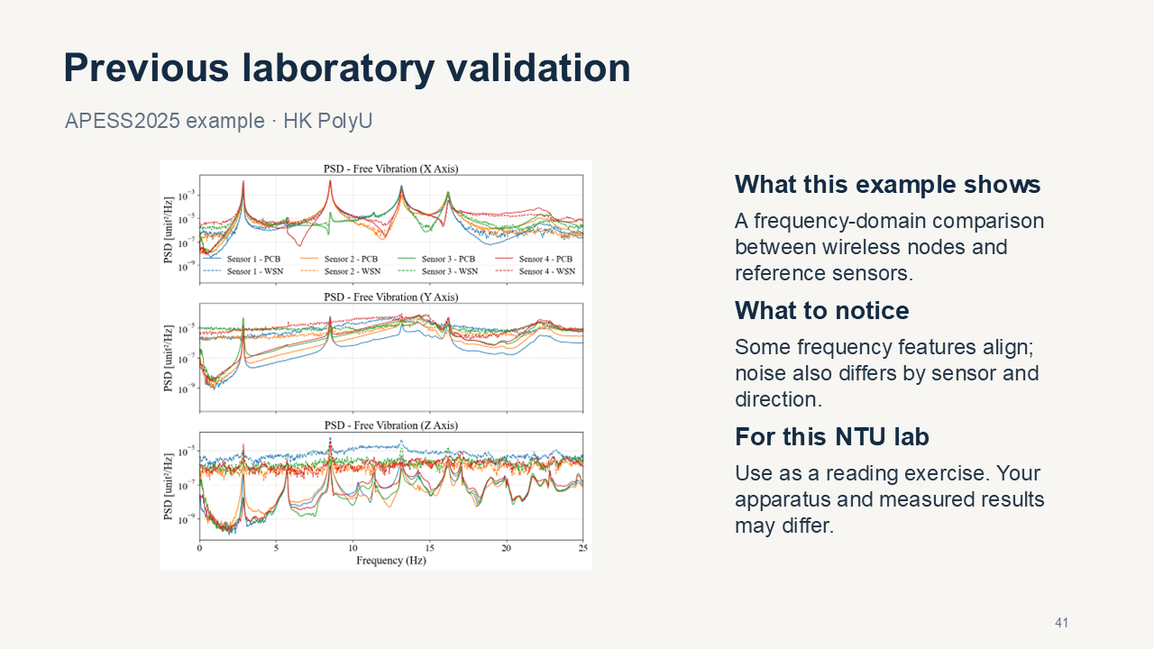
DEMO/.ppt-build/render-student/slide-41.png
