Shuaiwen-Cui/ArduinoNode/DEMO/.ppt-build/render-student/slide-43.png

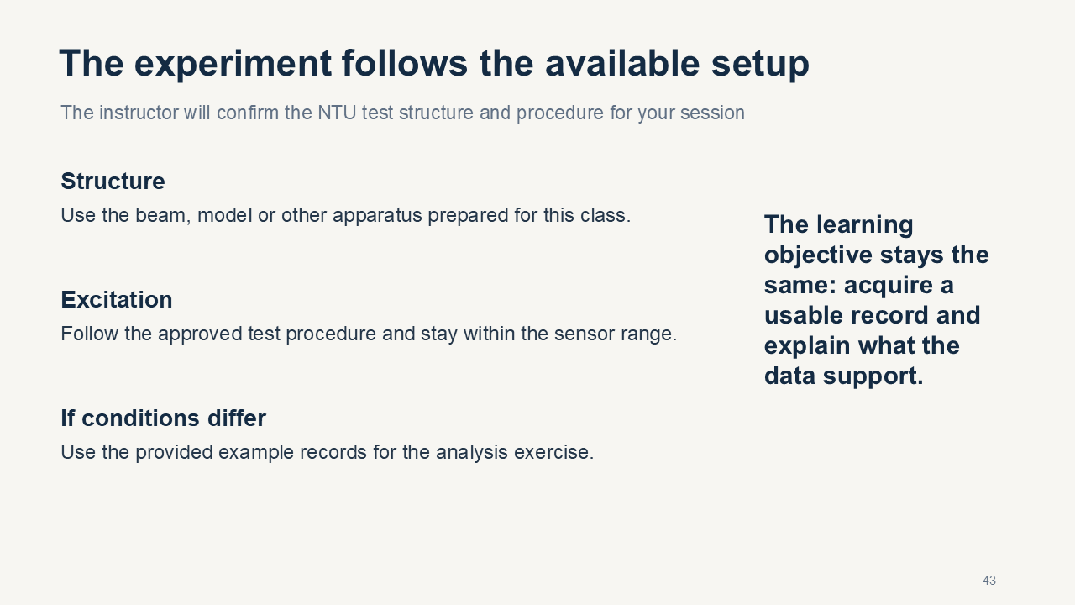
DEMO/.ppt-build/render-student/slide-43.png
