Shuaiwen-Cui/ArduinoNode/DEMO/.ppt-build/render-student/slide-44.png

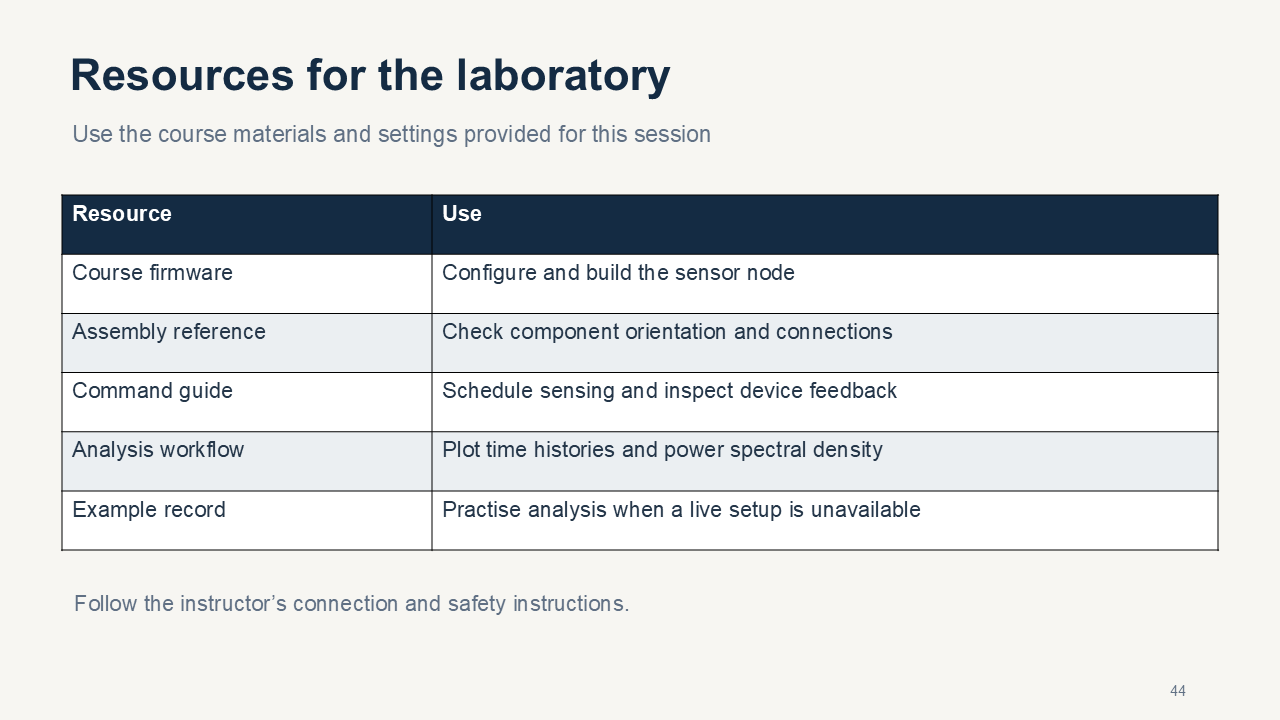
DEMO/.ppt-build/render-student/slide-44.png
