Shuaiwen-Cui/ArduinoNode/DEMO/.ppt-build/render-student/slide-45.png

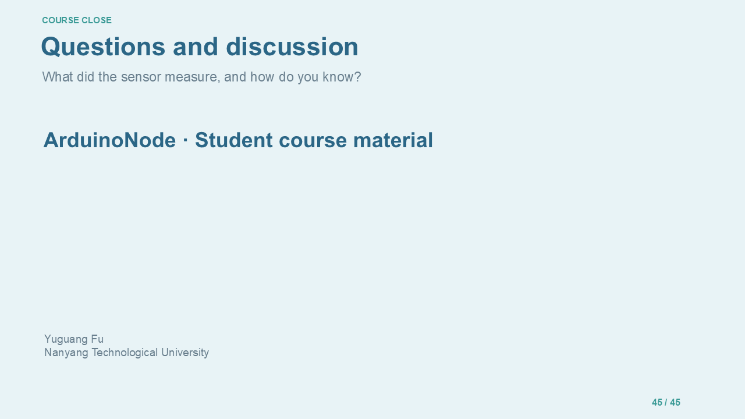
DEMO/.ppt-build/render-student/slide-45.png
