Shuaiwen-Cui/ArduinoNode/DEMO/.ppt-build/render-v7-final/contact-17-32.png

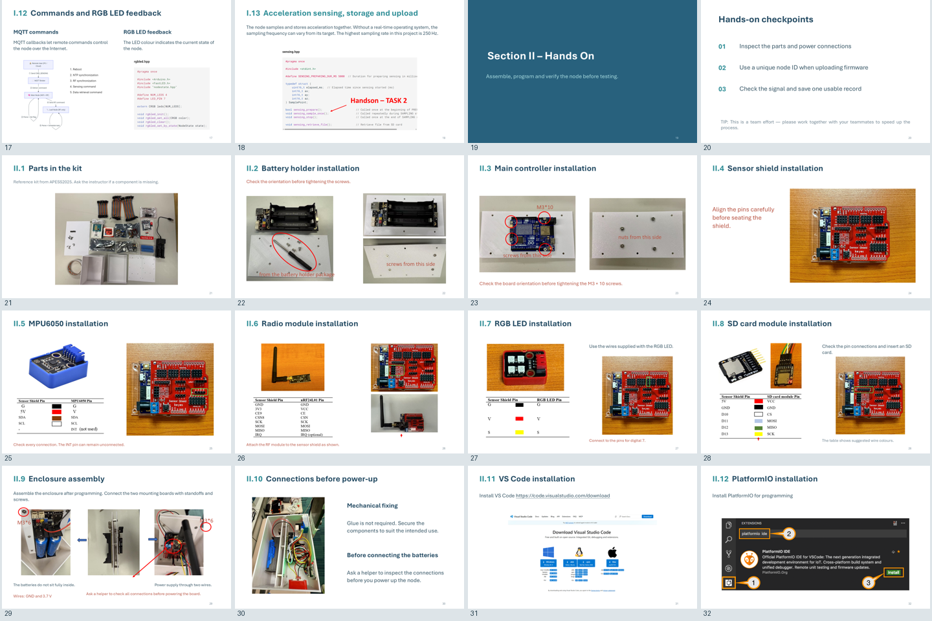
DEMO/.ppt-build/render-v7-final/contact-17-32.png
