Shuaiwen-Cui/ArduinoNode/DEMO/.ppt-build/render-v7-final/contact-33-48.png

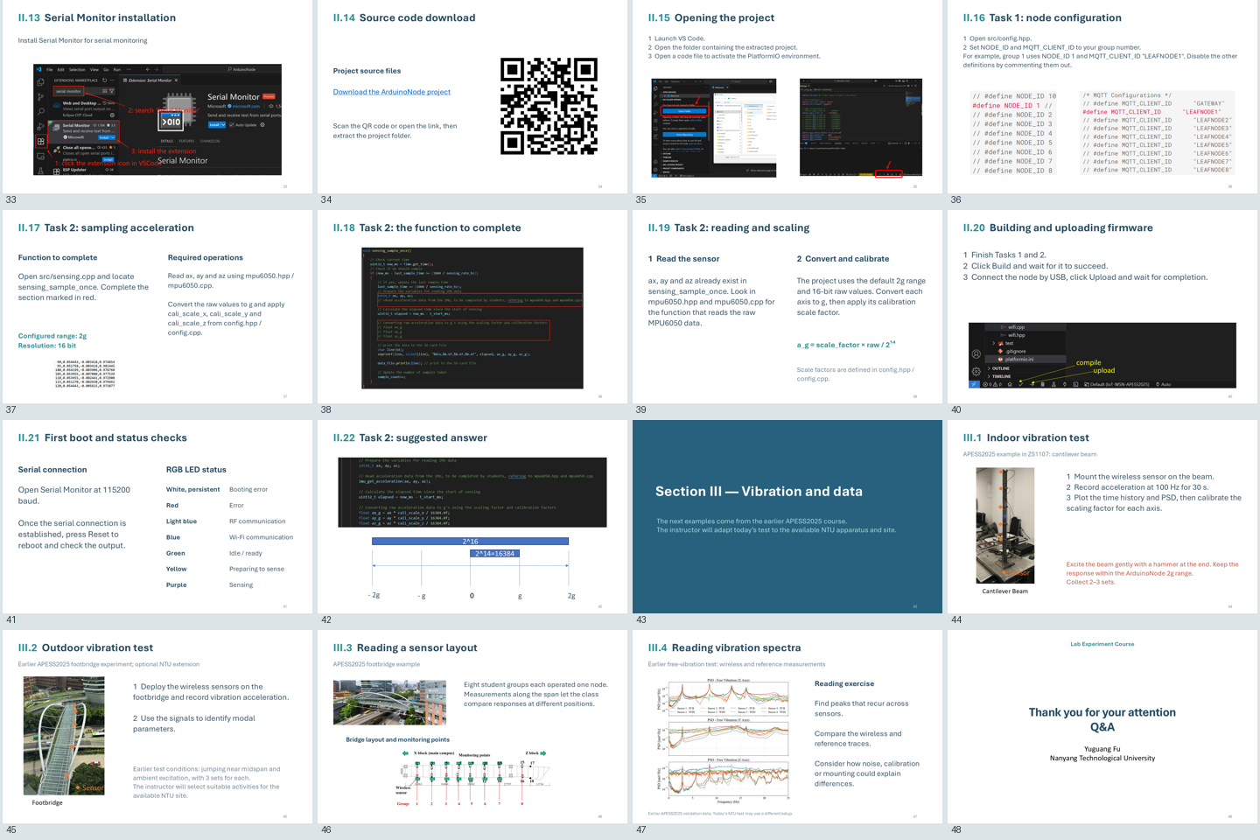
DEMO/.ppt-build/render-v7-final/contact-33-48.png
