Shuaiwen-Cui/ArduinoNode/DEMO/.ppt-build/render-v7-final/slide-4.png

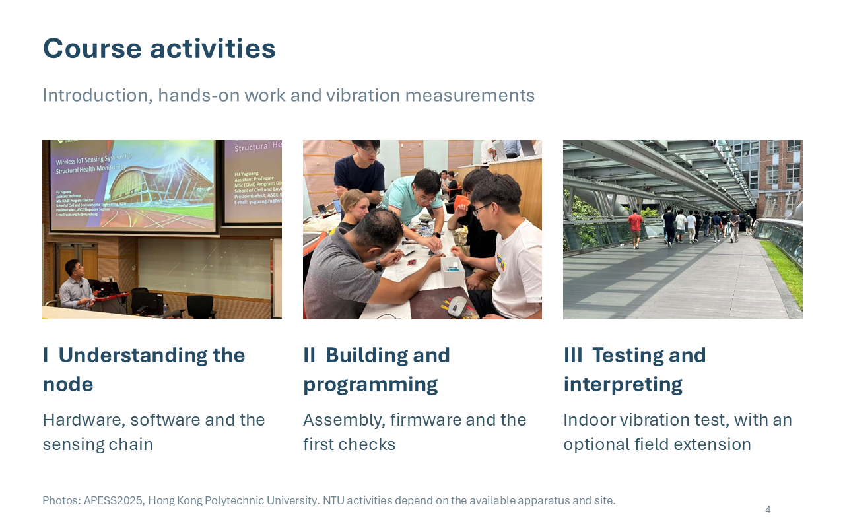
DEMO/.ppt-build/render-v7-final/slide-4.png
