Shuaiwen-Cui/ArduinoNode/DEMO/.ppt-build/render-v7-final/slide-7.png

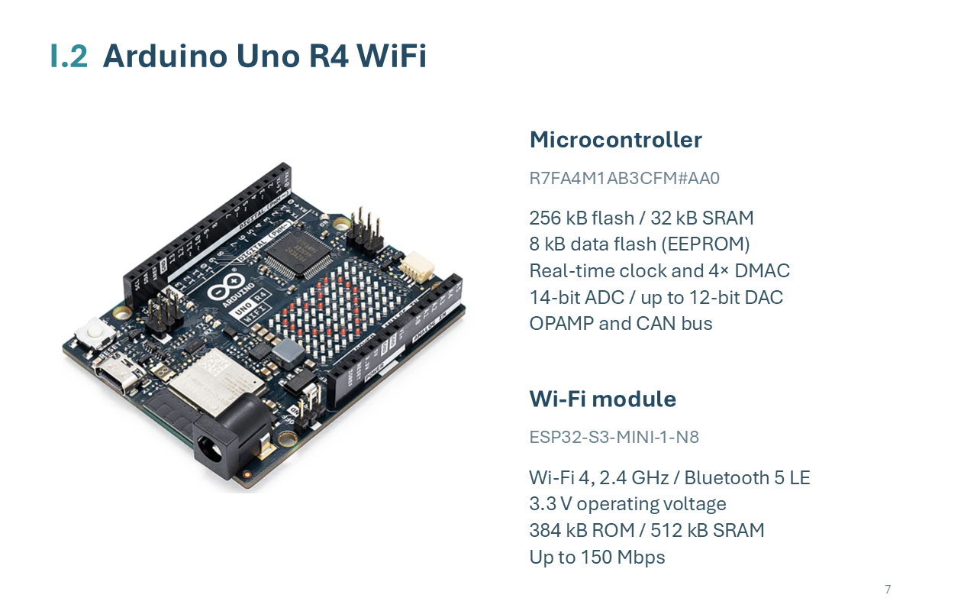
DEMO/.ppt-build/render-v7-final/slide-7.png
