Shuaiwen-Cui/ArduinoNode/DEMO/.ppt-build/render-v7-final/slide-10.png

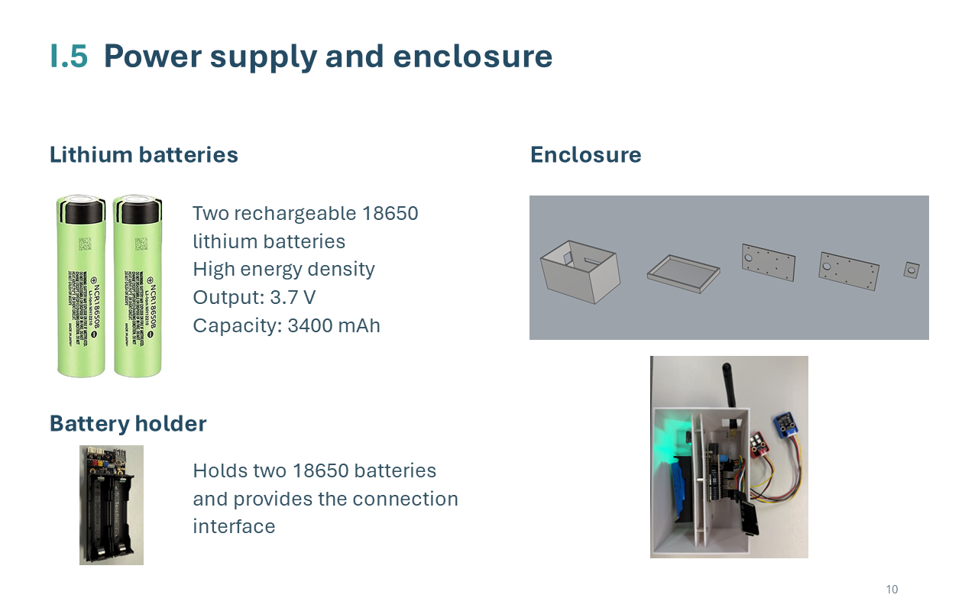
DEMO/.ppt-build/render-v7-final/slide-10.png
