Shuaiwen-Cui/ArduinoNode/DEMO/.ppt-build/render-v7-final/slide-11.png

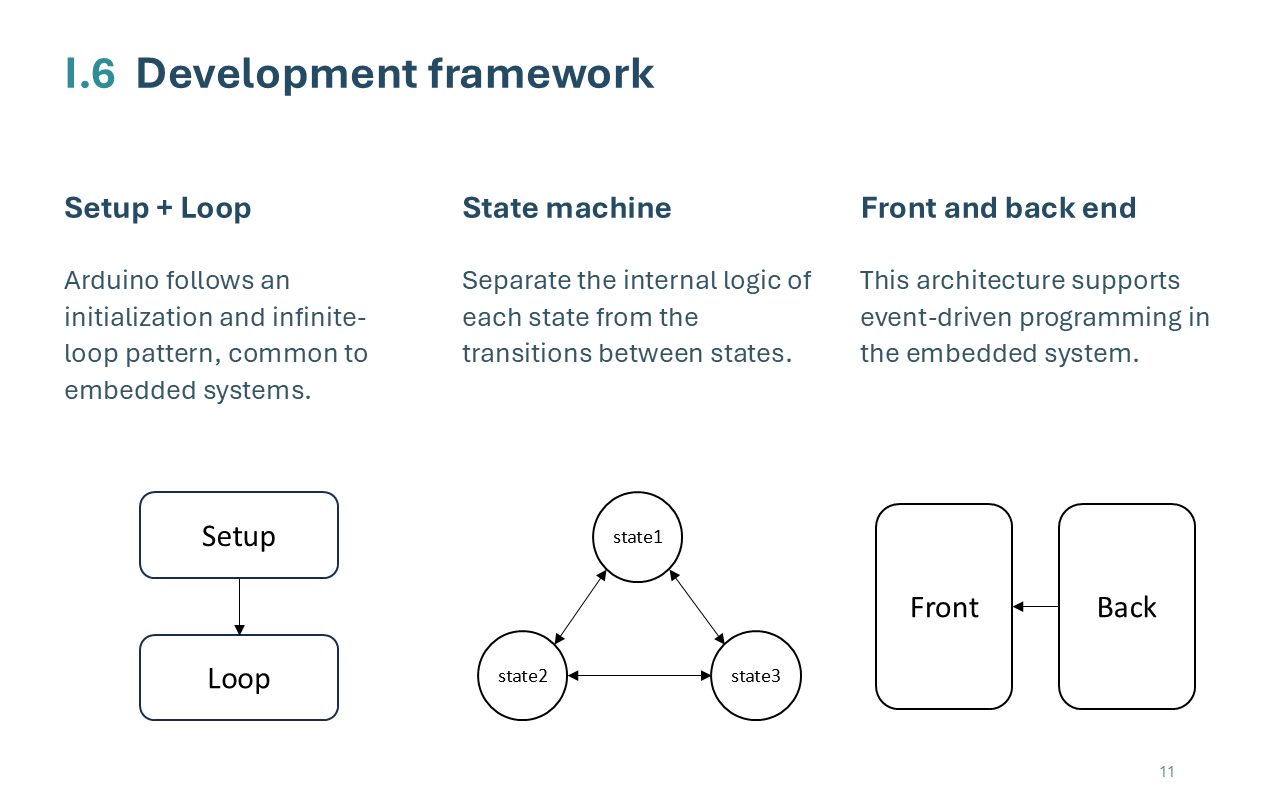
DEMO/.ppt-build/render-v7-final/slide-11.png
