Shuaiwen-Cui/ArduinoNode/DEMO/.ppt-build/render-v7-final/slide-27.png

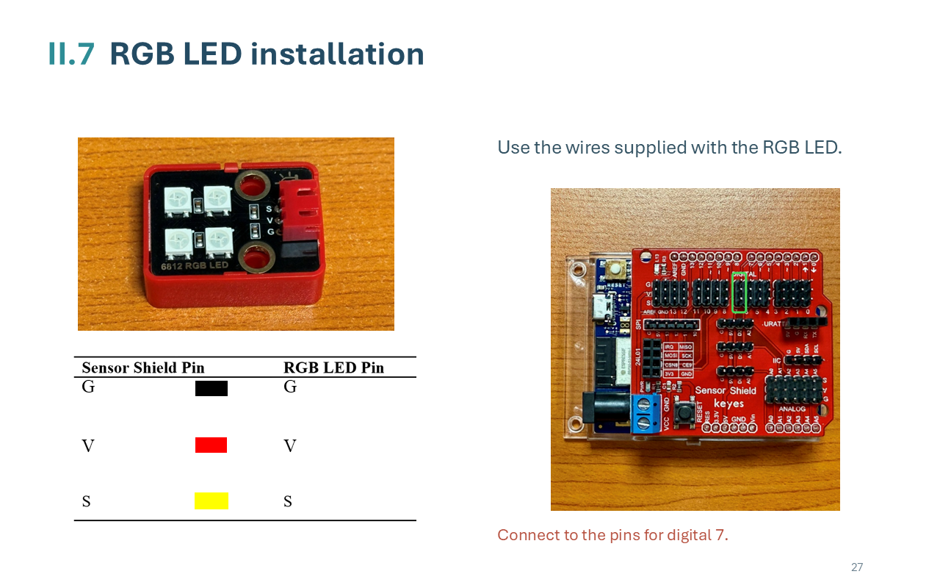
DEMO/.ppt-build/render-v7-final/slide-27.png
