Shuaiwen-Cui/ArduinoNode/DEMO/.ppt-build/render-v7-final/slide-38.png

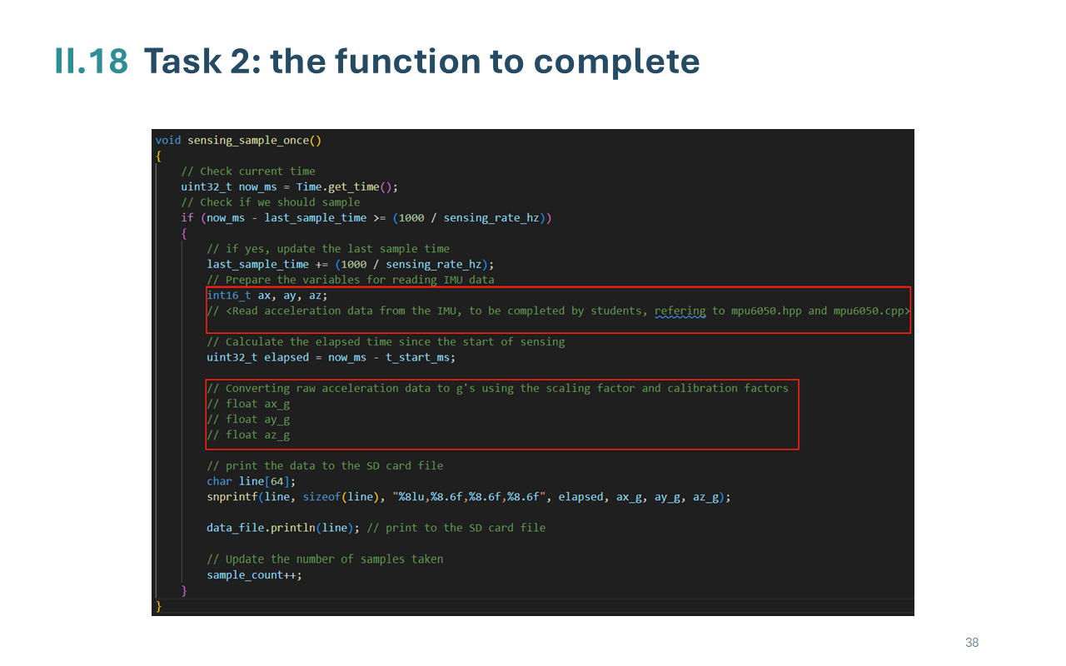
DEMO/.ppt-build/render-v7-final/slide-38.png
