Shuaiwen-Cui/ArduinoNode/DEMO/.ppt-build/render-v8/slide-13.png

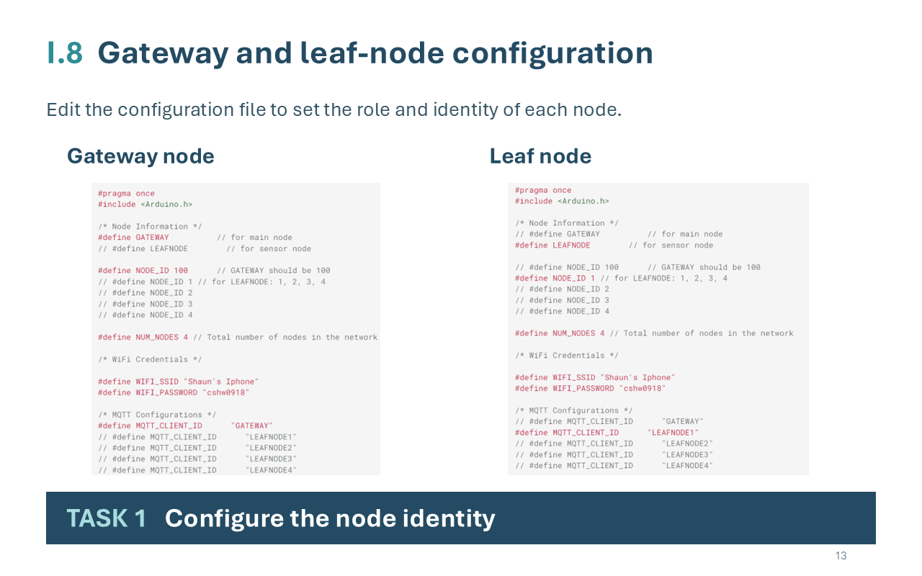
DEMO/.ppt-build/render-v8/slide-13.png
