Shuaiwen-Cui/ArduinoNode/DEMO/.ppt-build/render-v8/slide-45.png

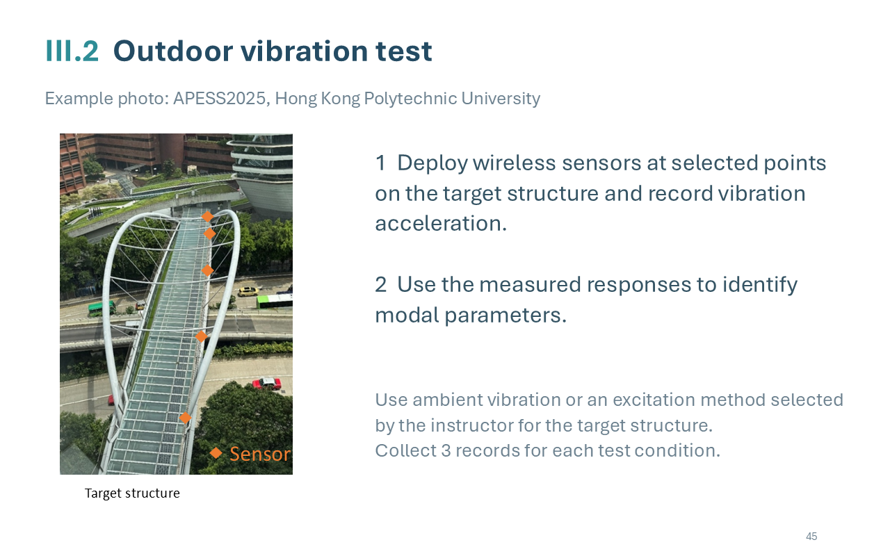
DEMO/.ppt-build/render-v8/slide-45.png
