Shuaiwen-Cui/ArduinoNode/DEMO/.ppt-build/render-v8/slide-46.png

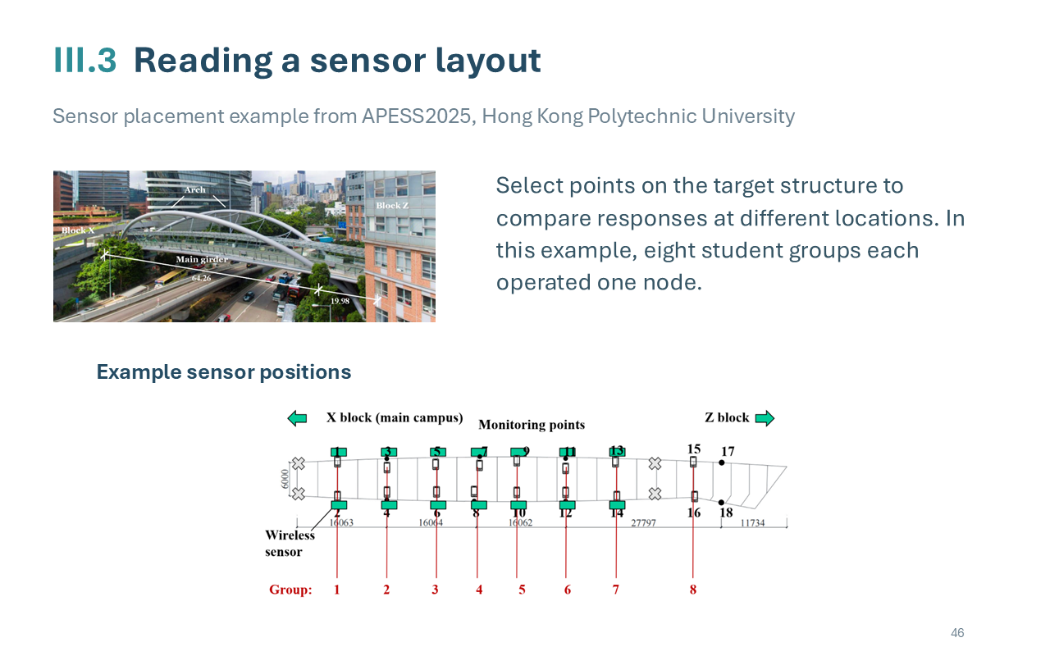
DEMO/.ppt-build/render-v8/slide-46.png
