Shuaiwen-Cui/ArduinoNode/DEMO/.ppt-build/render-v8/slide-48.png

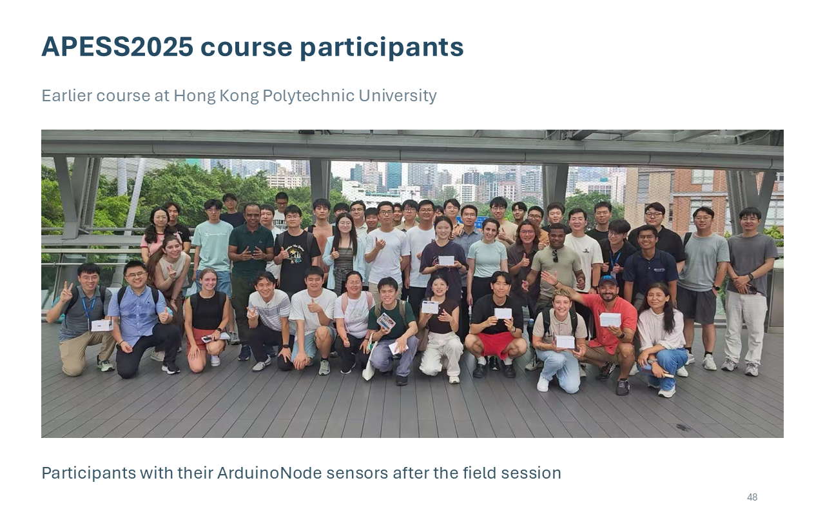
DEMO/.ppt-build/render-v8/slide-48.png
