Shuaiwen-Cui/ArduinoNode/DEMO/.ppt-build/render/slide-1.png

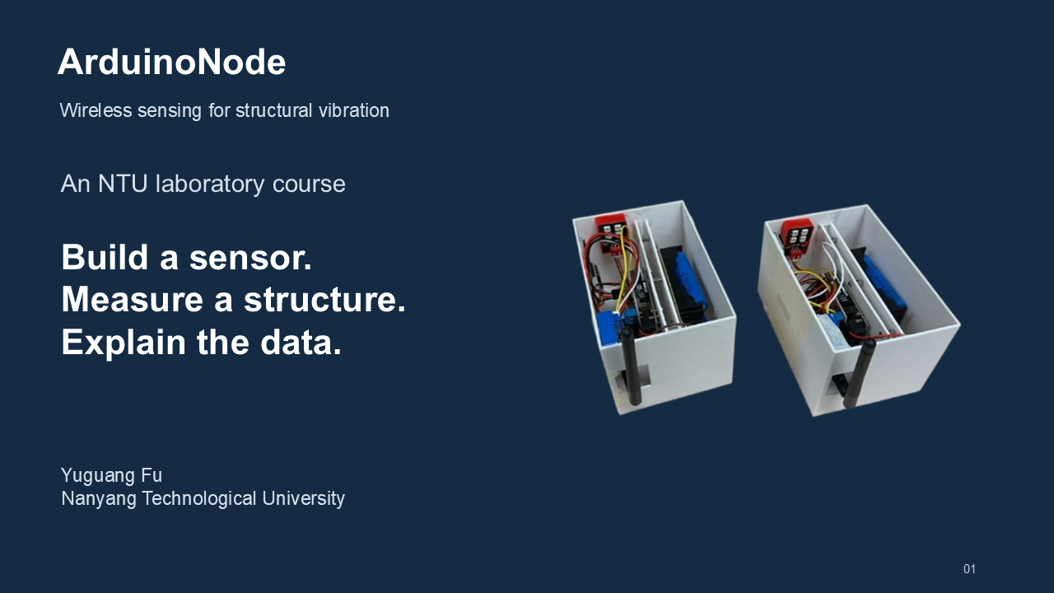
DEMO/.ppt-build/render/slide-1.png
