Shuaiwen-Cui/ArduinoNode/DEMO/.ppt-build/render/slide-2.png

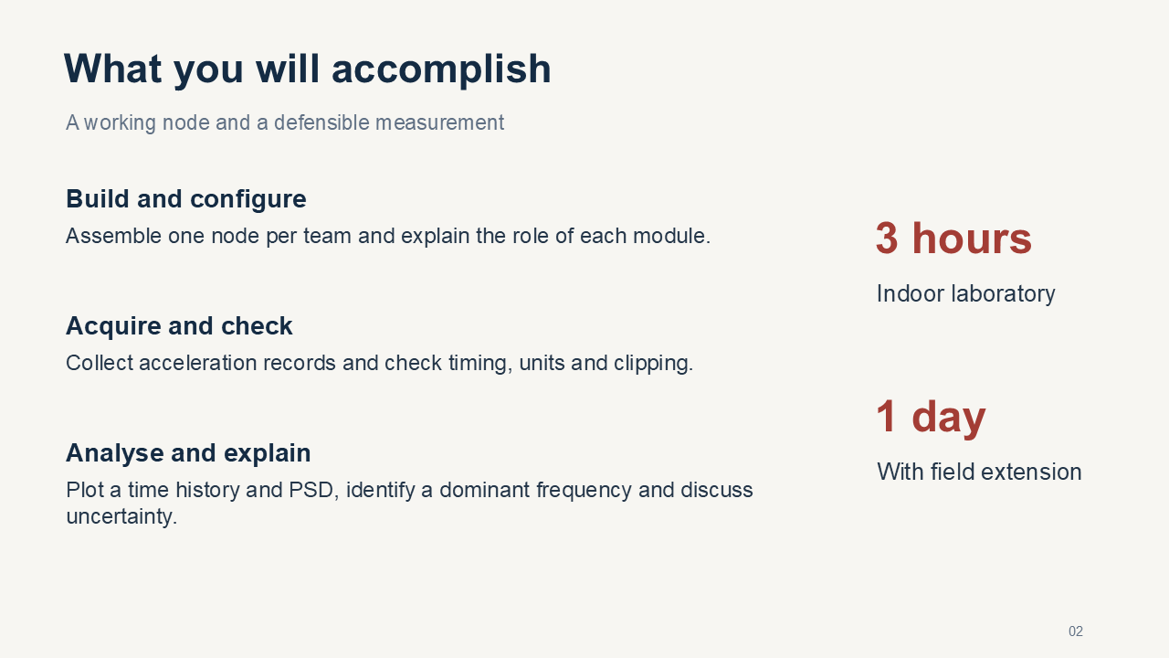
DEMO/.ppt-build/render/slide-2.png
