Shuaiwen-Cui/ArduinoNode/DEMO/.ppt-build/render/slide-3.png

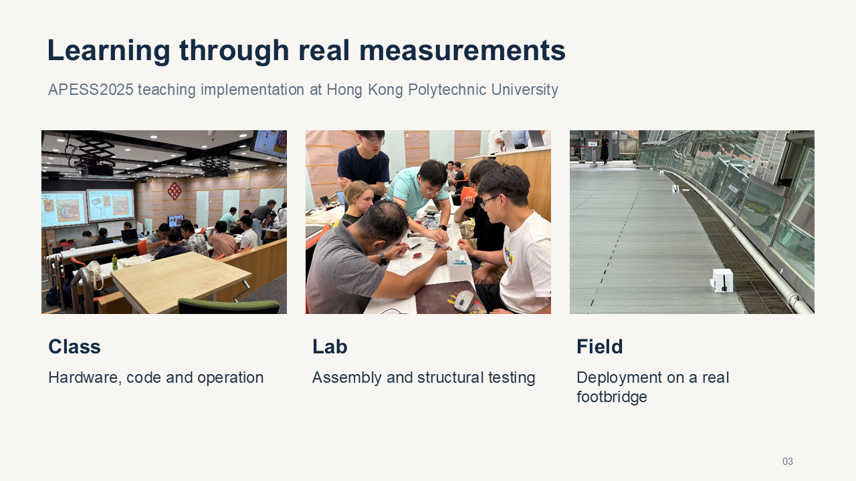
DEMO/.ppt-build/render/slide-3.png
