Shuaiwen-Cui/ArduinoNode/DEMO/.ppt-build/render/slide-4.png

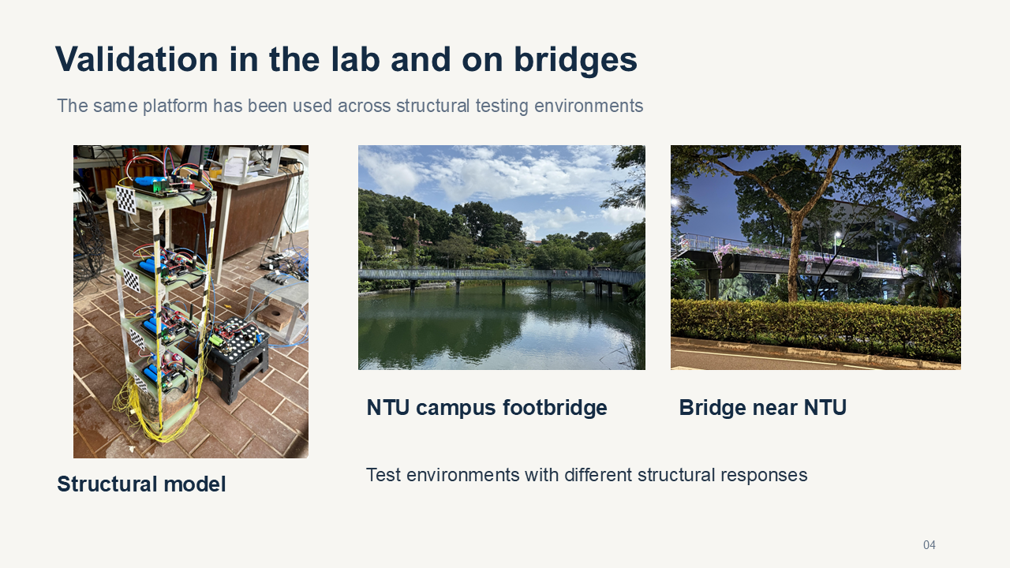
DEMO/.ppt-build/render/slide-4.png
