Shuaiwen-Cui/ArduinoNode/DEMO/.ppt-build/render/slide-5.png

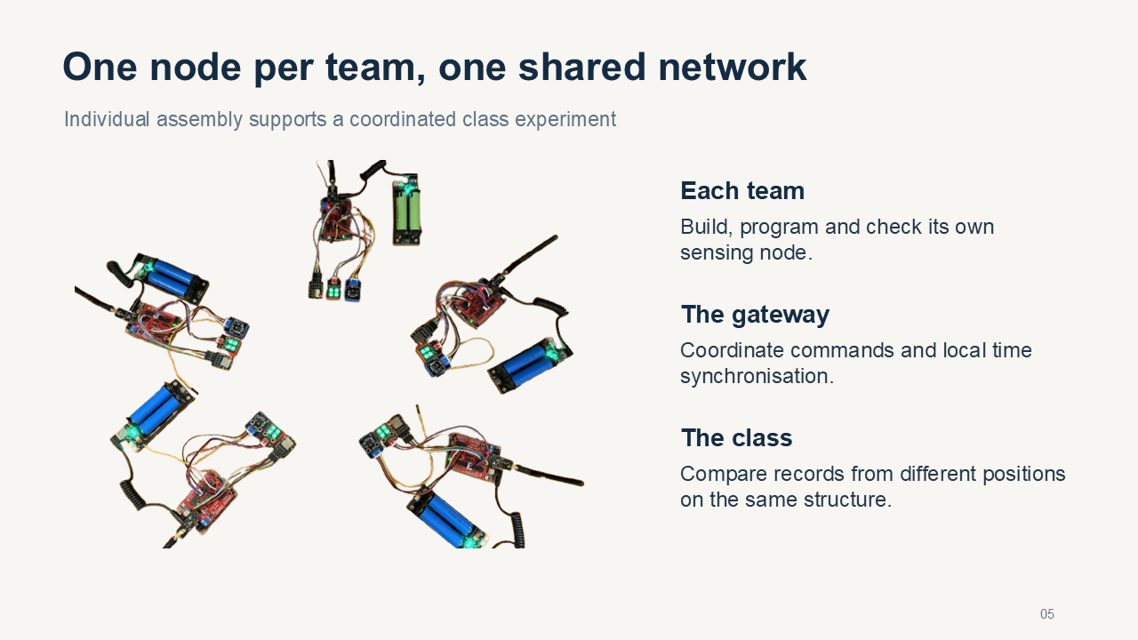
DEMO/.ppt-build/render/slide-5.png
