Shuaiwen-Cui/ArduinoNode/DEMO/.ppt-build/render/slide-6.png

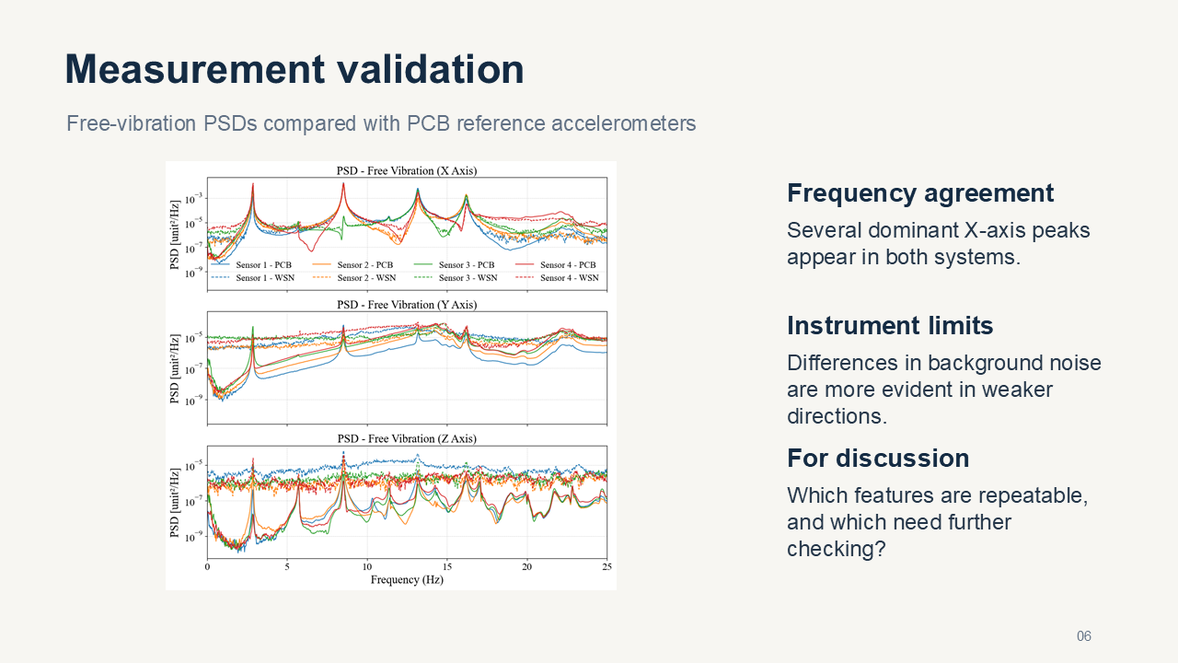
DEMO/.ppt-build/render/slide-6.png
