Shuaiwen-Cui/ArduinoNode/DEMO/.ppt-build/render/slide-7.png

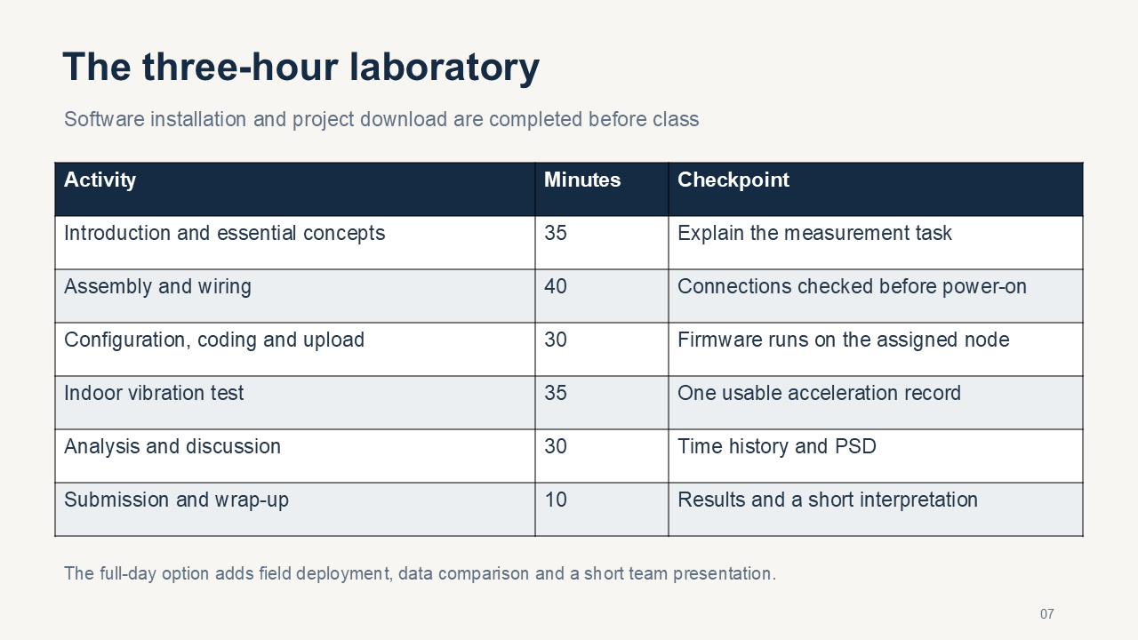
DEMO/.ppt-build/render/slide-7.png
