Shuaiwen-Cui/ArduinoNode/DEMO/.ppt-build/render/slide-8.png

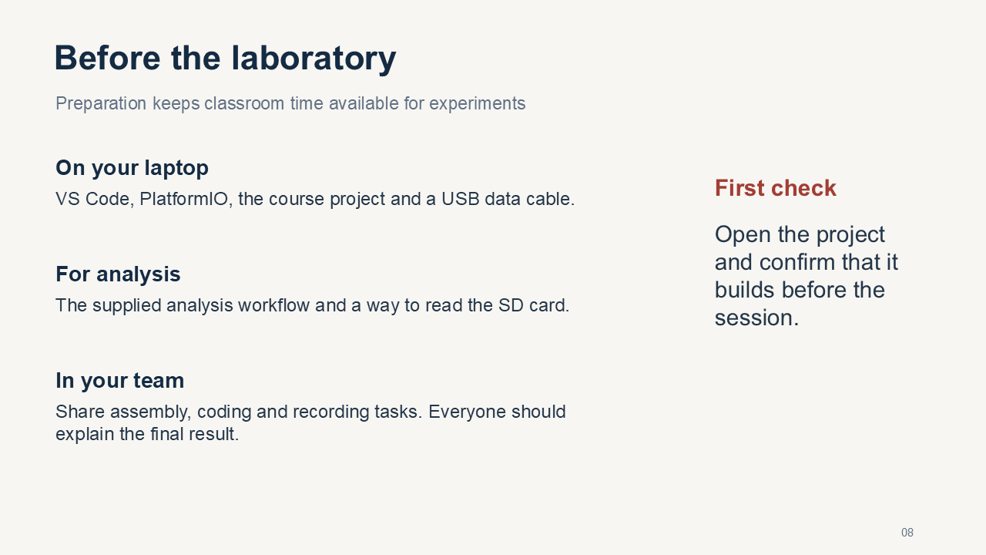
DEMO/.ppt-build/render/slide-8.png
