Shuaiwen-Cui/ArduinoNode/DEMO/.ppt-build/render/slide-9.png

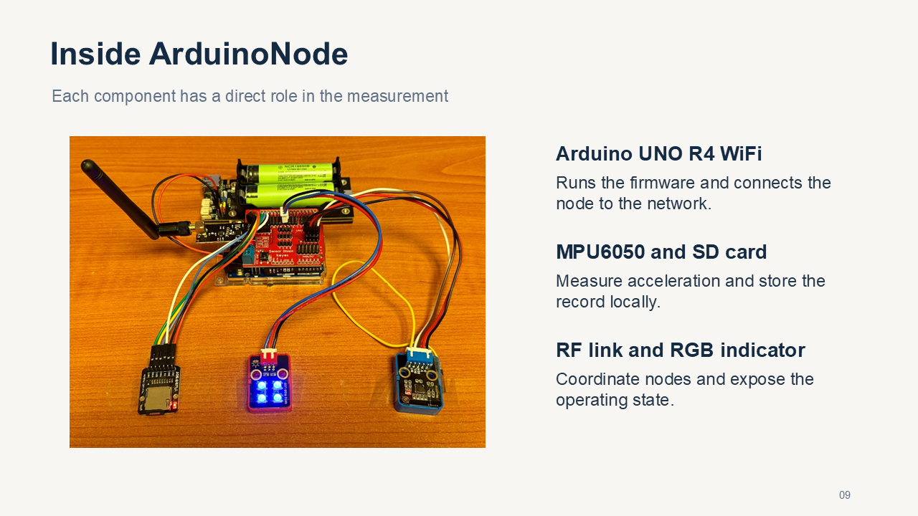
DEMO/.ppt-build/render/slide-9.png
