Shuaiwen-Cui/ArduinoNode/DEMO/.ppt-build/render/slide-10.png

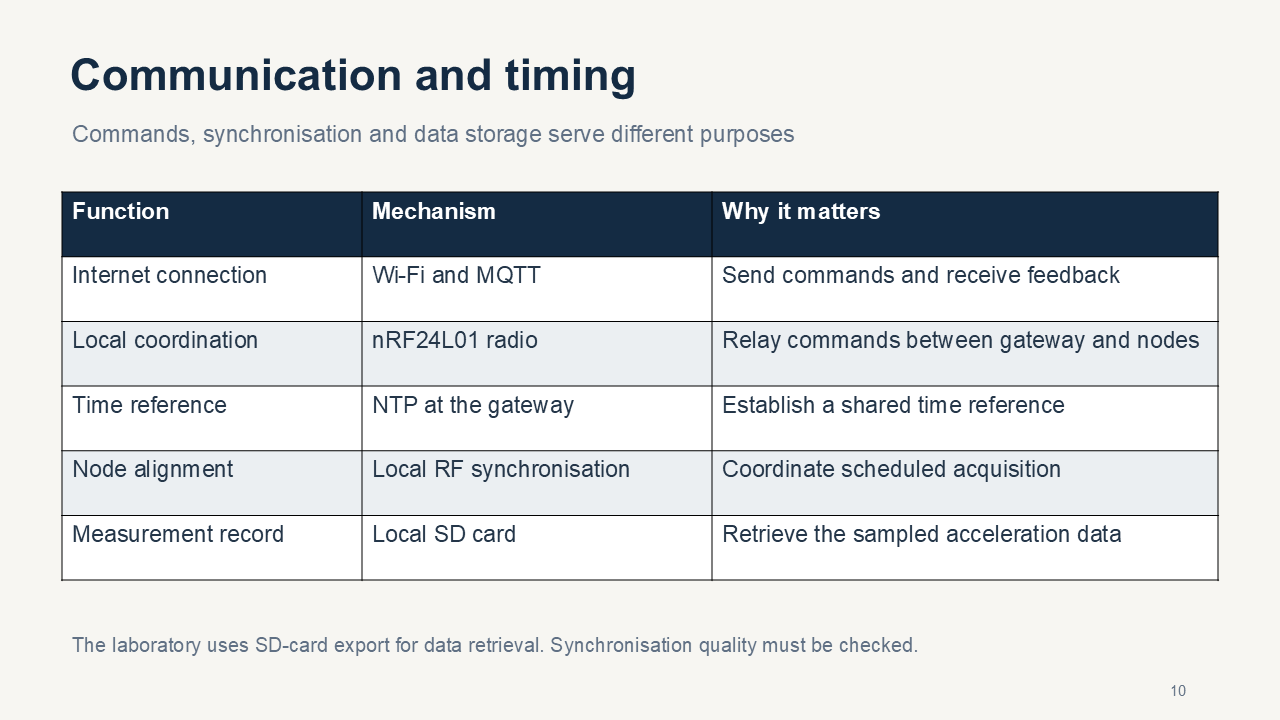
DEMO/.ppt-build/render/slide-10.png
