Shuaiwen-Cui/ArduinoNode/DEMO/.ppt-build/render/slide-11.png

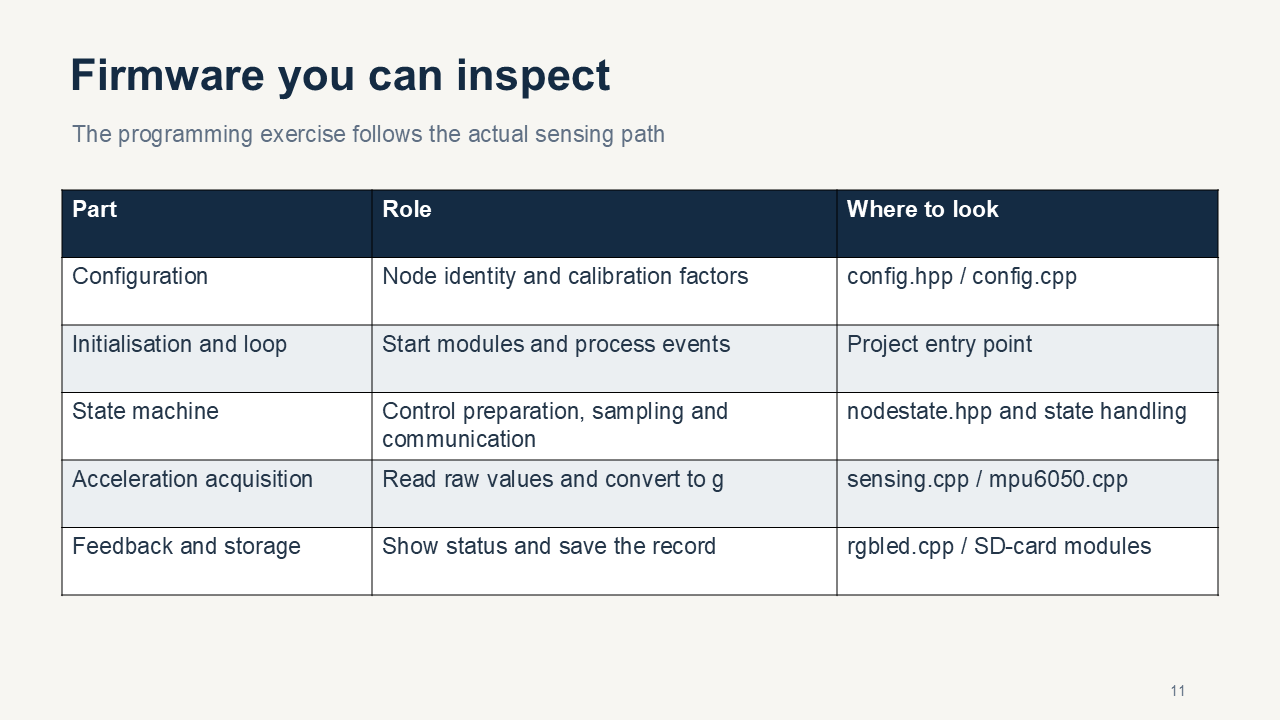
DEMO/.ppt-build/render/slide-11.png
