Shuaiwen-Cui/ArduinoNode/DEMO/.ppt-build/render/slide-12.png

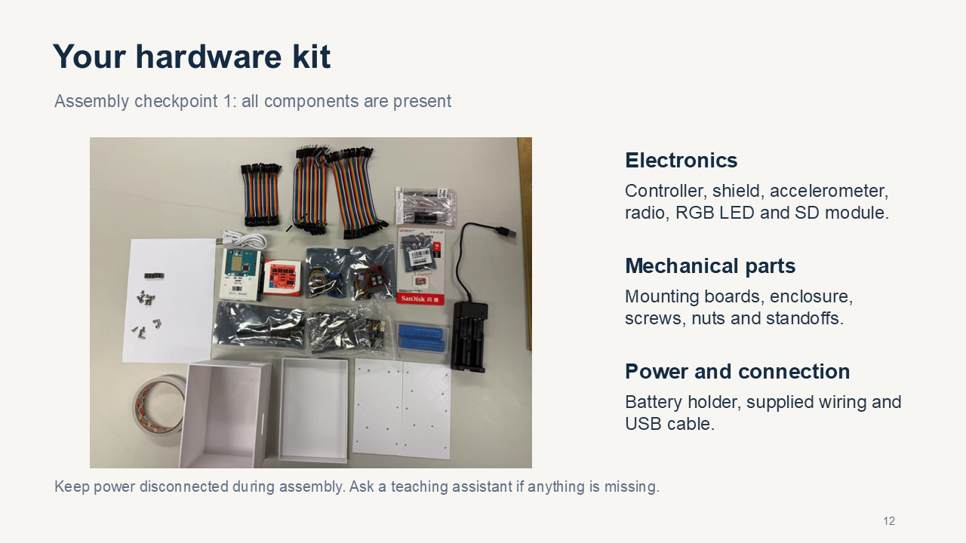
DEMO/.ppt-build/render/slide-12.png
