Shuaiwen-Cui/ArduinoNode/DEMO/.ppt-build/render/slide-13.png

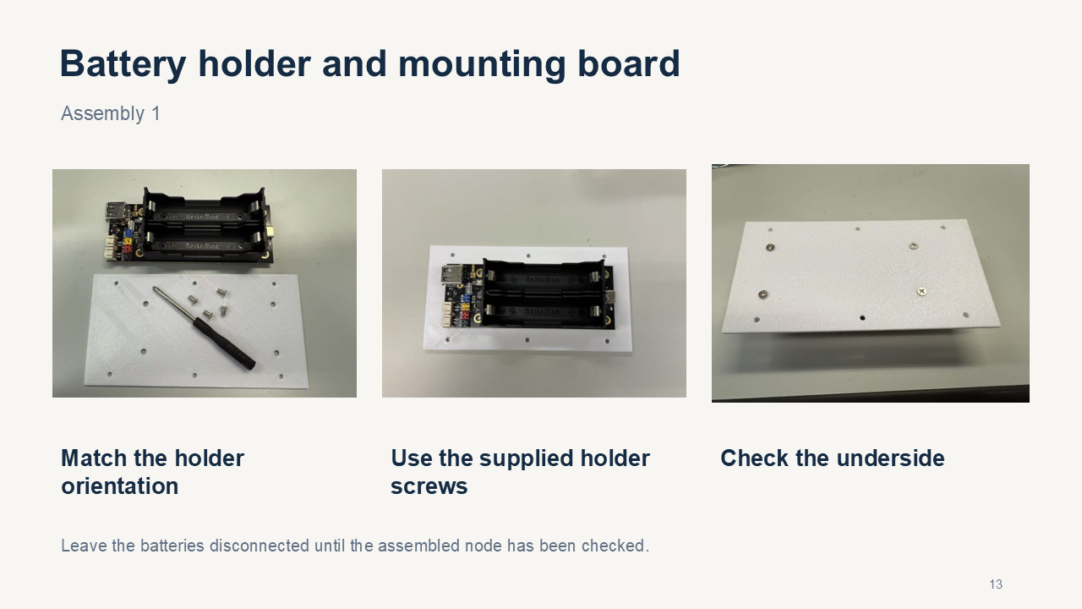
DEMO/.ppt-build/render/slide-13.png
