Shuaiwen-Cui/ArduinoNode/DEMO/.ppt-build/render/slide-14.png

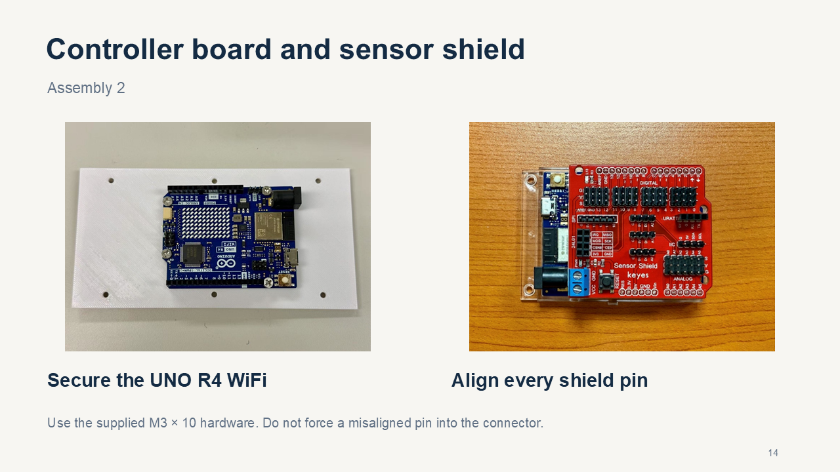
DEMO/.ppt-build/render/slide-14.png
