Shuaiwen-Cui/ArduinoNode/DEMO/.ppt-build/render/slide-15.png

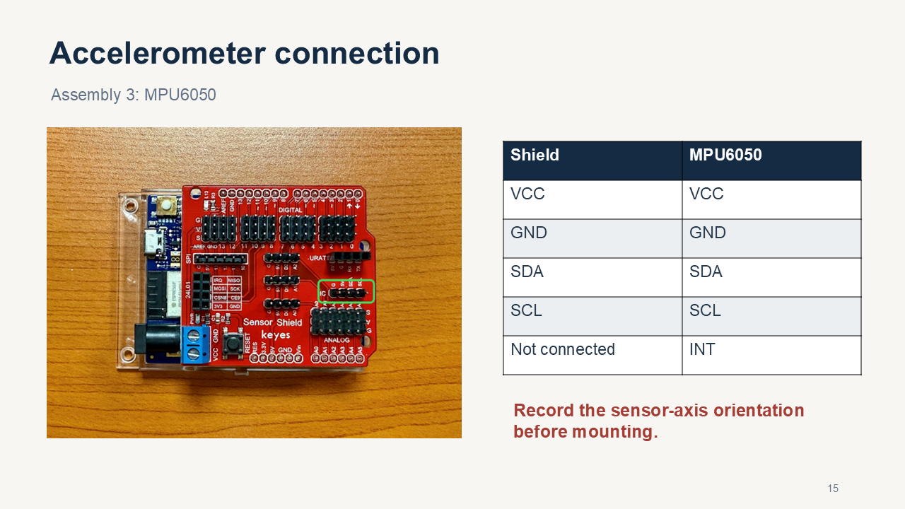
DEMO/.ppt-build/render/slide-15.png
