Shuaiwen-Cui/ArduinoNode/DEMO/.ppt-build/render/slide-16.png

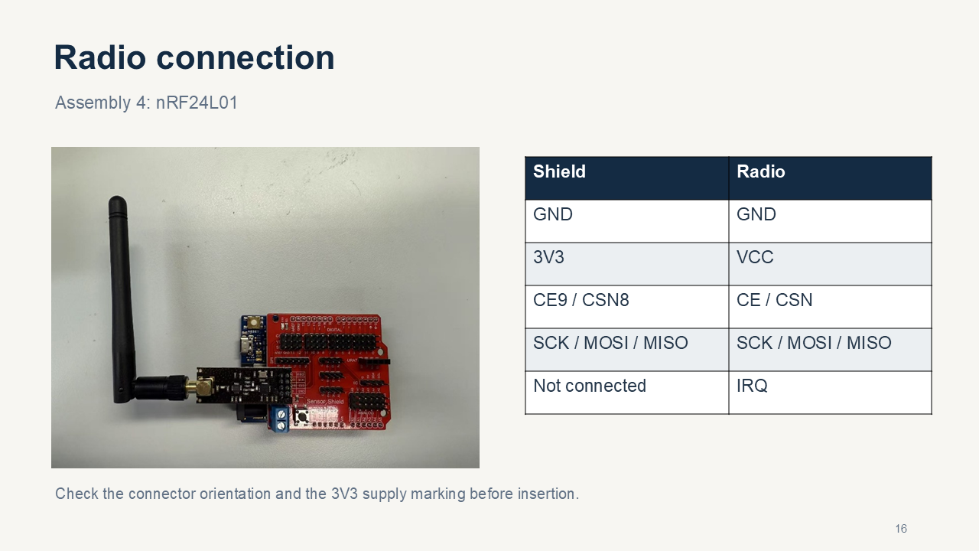
DEMO/.ppt-build/render/slide-16.png
