Shuaiwen-Cui/ArduinoNode/DEMO/.ppt-build/render/slide-17.png

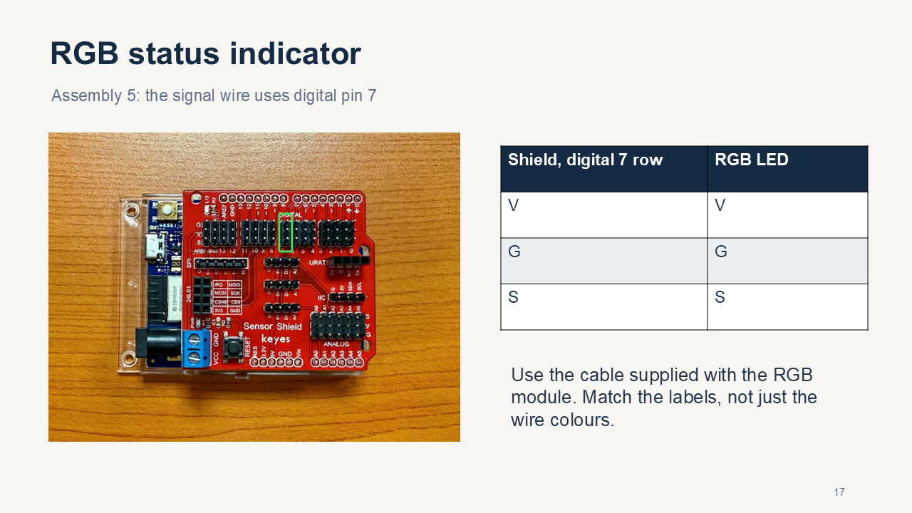
DEMO/.ppt-build/render/slide-17.png
