Shuaiwen-Cui/ArduinoNode/DEMO/.ppt-build/render/slide-18.png

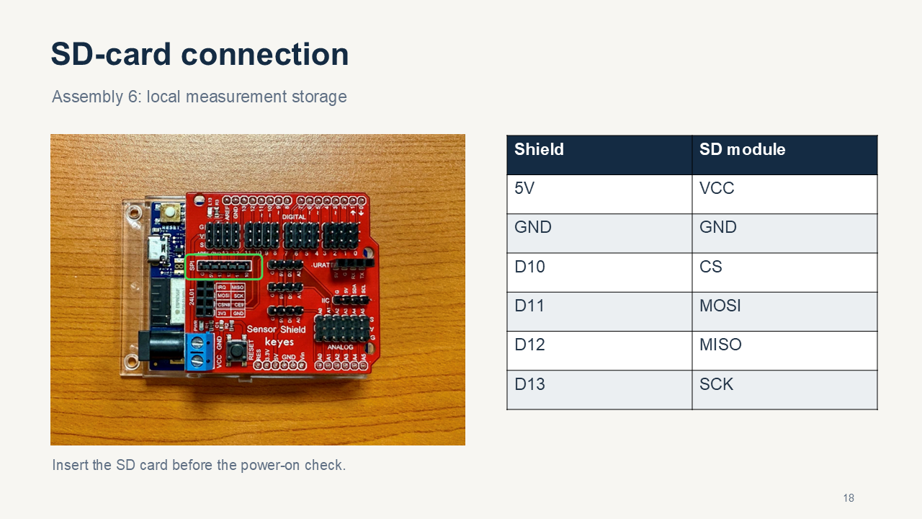
DEMO/.ppt-build/render/slide-18.png
