Shuaiwen-Cui/ArduinoNode/DEMO/.ppt-build/render/slide-19.png

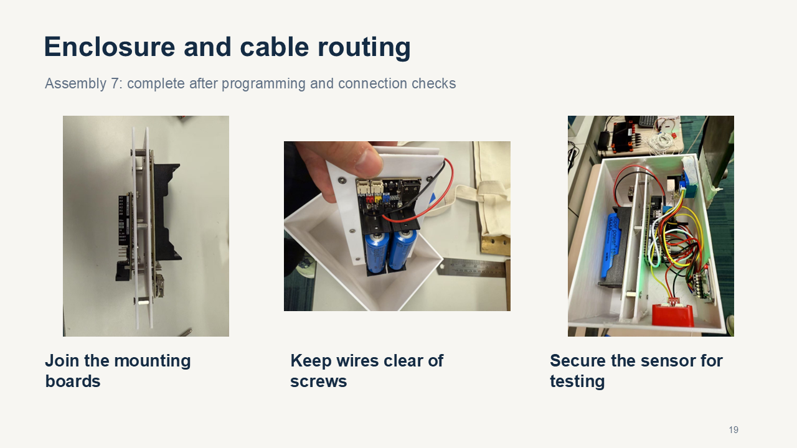
DEMO/.ppt-build/render/slide-19.png
