Shuaiwen-Cui/ArduinoNode/DEMO/.ppt-build/render/slide-20.png

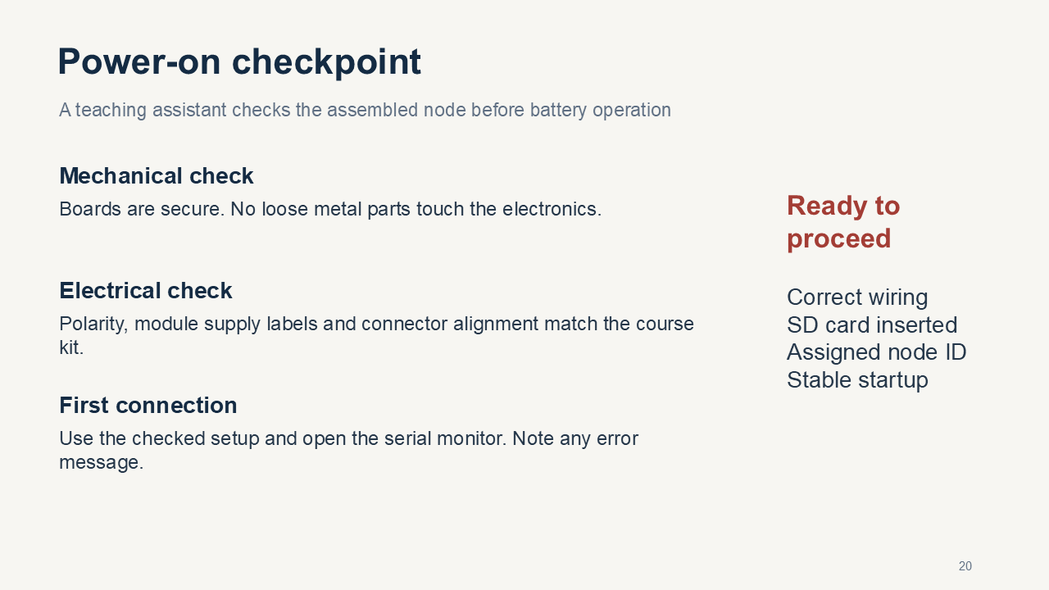
DEMO/.ppt-build/render/slide-20.png
