Shuaiwen-Cui/ArduinoNode/DEMO/.ppt-build/render/slide-21.png

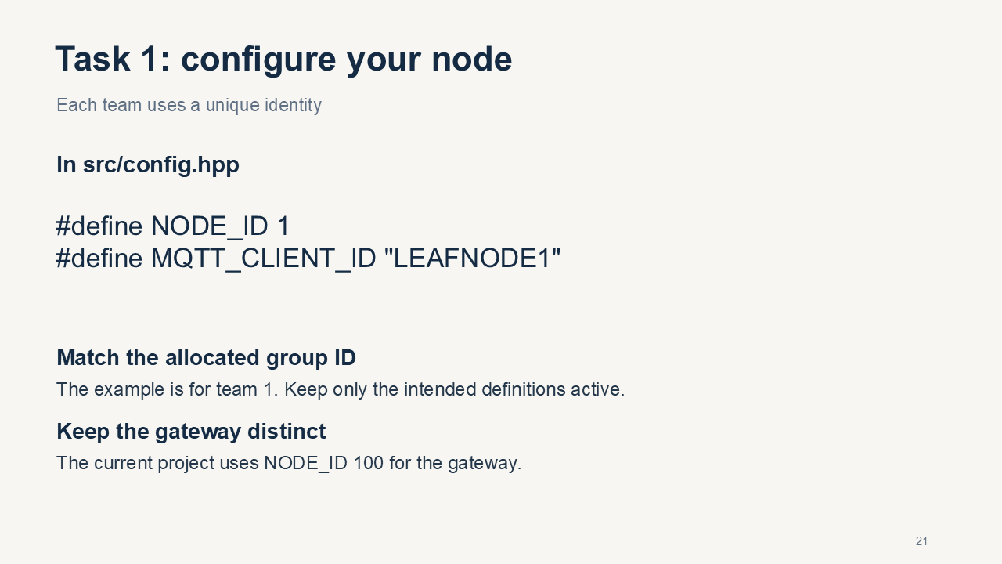
DEMO/.ppt-build/render/slide-21.png
