Shuaiwen-Cui/ArduinoNode/DEMO/.ppt-build/render/slide-22.png

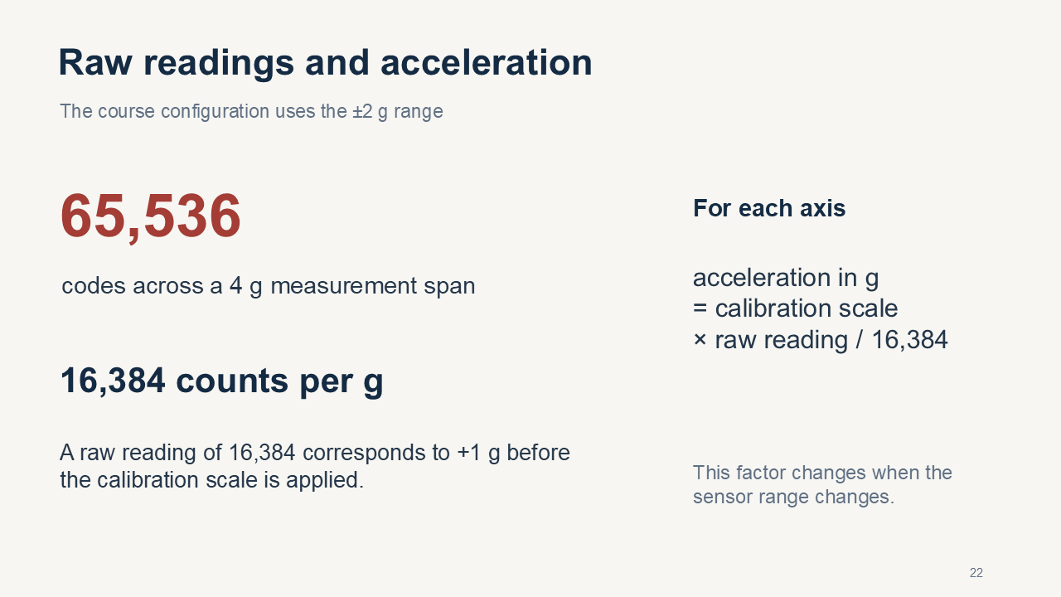
DEMO/.ppt-build/render/slide-22.png
