Shuaiwen-Cui/ArduinoNode/DEMO/.ppt-build/render/slide-23.png

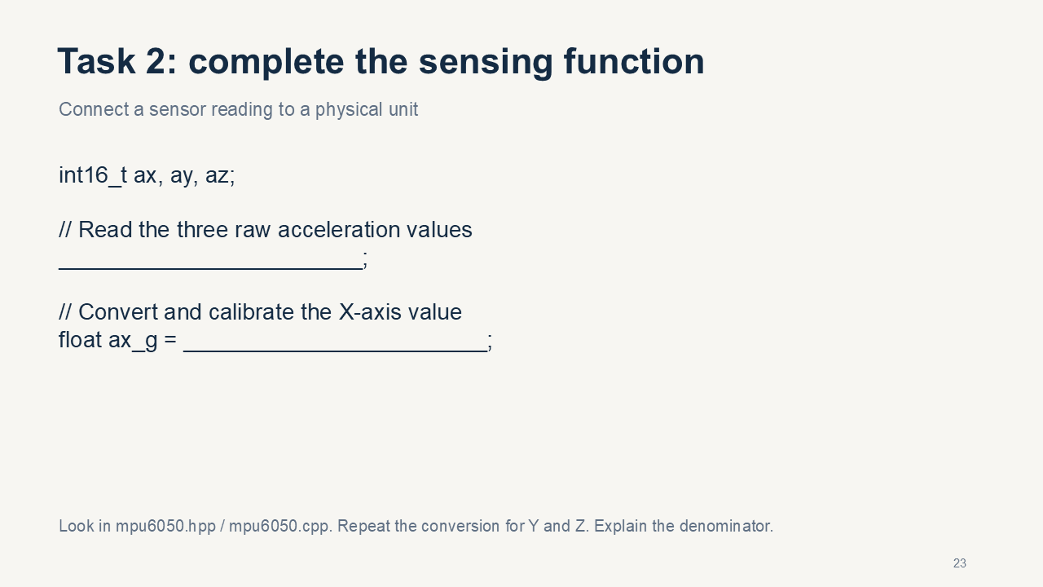
DEMO/.ppt-build/render/slide-23.png
