Shuaiwen-Cui/ArduinoNode/DEMO/.ppt-build/render/slide-24.png

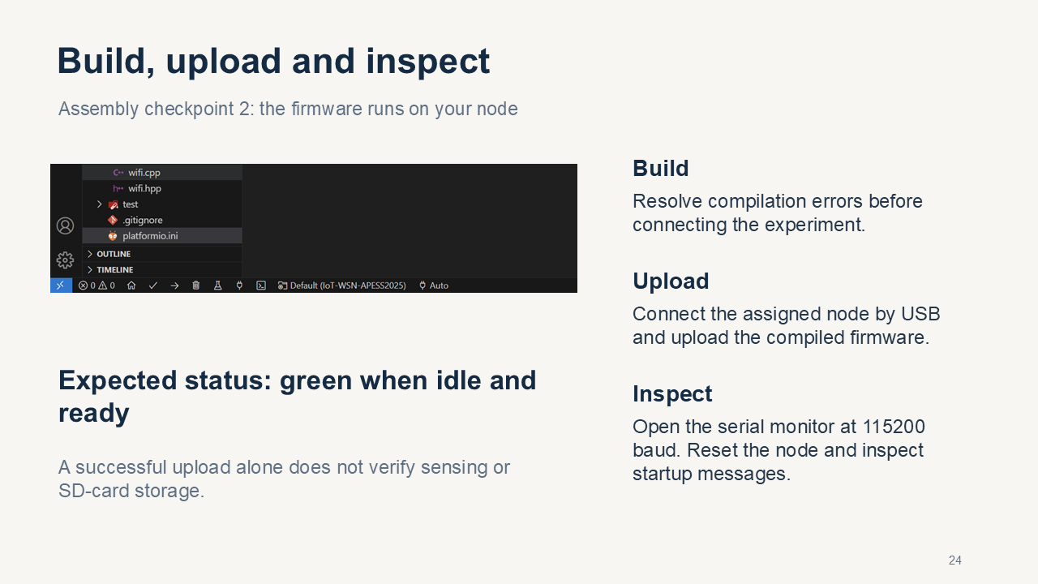
DEMO/.ppt-build/render/slide-24.png
