Shuaiwen-Cui/ArduinoNode/DEMO/.ppt-build/render/slide-25.png

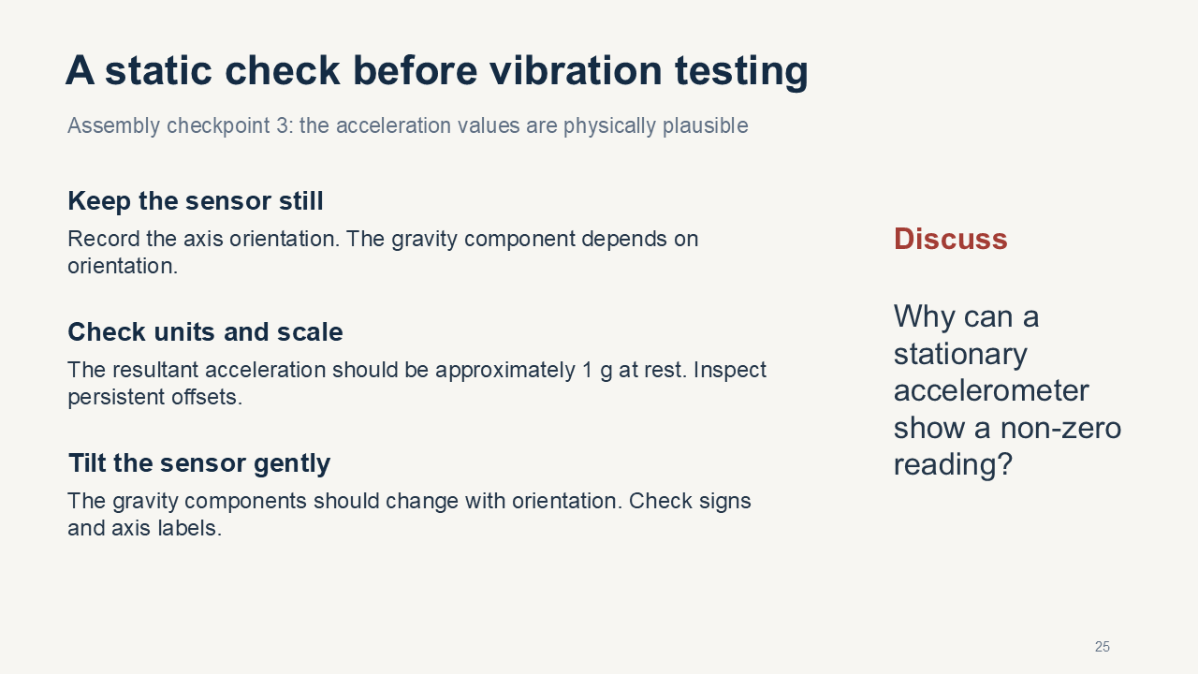
DEMO/.ppt-build/render/slide-25.png
