Shuaiwen-Cui/ArduinoNode/DEMO/.ppt-build/render/slide-26.png

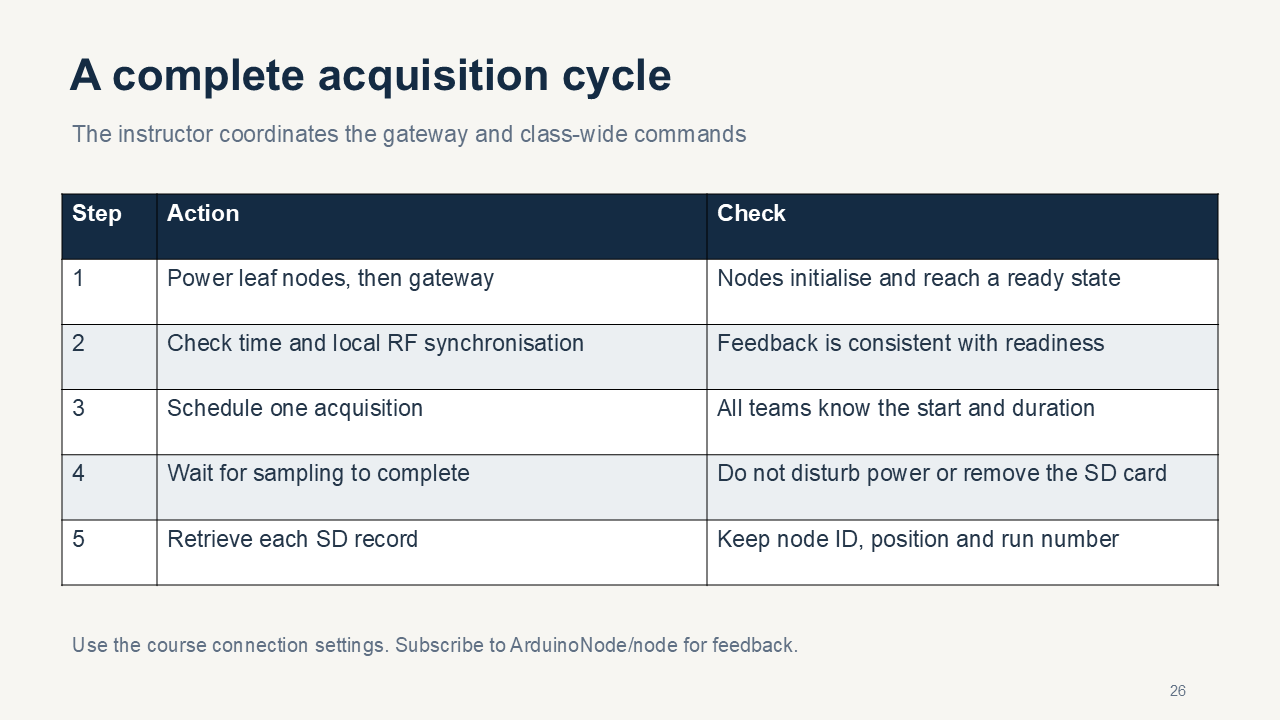
DEMO/.ppt-build/render/slide-26.png
