Shuaiwen-Cui/ArduinoNode/DEMO/.ppt-build/render/slide-27.png

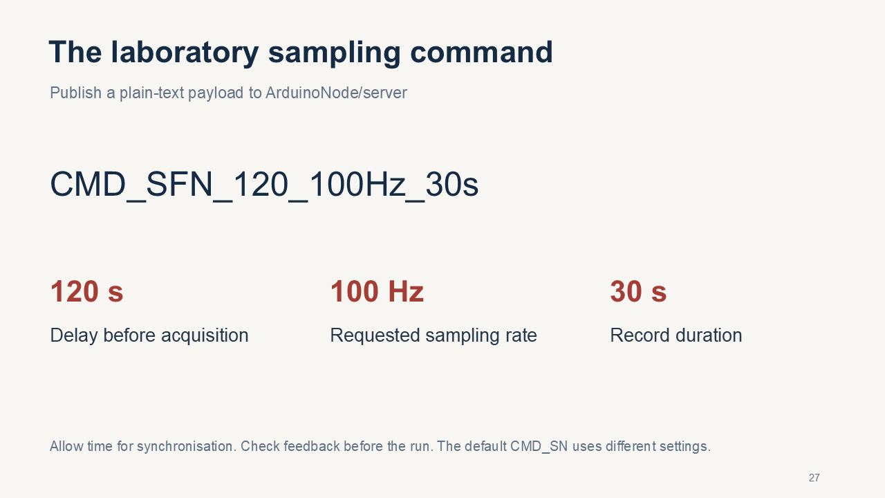
DEMO/.ppt-build/render/slide-27.png
