Shuaiwen-Cui/ArduinoNode/DEMO/.ppt-build/render/slide-28.png

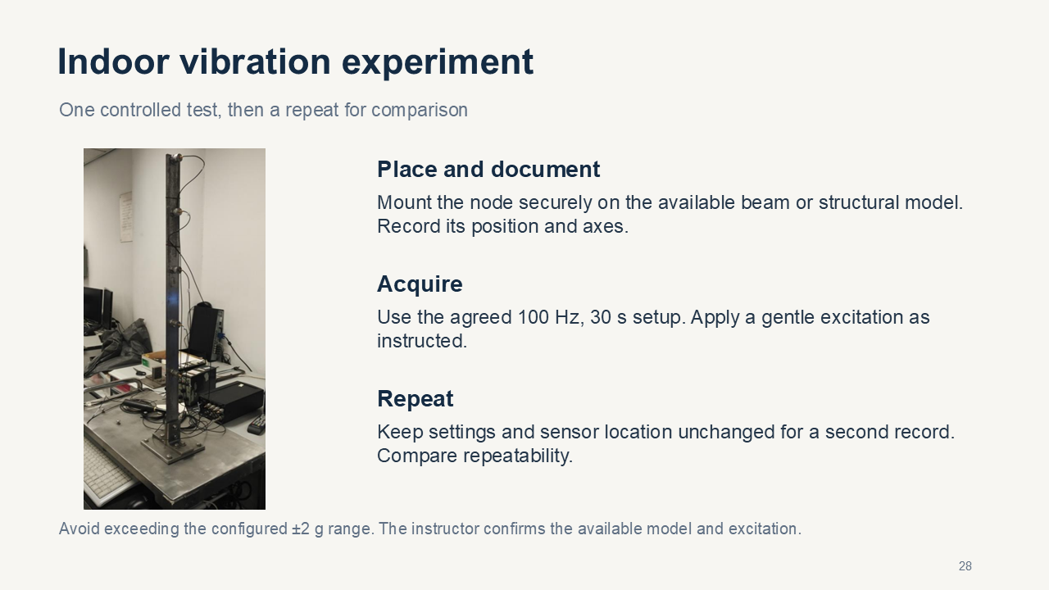
DEMO/.ppt-build/render/slide-28.png
