Shuaiwen-Cui/ArduinoNode/DEMO/.ppt-build/render/slide-29.png

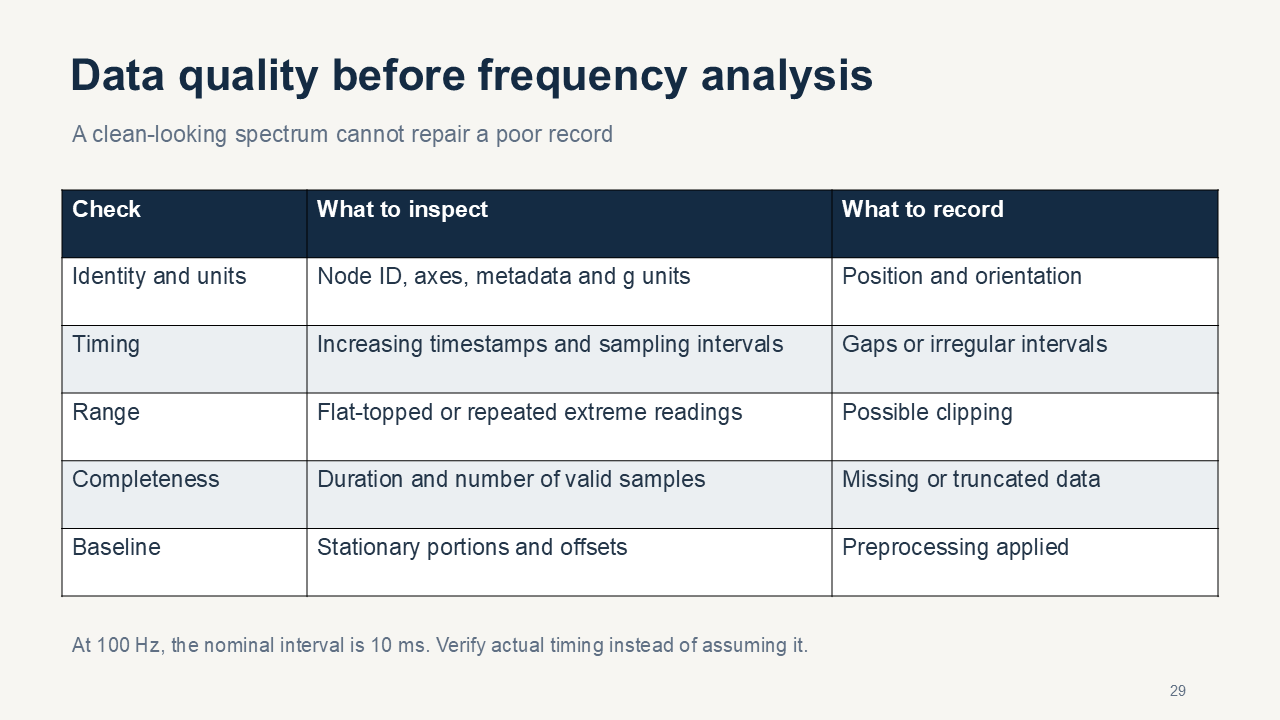
DEMO/.ppt-build/render/slide-29.png
