Shuaiwen-Cui/ArduinoNode/DEMO/.ppt-build/render/slide-30.png

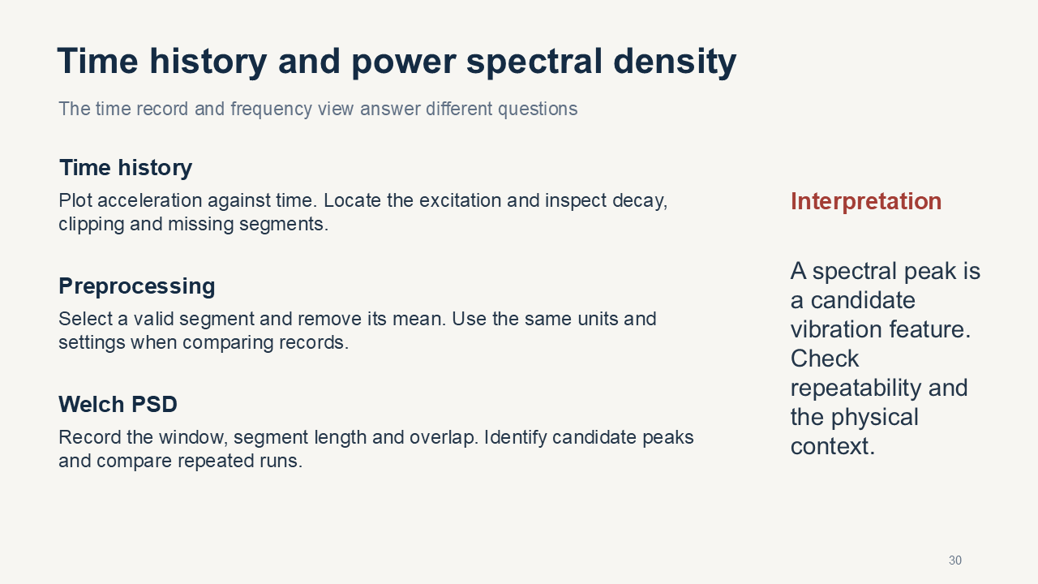
DEMO/.ppt-build/render/slide-30.png
