Shuaiwen-Cui/ArduinoNode/DEMO/.ppt-build/render/slide-31.png

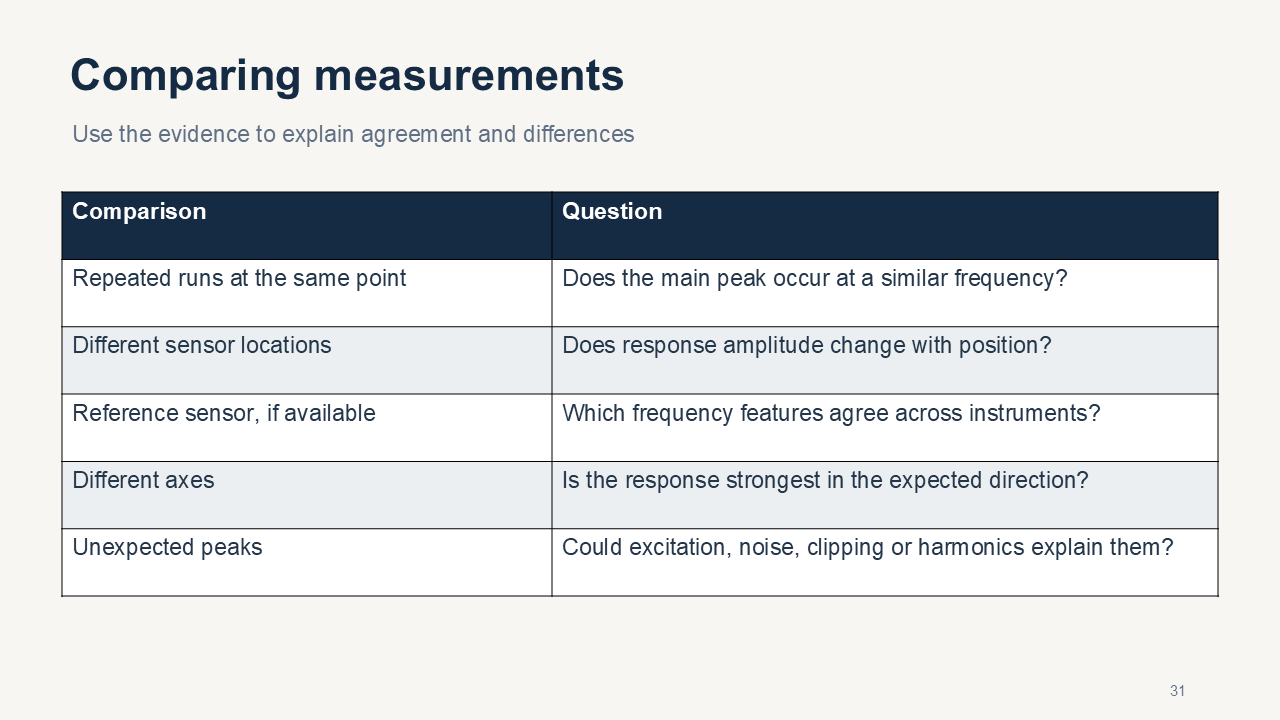
DEMO/.ppt-build/render/slide-31.png
