Shuaiwen-Cui/ArduinoNode/DEMO/.ppt-build/render/slide-32.png

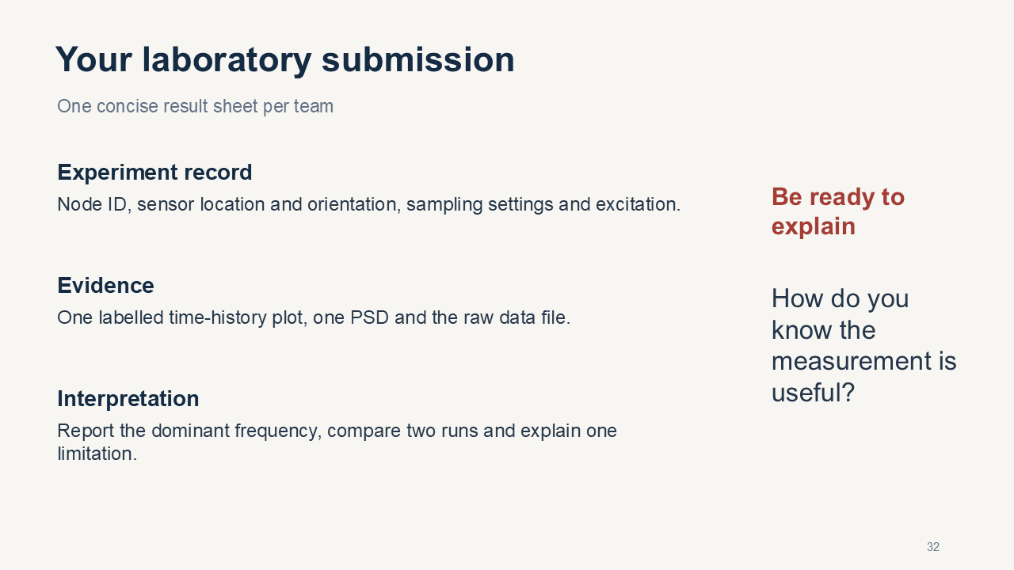
DEMO/.ppt-build/render/slide-32.png
