Shuaiwen-Cui/ArduinoNode/DEMO/.ppt-build/render/slide-33.png

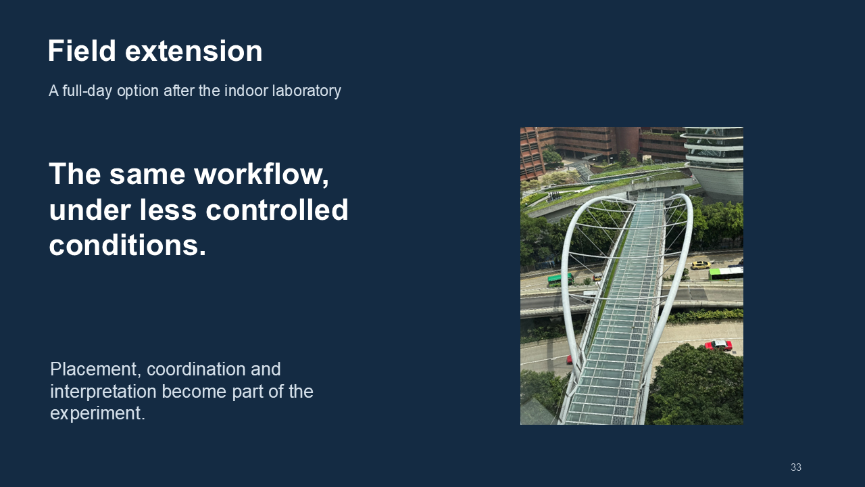
DEMO/.ppt-build/render/slide-33.png
