Shuaiwen-Cui/ArduinoNode/DEMO/.ppt-build/render/slide-34.png

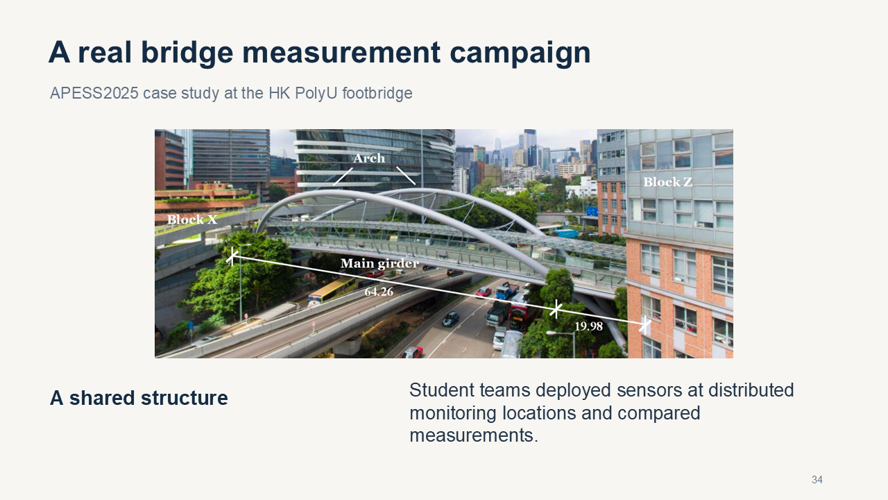
DEMO/.ppt-build/render/slide-34.png
