Shuaiwen-Cui/ArduinoNode/DEMO/.ppt-build/render/slide-35.png

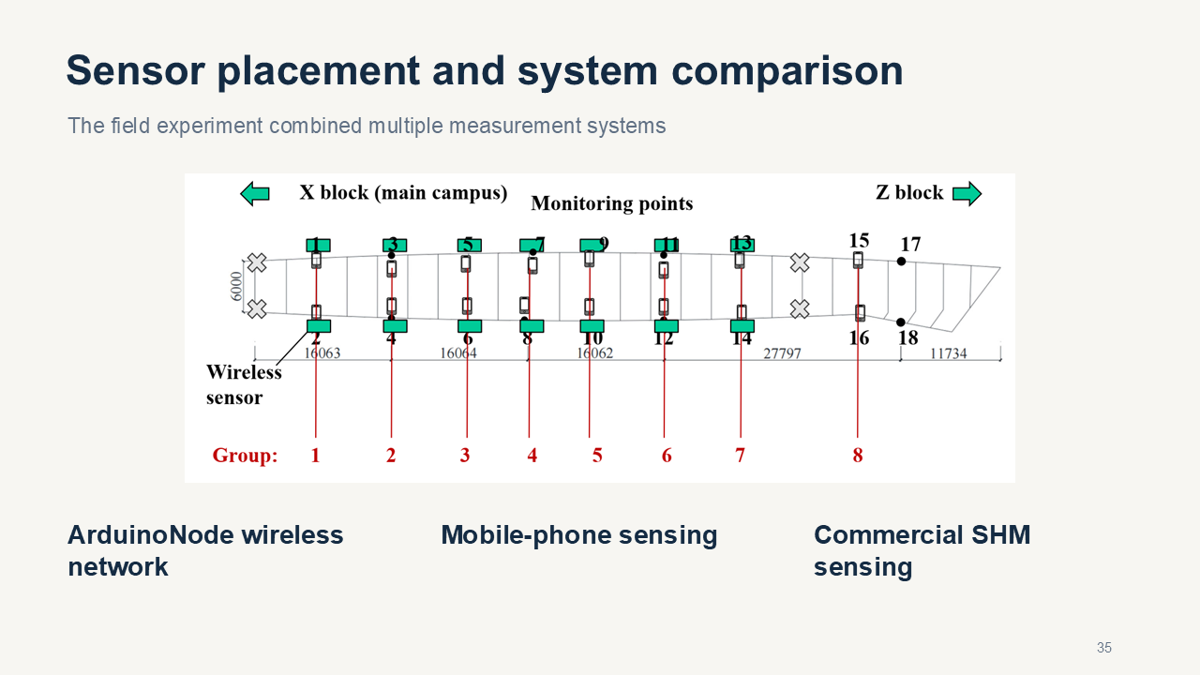
DEMO/.ppt-build/render/slide-35.png
