Shuaiwen-Cui/ArduinoNode/DEMO/.ppt-build/render/slide-36.png

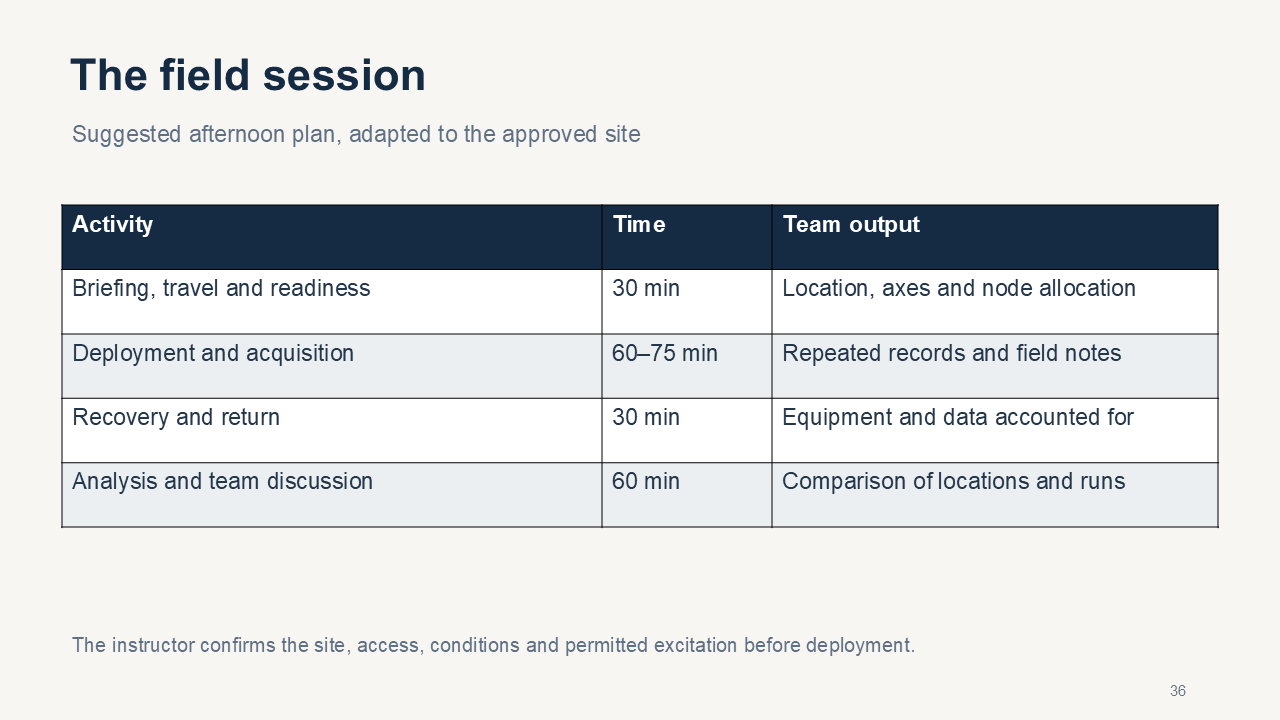
DEMO/.ppt-build/render/slide-36.png
