Shuaiwen-Cui/ArduinoNode/DEMO/.ppt-build/render/slide-37.png

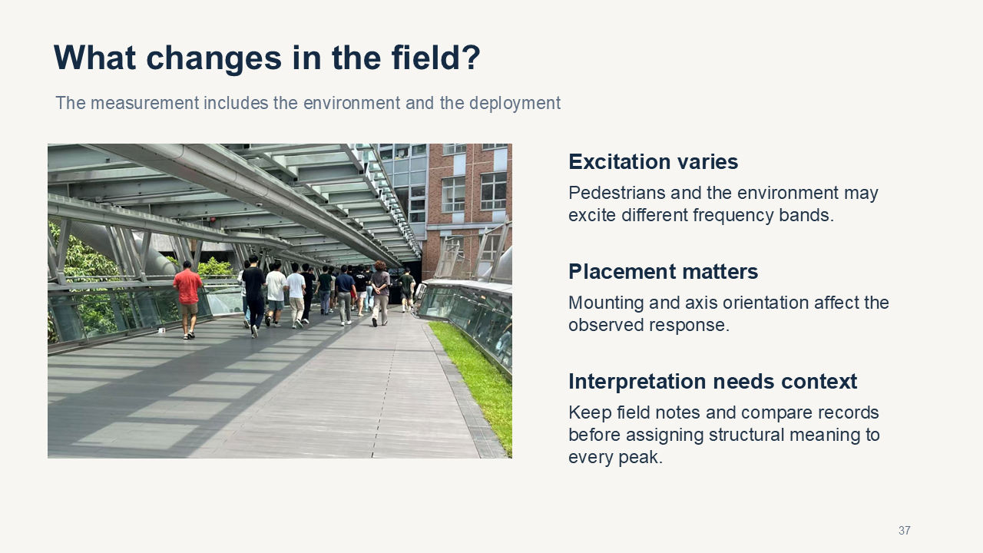
DEMO/.ppt-build/render/slide-37.png
