Shuaiwen-Cui/ArduinoNode/DEMO/.ppt-build/render/slide-38.png

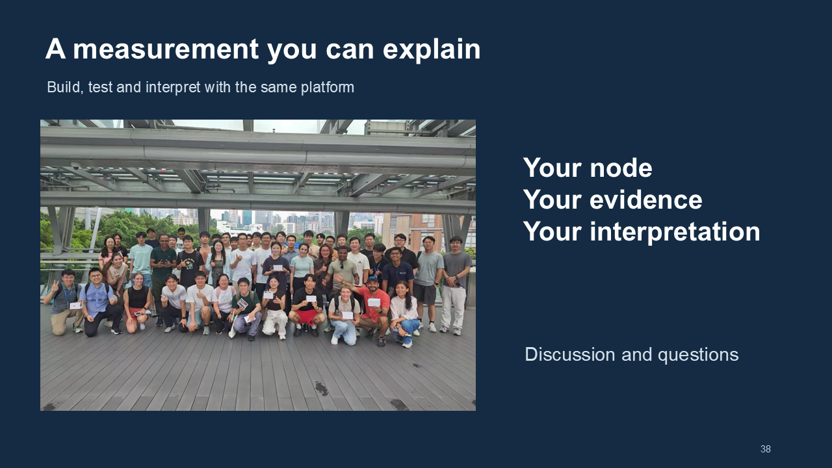
DEMO/.ppt-build/render/slide-38.png
