Shuaiwen-Cui/ArduinoNode/DEMO/.ppt-build/render/slide-39.png

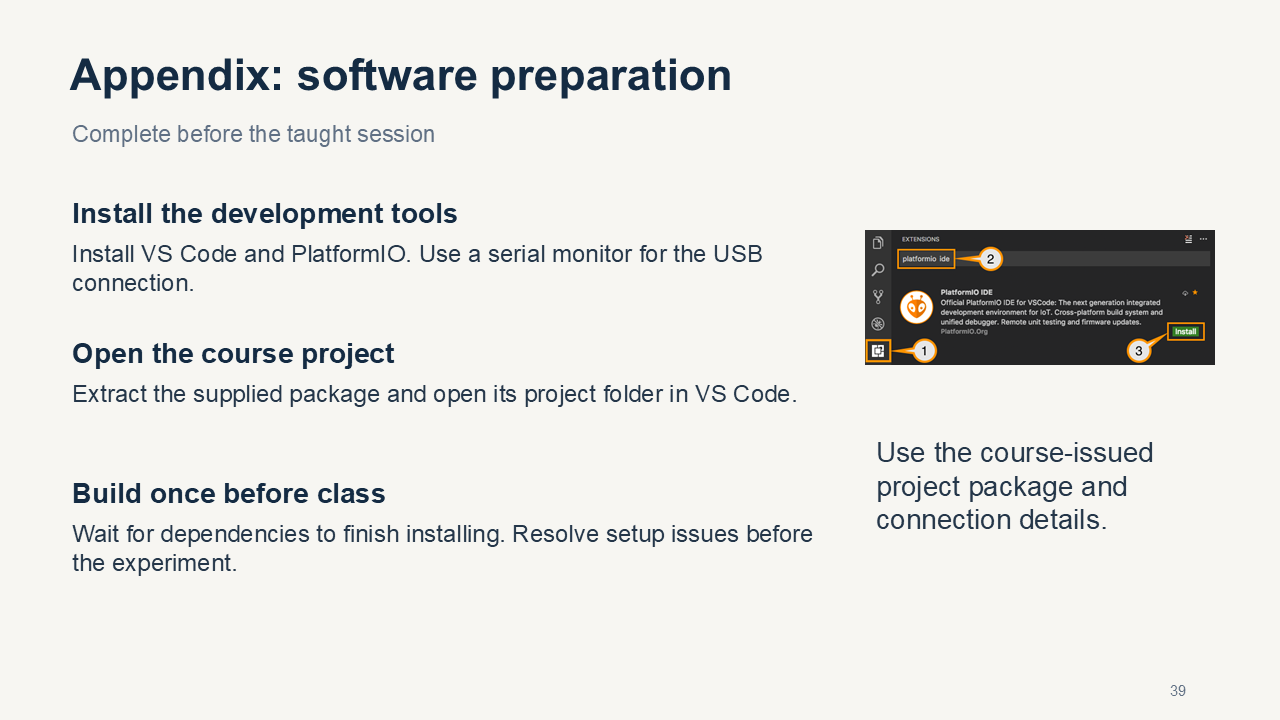
DEMO/.ppt-build/render/slide-39.png
