Shuaiwen-Cui/ArduinoNode/DEMO/.ppt-build/render/slide-40.png

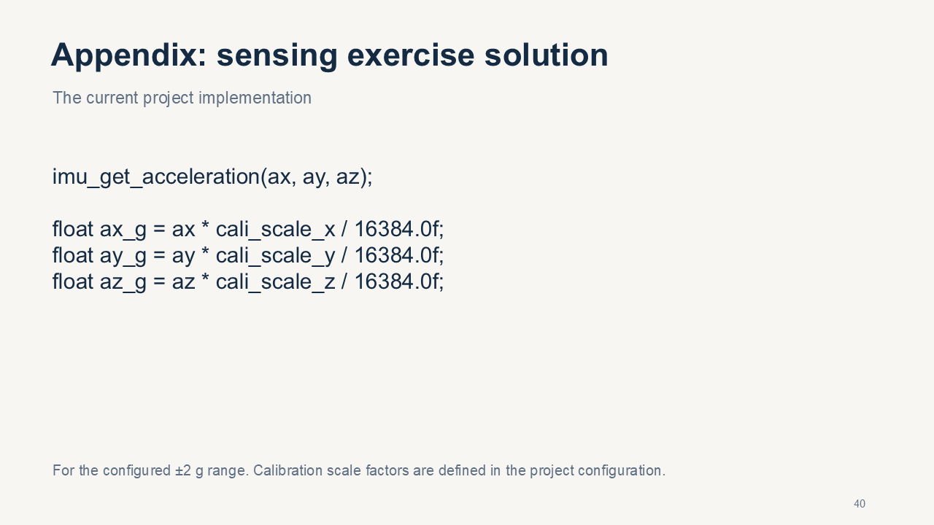
DEMO/.ppt-build/render/slide-40.png
