Shuaiwen-Cui/ArduinoNode/DEMO/.ppt-build/render/slide-41.png

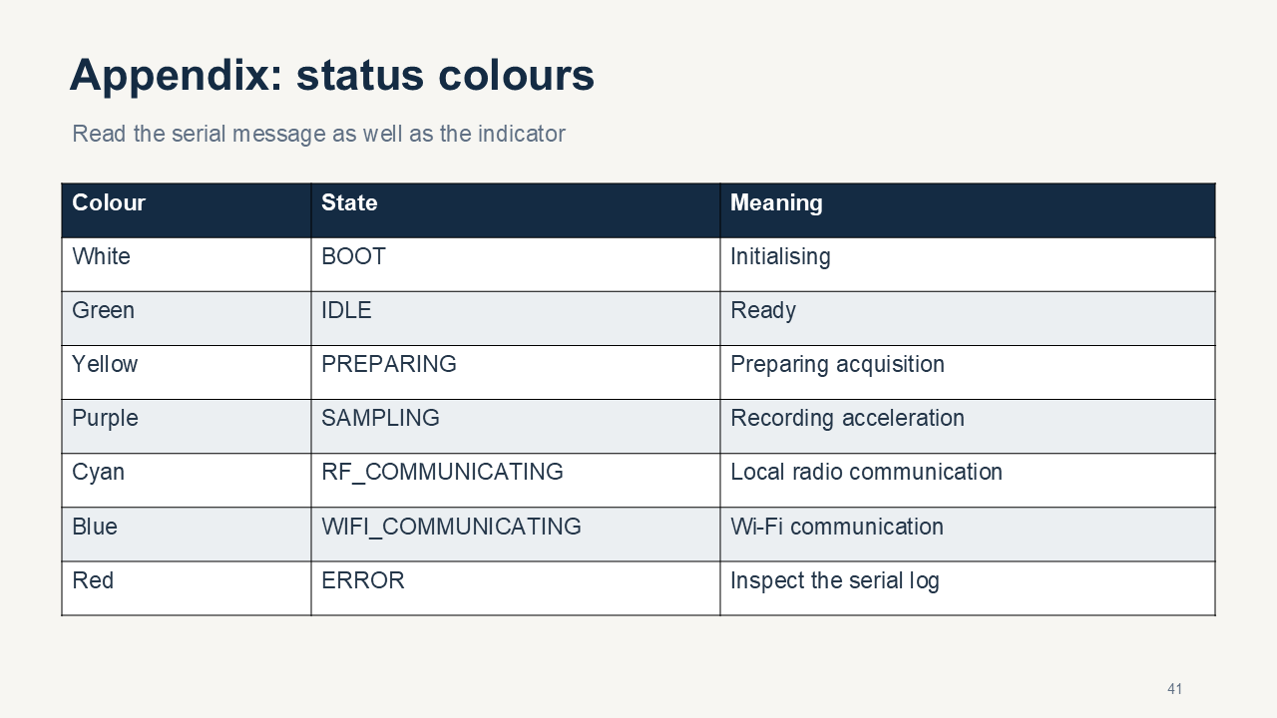
DEMO/.ppt-build/render/slide-41.png
