Shuaiwen-Cui/ArduinoNode/DEMO/.ppt-build/render/slide-42.png

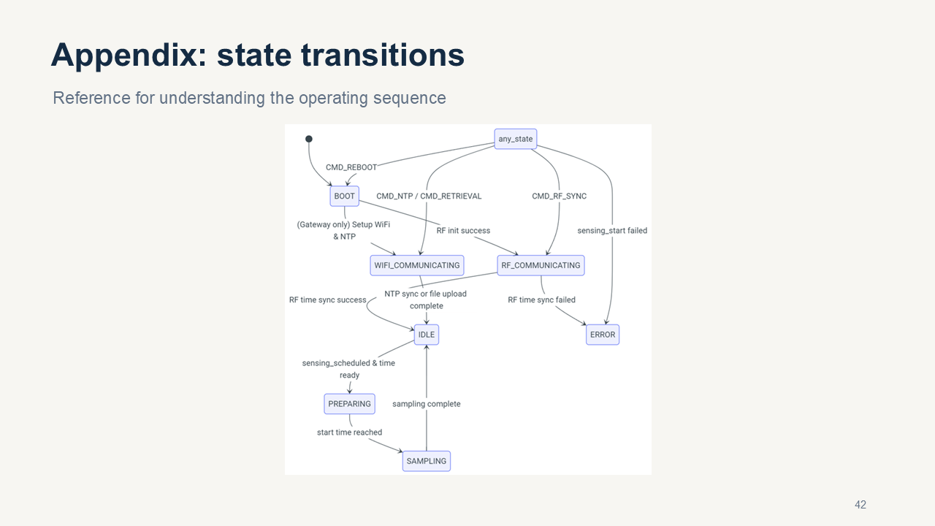
DEMO/.ppt-build/render/slide-42.png
