Shuaiwen-Cui/ArduinoNode/DEMO/.ppt-build/render/slide-43.png

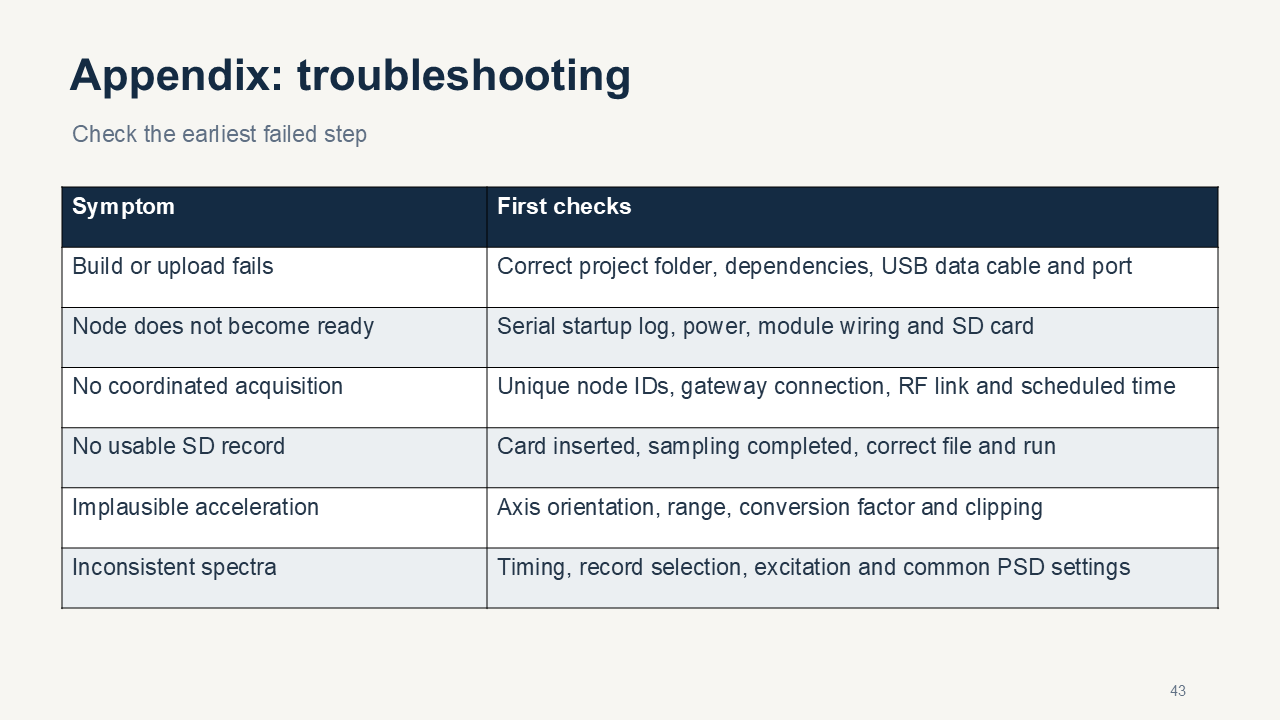
DEMO/.ppt-build/render/slide-43.png
