Shuaiwen-Cui/ArduinoNode/DEMO/.ppt-build/render/slide-44.png

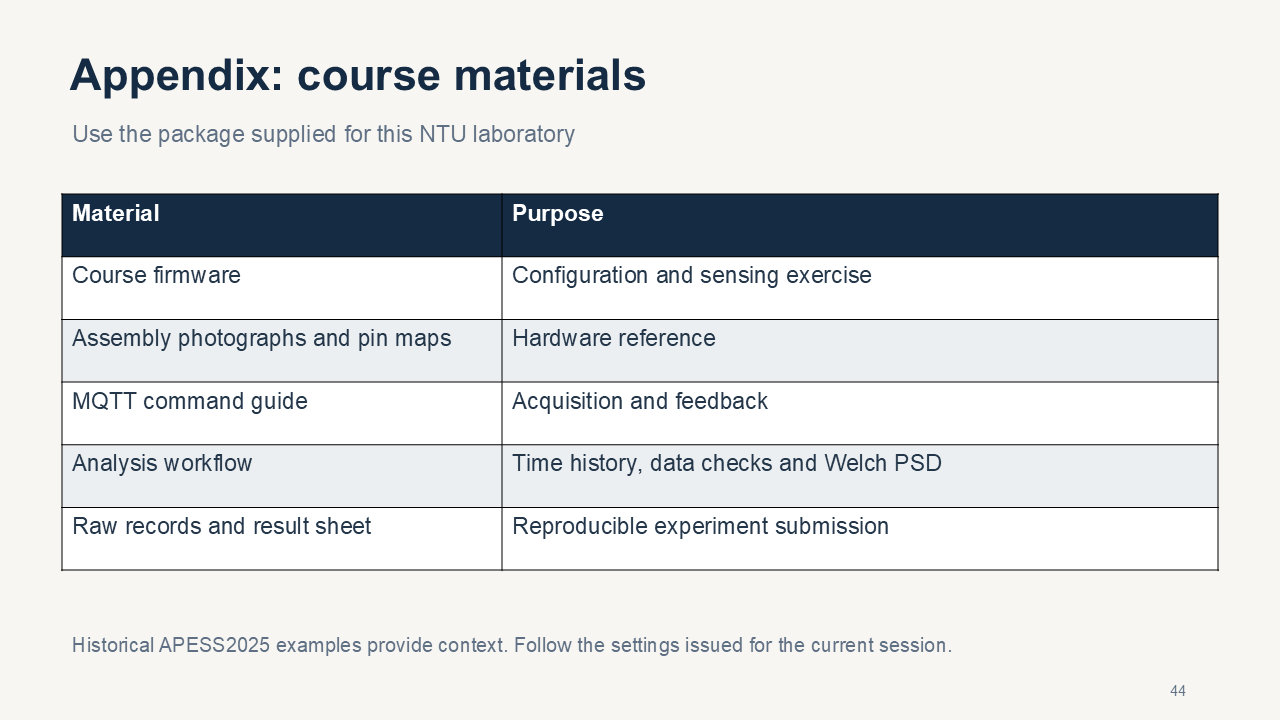
DEMO/.ppt-build/render/slide-44.png
