Shuaiwen-Cui/ArduinoNode/DOC/site/MANUAL/OPERATION/setup.png

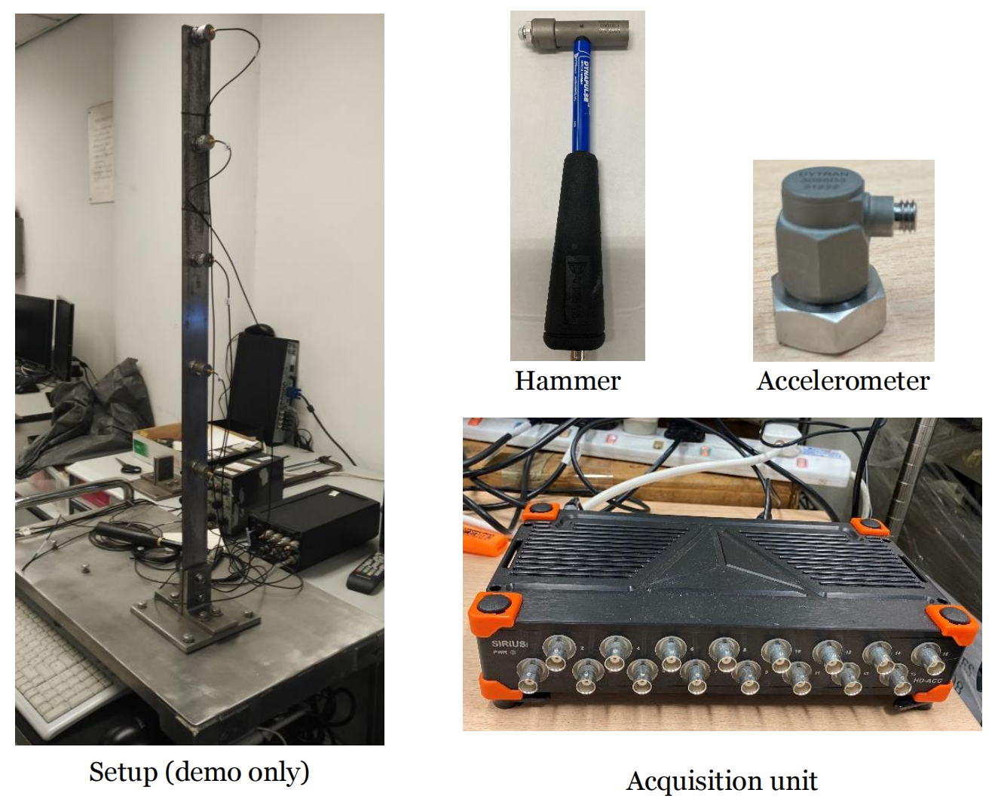
DOC/site/MANUAL/OPERATION/setup.png
