Shuaiwen-Cui/ArduinoNode/DOC/docs/DEMO/field-test1.en.md

# FIELD TEST 1

## The Footbridge over Nanyang Lake at Nanyang Technological University

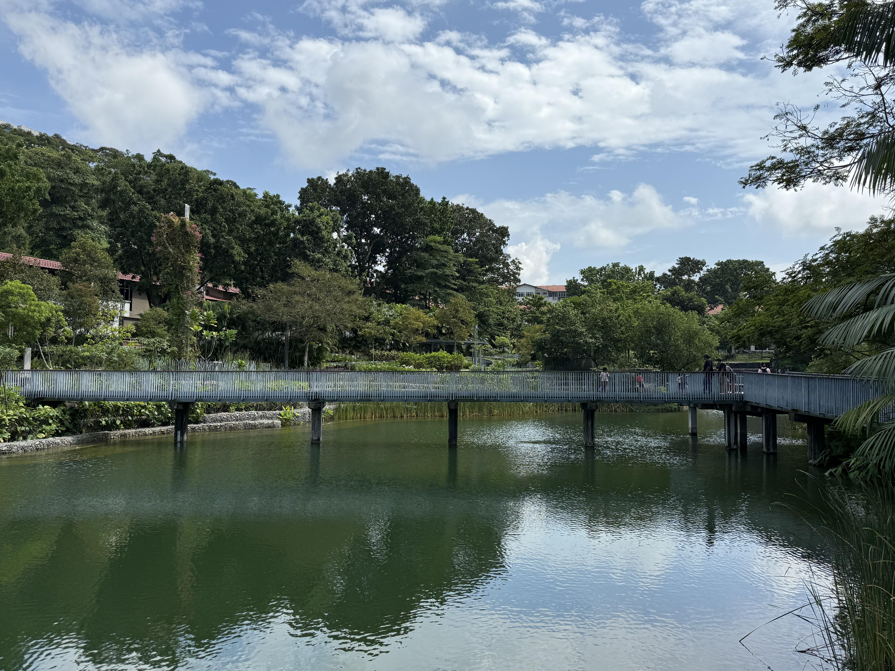
[picture p313: DOC/docs/DEMO/fieldtest1.jpg]


## WSN Setup

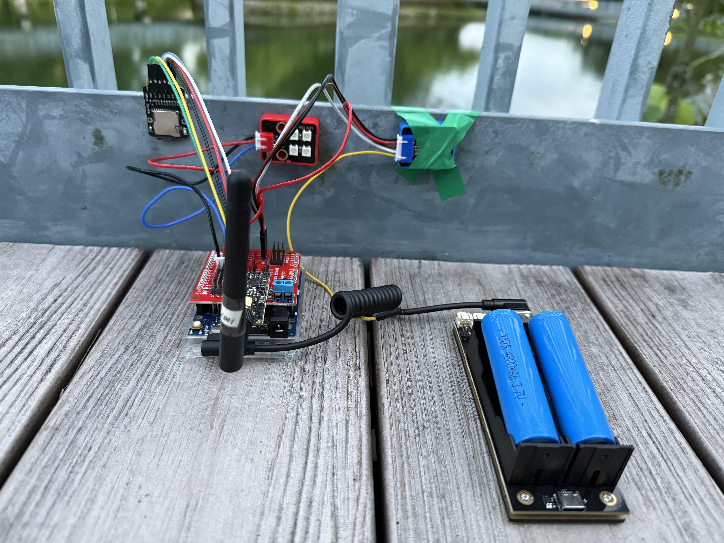
[picture p314: DOC/docs/DEMO/field1-setup.jpg]


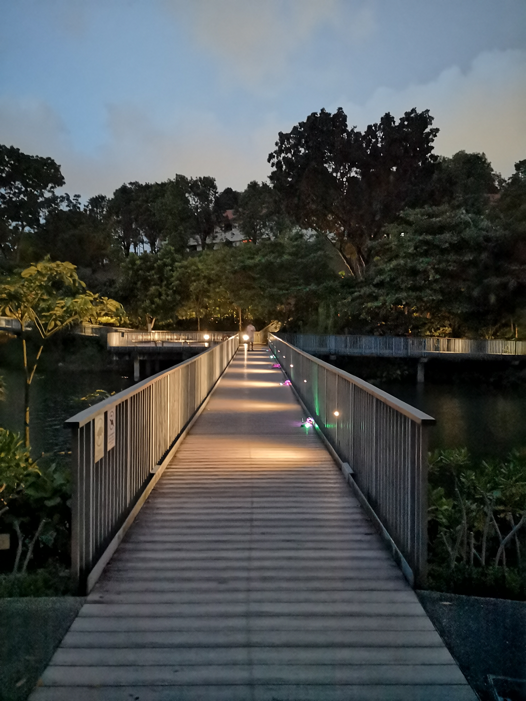
[picture p315: DOC/docs/DEMO/field1-sensorlayout.jpg]


## Sampling Setup

Excitation Method: Shaking the handrail by hand, lasting about 2-3 seconds each time.

Sampling Frequency: 200Hz

Sampling Duration: 300 seconds

## Data Analysis

### Time History

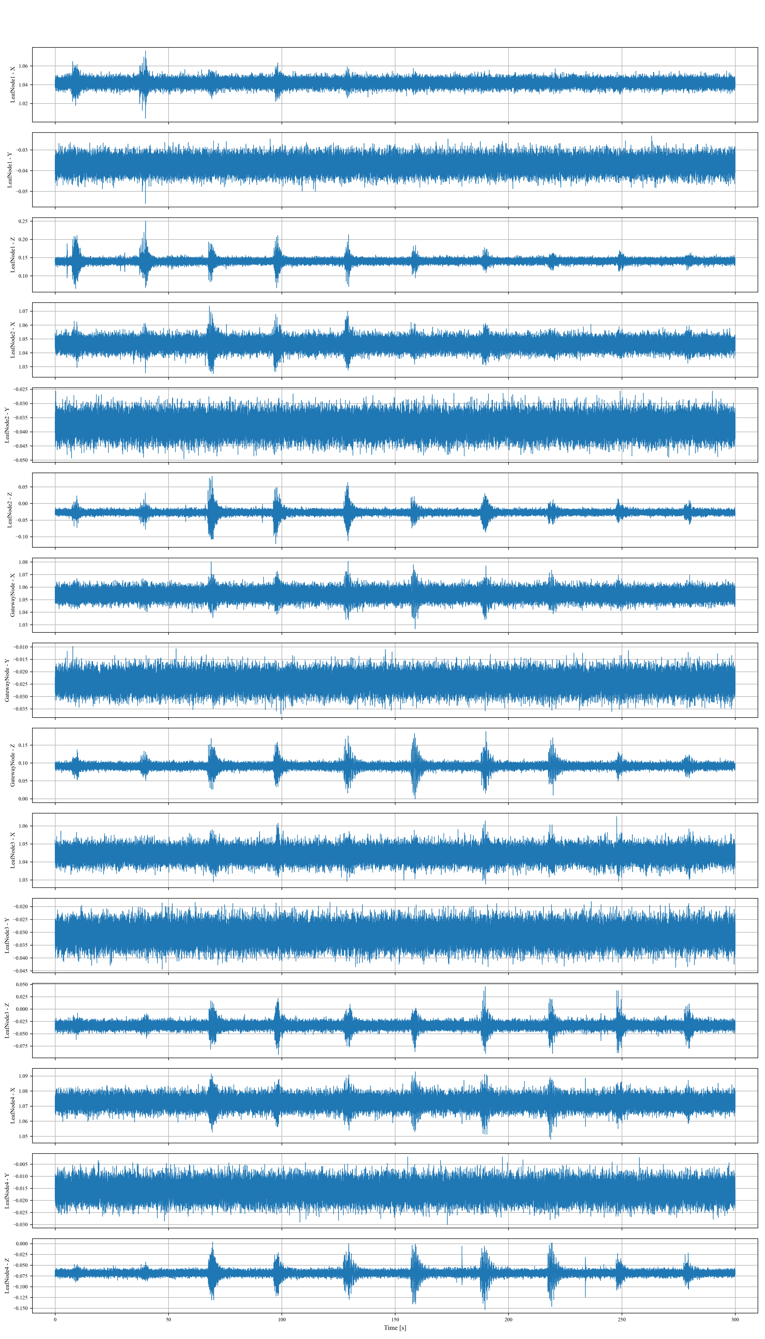
[picture p316: DOC/docs/DEMO/nanyanglake_shaking_timehist.png]


### Frequency Spectrum Analysis

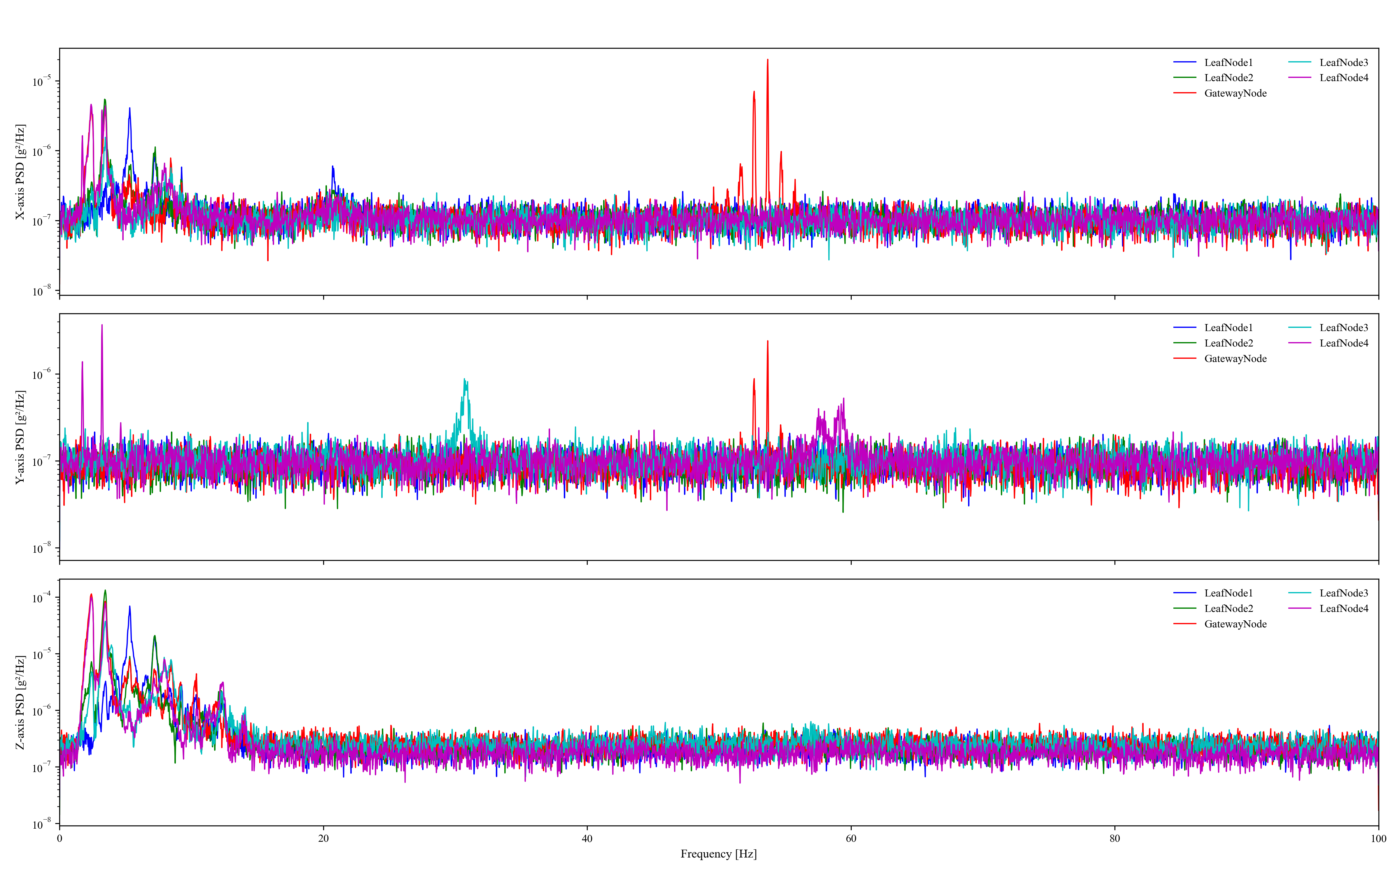
[picture p317: DOC/docs/DEMO/nanyanglake_shaking_psd.png]
