Shuaiwen-Cui/ArduinoNode/DOC/docs/DEMO/field-test1.zh.md

# 户外实验 1

## NTU Nanyang Lake 人行桥



## WSN 设置





## 采样设置

激励方式：手扶栏杆进行摇晃，每次持续约2-3秒

采样频率：200Hz

采样时间：300秒

## 数据分析

### 时程曲线



### 频谱分析
