Shuaiwen-Cui/ArduinoNode/DOC/docs/DEMO/field-test2.en.md

# FIELD TEST 2

## Footbridge over Highway

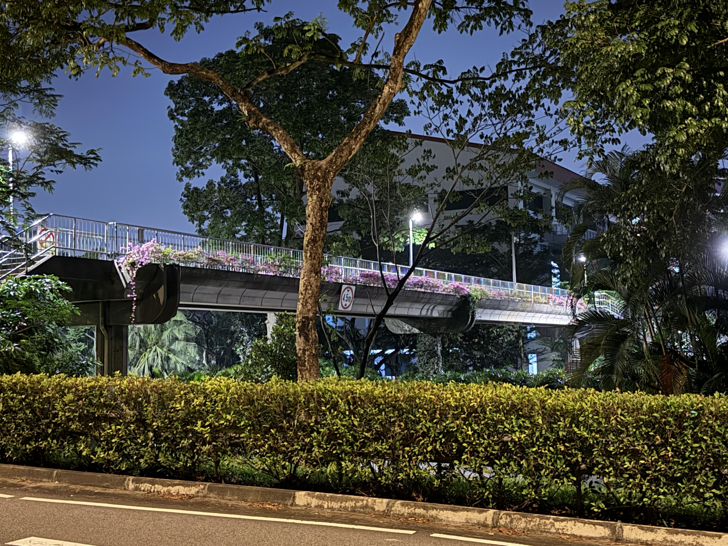
[picture p318: DOC/docs/DEMO/field2-piebridge.jpg]


## WSN Setup

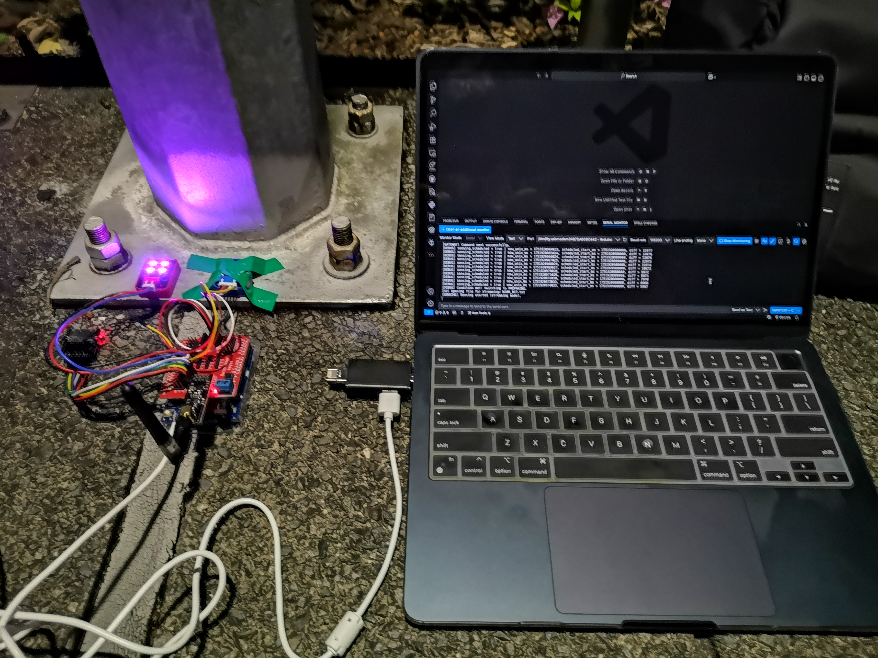
[picture p319: DOC/docs/DEMO/field2-sensor.jpg]


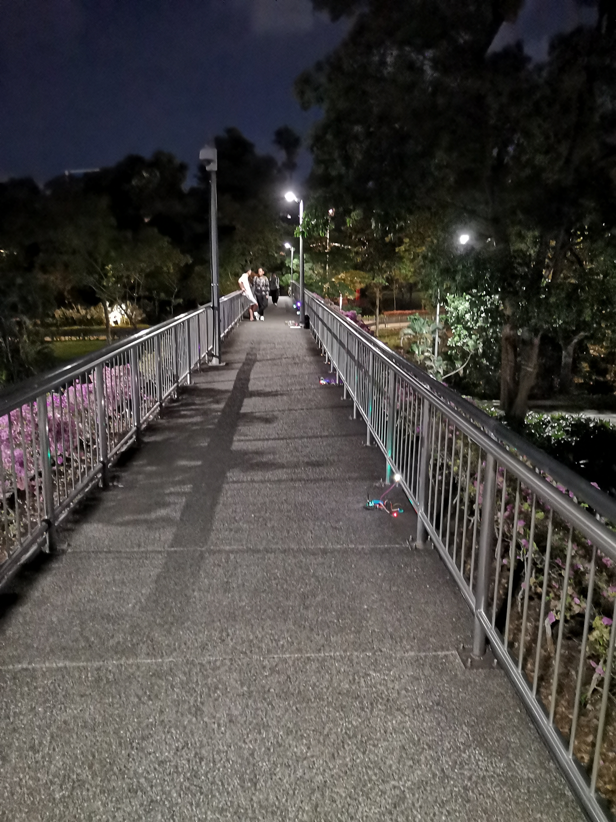
[picture p320: DOC/docs/DEMO/field2-layout.jpg]


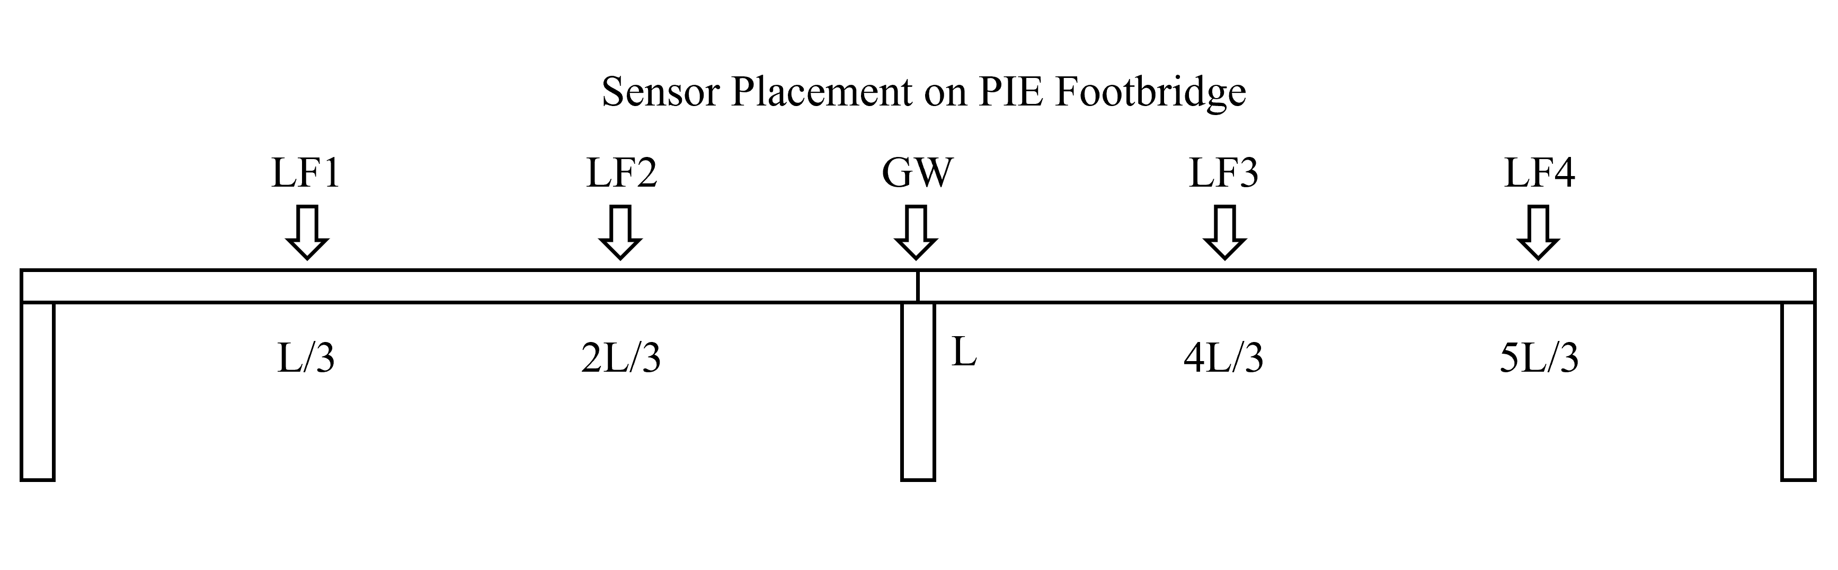
[picture p321: DOC/docs/DEMO/pie-placement.png]


## Sampling Setup

Excitation Method: No manual excitation, relying on vibrations from passing vehicles.

Sampling Frequency: 200Hz

Sampling Duration: 300 seconds

## Data Analysis

### Time History

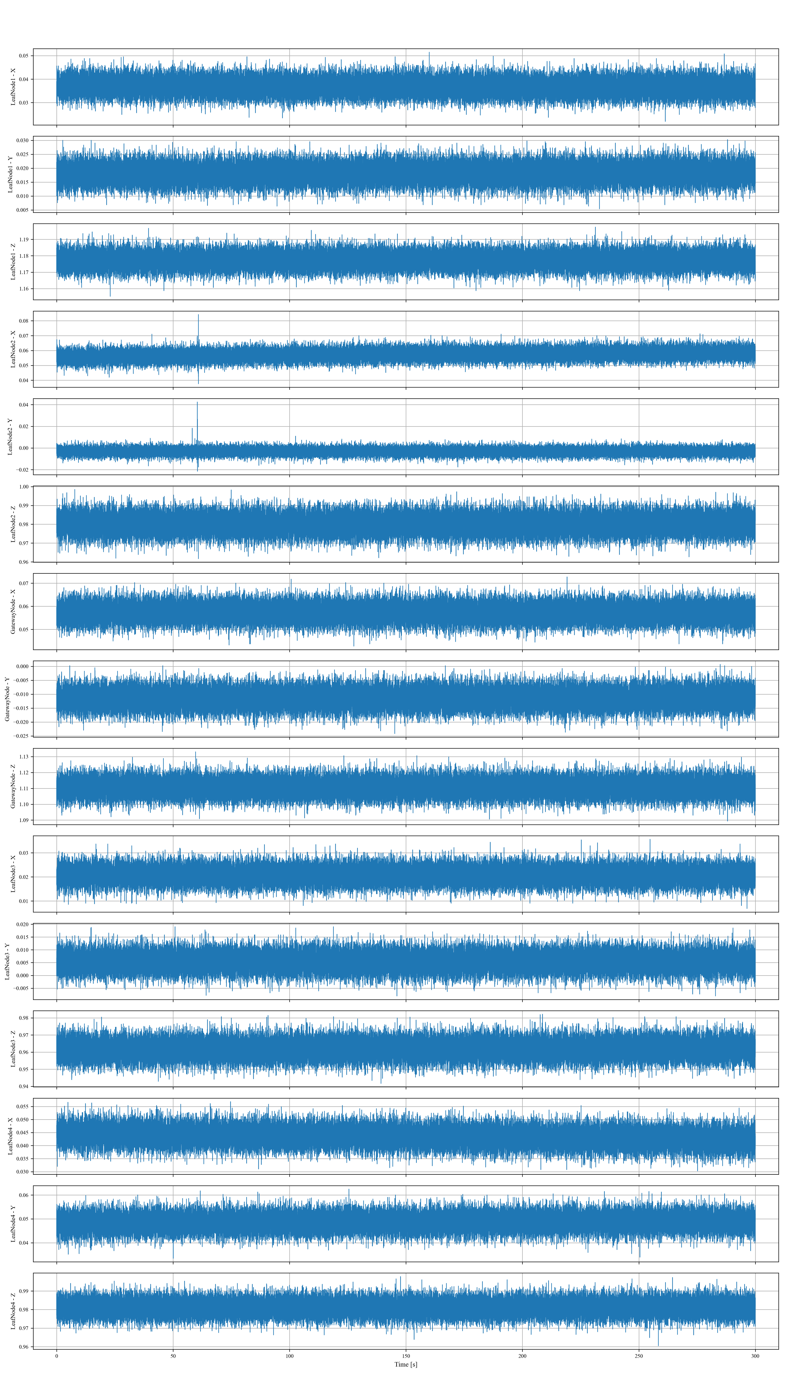
[picture p322: DOC/docs/DEMO/pie_r1_timehist.png]


### Frequency Spectrum Analysis

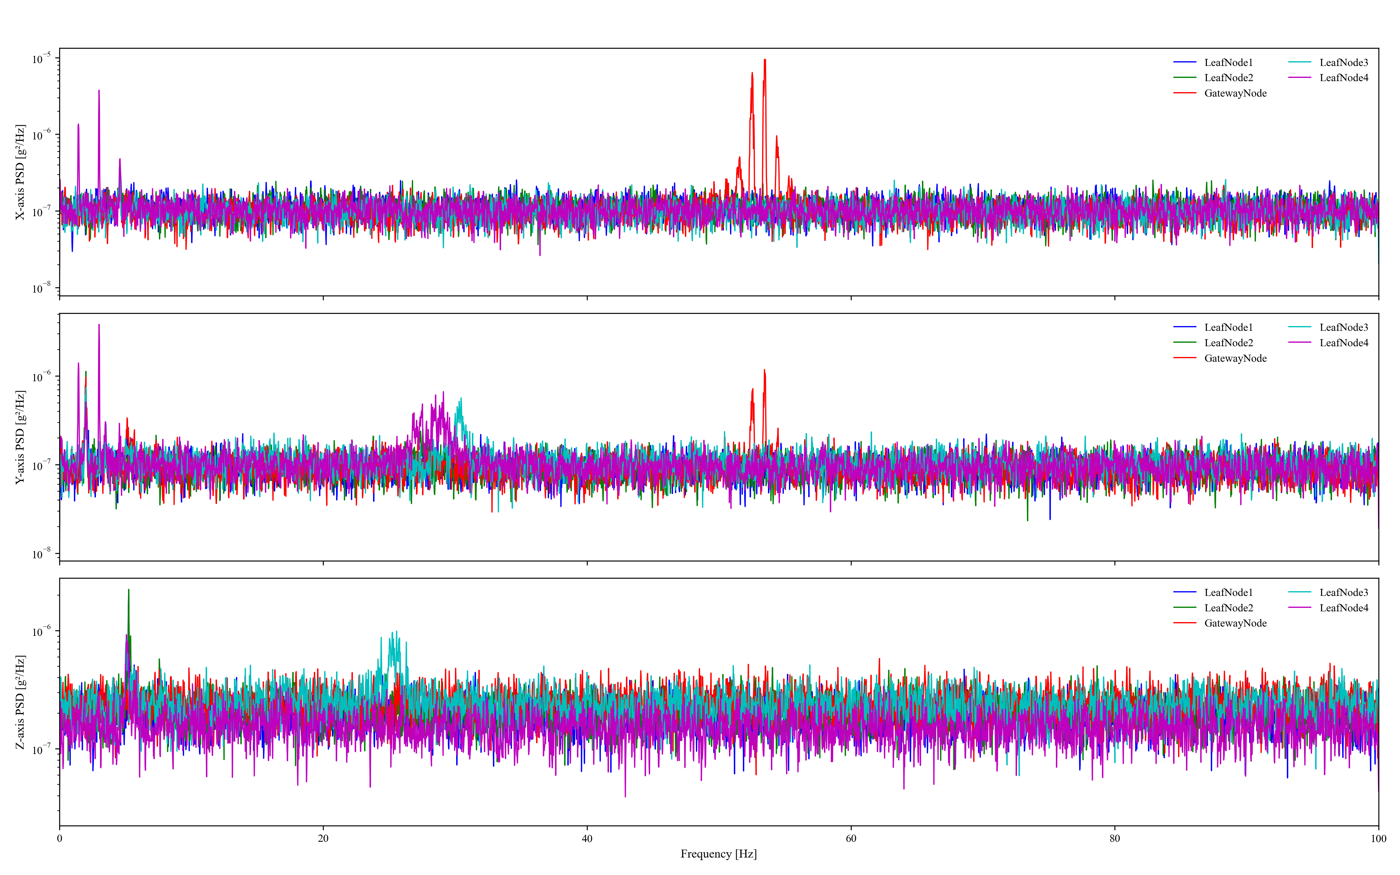
[picture p323: DOC/docs/DEMO/pie_r1_psd.png]
