Shuaiwen-Cui/ArduinoNode/DOC/docs/DEMO/field-test2.zh.md

# 户外实验 2

## 高速路上方人行桥



## WSN 设置







## 采样设置

激励方式：无人工激励，依靠车辆通过时的振动。

采样频率：200Hz

采样时间：300秒

## 数据分析

### 时程曲线



### 频谱分析
