Shuaiwen-Cui/ArduinoNode/(list of files, drawings)

Other design files:
BMS/3.7V 2S锂电池V2.2-18650/3.7V 2S锂电池V2.2-18650-封装.PcbDoc
Enclosure/REF/ABX00087-cad-files/Altium files/LEDMATRIX.SchDoc
Enclosure/REF/ABX00087-cad-files/Altium files/PCB.PcbDoc
Enclosure/REF/ABX00087-cad-files/Altium files/TOP.SchDoc
Enclosure/REF/ABX00087-cad-files/Altium files/UNO R4 WiFi.PrjPcb
