Shuaiwen-Cui/ArduinoNode/DOC/docs/MANUAL/ASSEMBLY/mpu6050-wiring.png

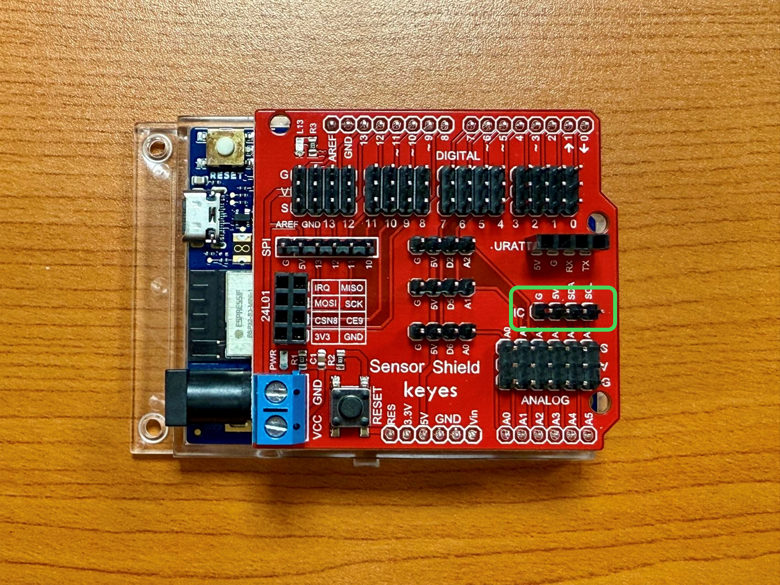
[picture p3: DOC/docs/MANUAL/ASSEMBLY/mpu6050-wiring.png]
DOC/docs/MANUAL/ASSEMBLY/mpu6050-wiring.png
