Shuaiwen-Cui/ArduinoNode/DOC/docs/MANUAL/ASSEMBLY/RF-wiring.png

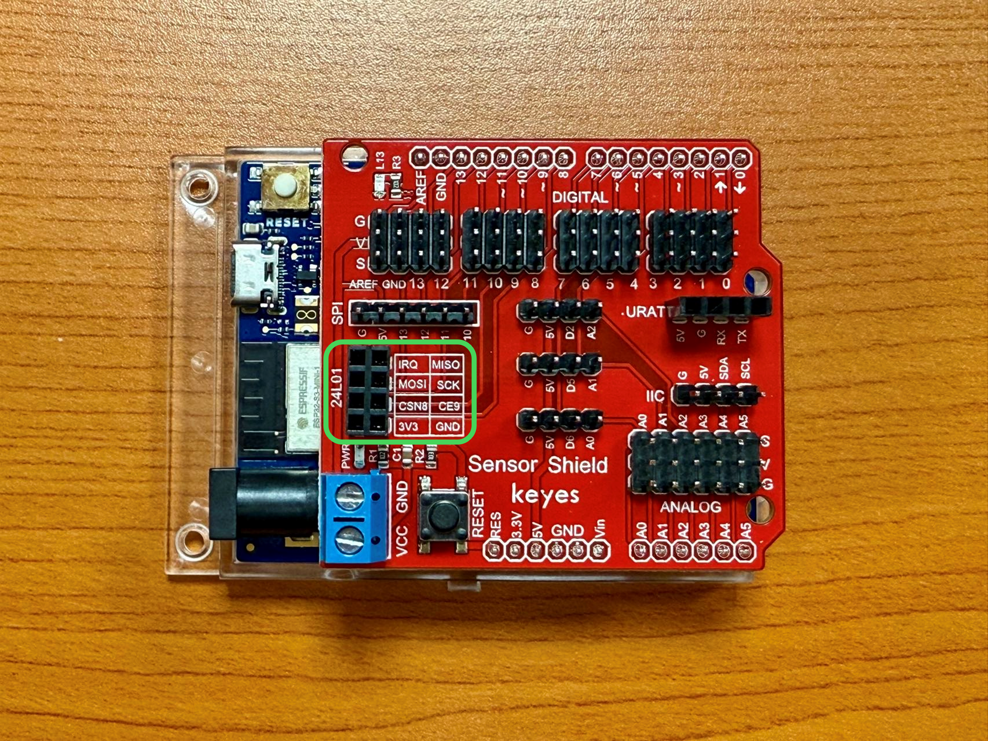
[picture p11: DOC/docs/MANUAL/ASSEMBLY/RF-wiring.png]
DOC/docs/MANUAL/ASSEMBLY/RF-wiring.png
