Shuaiwen-Cui/ArduinoNode/DOC/docs/MANUAL/ASSEMBLY/rgbled-wiring.png

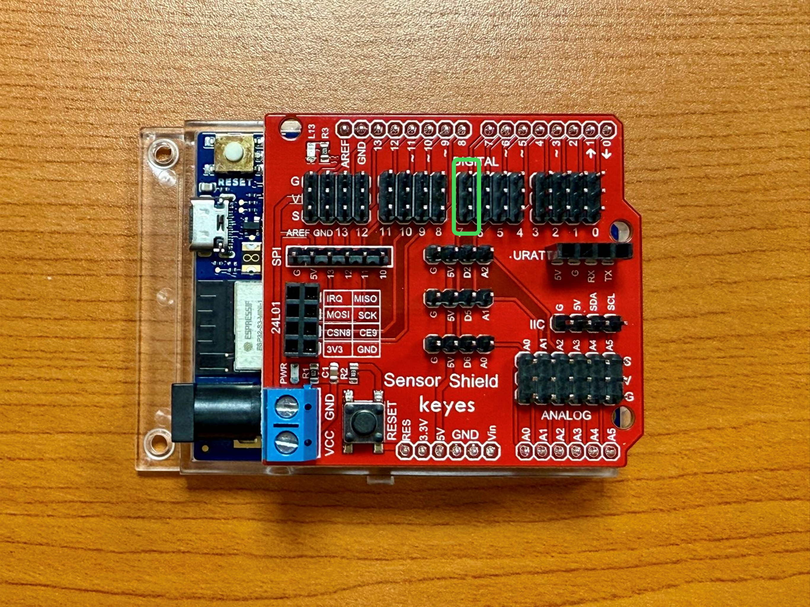
[picture p13: DOC/docs/MANUAL/ASSEMBLY/rgbled-wiring.png]
DOC/docs/MANUAL/ASSEMBLY/rgbled-wiring.png
