Shuaiwen-Cui/ArduinoNode/DOC/docs/MANUAL/ASSEMBLY/sdcard-wiring.png

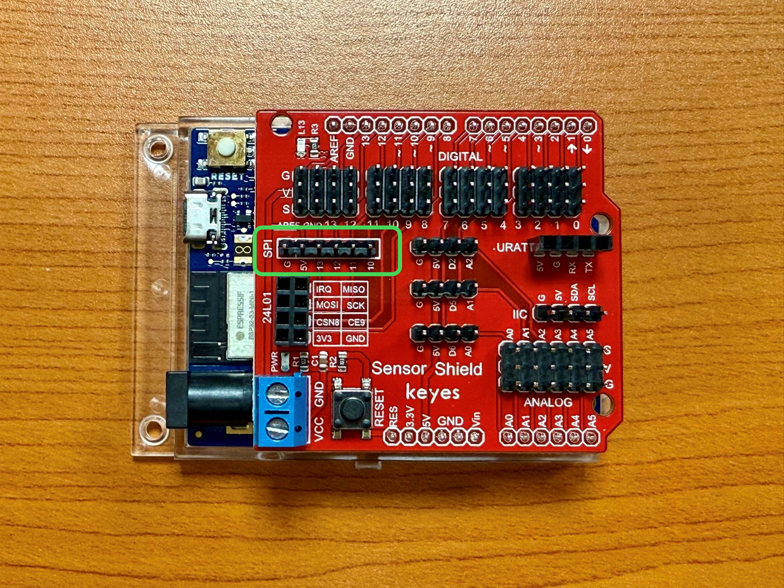
[picture p17: DOC/docs/MANUAL/ASSEMBLY/sdcard-wiring.png]
DOC/docs/MANUAL/ASSEMBLY/sdcard-wiring.png
