Shuaiwen-Cui/ArduinoNode/DOC/docs/DATASHEET/WSN.jpg

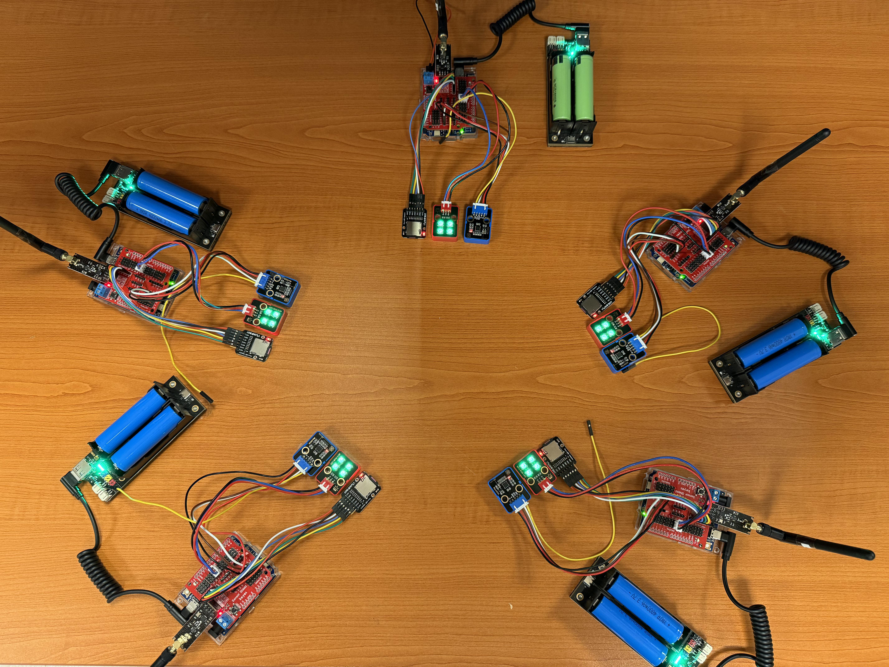
[picture p21: DOC/docs/DATASHEET/WSN.jpg]
DOC/docs/DATASHEET/WSN.jpg
